GarethCooke/SiglentTower/ROADMAP.md

# Bench stack — build roadmap (v2.39, 2026-11-09)

Companion to `HANDOVER.md` (v19, the as-built record). Rule for the whole build: **nothing in HANDOVER §10 prints full-size until the coupon that gates it (§11, P1–P9) has passed.** Coupon numbers below are the handover's.

Stages run in order. Stage 2 (frame) overlaps Stage 1 (coupons) because the coupons only need rail offcuts.

v2: decisions D1–D6 answered (§0), cut plan redone for the 300 mm pack (§2), P7 redefined (§3), viewer v19 and `drawer-quarters-v1.pdf` issued. v2.1: D7 (mini slot 285 with vent channel), viewer v20. v2.2: Done columns and the progress checklist below; viewer versions collapsed into `bench-stack-3d.html`. v2.3: D5 confirmed, pack ordered, `fit.py` and the P7 coupon issued; sheet v1.1 (tabs start 25 from the wall, not 15 — 15 fouled the wall-crossing boss). v2.4: D4 confirmed — §0 closed. v2.5: AWG cradles printed, P1 ABS+ confirm coupon and the 210 foot exported. v2.6: P1 ☑ (ABS+), sled beams v1 modelled. v2.7: scope feet positioned by the P9 jigs, beams released. v2.8: sled slides proven in ABS+, tiles and hinge passed on the yellow run, strip bracket lower v2. v2.9: strip raised to z 75–425 round its mains cable; lower bracket v4 fits, upper stays v1. v2.10: P5 ☑, Stage 0 ☑, Stage 2 assembly viewer + connector plan, session handover. v2.11: bottom-drawer quarters production pass released (`parts/drawer/`), one quarter per plate; sled front bar + cross bars released after the scope leaned the bare beams inwards. v2.12: quarters Q1–Q4 printed; bottom-drawer runners v1 released (four M5, one part for both sides, one per plate). v2.13: sled front bar v2/v3 + beam front halves v2 (saddles, tongue), drawer facia v1 + pull insert. v2.14: P3 ☑ (drawer slides well), frame checks 2.1–2.6 ☑. v2.15: 2.7 ☑ → Stage 2 ☑; PSU/AWG seated — three cradle clashes confirmed, PSU right cradles v4 + AWG cradles v2 released; facia v1 printed (thin-part print rule). v2.16: the TPU plate (Stage 8 / P8) released — every TPU part on one plate with the two sweeps; sill panel printed. v2.17: top panel v1 released (D12) — four tiles standing on ONE plate with the four upright caps, glued half-laps, no spline; sill v3 printed. v2.18: the rails measured — side tiles v2 at the measured band heights with notches for the cradle saddle walls (ten tiles, five plates); top panel at the measured 362. v2.19: Progress block rewritten so every open stage lists what is outstanding (bench round-up 2026-10-16: Stage 3 ☑; P8 ☑ — the TPU plate printed, the 4.6 feet and 7.4 covers hold — so Stage 1 ☑; sled sag ☑; every drawer comes out cleanly ☑, so Stage 4's "lift-to-remove" is retired — it was HANDOVER's lift-off runners, and P3's rib-in-groove pair cannot lift). v2.20: D14 — the six drawer housing-top tiles are dropped from the build (Gareth, 2026-10-16: nearly every drawer in the world has no top; add later if use shows the need). v2.21: D15 — no drawer stops either; the bottom and column drawers pull clean off their ribs at full travel, which is also how they come out. v2.22: D10 rev 3 — the lighting wiring drawn (`parts/wiring/`), the controller is a Wemos D1 mini on a perfboard in a holder on the rear base rail's rear face, two WLED buses, cover run B moves to that rail's REAR slot. v2.23: print round-up 2026-10-18 — side tiles v2 (A2–E2), the top panel plate, box braces, mini-slot runner v3 + facia, pull-inserts plate v3 and sill blocks v4 all printed; the mini runner is v3 (countersink sunk 1.0 below the plate top), which the text called v2. v2.24: the door set released (`parts/door/`) — door, fixed rear tile with a bolted leg, two magnet holders; band 4 left gets the same leg. v2.25: band 4 left released (`tile-band4-LF/LR-v1`, legs on the uprights); the door set, holder and second hinge pair printed. v2.26: band 4 left printed; the sled cable channel released (`cable-channel-v1`) — every tile and every sled part now exists. v2.27: the door set's rear tile, front bracket and tab were exported from the mirrored check frame and printed as the wrong hand (Gareth, 2026-10-19) — v2 of the three re-issued from the real frame; door-v1 as printed is fine. v2.28: the door's edge comes down from 347 to 338 — door v3 + hinge leaves v2 (both), pins issued, the hinge explained on `hinge-how.png`. v2.29: sill left block v5 — the pixels push in from the REAR, pre-wired and removable; v6 the same day: bore 5.7, flange seat 4 deep (v5's 5.3 bore printed tight); v7: seat 6 deep, leg slots, and a dovetail wire groove along the block's bottom — wrong face (Gareth: the wires leave through the back, the top of the print); v8 put two clip rails on the back face instead; v9 misread that as the pixels; v10 (Gareth: it is the BUTTON's wires that will not go through the front hole) keeps v8 and adds a 3.2 wire slit from the button bore to the bottom face, front to back, with the same notch filed into the printed window (window-v4 STL kept for any reprint), so the pre-wired button goes in from the front with its wires hanging through the slit. v2.35 (2026-11-03): **construction complete** — Stage 8 ☑, the lighting wired and working; only Stage 9 (close-out) is left. v2.36 (2026-11-03): **HANDOVER v19 issued** — the as-built record (Stage 9 bullet 1 ☑); the 2026-10-23 ticks (Stages 4–7, D12, the D7 thermal check — commit a423915) that the 2026-10-27 sill edit overwrote are restored below. v2.37 (2026-11-05): **viewer and layout regenerated as built** (Stage 9 bullet 2 ☑) — `bench-stack-3d.html` to HANDOVER v19 §3 (sub-frame 253.7 flush, sill panel to 253.4, door v3 on the D11 axis, top panel D12 with the caps on it, lids and probe hanger gone, strip 75–425, board enclosure, splices, rests, travel 92; `viewer_boxes.json` was stale at v18 and is now the HTML's list), `bench-stack-layout-v16.pdf/.svg` the as-built sheet (v15 removed from the tree); **STL archive tidied** (Stage 9 bullet 3 ☑) — the 18 superseded STLs HANDOVER §10 marked † removed from `parts/` (git history keeps them), `rear-tile-v2.3mf` moved to `bambu/parts/door/`; **the complete .3mf generated** (Stage 9 bullet 4 ☑ pending a Bambu Studio check) — `src/publish_3mf.py` writes `publish/SiglentTower-complete.3mf` (36 plates in filament order, one material per plate, jigs last, each object named after its STL, per-object brims / ironing / supports, the `SiglentTower fit 0.20` profile lifted from a saved project), `publish/PLATES.md` and `publish/plates-sheet.png`; `sill-panel-window-v4.stl` restored to `parts/sill/` from git history (a complete build needs it). v2.38 (2026-11-08): **the build guide** and, later the same day, the MakerWorld listing published and the write-up drafted (`docs/WRITE-UP.md`). v2.39 (2026-11-09): **Stage 9 ☑ — the write-up is live at garethcooke.com/siglenttower/build; nothing is left open.** (Stage 9 bullet 6 ☑) — `docs/BUILD-GUIDE.md`, chapters 0–14 from HANDOVER v19, every build step a numbered action with its check, three new sheets under `docs/build-guide/` from `src/build_guide_sheets.py`; README map and MAKERWORLD.md links point at it. — tick ☐ → ☑ as things pass.

## Progress

Ticks follow the rule at the end of §2: a stage ticks only when its "Done when" line is met and every row in its table is ☑. Each open stage lists what is still outstanding, so this block is the to-do list, not just the record.

- [x] §0 decisions D1–D12 all ☑ (D12 top panel ☑ 2026-10-23: on the frame; D13 withdrawn; D14 ☑ 2026-10-16: no drawer lids; D15 ☑ 2026-10-16: no drawer stops)
- [x] Stage 0 — coupons modelled and sliced, spacer set printed (0.5 was already fixed in layout v15)
- [x] Stage 1 — extrusion cut ☑ (2026-09-19); P1–P9 all ☑ in §3, values in `fit.py`. **P8 ☑ 2026-10-16:** the TPU plate printed; the four feet (peg 4.6) push into the uprights' bores and hold — Gareth glued them in — and the 7.4 covers stay in the slots by thumb → `SPIGOT_D` 4.6, cover flare 7.4 stand; the sweeps were not needed.
- [x] Stage 2 — frame assembled, sled feet on the scope rails, instruments trial-fitted (2.1–2.6 ☑ 2026-10-01: diagonals, 321 front, 510, no wobble; 2.7 ☑ 2026-10-02: PSU and AWG seated with the jigs, no rock, fronts in line — the three cradle clashes are Stage 3's)
- [x] Stage 3 — cradles: PSU left v3 + right rear v4 + right front v5, AWG v2 fitted; **confirmed done 2026-10-16** (level, no rock, fronts in line; the slight PSU skew noted in `fit.py` accepted).
- [x] Stage 4 — drawers. **☑ 2026-10-23 (tower assembled):** runners, quarters, column drawer + strips, mini slot (runner v3 + facia), all three facias with the pull inserts v2 glued in, fronts flush with the uprights, logo reads; each drawer comes out cleanly (2026-10-16). **D7 thermal check ☑ 2026-10-23:** all three instruments on for over an hour in the assembled stack, slot in, tiles on — the AWG's fan no louder than usual, the mini slot's right-hand wall (in the fan's exhaust) slightly warm, not hot → the slot stays 285, the 85 fallback is not needed. Housing tops dropped — **D14 2026-10-16** (the constraints recorded for them stay in the status lines in case they are ever added: pull-insert ears frame x 120–240 and its pocket y ≤ 22 over x 130–230, z 63–86; mini insert notch x 242–268, y ≤ 22, z 313–336; the D7 vent-channel notch x 252–338 over y 81–171; the right sled rest's lip → top stops at x ≤ 337.5); stops dropped (D15).
- [x] Stage 5 — sled. **☑ 2026-10-23:** feet, beams, front bar v3, cross bars v2, front rests v2, splices v2, cable channel v1 on the left beam, TPU stop caps, bar pull liner; the scope pulls out to the stop caps and back, stays level, stops hold; sag ☑ 2026-10-16.
- [x] Stage 6 — box + channel. **☑ 2026-10-23:** box halves joined, corner braces in, cable channel on; the full access sequence works — sled out, door open, box lifted over the right splice, out to the right and back; the meters fit.
- [x] Stage 7 — skin. **☑ 2026-10-23:** side tiles v2 (band 2 right v1), band 4 left v1, the door set (door v3, hinge leaves v2, pins, rear tile / bracket / tab v2) — the door swings past 180 clear and catches; top panel on with the four caps → D12 ☑.
- [x] Stage 8 — trim. **☑ 2026-11-03 — the build is complete and the lighting works.** Done: the TPU session (feet glued in, AWG pads, stop caps, six 240 covers); strip brackets (upper v2 / lower v5 — every earlier export had no bolt hole; the printed pair drilled 5.5 + Ø10 × 2.5 counterbore) with the Addtam hung; sill panel v3 + window v4, left block v10, right block v4; upright caps on with the top panel; IEC leads routed, the scope loop takes the 100 travel; **lighting per D10 rev 5** — SiglentGlow firmware (`C:\Development\Projects\SiglentGlow`, built 2026-10-25) on a XIAO ESP32-S3 Plus, the 50 × 70 perfboard (74AHCT125, SR3200, 1000 µF, 2 × 330 Ω; plugs 5-pin sill, 3-pin L and R, 2-pin PWR, crimped 2.54 mm locking housings) in `board-enclosure-v1` + `board-lid-v1` on the rear base rail, two 15-LED strips on the rear uprights' inner faces, two WS2812D-F5 sill pixels + the button in the left block (the F5's legs run DOUT, VDD, GND, DIN — the reverse of the APA106), USB pigtail from the Addtam (red + braid). Sheets: `parts/wiring/wiring-4-connections.png`, `wiring-2-runs.png`, `perfboard-layout.png`, `board-enclosure-plan.png`. Not built, by choice: the probe hanger and the rear-right cable clips — add later only if use asks for them.
- [x] Stage 9 — close-out **☑ 2026-11-09 — the project is complete.** HANDOVER v19 ☑, viewer/layout regenerated ☑, STLs archived ☑, the complete .3mf ☑, the MakerWorld pack ☑ (published 2026-11-08), the build guide ☑ 2026-11-08, the write-up ☑ 2026-11-09 (garethcooke.com/siglenttower/build).

**Print job 2026-10-27 — sill left block v10: `parts/sill/sill-block-left-v10.stl`** (white or any PETG, front face down as exported, no brim, no support, 5.7 cm³, 47.7 × 12 × 22 on the bed; v4–v9 left blocks withdrawn). **The printed panel + v3 window are NOT reprinted** (Gareth, 17:13): the window gets its notch by hand — with the panel off the frame, file or cut a **3.2 wide × 1.8 tall notch** through the clear window from the bottom edge up into the Ø8.4 hole, centred under the hole (1.6 either side of its centre line), straight through the 3 mm; a flat needle file or a craft knife does it in clear PETG. `sill-panel-window-v4.stl` is that shape, kept only for the day the panel is ever reprinted. Right block v4 unchanged. **v10 (Gareth, 17:03: it is the BUTTON's wires — "I can't push them in from the front because they won't fit. There needs to be a small gap at the bottom as you look at it from the front when it is mounted"):** v9 was a misreading (it moved the pixels, which were never the problem) and is withdrawn; v10 is v8 — pixels pushed in from the rear, clip rails on the back face for their wires — plus a **wire slit 3.2 wide** (x 43.4–46.6) from the block's bottom face up to the button's axis, running from the front face right through to the back, and the **same 3.2 notch in the window's bottom edge** under its Ø8.4 hole (1.8 tall) — filed into the printed window, see above. Fitting the button: wires soldered to it first; offer it to the window from the front with the four wires hanging down through the notch; push it in — the wires trail rearward along the open-bottom slit — and when the thread meets the captive nut the tail is over the wire channel (y 13.5–19.5), where the wires drop out of the bottom; screw it home. Out is the reverse. The nut stays captive (the slit takes 3.2 of its pocket's 10.6 floor; a 10 AF nut pulled down 0.5 still collides). From the front the notch shows as a 3.2 × ~1 mm nick in the clear window below the bezel, 1 mm above the facia. **Proven:** a 2.4 × 2.4 bundle (four Ø1.2 wires) along the whole slit vs window, block and panel 0; where it passes the nut it dips under the nut's bottom flat (z 88) in the open below the block — vs nut, block and facia 0; v8's clip-rail proofs unchanged. Print: the slit is a channel along the print's z with vertical walls; the window's notch is a 3.2 mm bridge 1.8 above the bed — no support either way. **v9 (superseded the same day):** pixels fitted from underneath with a slide-forward seating — withdrawn, wrong problem. **v8 (superseded the same day):** two clip rails on the back face for rear-inserted pixels — right face for the wires as the block then was, wrong because the pixels could not be fitted from the back once wired. **v7 (superseded the same day; Gareth: push the LED further through, and clips on the left to tuck the wires under):** the flange seat goes to **6 deep** — the dome now stands 4.1 into the cavity, 1.9 short of the window; under each LED a **leg slot** (6.6 wide, y 14.5–19.5, open to the block's bottom up to z 93) opens the rear of its counterbore downward so the four legs bend straight down out of the flange; and a **wire groove along the block's bottom face**, x 27–61, 4.5 wide inside (y 14.5–19) × 3 deep with a 2.5 mm dovetail mouth between two 1 mm lips — the bundle (two pixels' legs, the button's wires out of its channel, which the groove crosses) pushes up through the mouth and the lips hold it; it leaves the groove at the left end and drops down the front-left upright's inner-face slot to the rail. That is the "clips" ask done as a groove, because a hook hanging off the bottom face is an overhang in the front-face-down print and a groove is a 2.2 mm bridge. Proven: a 3.9 × 1.8 bundle sits in the groove at 0 and collides with the lips when pulled 1 toward the mouth; the legs' path from the flange to the groove is clear; the groove clears the bolt pocket (y ≤ 13.6 at that height) and the key hole (y ≤ 11.8); the Ø5.3 body still passes the bore. **v6 (same day, bench): v5's LED would not push all the way in** — a Ø5.3 vertical bore prints ~0.3 under (`fit.HOLE_SHRINK`) against a Ø5.0 LED body, and its 2.5 flange seat left the dome only 0.6 into the cavity. v6: bore **Ø5.7**, flange seat **Ø6.6 × 4.0** → a Ø5.3 body passes even with the shrink, the dome stands 2.1 into the cavity. Stop-gap for the printed v5: a 5.5 mm drill through both bores from the back. **Status 2026-10-27 (Gareth): make the pixels insertable from the rear, otherwise they are soldered in place and can't come out.** Done: v5 replaces the bottom-opening slots with a **Ø5.3 bore along y from the light cavity (y 9) out of the block's back face (y 19.5)** at each pixel position (x 34.6 / 55.3, z 93), with a **Ø6.2 × 2.5 counterbore in the back face** for the LED's flange. The 5 mm WS2812, soldered to its wires first, pushes in from behind until the flange seats, its dome 0.6 into the cavity; the four legs bend down 90° right behind the block and the wires drop into the open space over the bottom drawer (z 63–87, no lid now) and across to the left PSU rail's inner slot. The 2026-10-12 note that forbade this ("the cradle arm sits at y 20, no room for legs") was a crude envelope: `psu_cradle.py`'s left front cradle is a 40 mm saddle at y 31–71 on the rail (x −3..23) with its 30-wide arm at y 36–66, and the PSU's front-left foot starts at y 40.5 — so there is **16.5 mm behind the block** at x 26–68, z 87–99. Proven against the real cradle model and the foot: the LED, its flange and a leg bend 3 behind the block, and the legs dropping down, all 0 cm³; a Ø5 body passes the bore from the back face into the cavity. Order of fitting: bolt the block (key in from its right end), panel on, THEN the pixels from behind (the key hole crosses the bores at y 10 — the key goes in first); to change a pixel, pull it out backwards. The bores are vertical in the front-face-down print, the counterbores open upward; nothing else in the block changes.

**Print job 2026-10-20 — door v3 + hinge leaves v2:** `parts/door/door-v3.stl` (black PETG, face down as exported, 230 × 161 × 6, 72 cm³, no brim, no support — its own plate), `parts/hinge-door-v2.stl` ×2 + `parts/hinge-frame-v2.stl` ×2 (black ABS, standing as exported, 6.3 / 3.8 cm³ each) and `parts/door/hinge-pins-v1.stl` (two Ø2.9 × 24 on snap-off discs, black PETG, standing). Withdrawn: door v1/v2, hinge-door-v1, hinge-frame-v1 (the yellow P5 pair and the black pair both superseded). **Status 2026-10-20 (Gareth: the 16 mm band under the door, between the hinges — does it have to be?): no — the door's edge comes down to z 338, 7 above the scope rail.** The handover's 347 was the box floor, kept so the door and hinge never stood in the box's path — but the box only moves with the door open, when the door and its leaves have swung clear, so the band was doing nothing. What sets the new minimum: the door leaf's 3 mm shelf under the edge must clear the frame leaf's plate top (333) AND the right sled front rest's plate on the rail top (z 331–334, x 341–359, y 21–61 — directly under the FRONT hinge); shelf at 335–338, edge at 338, 1 clear of both (Gareth's condition: the door must open without the bottom hitting the rail or the sled foot — the foot and its web run inside the rail / inboard of it, nothing of the door ever goes there). `door_hinge.py` v2: `TILE_Z0` 347 → 338 (door leaf: shelf 335–338, pad 338–371) and the frame leaf's riser moved out from x 363 to **364.3** — with the door 9 lower, its outer face (364) ran into the riser at z 338–341; at 364.3 it clears, and the door's swept bottom corner never passes x 364 below z 346 (r 5.8 from the axis: it moves inboard and up first). Proven (`door_set.py`): door, both leaf pairs, the rest and the foot envelope at zero against each other, the rails, the uprights, the band-3 tiles, the box home and in its exit lane; the swing 0–180° in 15° steps clears everything including the rest, the foot and the frame leaves; the door still hangs at x 365–384 at 180°; its edge 4 above the fixed tile's (334) and 3 above band 4 left's (335). **Pins (Gareth: what material?):** black PETG, standing on the disc, 0.4 chamfer on the tip; CA'd at both ends into the DOOR leaf's two segments only — the pin is 2.9 in a 3.2 bore by design (3.0 bound in P5) and v1's fitting line said "pins in" without the glue, which is why the printed pair fell apart in the hand. The ~3 mm V at each joint line is the 45° print cone on a segment end (2.4) + the 0.4 running clearance, not a gap in the bore. Sheet `parts/door/hinge-how.png` (`src/hinge_how.py`): one knuckle assembled at 0 / 90 / 180°, end-on and from outside.

**Print job 2026-10-19 — door set v2, three reprints in `parts/door/`:** `rear-tile-v2.stl` (black PETG, face down as exported, 169 × 80 × 22, 30 cm³), `magnet-bracket-front-v2.stl` (black ABS, plate face down, 6.5 cm³), `magnet-tab-rear-v2.stl` (black ABS, on its back, 3 cm³); the v1 files withdrawn (`door-v1` as printed stands; `door-v2.stl` is the same door the right way round for the record — only the hex grid's 4 / 10.5 end margins differ). **Correction 2026-10-19 (bench, Gareth): the printed rear tile's leg is at the wrong end.** Cause: `door_set.py` v1 modelled the set in `skin_check.py`'s right-side "rail frame", which is a MIRROR of the real frame (x = 361 − x), and exported straight from it; the side tiles are safe in that frame because they are placed by rotation, but a chiral part exported from a mirrored frame prints as the other hand. The rear tile (leg at the front end instead of the rear) and the front bracket (leg 10.5 from the door instead of 3.5) were wrong; the tab was 3 mm low; the door's bosses, pads and slot are symmetric end to end so its print works. Fix: every export now goes through `to_frame()` (the mirror back), the script prints the leg's and the bracket leg's real-frame positions as a hand check (leg x 342–361, y 327–330; bracket leg x 351.5–357.5 ✓). Rule added to PRINT-RULES (13).

**Print job 2026-10-19 — the scope's cable channel: `parts/cable-channel-v1.stl`** (black ABS, flat as exported — floor down — 133 × 26.5 × 20, 24 cm³, no brim, no support; no hardware: CA'd to the left beam's top with the beam's Ø4 peg at (33, 290) through the Ø4.3 hole in its floor, as the splice is held). **Status 2026-10-19: cable channel v1 released — the last sled part** (`src/parts/cable_channel.py`). A U-trough on the LEFT beam's top, x 20.5–47 (outer wall flush with the beam's outer face, inner wall 3 clear of the rear box's left end at x 50), y 201–334 (behind the splice, which ends at 188.5), floor 3 at z 346–349, walls 3 to z 366, inside 20.5 × 17 for the scope's mains, LAN and USB side by side; the front top corners of both walls chamfered 10 at 45° so the leads bend in over a slope; rear end open — the leads drop out behind the frame into the loop that takes the 100 travel. Two HANDOVER features dropped: the wedge tabs hooking down the beam's sides (drawn for an earlier beam; they would stand inside the scope rail) and the 45° ramp on the inner wall's rear end (nothing crosses that wall — the rear cross bar's lip is at x 60–301). Proven: 0 cm³ against both left beam halves, the splice, the front bar, both cross bars, the box at home, the scope body, the LED strip on the rear-left upright's inner face (1 mm behind the channel's rear end at home), the upright, the band-4 LR tile's leg and the scope rail; lowered 0.5 it is flat on the beam top, shifted 0.5 the peg locates it. Fit: lay the leads in from the scope's rear, then CA.

**Print jobs 2026-10-18 — band 4 LEFT: `parts/tiles/tile-band4-LF-v1.stl` and `tile-band4-LR-v1.stl`** (black PETG, face down as exported, 168 × 155 × 22 each — the leg stands 19 — 52 cm³, one per plate, no brim, no support, `SiglentTower fit 0.20`; hardware 2 × M5 × 10 + 2 drop-in T-nuts). **Status 2026-10-18: band 4 left v1 released — the last two side tiles** (`src/parts/band4_left.py`): y 20–175 and 175–330, z 335–500 (165 tall; 3 above the measured scope rail top of 331.7), three P4 fingers each up into the top rail's outer slot, the side-tile hex pattern, and the door set's leg at each tile's upright end — a 19 × 3 × 40 wall on the front-left upright's REAR face (y 20–23) and the rear-left upright's FRONT face (y 327–330), one M5 × 10 + T-nut into the face's slot at z 361, so the open sled band below needs no rail. The two meet at y 175 on a plain edge. Proven 0 cm³ against the scope and top rails as measured, both uprights, the band-3 tiles with their fingers, the left sled beam (x 20.5–46; the legs stop at 19), the planned cable channel, the cast brackets under the scope rail's ends, the LED strip on the rear-left upright's inner face and the box at home; fingers hold (lifted / pulled 0.5 collides), legs flat on their faces. **Door v2 note:** the door v1 (bottom edge at 347, the handover's) was printed before the gap question was settled; a v2 with the edge at 337 (6 above the rail, matching the 3–5 under the other band-4 tiles) needs a door-leaf v2 (shelf 334–337 clearing the frame plate's top at 333, a riser under the barrel) and a door reprint — issued only if asked.

**Print job 2026-10-18 — the door set, `parts/door/`:** `door-v1.stl` (black PETG, face down as exported, 230 × 152 × 6, 68 cm³) + `rear-tile-v1.stl` (black PETG, face down, 169 × 80 × 22 — the leg stands 19 — 30 cm³; turn it 90° on the bed, the two share one plate at 240 × 230), no brim, no support, `SiglentTower fit 0.20`; `magnet-bracket-front-v1.stl` (black ABS, plate face down as exported, 6.5 cm³) + `magnet-tab-rear-v1.stl` (black ABS, on its back as exported, 3 cm³) beside the second hinge pair. Hardware: 4 × Ø10 × 2 magnets, 2 × M5 × 10 + 2 drop-in T-nuts (bracket, leg), and for the hinges 2 × M5 × 12 + T-nuts and two 2.9 pins. **Status 2026-10-18: door set v1 released — Stage 7's band 4 right** (`src/parts/door_set.py`, sheet `parts/door/door-plan.png` via `src/door_plan.py`; `side_tile.tile()` gained a `keep=` list of solid windows). Band 4 right runs z 347–499 (door) / 334–500 (fixed tile), y 20–250 / 250–330, both tiles the side-tile hex pattern on the rails' outer face. **Door** 230 × 152 × 3, no clips: hung on the D11 hinge (frame leaves on the scope rail's outer face at y 23–47 / 223–247, door leaves CA'd to solid pads on the door's back, shelf under its bottom edge), held at the top by two Ø10 × 2 magnet pairs — the door's bosses are printed ON it (12 × 12 × 3, pockets Ø10.4 × 2.2) at (y 34, z 479) and (236, 479); a 45 × 12 finger slot at (135, 482) to hook it open (HANDOVER's notch in the top border would have opened onto the top rail's face). **Fixed rear tile** 80 × 166 × 3: two P4 fingers up into the top rail's outer slot, and — the answer to band 4's open bottom edge — a **leg**: a 19 × 3 × 40 wall rising from its back at the rear edge, flat on the rear-right upright's front face, one M5 × 10 + T-nut into that face's slot at z 361; adjustable in z, so the top rail's height reading (158 / 159) does not matter; a solid window where the tab glues. **Front magnet holder**: an L on the front-right upright's rear face (plate x 341–361, y 20–26, z 455–488, M5 × 10 counterbored at z 461, a 5.5 × 5 tongue up into the top rail's bottom slot against rotation) with a 6 mm leg reaching rearward behind the door's front boss, pocket facing it, faces 0.5 apart. **Rear magnet holder**: HANDOVER's tab grown from the fixed tile is a 22 mm floating plate in a face-down print, so it is a separate block (x 354.5–361, y 250–262, z 467–488) CA'd to the fixed tile's back with a 3 mm plate reaching forward behind the door's rear boss. Proven (`door_set.py` main, rail frame as `skin_check.py`): every part 0 cm³ against the scope and top rails (outer and bottom slots), the uprights, the band-3 tiles with their hinge windows, the box at home and in its exit lane (the open door and its leaves clear the lane at 180°); door vs its leaves 0 (0.15 glue gap) and lowered 0.5 sits on the shelves; 0.5 of air in front of each boss, 0.6 touches the holders; fixed tile's fingers hold (lifted / pulled 0.5 collides), its leg flat on the upright; the bracket flat on its upright, tongue located in the slot; the door swung 0–180° in 15° steps clears everything, hangs at frame x 365–384 at 180° (10 proud of the band-3 tile below, as D11 said), down to z 183. Fitting order and the magnet polarity trick are on the sheet. **Band 4 left** follows the same recipe when wanted: two 155 tiles z 334–500, top fingers, a leg each onto the front-left upright's rear face and the rear-left upright's front face.

**Print job 2026-10-16 — the lighting board holder: `parts/wiring/board-holder-v1.stl`** (any PETG, plate face down as exported, no brim, no support, 60 × 44 × 15, 19.7 cm³; hardware **1 × M5 × 10 + 1 drop-in T-nut**, into the rear base rail's REAR slot at x 120). **Status 2026-10-16: lighting wiring v1 — D10 rev 3** (`src/wiring_sheet.py` → `parts/wiring/wiring-1-schematic.png` what connects to what + the WLED settings, `wiring-2-runs.png` where every wire goes, `wiring-3-board.png` the perfboard and the holder section; `src/parts/board_holder.py`). Decisions, all Gareth's on the night: **the controller is a Wemos D1 mini** (ESP8266, WLED's usual board — the XIAO is not needed; the S3 only bought sound-reactive and BLE, unused); **it lives on the rear face of the rear base cross rail** (x 90–150, z 0–44), not beside the Addtam — the rear-left upright has no free face (strip inside, Addtam behind, tiles outside) and every run in the build already ends at that corner; the rail's rear slot is empty (its connectors are on the front face), so the wires run in it under TPU covers and come through two Ø6.5 holes in the holder's plate either side of the T-nut. **Two WLED buses:** bus 1 on RX (GPIO3, DMA) = the sill's two 5 mm pixels (LEDs 0–1, one in each slot of the block, chained) then the LEFT strip (2–29) — the second pixel's data OUT comes back down the left PSU rail's slot and becomes the strip's data IN; bus 2 on D4 (GPIO2) = the RIGHT strip (30–57). Both strips are fed at their BOTTOM ends (z 20) so both run upward — no top-rail run, no reverse. Button on D3 (GPIO0); **the button is an 8 mm momentary with a 3–6 V blue LED (4 pins, fits the v4 block as printed)** — LED straight across 5 V / GND inside the block as a locator glow; the pixels stay the WLED indicator (two, so both halves of the window light evenly past the button's nut). **Five 28 AWG wires in the PSU rail's slot** (5 V, GND, data to the pixel, data back, switch; the LED's − and the switch's other side go to GND in the block), 24 AWG for the strips' 5 V / GND, 330 Ω in each data line and ONE 1000 µF across 5 V / GND at the board's USB input (both feeds leave the same bus; 220–470 would do, Gareth is using a 1000), WLED current limit 1500 mA. The USB lead (Addtam's ports are at its TOP end) runs down the strip's right-hand edge to the holder — the only wire in the open, behind the frame. Under-rail passes at the two rear corners (6 mm on the TPU feet, beside the pads). Lengths: sill bundle ≈ 510 → cut 650; left strip feed → 200; right strip feed → 320; USB → 550. **Cover run B moves to the rear base rail's REAR slot** as B1 (x 25–90, 65) and B2 (x 150–336, 186); `tpu-where-3` re-issued; A stays 240 + 20. Covers used 511 of 1440. Holder proven: 0 cm³ against the rail, the Addtam, its bracket and shelf, its cable drop and the feet; the board (0.7 float a side) is held by the slot roofs when pulled off the plate, sits on the 3 mm ledge, slides out the top; the M5 head has 3.5 under the board. JST: the two 3-pin pairs are the only parts not in hand (ordered 2026-10-16); the sill uses an existing 4-pin + 2-pin.

**Print job 2026-10-15 — sled splice bars: `parts/sled-splice-v2.stl` ×2** (black ABS or PETG, flat as exported, **100** × 25.5 × 7.5, 19 cm³ each, no brim, no support — **v2 2026-10-16: 100 long, y 88.5–188.5. v1's 111.5 ran to y 200, under the rear box's floor (the box starts at y 195), and stopped the box sliding home — Gareth cut the printed pair to 100; v1 STL withdrawn** — beside any plate). **Status 2026-10-15 (bench, Gareth): the front rests v2 are fitted and the scope's front still sags, mainly with the sled pulled out — the give is at the P7 joint when it reaches the rest.** With the sled out 100 the rest's lip sits under beam y 121–161 and the joint (165) is right behind it: a tab joint is a hinge in bending, so the whole front half droops from there. **Splice (`src/parts/sled_splice.py`):** a 111.5 × 25.5 × 7.5 bar CA'd along the beam's OUTER strip (x 20.5–46, mirror on the right) from 0.5 behind the front-bar saddle (y 88.5) to y 188.5 (6.5 ahead of the box), over the joint and the bare span to the foot's front end; 7.5 tall because the scope body (x 27.7+) is at 355, the beam top 346. The left channel peg at (33, 150) passes through a Ø4.3 hole and locates it; one part serves both beams. Composite section ~5× the bare beam's stiffness over its length. Proven: 0 cm³ against both beam halves, the front bar + saddle, the front cross bar and the scope body; lowered 0.5 collides (flat on the beam); 0.6 forward butts the saddle. **Two costs, accepted:** (1) the right splice stands in the rear box's exit lane (sled out, box at y 95–230, floor 346) — **lift the box 7.5 mm as it crosses the right beam** (top to 464, door to 490); (2) the planned cable channel (x 20–46) **starts at y 201**, not 140 — unmodelled, nothing printed changes. **D13 (scope-back tray) withdrawn 2026-10-15:** the AWG's side vents sit under that gap; a tray there plus the scope would choke them. The corner braces stand.

**Print job 2026-10-14 — rear-box corner braces: `parts/box-brace-v1.stl` ×2** (grey PETG, as exported — lying on one leg, no brim, no support, 10 cm³ each; fits beside any plate). **Status 2026-10-14 (bench, Gareth): the printed rear box's right side wall cracked** — a horizontal crack (a layer line) starting where the side wall meets the 20 mm front lip. The box prints floor down, so its walls are layer stacks; the wall's front edge is free above the lip and the lip's top corner is a stress riser on a layer line. **Brace (`src/parts/box_brace.py`):** an equal-leg L-angle 15 × 15 × 4, 100 tall, CA'd INTO each front corner on the floor — one leg on the side wall's inner face, one on the lip's rear face and, above the lip, standing free as a flange along the wall's front edge, so the edge becomes a corner post and 100 mm of glued angle bridges the crack. One part for both corners. Printed lying on the wall leg so its layer lines run UP the wall in use (the direction the crack opens). Proven: in the corner 0 cm³ against the box half, 0.5 into the wall / lip / floor collides (flat on all three). **Fit:** CA into the crack and hold it closed, then CA the brace's two legs and bottom edge and press it into the corner; both corners. **Proposal D13 (sheet `parts/scope-tray-plan.png`, `src/tray_plan.py`) — a second, enclosed box behind the scope:** Gareth measured 62.5 between the cup bosses' rear faces (y 126) and the cross bar's lip (y 189), 230 clear from the right beam to where the scope's leads need to drop (x 111–341), 140 under the top rail. Proposed: **tray 230 × 56 × 130 + 3 lid** (x 111–341, y 129.5–185.5, z 349–482, one piece on the diagonal, ~215 cm³ — an overnight plate), riding on two glued rails: **A, tray bar** — a 321 × 12 × 3 shelf on both beams' tops at y 126–138 with a 7 mm upstand along its front edge against the cup bosses' rear faces (the roadmap's 'third bar' tying the beams behind the scope); **B, ledge** — a 321 × 6 × 3 shelf on the beams at y 183–189 with a 7 mm leg CA'd to the front face of the cross bar's lip. The tray slides out to the RIGHT over the beam through the door (y 20–250) with the sled HOME — no need to pull the scope. Checks before modelling: the scope's rear vents / rear connectors over x 111–341 (the tray's front wall is 18 behind the scope body); the cable channel (planned x 20–46 from y 140) stays left of bar A's left lap. Not modelled yet — Gareth to confirm.

**Print job 2026-10-16 — sill right block v4: `parts/sill/sill-block-right-v4.stl`** (white or any PETG, front face down as exported, no brim, 3 cm³; v3 right block withdrawn). **Status 2026-10-16 (bench, Gareth, v3 right block):** no way to get a key to the bolt, and the 7.7 right wall left an M5 × 10 only 2.3 mm into its T-nut. v4: **wall 2.5** (7.5 mm of thread in the nut), head pocket x 236.9–250.9 × y 3–17.5 × z 88–98 open to the front (clears a Ø7.5 head at either slot position, y 10 or 13), a **Ø3.8 key slot along the bolt axis from the block's LEFT end into the pocket** (same y 8.5–14.5 range as the bolt slot; it crosses the peg hole, which is fine — the key goes in before the panel), and the **peg hole 3.4** (was 3.3 — tight). Proven: head seated 0 at y 10 and 13, key through to the head 0, head + key clear of the frame. Fitting: key in from the left end of the block, under the PSU, before the panel goes on. **Print job 2026-10-14 — sill left block v4: `parts/sill/sill-block-left-v4.stl`** (white or any PETG, front face down as exported, no brim, 5 cm³; v3 left block withdrawn, panel / window / right block stay v3). **Status 2026-10-14 (bench, Gareth, v3 left block):** (1) the head pocket was a 9.5 × 10 box with the bolt line at y 10 in a y 3–13 pocket, so the head could not sit flat on the wall and the bolt went in at an angle — v4 seats the head in a **Ø10 round counterbore on the bolt axis** (ISO 7380 M5 head 9.5), x 22.5–31, open to the front so the bolt drops in; the head bears square on the 2.2 wall. (2) No room for a key in front of the head — v4 runs a **Ø3.6 key hole along the bolt axis out of the block's right end** (x 31–68), so a 3 mm key goes in from the right, under the PSU, before the button and panel go on (a 2.5 key passes too). Both are teardrops, apex up in the print. Proven: an M5 button head seated 0 mm³, shifted 0.5 in y or z collides (located), a 3.46 key from x 78 to the head 0 mm³, head + key clear of the frame. If the screw is not an M5 (a Ø5.5 head is an M3 cap head), say so and the wall hole drops to Ø3.4.

**Print jobs from 2026-10-14 — side tiles v2, black PETG, five plates in `parts/tiles/`, one a night, face down as exported, no brim, no support, `SiglentTower fit 0.20`:** `tiles-plate-A2.stl` (band2-LF + band1-LF, 246 × 155, 68 cm³), **B2** (band2-LR + band1-LR, 68), **C2** (band3-LF + band3-LR, 51), **D2** (band3-RF + band1-R, 49), **E2** (band3-RR + band1-R, 49). Band 2 RIGHT keeps its printed v1 tiles (gap unchanged at 139.5); every other printed tile is withdrawn (v1 STLs and plates A/B/C/F removed; D/E stay for their band-2 tiles). **Status 2026-10-14 (bench, Gareth): the rails are not at the spacer heights.** Calipers, rail face to rail face — right: base→PSU 45.4, PSU→AWG 139.5, AWG→scope 65.8, scope→top 158; left: 51.2, 135, 65.5, 157 (model 48 / 139.5 / 63.5 / 159). A band is gap + 20 and a tile must match it to ~0.2 (the finger's root stub fills the slot mouth), so bands now have a height per side: left 71.2 / 155 / 85.5, right 65.4 / 159.5 / 85.8 (`side_tile.GAPS`); the left tiles are front/rear parts. **And the cradle saddles stand 10 above the rail top:** they are U-channels round the rail — 3 mm walls 6 below the rail top and 8 above it — and v1's windows were cut for the 6 mm lips only, so the printed band-2 and band-3 left tiles hit the walls. v2 cuts **notches open to the tile's bottom edge up to 11 above the rail top** (PSU saddles frame y 31–71 / 233.5–273.5, AWG left 20–60 / 223–263, 4 mm of air each end — the positions the seating jigs set), the hex grid keeps a 1.5 web round each notch, and the left fingers are re-scheduled so none is rooted inside a notch (`side_tile.L_PSU`, `L_AWG`): front PSU slot band-2 56 / 121 under band-1 6 / 88, rear 6 / 104 under 38 / 70; front AWG slot band-3 46 / 121 under band-2 6 / 78, rear 6 / 121 under 38 / 70. Right tiles have no windows (the right cradles are on the inner rail) and keep v1's schedule; the hinge windows stay. Proven in **`src/skin_check.py`** against the frame at the measured heights with the saddle walls in: every tile 0 cm³ against its rails and the saddles, no two tiles touch, every tile pulled 0.5 off the rail face is held by its barbs; sheet `parts/tiles/skin-sheet.png`. **Before slicing A2/B2:** the left PSU→AWG reading was given as 135 — if that was rounded, re-read it to 0.1 (155.0 vs 155.3 is the difference between snapping in and not); 139.5 / 157 / 158 likewise. Band 4 (scope→top 157 / 158) is still unmodelled and will take these readings. **Top panel: the frame is 362 × 350 by tape (model 361)** — the panel is now 362 wide, seam at x 181, and its corner holes are 1.5 mm slots along x so 361–363 all fit; re-exported, proofs unchanged.

**Print job 2026-10-14 (night) — the top panel, ONE plate: `parts/top/top-plate-v1.stl`** — 246 × 123 × 180, 386 cm³, eight parts as exported: the four top tiles `top-tile-{FL,FR,RL,RR}-v1.stl` STANDING on their front / rear edges (black PETG, 94 cm³ each, 185.5 × 3 × 180) and `upright-cap-v1.stl` ×4 (dark blue PETG, closed face down, counterbore up, 2 cm³ each). Thin-part settings as the column facia (brim outer 15 gap 0, skirt off, door closed, bed 80, fan 30 % max, outer wall 60), `SiglentTower fit 0.20`, no support. Hardware: **4 × M5 × 10 button head** into the uprights' top centre bores — an M5 self-taps a 2020 bore (check stock). Trim the brim off the tiles' bed edges (the front tiles stand on the panel's visible front edge). The plate works with any subset: if four 180-tall sheets look wrong in the preview, FL + FR tonight, RL + RR tomorrow. **Status 2026-10-14: top panel v1 released — D12** (`src/parts/top_panel.py`, sheet `parts/top/top-panel-plan.png`, `src/top_plan.py`): the panel is **362 × 350 × 3 at z 510–513 covering the whole frame top** (362 by tape, 2026-10-14) — it lies on the four uprights' tops and the three top rails (HANDOVER §5's 321 × 310 "between the caps" rested on nothing: the rails are at x 0–20 / 341–361). Split at x 180.5 and y 175 into four 185.5 × 180 tiles that meet on **10 mm half-laps** — left / front tongue 1.5 UNDER, right / rear tongue over it with a 0.1 glue line, 0.1 at the tongue ends so the top-face seam is a hairline at x 175.5 and y 170 — and are **CA'd on the frame into one sheet** (a one-sided lap only stops one tile dropping below the other; glued, the seam is as stiff as the sheet). **D4's H-spline under the seams is dropped:** the scope top is at 507, 3 mm under the panel, nothing can go under it. **The caps sit ON the panel's corners:** 20 × 20 × 6, Ø9.5 × 4 counterbore, M5 × 10 through a Ø5.5 hole (a teardrop in the standing print) into the upright's centre bore, 5 mm of thread — four screws hold the panel down, the laps hold it flat; the caps stand 6 proud as HANDOVER had them. Standing print (D3, as the facias): both faces are wall finish, the laps are 1.5 / 1.4 fins at the top of the print or at a vertical end, nothing hangs below the bed face, and all four tiles stand side by side flat on the bed — hence one plate, the biggest in the build. Proven: four tiles assembled 0 cm³ with every lap engaged (any tile lifted or lowered 0.5 hits a neighbour, 0.3 along either seam hits); panel on the frame 0 cm³, lowered 0.5 collides (sits on the uprights and rails); 3.0 to the scope at home and pulled out 100; corner holes on the bores; caps 0 against the frame and the side tiles. Front-edge sag under self-weight (321 free between the front uprights, no top rail there): 0.2 mm with the corners screwed, 1.2 worst case — inside the 3 mm reveal. **Fitting:** FL on, cap screwed; CA on FL's two lower tongues; FR on (its tongue over FL's), cap screwed; CA on FR's rear tongue; RL on, screwed; CA on RL's right tongue; RR on, screwed. Lifts off as one panel with the four screws out.

**Print jobs from 2026-09-26 — the side skin, black PETG, one plate a night (all six printed by 2026-09-28):** `parts/tiles/tiles-plate-A.stl` (band 2 left-front + a band-1 tile, 247 × 155, 69 cm³), then **B** (band 2 left-rear + band 1), **C** (band 3 left front + rear), **D**, **E**, **F** (the right side, same pattern). Face down as exported, no brim, no support, `SiglentTower fit 0.20`. Twelve tiles in all (`src/parts/side_tile.py production()`, `src/tiles_plates.py`). **Finding while assembling the skin in CadQuery:** the PSU and left-AWG cradle saddles' outer lips hang 6 mm down the rails' outer faces, and the door hinge's frame plates sit on the right scope rail's outer face — all inside the tile plane. Bands 2 and 3 therefore carry through-windows for them and are now four/two distinct left/right tiles; the whole skin (12 tiles, 8 rails, 6 lips, 2 hinge plates) checks at zero intersection. Right-side tiles are the left ones turned 180° about z — mount them with their local y running rearward; band 1 is the same tile everywhere. Band 4 left is still open (no rail under it).

**Status 2026-10-01 (midday): front bar v3 + beam front halves v2 — the stand pad is held by the bar.** Gareth's point, accepted: the pad should insert into the bar, not be glued to it — and the hold-down belongs right at the pad's inboard edge. Each front half's front edge now carries **one plain tongue, x 28–96** (beam body through to the pad's inboard edge, 68 × 8 × 4, z 341.5–345.5, a 45° wedge under its root); the bar has one **closed pocket** per beam (0.15 clearance, 4.35 of floor under it, 9.35 above, 4.85 of wall outside it) and **slides on from the front** — so the tongue is captured above and below along its whole 68 mm and the pad's edge cannot drop. The v1 dovetail tab is gone (an open-bottom socket is a hinge in roll). Saddles stay but are **glued only** (2026-10-02: the tongue in its closed pocket is the hold-down; the screws only stopped the bar sliding forward, and a 25 × 76 CA lap per side plus the beam front faces does that — no self-tappers to buy; the saddle holes are unused). M3 to buy: **4 × M3 × 10** (drawer facia only — see status 2026-10-02). **Reprint: `parts/sled-beam-left-front-v2.stl` + `parts/sled-beam-right-front-v2.stl`** (black ABS+, dried, flat as exported, both on one plate, 5 mm outer brim — trim it off the tongue and tabs — supports on build plate only: the tongue's last 3.5 mm is a short cantilever, 70 cm³ each) **and `parts/sled-front-bar-v3.stl`** (grey PETG, front face down on the diagonal, brim on, 80 cm³). v2 bar and v1 front halves withdrawn (rear halves, feet, cross bars unchanged). `src/sled_check.py`: assembled 0 cm³, tongue engaged at 0.5 in x and rearward, bar lifted 1 / lowered 1 collides (pocket closed both ways), slid 10 forward clear (its assembly path), scope / box / stand-leg / channel envelopes clear. Assembly: the beams' halves CA'd at the P7 tab, rib threaded onto the feet, then the bar pushed on from the front over both tongues, saddles screwed and glued, then the cross bars dropped in and glued.

**Status 2026-10-01 (morning): sled front bar v2 — saddles** *(superseded by v3 the same day)*. Gareth's second look (photo, 2026-09-28 16:00): what drops is the stand arm's inboard edge, and he wants it supported by design, not glued better. There is nothing to put under the arm (AWG 1 mm below), so the support has to stop the beam ROLLING about its foot, and a 9 mm tab in a socket is a hinge in roll however well it is glued. **v2 `parts/sled-front-bar-v2.stl`** (replaces v1, which is withdrawn — `bambu/parts/sled-front-bar-v1.3mf` is stale) adds a **saddle** on each end of the bar's rear face, x 20.5–46 / 315–340.5, y 12–88, z 346–353, lying on the beam body behind the bar: a 25.5 × 76 lap, CA'd and **screwed with two M3 × 14 self-tappers per side** (Ø3.4 teardrop holes at x 33 / 328, y 30 / 70; drill Ø2.5 pilots into the beam through them; 7 mm into the 9 mm beam, 2 short of its underside). The beam can no longer roll without shearing the lap, which is what holds the arm's edge up — the arm itself bends 0.01 mm. Clearances: 1.1 to the stand leg at its loosest (x 47.1), 2 under the chassis (355), 0.5 / 3 to the cup boss, clear of the cable channel; `src/sled_check.py` extended with the stand-leg and channel envelopes, all 0.000 cm³. Prints **front face down** as exported (315 × 18 footprint, saddles rising 76; every socket flank still a vertical wall; 86 % resting face, nothing to support), dark grey PETG, 84 cm³, on the diagonal. **Buy: M3 × 14 self-tapping / button-head ×4 more** (8 in all with the facia's).

**Status 2026-09-28 (bench, midday): the scope on the bare beams leans them inwards** — photo: the stands would not seat in the pockets. Cause, not a beam fault: the scope's weight sits 45 mm inboard of each foot, and with nothing tying the beams each one rolls on the foot's slot play (0.3), the unglued rib (0.2) and the 2.5 web — 3–4 mm at the stands. The fix is the designed ladder, now released: **`parts/sled-front-bar-v1.stl`** (dark grey PETG, 315 × 12 × 18, standing on its bottom edge on the diagonal as exported, sockets open to the bed; 120 × 6 pull notch in the top edge, insert decided later) and **`parts/sled-cross-bar-{front,rear}-v1.stl`** (black ABS, flat as exported, 257 × 20/27 × 19 with the guide lips; front lip chamfered at the exit end, rear bar runs to y 335 to carry its lip) — *v2 2026-10-04: lips 1 mm further apart each, see the correction*. `src/parts/sled_bars.py`; proven in `src/sled_check.py` against the printed beams (0 cm³ assembled, every tab engaged at 0.5, all three lift clear, scope and box envelopes clear); sheet `parts/sled-ladder-plan.png`. **Every tab CA'd** — a dry tab's 0.15 play is 0.8 mm at the stands. Assembly order: bars onto the beams (sets the 241), then the beams bonded to the feet. Modelling queue items (1) and (2) done; fallback if lean remains after glue-up: a third bar lap-glued on top of the beams behind the stand arms, no beam reprint.

**Print jobs 2026-09-30 and 2026-10-01 (nights) — the bottom-drawer runners, black ABS+ (dried):** `parts/drawer/drawer-runner-300-v1.stl`, one a night, the same file both nights (left and right are one part: the right is this one turned end for end). 300 × 27 × 24, 91 cm³, leg-top down on the diagonal as exported (230.5 square, ~245 with the brim — two with brims don't fit one plate). `SiglentTower fit 0.20`, brim outer only 5 mm, Bridge counterbore holes → Sacrificial layer, **ironing ON, top surfaces** (the rib's bearing face is the part's top surface in the print), supports on build plate only, door closed. **Drawer quarters Q1–Q4 all printed by 2026-09-30.** **Status 2026-09-30: runners v1 released** (`src/parts/drawer_runner.py production()`; export with `python src/parts/drawer_runner.py --export`): the P3 section, 300 long, **four** M5 × 10 counterbored at y 20 / 107 / 193 / 280 (frame y 43 / 130 / 216 / 303 with the runner at y 23–323 on the base side rail), symmetric so one STL serves both sides. `src/drawer_check.py` now uses them: 0.000 cm³ in place, drawer up 0.2 / sideways 0.5 collides, sideways 0.2 / down 0.5 free; quarters still 0.000 and every joint engaged. `printcheck`: resting face 66 %, the only down-facing area is the four counterbore ceilings (sacrificial layer). Next on the bench (Stage 4): both runners bolted into the base rails' top slots (four drop-in T-nuts each), the P3 stub run along them, then the assembled drawer — **this is P3's friction verdict**. Still to model after it: the home stop behind the drawer (small separate part), then the column guide strips ×4 and the mini-slot runner (ABS+), which wait for the verdict.

**Status 2026-10-12 (evening) — the real cause of the right-side tile mismatch is the sled front bending: sled front rests v2.** Gareth: the beam bends from the point it leaves the foot (y 119.5) forward, and he has had to lower rails to live with it — that is why band 3 right no longer reaches the scope rail's slot. The rear never bends because it lies on the 210 foot; the front 108 mm hangs past the foot and the foot cannot be longer without losing the 100 travel (a longer foot could not pass the front upright). **Withdrawn the same evening: `sled-skid-v1`** (a block outboard of the beam riding the rail top — it would hit the front upright after 2 mm of travel; checked at home only, not along the travel) **and rest v1** (a fin CA'd to the upright's inner face — Gareth: bolt it, don't glue it). Diagonal braces in the plan (Gareth's suggestion: FL↔RR, BL↔FR) resist racking, not a vertical droop: a 400 mm plastic bar bending edge-on adds ~1 % to the beam's stiffness; what resists a droop is depth or a support, and there is no depth to add (1 mm to the AWG below, the stands and the cup boss above). What IS free is the scope rail's own top face, 6.0 under the beam, and the 2.2 mm between the rail's inner edge and the foot's web, which the beam's solid outer wall passes straight over: **`parts/sled-front-rest-v2-gap<g>.stl` ×2** (`src/parts/sled_front_rest.py`, sheet `parts/sled-front-rest-plan.png`; black PETG, ~22 × 40 × 6, 3 cm³, bottom face down as exported, no brim) — a 3 mm plate on the rail top at x 2–20, y 21–61, **one M5 × 10 countersunk into a drop-in T-nut in the rail's TOP slot**, with a lip standing up beside the rail's inner edge to z 337, the beam's underside. **2026-10-13, Gareth: the rail-to-beam gap on the frame is larger than the designed 0.5, so the lip is sized to the measured gap** — six STLs, gap 0.5 / 1.0 / 1.5 / 2.0 / 2.5 / 3.0 stamped on the plate, lip outer edge = 20 + gap + 1.3 (bears on 1.3 of the beam's 1.5 outer wall, 0.4 short of the foot's web, which moves with the beam); measure the gap at the front, print that one. Constraint recorded for the column housing top (unmodelled): on the right the lip reaches x 341 − gap − 1.3, so the housing top stops 0.5 short of that (x ≤ 337.5 at gap 2.0). The beam's outer wall (x 20.5–22, solid along the whole beam) rides on the lip through the entire travel, so the front is carried at y 21–61 — under the front stand — exactly as the rear is carried on the foot; the foot's web (x 22.2+) passes 0.4 beside it, the beam's groove (x 22.0+) 0.2 above it. Lip height 6.0 = the P1 beam line; tape under the plate raises it if the beam sits proud. Symmetric: the same part turned 180° goes on the right rail. **Hardware: 2 × M5 × 10 countersunk + 2 drop-in T-nuts.** Proven with the real beam (both halves) and foot slid 0–100 in 10 mm steps: 0 mm³; beam lowered 0.5 bears on it; 0 against the rail (sits on it), the front upright, front bar, AWG frame and body, left AWG cradle, band-3 fingers; mirrored right, 0 against the column facia, drawer, housing-top envelope, the hinge frame leaf and the right rail. **Fitting:** drop a T-nut into each scope rail's top slot near the front, plate on, lip against the beam's outer wall, M5 just nipped; push the sled home, pull it out, home again; tighten. **Then the rails go back to the spacer heights (48 / 139.5 / 63.5) and the printed band-3 tiles should fit without the strip sweep;** the sweep stays as the fallback. If the front still needs more, the next step is a glue-on rib on the beam front halves (depth above the beam body behind the saddle, y 88–135, 8 tall) — not modelled. **Sled stops (modelling queue) are closed by the TPU stop caps. TPU placement sheet: `parts/tpu/tpu-where.png`.**

**Finding 2026-10-12 (bench, right side): band-3 right tiles are short at the top.** Photo: the band-3 right-front tile's top tabs sit with their tops level with the BOTTOM of the scope rail's outer slot, not inside it (the left side fits) — the right scope rail sits several mm higher above the right AWG rail than the 83.5 the tiles were built to. Before any tile reprints, **`coupons/p4/band3-right-sweep.stl`** (black PETG, 95 × 142, 36 cm³, face down as exported, no brim, no support): three 42-wide test strips at band 3 **+4 / +5 / +6**, stamped on the back, one clip finger on each edge, no hexes (`side_tile.py --band3-sweep`). Clip the bottom finger into the AWG rail's slot between the band-2 tile's top tabs, push the top finger into the scope rail's slot; the one that snaps in at both edges and lies flat sets the right side's band-3 height; try it at the front and the rear of the band (different winners = the rail is tilted). A caliper reading replaces the sweep: right side, AWG rail top face to scope rail underside, front and rear (left reads 63.5). Then `tile-band3-RF/RR` reprint at the new height; band 4 right (door + fixed rear tile) is not modelled yet and takes the new height when it is.

**Print job 2026-10-12 → — the TPU plate (Stage 8, P8), blue TPU 95A, ONE plate:** `parts/tpu/tpu-plate-v1.stl` — 240 × 136, 55 cm³, 20 parts, everything flat as exported, **no brim, no support**, Generic TPU filament preset, spool dried and fed from the external spool holder (not the AMS), `SiglentTower fit 0.20` otherwise. On it: **frame feet ×4** (24 × 24 × 6, spigot Ø4.6 × 8, pad down), **AWG pads left ×2** (plain 20 × 20 × 5.5, pad down) and **right ×2** (with a tail and lip, standing on their front face), **slot covers ×6** (240 long, flare 7.4 — 1.44 m, cut to length with scissors), **sled stop caps ×2** (8 mm of cover profile), the **spigot sweep** (4.2 / 4.6 / 5.0 / 5.4 stamped) and a **cover-flare sweep** (7.0 / 7.4 / 8.0 stamped, 40 mm each). **After the print:** push the spigot sweep into an upright's bottom bore (winner: in by thumb, holds the frame's weight, out with a twist) and the three cover pieces into an offcut's slot (winner: goes in along its length by thumb, a fingernail will not lift it) — if 4.6 / 7.4 are not the winners, the four feet (14 cm³) or the six strips (22 cm³) reprint alone **before the TPU is unloaded**; `SPIGOT_D` in `fit.py` is set then (P8 ☑). **Status 2026-10-12: TPU parts v1 released** (`src/parts/tpu_parts.py`, sheet `parts/tpu/tpu-plate-plan.png`). Three things changed from the P8 coupon while modelling against the printed cradles: (1) **the lipped AWG pad was wrong** — the cradle pockets put the whole pad UNDER the body (left pad x 27.2–47.2, body edge 26.5; right pad 213.3–233.3, body edge 233.5), so a lip on the pad's edge would sit under the body and lift it 2 mm. Left pads are plain: the left cradle's own saddle lip at x 26 (0.5 off the body) is the left lateral stop. Right pads carry a tail (0.3 above the arm top, so it never bottoms before the pad does) with a 4 × 2 lip beside the body's right edge, 0.5 off it — the right side had no lateral stop at all (bracket plate 13.5 away). The rear "rear lip" is dropped: the body overhangs the rear pads by 10 mm, and the bezel against the front arms already stops rearward motion; nothing pulls the AWG forward. (2) **Cover flare 8.4 → 7.4** (0.75 step under each lip): a solid 1.25 wedge will not squash through a 5.9 mouth in 95A, 0.75 of 45° ridge folds under a thumb and 240 mm of it holds; head 6.0 × 1.75 flush; 3.65 under the cover for cable (the USB pigtail must be ≤ 3.5 OD). (3) **Stop cap = 8 mm of the cover profile** pressed into the FRONT end of each scope rail's inner slot against the front upright — self-retaining under the lips, trapped between upright and foot, no T-nut, no glue; the T-foot's front end lands on it at full pull (travel 100 → 92). No cap at the rear: home is the foot against the rear upright and a cap there would stand the scope 8 mm proud. Proven (`tpu_parts.py` main): each pad in its pocket 0 mm³ and against the AWG body 0; pad shifted 0.5 collides (located); body shifted 1.0 right hits the right lips, 0.3 clear; right pad vs the mini-slot envelope 0; cover in the slot = the head's 0.05-per-side interference only, lifted 0.5 the step hits the lips (held); every part passes `printcheck` with no down-facing area. Covers: stop short of the hidden L-connectors at the rail ends (the lead hops them on the face); the left PSU rail's inner slot and the rear base rail's slot are the planned runs (~600 mm), the rest is spare. **Sill panel, window and both blocks printed 2026-10-12.**

**Print job 2026-10-12 — mini-slot runner v2 → v3:** `parts/mini/mini-slot-runner-v3.stl` (v3: the countersink's rim sits 1.0 BELOW the plate top with a Ø10.8 relief above it, so the head is under the drawer's path — `CSK_SINK` in `mini_slot.py`; v2's file is withdrawn; **printed 2026-10-18**), black ABS+ (dried), 28 cm³, rotate 45°, plate down as exported, 5 mm outer brim, ironing on top surfaces — **replaces v1 (withdrawn).** Hardware: **3 × M5 × 10 COUNTERSUNK** (the AWG right brackets' kind) + 3 drop-in T-nuts. **Correction 2026-10-12 (bench, Gareth): v1's bolt heads fouled the drawer.** v1's Ø9 × 3 counterbores only suited a button head; an M5 cap head (Ø8.5, 5 tall) stood 2 proud of the 5 mm plate and the drawer's bottom hit it. v2 has a 90° countersink (Ø10.6, 2.55 deep) at each hole so a countersunk head sits flush with the plate top, and the rib is cut away Ø10.6 over each head for the driver. Proven: a countersunk head seated in v2 is 0 mm³ into the runner, its top at the plate top, 0 mm³ into the body; all the v1 proofs still hold (body held on 0.5 shifts, 249.5 free / 250.5 stopped). The drawer body and facia are unchanged.

**Print job 2026-10-13 — sill panel v3, four parts in `parts/sill/` (v2 withdrawn):** `sill-panel-v3.stl` + `sill-panel-window-v3.stl` as ONE multi-part object (grey + clear/natural PETG, standing as exported, 5 mm brim, skirt off, 8 cm³); `sill-block-left-v3.stl` (5 cm³) and `sill-block-right-v3.stl` (3 cm³) front face down, white if possible. Hardware: **2 × M5 × 10 + 2 drop-in T-nuts** (one per block), the 8 mm button + its 10 AF nut, one or two 5 mm WS2812. **Status 2026-10-13 (bench, Gareth):** (1) **the sub-frame sits 2.7 mm right of the model** — measured 233.7 from the left upright's inner face to the sub-frame upright's left face, so that face is at x 253.7, not 251. The panel is 233.4 (x 20–253.4). The mini slot and column are modelled relative to the sub-frame's own rails, so nothing there changes; only this panel bridges from the main frame. `viewer_boxes.json` still shows the sub-frame at x 251 and y 3–23 (it is flush) — correct both when the viewer is next touched. (2) v2's left block had nothing stopping it sliding up and down in the upright's slot; v3 bolts it: **M5 along x at (y 10, z 93) through a 2.2 wall into the left upright's inner-face slot, head in a pocket x 22.5–32 open to the front** — drive it with a ball-end 4 mm key from the front, then press the panel on. Button at x 45 (bezel 20 from the upright). (3) v2's pixel bores exited the block's back face, 0.5 in front of the PSU cradle — no room for legs; v3's pixels sit in 5.3-wide slots open to the block's bottom (x 34.6 / 55.3, y 9–19.5), pointing forward into the cavity, legs hanging down, and the button's wires leave through a 6 × 5 channel under its bore, also open to the bottom. The space under the block (z 67–87 at y 3–20) is free — the housing top is at z 64–67 — so the wires drop straight to the left PSU rail's inner-face slot (z 78), under the cradle's lip. Pegs at x 64 and 227.5 (press fit); right block x 223.4–253.4 with its pocket x 231.7–245.7. Condition unchanged: everything behind the button's bezel must fit in 16.5 mm. Proven: all four parts 0 mm³ against the frame as measured, cradles, PSU, facias; pegs locate; window seated.

**Print job 2026-10-12 — sill panel v2, four parts in `parts/sill/` (v1 STLs withdrawn):** `sill-panel-v2.stl` + `sill-panel-window-v2.stl` loaded as ONE multi-part object (they now share an origin — the window drops into its cut-out), panel dark grey, window clear/natural PETG, standing as exported, 5 mm outer brim, skirt off, 8 cm³; `sill-block-left-v2.stl` (6 cm³) and `sill-block-right-v2.stl` (2 cm³) front face down as exported, **white** if you have it (they bounce the pixel's light). Hardware: 1 × M5 × 10 + T-nut (right block only), the 8 mm button with its 10 AF nut, one or two 5 mm WS2812. **Status 2026-10-12: v2 from the v1 print on the bench (Gareth):** (1) v1 was ~16–20 too long — the sub-frame's front upright (x 251–271) is flush with the front plane, not 3 back as the viewer had it; the panel now ends at x 250.7 and that upright's face shows for 20 mm (`viewer_boxes.json` still shows it at y 3–23 — correct it when the viewer is next touched). The right block's M5 hole is slotted y 8.5–14.5 so it reaches the upright's left-face slot at y 10 or 13. (2) Pegs are now a press fit (Ø3.2 in Ø3.3): no glue, the panel pulls off for rewiring; the button clamps panel to left block as well. (3) The button's thread is only 6 behind the window, so its **10 AF nut sits directly on the window's back in a captive hex pocket** (10.6 AF, 3 deep, flats top and bottom) in the block — screw the button in from the front, the nut cannot turn; behind it a Ø9 body bore to the block's back face. (4) Button moved to x 43 (bezel 18 from the upright) as asked; window widened to 26 × 12 (x 30–56) so light gets past the nut either side of it, with a Ø5.3 pixel bore from the rear on each side. **The catch: the left PSU cradle's arm sits at y 20, z 88–96, so the block's back face is at y 19.5 and everything behind the button's bezel — thread, nut, body, solder tags — must fit in 16.5 mm.** If the button is longer, it goes back to x ≥ 70 where 25 mm is available (one constant, `BTN_X`). With the button at the left end no M5 line into the upright's slot misses it, so the left block has a 5.3-wide tongue in the slot mouth instead (locates it; the pegs hold it; CA the tongue if it walks). Proven: all four parts 0 mm³ against the frame (upright with its slot mouth, rails, cradle reaches, PSU, facias, sub-frame flush or set back), pegs locate, window seated in the panel, blocks clear of each other.

**Print job 2026-10-11 — the sill panel (D10's button strip), four parts in `parts/sill/`:** (1) `sill-panel-v1.stl` **with** `sill-panel-window-v1.stl` loaded as ONE multi-part object (as the facia + logo): panel dark grey PETG, window **natural PETG** (the halo), 9 cm³, 251 × 3 × 12 standing on its bottom edge as exported, 5 mm outer brim, skirt off; set the window part to grey if there is no natural filament — it then has no halo. (2) `sill-block-left-v1.stl` (12 cm³) and (3) `sill-block-right-v1.stl` (3 cm³), any colour (hidden), front face down as exported, no brim; the bolt-head pockets and the light cavity are open at the bed, the pocket roofs are 14 mm bridges. Hardware: **2 × M5 × 10 + 2 drop-in T-nuts**; the 8 mm momentary button (Ø8, ~Ø10 bezel), one 5 mm WS2812 (D10). **Status 2026-10-11: sill panel v1 released** (`src/parts/sill_panel.py`, sheet `parts/sill/sill-panel-plan.png`). The panel fills the reveal x 20–271, z 87–99 (1 mm to the facia below and the PSU above, 2 to the column facia). **Departures from D10 as decided on 2026-09-20, all forced by parts modelled since:** the panel stops at x 271 because the column facia (x 273–338, z 91–336) owns the rest of the band; the halo is a **14 × 12 translucent window** round the button (a Ø10–14 ring cannot live in a 12 mm strip — it would show 0.8 mm outside a Ø10 bezel); the **button is at x 78**, not the left end, because the left PSU cradle's arm reaches x ~65 at y 20–60, z 88–96 and an 8 mm button's ~20 mm body only fits behind the panel to the right of it; the **XIAO is not in the end block** (a 12-tall block cannot hold it) — the block holds the button (glued into a Ø8.4 bore; no nut, 13 AF does not fit in 12) and the 5 mm pixel (Ø5.3 bore from the rear into a 20 × 8 × 3 light cavity behind the window), with a wire notch at its bottom-rear corner for the five wires dropping into the left PSU rail's inner slot; there is **no groove behind the panel** (3 mm cannot take 4 × 4) and the right strip's data run does not go that way. **Stage 8 decisions now open:** where the XIAO lives (suggest: on the rear-left upright next to the Addtam, where the USB lead, both data runs and the button/pixel wires all arrive via the left PSU rail's and rear-left upright's inner slots; the right strip's data then runs along the rear BASE rail's slot, hidden). Blocks: left x 20.3–90 (y 3–19.5, and 3–28 under the button and pixel), right x 226–251 (y 3–19) against the sub-frame upright's left face; each takes one **M5 × 10 along x** through its 7.7 outer wall into the adjacent upright's slot (left upright inner face, y 10; sub-frame upright left face, y 13; both z 93) — the head sits in a **pocket open to the front**, driven with a ball-end key before the panel goes on. Panel to blocks: four Ø3.2 × 7 pegs on its back (x 24, 66, 229, 248; z 93) into Ø3.4 holes, CA; no holes through the front. Proven: panel, window and both blocks 0 mm³ against the uprights, rails, cradle reaches, PSU feet and body, both facias and the sub-frame; pegs in holes 0, 0.5 shifts collide (located); blocks clear of each other.

**Print jobs 2026-10-11 → — the mini-slot drawer (D7), three parts:** (1) `parts/mini/mini-slot-body-v1.stl` — black PETG, 145 cm³, 26 × 285 × 78.5, **rotate 45° on the plate** (220 on the diagonal), floor down as exported, 5 mm outer brim; the groove and stop channel in its bottom are 8.6 and 2.6 mm bridges, no support. (2) `parts/mini/mini-slot-runner-v1.stl` — **black ABS+ (dried)**, 28 cm³, 12 × 307 × 11, rotate 45° (226 diag), plate down as exported, 5 mm outer brim, **ironing ON top surfaces** (the plate top is the bearing); counterbores open upward, no sacrificial layer needed. (3) `parts/mini/mini-slot-facia-v1.stl` — dark grey PETG, 5 cm³, 88 × 3 × 26 standing on its long edge as exported, 5 mm outer brim. Plus the mini pull insert from the v3 inserts plate. Hardware: **3 × M5 × 10 button head + 3 drop-in T-nuts** (the inner AWG-level rail's top slot). **Status 2026-10-11: mini slot v1 released** (`src/parts/mini_slot.py`, sheet `parts/mini/mini-slot-plan.png`). The slot rides ON the inner rail (x 251–271) — 26 mm of drawer cannot hold the P3 side-boss pair, so the runner is one 12-wide bar (x 255–267, y 23–330) with a **dovetail rib** (neck 5 × 3, 45° flares to an 8 head, 6 tall) and the body's 8.5 bottom block carries the matching groove (rib + `RUNNER_CLR` 0.3 on every face), open at both ends; the body's flat bottom rides on the runner's plate top and the flares hold it down when it is out 250 and cantilevered. Travel stop: a 2 × 10 × 2.5 bump on the plate at y 27–37 rides in a 2.6 × 2.8 channel in the body's bottom (open at the front, ends 8 from the rear) — the drawer threads on from the front and stops at 250 out; **removal = drawer fully out, undo the three M5 (all exposed), slide drawer + runner forward together** (no lift-to-remove on this one). Home = facia back against the sub-frame's front upright. D7 neck: left wall steps to x 252 over y 81–171. Front wall top at z 302 and the side walls' front 5 mm rebated above z 282 for the mini insert v2's flange and leg (the insert's 25-wide flange is wider than the 21.2 inside); two Ø3.2 × 7 pegs on the facia's back into pads at x 249 / 261, z 275. Facia 26 × 88 × 3 (z 248–336), notch 22.3 × 23.15 — the facia's top corners beside the notch are only 1.85 wide (the insert's ears sit behind them). Proven: body vs runner / frame 0, runner vs frame 0, facia vs frame / body 0, insert vs facia / body 0; body held (0.5 up / down / sideways all collide, 0.2 free); out 100 and 249.5 free, 250.5 hits the bump; facia pegs locate (0.5 shift collides). **Housing-top constraints added:** notch x 242–268, y ≤ 22, z 313–336 for the mini insert's pocket; the vent-channel notch x 252–338 over y 81–171 (D7). Thermal check per D7 after it is in.

**Print job 2026-10-09/10 — the pull-insert plate v3:** `parts/inserts/pull-inserts-plate-v3.stl` (dark blue PETG, 39 cm³, everything as exported; **supports ON, on build plate only** — the inserts' flanges and legs are 3 and 5.7 mm above the bed) — **pull inserts v2 for all three drawers plus the sled-bar liner**. v1 inserts (bottom, printed; column, released 2026-10-09) held in the notch sideways and downward only and took a forward pull through glue in shear on three 3 mm edges — Gareth: "it'll last less than 10 secs"; **both are superseded, do not use.** v2 (`src/parts/pull_inserts.py`, one function for all): behind the 3 mm face a 2 mm **flange** steps out past the notch (ears: bottom 10, column 2.5, mini 1.5 each side; column/mini also an 8 mm lip below) and sits flat on the facia's back — a forward pull bears on the facia, glue face to face; the flange then **hooks over the drawer body's front wall** (2 mm bridge over the wall top, 2 mm **leg** 20 mm down the wall's inside, 0.3 clear, glued to the body too). Bottom: the 60-tall body's wall top is level with the notch floor, the bridge sits on it, the leg runs drawer z 40–60 in two halves clearing the Q1/Q2 seam boss (x 145.5–169.5, 8 deep inside the wall); nothing printed changes except the insert. Column: the body's front wall loses its **top 29 mm between the side walls** (`column-drawer-v3.stl` has it; the printed v1 body is cut by hand — the earlier 46 × 19 window is withdrawn, cut the full width instead; the flange is 55 wide, 1.5 clear of each side wall, so the cut may leave up to 1.5 of front wall standing or run into the side walls, which carry nothing in their top 29), the bridge sits 1 mm above the cut edge, the leg runs z 191–211 inside what is left. Mini: `mini_slot.py`, when modelled, gets the notch 22.3 × 23.15, a 2.4 front wall whose top is 29 below the facia top and a full-width window. Sled bar: the 120 × 6 notch cannot hold the 17-deep pocket, so a 1.5 mm L-shaped liner (floor + front wall, 119.7 wide) glues in — trial. Proven (`pull_inserts.py` main): each insert in its facia 0 mm³ and in its body 0 mm³; 0.5 forward collides with the facia (bearing), 0.5 sideways with the notch, 0.5 down with the notch floor and (bottom) the wall top; liner in the bar 0 mm³, 0.5 sideways/down collides. **Housing-top tile notch for the bottom pull widens to frame x 120–240** (ears), y ≤ 22 over x 130–230 stays for the pocket, z 63–86. `parts/drawer/drawer-pull-insert-v1.stl` and `parts/column/column-pull-insert-v1.stl` stay in the repo as superseded.

**Print job 2026-10-09/10 — the column facia and its pull insert:** `parts/column/column-facia-v1.stl` (dark grey PETG, 245 × 3 × 65 standing on its long edge as exported, 44 cm³ — **thin-part settings**: brim outer 15 gap 0, skirt off, door closed, bed 80, fan 30 % max, outer wall 60) and `parts/column/column-pull-insert-v1.stl` (dark blue PETG, face down as exported, 7 cm³, no brim) — one plate. **Status 2026-10-09: column facia v1 + insert v1 released** (`src/parts/column_facia.py`): 65 × 245 × 3 at frame x 273–338, z 91–336; notch 50.3 × 23.15 in the top edge for the 50-wide P6 insert (slot 40 × 12); **two Ø3.2 × 7 pegs on the back** at the body's front-wall holes (x 16 / 48, z 20) locate it — press on, CA, no screws (Gareth: no holes through any facia front). Proven: insert in the notch 0 cm³, held, flush; facia on the body 0 cm³ with the pegs in the holes, 0.5 shift in x or z collides (located), clear of the uprights and inner rails. **Printed by 2026-10-09:** column drawer, all four column strips (short left lower), cross bars v2, rear box. Next to model: ~~mini-slot drawer + runner~~ (2026-10-11), housing-top tiles.

**Correction 2026-10-08: left lower column strip is a SHORT one.** The right PSU cradles sit on the PSU-level inner rail and their saddle lips hang 6 mm down its right face (y 23–63 and 223–263, z 82–88) — exactly where the 260 strip's bolt bar goes; my frame check had no cradles in it. Gareth measured 144 clear between them. **`parts/column/column-strip-lower-short-v1.stl`** (140 long, two M5, 36 cm³, same section) goes on the left, centred in that gap; the 260 `column-strip-lower-v1` is now the RIGHT side only (print one, not two). `src/column_check.py` now includes the cradle lips (0 cm³) and the travel: the drawer can come out 215 before its groove leaves the short rib, 243 for the right one. **M5 × 10 / T-nuts: 14, not 16.**

**Correction 2026-10-04 (afternoon): cross bars v2 — guide lips 1 mm further apart each.** The printed v1 lips sat exactly 135 apart, the box's length, so the box would not drop between them (my zero-clearance design, not a print fault). v2: front lip y 189–194, rear lip y 331–336 — 2 mm of play, the box still held fore-aft (`src/box_check.py`: 0.5 free, 1.5 collides). **Reprint both: `parts/sled-cross-bar-front-v2.stl` + `parts/sled-cross-bar-rear-v2.stl`**, black ABS, flat as exported on one plate, 5 mm outer brim (60 + 75 cm³); v1 STLs removed, the v1 .3mf is stale. Tabs and sockets unchanged, so they drop into the same beam sockets.

**Print jobs from 2026-10-04 — the column drawer and its guide strips:** (1) `parts/column/column-drawer-v1.stl` — 64 × 285 × 240, **544 cm³** (a full night and a morning, ~24 h), black PETG or PLA (Gareth's call — it is hidden inside the column), floor down as exported on the diagonal (247), 5 mm brim, no support, door closed; (2) `parts/column/column-strip-lower-v1.stl` ×1 (right), `column-strip-lower-short-v1.stl` ×1 (left — see the 10-08 correction) and `parts/column/column-strip-upper-v1.stl` ×2 — black ABS+ dried, rail face down as exported, two to a plate on the diagonal, 5 mm outer brim, Bridge counterbore holes → Sacrificial layer, 67 / 41 cm³ each; **16 × M5 × 10 + 16 drop-in T-nuts** (4 per strip) — check stock. **Status 2026-10-04: column drawer v1 + four guide strips released** (`src/parts/column_drawer.py`, D5, P3 ☑). Body x 274–338 (64 wide: the HANDOVER's 2/3 split became 3/3 so one strip STL serves both sides, turned end for end), y 3–288, z 91–331, walls 2.4, floor 3, two M3 facia pads. **Lower strips** (PSU-level side slots at z 78, inner rail's right face x 271 / right PSU rail's inner face x 341): the P3 rib with its bottom at z 94 = the drawer's floor top, so the drawer hangs on the two 45° slopes exactly as the bottom drawer does; an 8 mm bolt bar at z 70–86 under the drawer floor carries the four counterbored M5 (nothing else lives in front of those rail faces there), a 2.7 plate rises from it with the rib. **Upper strips** (AWG-level side slots at z 237.5): a plain 14 × 7 guide rib with the four M5 counterbored through its tip, 0.5 slack in the drawer's upper grooves — they only catch the roof if the drawer tips when pulled out. All four 260 long at y 45–305, clear of the ties and the front-tie bracket. Proven in `src/column_check.py`: drawer + strips 0 cm³ in place, up 0.2 / sideways 0.5 collide, down 0.5 free, down 0.8 lands on the slopes; tipped 1° nose-down the upper ribs catch it; strips 0 cm³ against every rail, upright, tie and the cast bracket; bolt bars clear of the drawer, the housing top and the facia. Sheet `parts/column/column-plan.png`. Still to come for the column: facia (245 × 65 on edge + 40 insert), home stop. **Rear box printed 2026-10-04.**

**Print jobs 2026-10-03 and 10-04 (nights) — the rear box, dark grey PETG, one half a night:** `parts/rear-box-left-v1.stl` then `parts/rear-box-right-v1.stl`, 153.5 × 135 × 110, 150 / 145 cm³, floor down as exported, 5 mm outer brim, no support, door closed, bed 80 (tall 2.4 walls — the thin-part settings), `SiglentTower fit 0.20`. **Status 2026-10-03: rear box v1 released** (`src/parts/rear_box.py`; Stage 6; P7 ☑ joint, cross bars v1): 291 × 135 × 110 outside (x 50–341, y 195–330, z 346–456), floor 3, walls 2.4, full rear and side walls, 20 mm front lip; split at x 195.5 into two halves joined like the drawer quarters — three floor puzzle tabs on the seam (y 220 / 250 / 280, alternating) and vertical sliding dovetails at the rear-wall and front-lip crossings (left half male), the right half drops onto the left, CA the seam. Sits on the cross bars' tops between their guide lips. Proven in `src/box_check.py`: halves assembled 0 cm³, every joint engaged (pull-apart held by the tab flanks), right half lifts clear; box on the sled ladder 0 cm³, 0.5 fore/aft collides with the lips, 10 and 60 to the right slides free, clear of the scope envelope. Sheet `parts/rear-box-plan.png`. Cradle plate printed 2026-10-03 morning, refit pending. Facia, pull insert and logo printed 2026-10-02.

**Correction 2026-10-03 (midday): right FRONT PSU cradle v5.** With the v4 pair fitted: the right REAR foot sits in its v4 cup, the right FRONT wants its cup "a few mm" further from the inner rail than v4 — the PSU sits very slightly skewed. One part: **`parts/psu-cradle-right-front-v5.stl`** (`REACH_V5RF` 34.75 → cup 37.75 from the inner rail's face, midway between v4's 33.75 and v3's 41.75; print once, black ABS, cup face down with the sacrificial layer, 26 cm³). Left cups v3 and right rear v4 stay. (An intermediate "v5 at 46.75" issued the same hour was withdrawn before printing — it was built on a misreading.) **Print job 2026-10-02/03 (night) — the cradle reprint, black ABS, one plate:** `parts/cradles-v2-plate.stl` (205 × 118, 95 cm³; six parts laid out as exported: 2 × `psu-cradle-right-v4` cup face down, 2 × `awg-cradle-left-v2` standing on end, 2 × `awg-cradle-right-v2` arm-top down), `SiglentTower fit 0.20`, Bridge counterbore holes → Sacrificial layer, supports on build plate only (they fill the cups and pad pockets — snap out), 5 mm outer brim, door closed. **Status 2026-10-02 (evening): Stage 2 ☑ (2.7 done: PSU and AWG seated with the jigs, no rock, fronts in line) — and all three predicted cradle clashes are real.** Measured: PSU feet 155.5 apart (174.5 outer-to-outer, Ø19), PSU 150 tall on its feet, PSU face hard against the left rail (0) and 6.5 off the inner rail; the LEFT feet sit in their cups, the RIGHT pair land on the rims; PSU top touching the AWG arms; right AWG plate touching the PSU side. Fix, agreed with Gareth (minimal — six parts, PSU left pair and position unchanged): **PSU right cradles v4** (`src/parts/psu_cradle.py cradle(REACH_V4R)`: cup 8 nearer the inner rail — 33.75 from its left face — depth unchanged; on the bench the rear one fits and the front one is replaced by v5 at 37.75, see the correction; the v3 bug of adding the reach after the 3 mm lip is now documented, not changed, because the left pair is right where it is), **AWG cradles v2** (`src/parts/awg_cradle.py`: arms 8 → 5, underside 242.5 = 3 mm over the PSU top; right plate 10 → 4 with the two M5 **countersunk** — buy **4 × M5 × 10 countersunk** — at x 247–251, 2.5 off the PSU face). Sag of a 5 mm arm under the AWG's ~10 N per pad: 0.08 / 0.15 mm; stress ~5 MPa. Proven in `src/cradle_check.py` (cup on the foot ±0; arm, plate and both right brackets 0 cm³ against the PSU envelope); PSU position recorded in `fit.py` (`PSU_FACE_X`, `PSU_FEET_CC`, `PSU_H_FEET`). The seating jigs still fit (the right PSU jig's feet are on the PSU, not the cups). Then the rear box.

**Print job 2026-10-02 (night) — the bottom-drawer facia, dark grey + dark blue PETG, one plate:** `parts/drawer/drawer-facia-v1.stl` **with** `parts/drawer/drawer-facia-logo-v1.stl` loaded as ONE object (Bambu Studio asks "load as a single object with multiple parts?" → Yes; set the logo part to the blue filament), 315 × 3 × 83 standing on its bottom edge as exported (D3), on the diagonal, 5 mm outer brim, skirt off, `SiglentTower fit 0.20`, 71 cm³ grey + 0.3 blue; plus `parts/drawer/drawer-pull-insert-v1.stl` (blue PETG, face down as exported, 100 × 23 × 22, 12.8 cm³, no brim) beside it. **Status 2026-10-02: facia v1 + pull insert v1 released** (`src/parts/drawer_facia.py`, `src/logo.py` turns `Iguana.svg` into the inlay; sheet `parts/drawer/drawer-facia-plan.png`). Facia 315 × 83 × 3 (frame z 3–86, y 0–3): top-edge notch 100.3 × 23.15 for the P6 insert at 100 wide (slot 80 × 12, hook 5, pocket 17 deep, floor 30°, glued in flush); four **Ø2.5 × 2.3 blind holes** in the back face at the body's screw pads (x 40 / 117.5 / 197.5 / 275, z 20) — **M3 × 10, not 14** (wall 2.4 + pad 5.6 = 8 under the head, 2 into the facia, 0.7 of front skin left) and CA the facia to the wall and pads as well; the iguana inlaid 0.8 deep top-right (58.7 × 21.1, head right, x 240–299, z 48–69), features under 0.9 mm dropped so every toe prints. Proven: insert in the notch 0 cm³ and held (0.5 down / sideways collides), flush front and top; logo in its recess 0, clear of the notch and holes; the holes stop 0.7 short of the front face. **Constraint recorded for the housing-top tiles (not yet modelled):** the insert's pocket reaches back to frame y 22 over x 130–230 at z 63–86, so the housing top's front edge is notched (or starts) behind y 22 there.

**Print job for 2026-09-28 (night) — the first drawer quarter, black PETG:** `parts/drawer/drawer-Q1-v1.stl`, 165.5 × 158 × 60, 135 cm³ (twice a tile plate), floor down as exported, no brim, no support, `SiglentTower fit 0.20`. Then Q2, Q3, Q4 on the following nights (one quarter is a plate: 165.5 × 158 with its tabs, so two never fit the 256 bed — the handover's "two quarters per plate" was wrong). **Tile plates A–F all printed by 2026-09-28** — the side skin's twelve band 1–3 tiles exist; band 4 left is the only side tile still unmodelled. **Status 2026-09-28: bottom-drawer quarters v1 released** (`src/parts/drawer_quarters.py production()`; D2 + P7 ☑ + P3 geometry) — the coupon geometry plus the runner groove (P3, `drawer_runner.groove_cut`, `RUNNER_CLR` 0.3) in a 10 × 20 boss along each outer side wall, closed at the front wall and open at the rear; the left/right wall dovetails raised to z 20–60 (PRINT-RULES §2) with a 45° underside; four facia screw pads inside the front wall (Q1/Q2, x 40 / 117.5 / 197.5 / 275, screw centre z 20, M3 clearance teardrops through wall + pad = 8 mm → **M3 × 10 button-heads ×4, to buy** (14 was wrong); the facia's Ø2.5 × 2.3 blind holes are in facia v1, 2026-10-02). Proven in `src/drawer_check.py`: four quarters assembled 0.000 cm³ intersection, every joint engaged (0.5 shift in x or y collides), Q2/Q3/Q4 lifted 10 clear (vertical assembly), the 300 runners in place 0.000 cm³, drawer up 0.2 / sideways 0.5 collides, sideways 0.2 / down 0.5 free. Check sheet `parts/drawer/drawer-quarters-plan.png`. Risk accepted: P3's friction verdict is still open — if it moves `RUNNER_CLR`, the grooves change; the fix planned for stick-slip is runner-side (ironing, PTFE, four bolts), so the quarters print now.

**Status 2026-09-28 (evening) — seating the PSU and AWG.** **Seating jigs issued** (`src/jigs/seating_jigs.py` → `jigs/seating-jigs-plate.stl`, yellow PETG, 213 × 246, 52 cm³ solid, as exported, no brim, no support, 2 walls, 15 % infill): **PSU L / PSU R** — a bar with two replica PSU feet at y 51 / 253.5 and a nose arm whose front face stops on the front-left upright (y 20) / front inner upright (y 23); **AWG L / AWG R** — a bar with two 20 × 20 bosses into the pad pockets, 203 / 200 apart, setting the rear cradle from the front one; **four PETG stand-in AWG pads** (20 × 20 × 5.5) so the AWG can sit before the Stage 8 TPU session. Proven against the cradle models: 0 intersection in place, 0.5 forward collides, nose faces on y 20.00 / 23.00. The PSU arms reach 52, so the jigs still work if the cups move 3 mm (v4). **Three clashes found in the model, awaiting Gareth's measurements (PSU foot c-c across, cup c-c across on the frame, PSU bench-to-case-top) before any reprint:** (1) `psu_cradle.py` puts the cup REACH from the lip's outer face, not the rail face → cups 41.75 in, 147.5 c-c across vs ~154 feet; (2) PSU top 92 + 149 = 241 vs the AWG cradle arms' underside 239.5 (the viewer draws the PSU 137 tall); (3) the right AWG brackets' plate (x 241–251, z 227.5–247.5) overlaps the PSU body (to x 245.75, z 241) by 4.75. Proposed: PSU cradles v4 (cup 3 nearer the rail, 2 deeper) and AWG cradles v2 (arms 6, right plate 4 with countersunk M5).

**HANDOVER 2026-10-01 (morning) — read this first; the 2026-09-27 handover below it is history.** Frame: Stage 2 built (sides flat-built with all five rails and the feet, joined, sub-frame in); **Stage 2 ☑ (2.1–2.6 on 2026-10-01, 2.7 on 2026-10-02).** The scope has been trial-sat on the bare beams and leaned them inwards → sled front bar v2 with saddles (status 2026-10-01); cross bars v1 sliced. **Printed:** tiles A–F (12 side tiles), drawer quarters Q1–Q4, PSU + AWG cradles, sled feet + beams, strip brackets, hinge pair; the drawer runners are the 09-30 / 10-01 night jobs. **Next on the bench, in order:** (1) reprint the beam front halves v2 and the front bar v3 (status 2026-10-01 midday), fit with the cross bars, glue and screw every joint, scope on, check the stand pads stay level; (2) ~~runners / P3 verdict~~ — **P3 ☑ 2026-10-01, the drawer slides well**; (3) PSU / AWG seated 2026-10-02 — all three predicted clashes real; measured and fixed by the PSU right cradles v4 + AWG cradles v2 (status 2026-10-02 evening), the next print. **Modelling queue:** drawer home stop; ~~column guide strips ×4~~ (done 2026-10-04) + mini-slot runner (ABS+); cable channel (Ø4.3 holes on the pegs at x 33, y 150 / 290); sled stops; band-4 left tile (fits round band 3, already printed); ~~drawer facia + pull insert~~ (done 2026-10-02); column + mini-slot drawers; housing tops; box halves. **Hardware to buy:** M3 × 10 ×4 (drawer facia; the 14 was wrong — a 3 mm facia); M5 × 10 countersunk ×4 (AWG right brackets v2). **Rules that bit this week:** nothing can go under the sled beams (AWG 1 mm below) — roll stiffness comes from the ladder's lap joints, not from supports; a tab joint is a hinge in roll; one drawer quarter per plate; every export through `printcheck.py`, every fit proven by boolean + shift test before it goes to him; he does not read code — files straight into the repo with a `.git/<name>-commit-msg.txt` and the `git commit -F` line, numbered one-action steps, plain words.

**HANDOVER 2026-09-27 (evening).** Where things stand: Stage 0 ☑; gates P1 P2 P4 P5 P6 P7 P9 ☑ (P3 = friction verdict at 4.1, P8 = the Stage 8 TPU session). Strip brackets done and mounted (upper v1, lower v4). **Gareth is assembling the frame now — Stage 2, 2.1–2.5 — from `frame-assembly-3d.html`** (`src/frame_assembly_viewer.py`; regenerate with `python src/frame_assembly_viewer.py`, it lifts three.js from `bench-stack-3d.html`). His T-nuts are drop-in; connectors per the §Stage 2 note (hidden L on the inward faces, one flat cast bracket on the front tie, scope rails on cast brackets — fitted in the same flat build with their feet already in, revised 2026-09-28). Ask him for: the diagonal / 321 / 510 checks, whether anything wobbles (3 spare cast brackets go under the PSU rails' rear ends first), then tick 2.1–2.6 and do 2.7 (PSU and AWG on blocks at 91 and 251.5, check the 3 mm reveals). **Printer:** tiles plate A printed, B and C sliced (`bambu/parts/`), B is tonight; then D, E, F; each night one plate *(all six printed by 2026-09-28)*. **Nothing else is waiting on the bench. He wants a BIG overnight run next** — the tile plates are bed-limited to two tiles a night (band 2 + band 3 nested would be 250.2 wide; band 1 + band 1 + band 3 is 252.6 — both over the 250 plate rule, so no repack), and nothing bigger is exported yet. So the first job of the next session is to make one *(done 2026-09-28: drawer quarters Q1–Q4 released, one per plate)*: best candidates are the bottom-drawer quarters (D2, P7 ☑, `src/parts/drawer_quarters.py` production pass — runner grooves, facia bosses — one quarter per plate, the biggest print in the build) or the ABS+ bar plate (bottom-drawer runners ×2 with four M5 each, column guide strips ×4, mini-slot runner ×1, all on the diagonal), whichever is ready first; tile plate C runs tonight regardless, D–F on the nights after. Then the modelling queue, in order: (1) ~~sled front bar~~ and (2) ~~two cross bars~~ (both done 2026-09-28, `src/parts/sled_bars.py`); (3) cable channel (Ø4.3 holes on the pegs at x 33, y 150 / 290); (4) sled stops; (5) band-4 left tile (its bottom fingers interleave with band 3's top ones — band 3 is plate C, already sliced, so band 4 must fit round band 3, not the reverse); (6) ~~drawer quarters production pass~~ (done 2026-09-28) and the bottom-drawer runners (four M5 each); (7) column guide strips — the one on the right PSU rail's inner face starts at y ≥ 45 (front-tie bracket at y 23–43). Every export through `printcheck.py`, every clearance from `fit.py`, every fit proven by boolean intersection + shift test before it goes to him (he will not read code). **How he works:** files go straight into the repo folder (never zips), always with a commit message he can paste — long ones in `.git/<name>-commit-msg.txt` + `git commit -F`; numbered one-action steps, plain words (no invented terms — he asked what 'bezel' and 'CA' meant), diagrams when asked; ABS+ profile has a 5 mm outer brim on everything; TPU prints once, last. Keep `claude/ROADMAP.md` in the project in step with this file.

**Status 2026-09-27 (bench):** **Strip brackets done** — lower v4 seats on the Addtam with the cable in place ("fits perfectly"); **both brackets bolted to the rear-left upright (z 344.5 / 95) and the strip hangs solidly on them;** upper is the v1 already printed (v2/v3 withdrawn: the part is built around its peg, so raising the strip changed only its bolt height). Two wrong turns on the way: v3 moved the peg line +8 (not the problem — reverted, `STRIP_KEYHOLE_OFF` 29.2); the real fault was the shelf sitting under the strip's mains cable, which exits the bottom end on the keyhole line, Ø15, rigid 25 → v4 U-shelf and strip at z 75–425 (D8 updated). Rule reinforced: check every feature against the working envelope *including the cables*. Tiles plate A printed; B–F queued as the overnight jobs. Hinge swing checked later the same day: no bind, folds just past 180 → **P5 ☑**. Next: frame build Stage 2 (2.1–2.5; hold 2.6 until the feet are bonded into the beams); Claude models the sled front bar, cross bars, cable channel and stops.

**Status 2026-09-26 (bench):** **Sled plate printed and proven** — both 210 feet slide the length of bar Z's inner slot and can't lift out; both beam pairs CA'd at the P7 tab and each foot's rib threads its beam's groove by hand from the rear (P1 + P7 + the rib pair, all in ABS+). Feet NOT yet bonded into the beams: that happens when the scope rails go in (2.6). **Yellow run printed:** band-1 tile + band-2 crop both snap into one slot of bar Z, no rock beyond pivoting on the single clipped edge, come off only by angling — **P4 holds for real tiles**. Hinge: the 2.9 pin passes both leaves (3.0 binds in the printed 3.2 bore) → `PIN_D` 2.9; 180° swing to confirm → P5. Strip brackets: upper fits the Addtam keyhole; **lower v1 could not seat — its print gusset stood inside the strip's footprint; v2 (brace under the shelf) issued 2026-09-26, `parts/strip-bracket-lower-v2.stl`, reprint yellow.** Next: frame build (Stage 2, 2.1–2.7 — everything it needs exists: cut extrusion, spacers, cradles, feet + beams); Claude models the sled's front bar, cross bars, channel and stops against the beam sockets, then the side-tile production pass (bands 2–3 full height, finger schedules per rail, the frame-leaf M5 keep-outs on the right scope rail) so black PETG tiles become the overnight jobs.

**Status 2026-09-24:** all extrusion cut. P1 P2 P4 P6 P7 P9 ☑ (values in `fit.py`). PSU cradles ×4 and AWG cradles ×4 printed (black ABS) — Stage 3 fits on the frame. **Print, black ABS+: 2 × `parts/sled-foot-210.stl` (standing, no brim) and the four beam halves `parts/sled-beam-{left,right}-{front,rear}-v1.stl` (flat as exported, `SiglentTower fit 0.20`).** Scope feet positioned 2026-09-24 with the P9 jigs (`coupons/p9/p9-jigs-plate.stl`, `src/coupons/p9_position_jig.py`): rear bumper centre 44.15 from the bezel side and flat 116 from the front face (HANDOVER had 39 and 135); stand outer edge 24.7 from the bezel side, leg front 10 from the face; the blue body is inset 4.7 per side behind the bezel. Beams re-exported on those (check sheet `parts/sled-beam-plan.png`). Beam assembly: CA the halves at the P7 tab, thread the foot's rib into the groove from the rear until it stops (y 119.5), bond, foot into the loose scope rail from its end (2.6). P3 geometry passed; friction verdict on the frame at 4.1. Frame 2.1–2.5 may proceed (runner and cradle T-nuts in first — 2.1). Next models from Claude: front bar (sockets for the beam tabs in its rear-bottom edge), cross bars ×2 (241 between the beams, P7 tabs, guide lips), cable channel (Ø4.3 holes on the pegs), stops; then P8 (incl. slot cover + AWG pads), P5, sill panel + end blocks (D10), strip brackets.

**Print jobs 2026-09-24.** (1) **Overnight — `parts/sled-absplus-plate.stl`, black ABS+** (dried), 245 × 206, four beam halves flat + both 210 feet standing, ~294 cm³ solid, `SiglentTower fit 0.20`, brim **outer only** 5 mm (the feet need it; trim it off the beam tabs' flanks before assembly), supports on build plate only, door closed. Layout `parts/sled-absplus-plate.png` (`src/sled_plate.py`). (2) **Morning — `coupons/yellow-run/yellow-run-2026-09-22.stl`, yellow PETG**, 197 × 164, as exported, no brim, no support: P5 v2 hinge pair, band-1 tile pair, strip brackets — test-fit only, nothing to measure.

**Status 2026-09-22:** **P5 and P8 coupons modelled and exported** (`src/coupons/p5_hinge_magnet.py`, `src/coupons/p8_tpu.py`; check sheets `coupons/p5/p5-plan.png`, `coupons/p8/p8-plan.png`). Both are clear of the sled, so they print while the bumper measurements are outstanding. **P8 `coupons/p8/p8-plate.stl`** — blue TPU, 201 × 60 × 14, 14.8 cm³, flat as exported, no brim: spigot sweep 4.2 / 4.6 / 5.0 / 5.4 (`SPIGOT_D` has never been measured), one 24 × 24 × 6 foot at 4.6, one AWG pad (rear pattern), two 60 mm slot covers at head 6.0 / 6.3, two sled-stop caps. **P5 `coupons/p5/p5-plate.stl`** — yellow PETG, 104 × 25 × 35, 7.5 cm³, standing as exported: three-segment butt hinge (barrel Ø8, bore 3.2, axial clearance 0.4, floating segment ends coned 45° to the bore so nothing needs support), two printed pins Ø3.0 / 2.9 on snap-off disc feet, two 12 × 12 × 3 magnet bosses. Every part on both plates passes `printcheck.py` with no down-facing area above the bed. **Finding (slot covers):** a cover that finishes flush in the 5.9 mouth occupies 2.95 of the 6.15 slot depth, leaving **3.2 mm** for cable — the D10 USB pigtail must be ≤ 3 mm OD or its cover stands proud. **P8 is no longer a separate print** — TPU moved to one session at Stage 8 (rule in §2); P5 prints now.

Tick a stage here only when its "Done when" line in the section below is met and every row in its table is ☑.

---

## 0. Decisions D1–D11 — status

Found by checking the handover against the 1 m bars and the 256 × 256 bed.

| Done | # | Finding | Decision | Status |
|---|---|---|---|---|
| ☑ | D1 | Cut list (7,579 mm) does not pack into 8 × 1 m at a 2 mm kerf — the two 179.5 inner uprights are what don't fit. | **Buy the CNCMANS 300 mm 4-pack (£13.99).** The 179.5s and 70s move to the 300s; the 8 × 1 m then take every 3xx and 510 piece with room. Two of the 300s are left whole as coupon rail. The pack's extra 4 brackets + 50 T-nuts also cover the 42-joint count. | **Decided.** Order it. |
| ☑ | D2 | Bottom drawer 315 × 300 cannot split into two bed-size pieces. | **Four quarters 157.5 × 150, full size kept.** Joint design in `drawer-quarters-v1.pdf`: floor puzzle-dovetail tabs (12 neck / 18 head / 8 long, pitch 30) alternating along both seams, none within 15 of the cross; vertical sliding dovetail (4/6 × 3) at the four wall crossings in a 12 × 8 boss; facia screwed across Q1–Q2; every joint assembles vertically (Q2 → Q1, Q3 → Q1, Q4 last). Housing top above = four loose clipped tiles. P7 is now this joint (§3). | **Decided.** Coupon P7 verifies before any quarter prints. |
| ☑ | D3 | Drawer fronts can't print face-down (315 × 86 fails flat and diagonal). | **All three fronts + sled bar standing on the long edge on the diagonal** (315 × ~15 → 233). No seam. P6 prints in that orientation. | **Decided.** |
| ☑ | D4 | Side tiles 310 long and top tiles 160.5 × 310 don't fit in one piece. | **Two 155 tiles per band, each clipped; top panel four tiles 160.5 × 155 on a printed H-spline** (two 10 × 3 strips under the seams at x 180.5 and y 175). Shown in `bench-stack-3d.html`. | **Decided** — confirmed from the viewer, pending the P4 clip-tile coupon before any tile prints. |
| ☑ | D5 | Column drawer 65 × 240 × 300 fails the diagonal by 2 mm. | **Shorten to 285** (diag 247.5). Body y 3–288 in `bench-stack-3d.html`; housing top over column + slot stays 300 deep as two loose tiles. | **Decided** (confirmed from the viewer). |
| ☑ | D6 | Sled beams 327 × 40 with arms fail the diagonal. | **Split each beam at y 165** (between the rear-bumper cup arms at 106–138 and the front cross bar at 190); the 210 T-foot bridges the seam. Cable channel is a separate 194 part keyed to the left beam. Shown in `bench-stack-3d.html`. | **Decided.** Joint coupon is part of P7. |
| ☑ | D7 | Mini slot was 180 deep only because it sits 5 mm off the AWG's right side, and the AWG's fan vent is on that side (measured: Ø80 centred 123 from the AWG front → frame y 126, vent y 86–166). | **Slot 285 deep (y 3–288), same as the column, with a 15 mm air channel beside the vent:** the slot's inner wall steps from x 242 to x 252 over y 81–171, so the body is a 26-wide front pocket (78 deep), a 16-wide neck (90) and a 26-wide rear pocket (117). The housing top over column + slot is notched the same (x 252–338 over y 81–171) so the channel is open upward into the 19 mm layer under the scope and downward past the inner rail. Shown in `bench-stack-3d.html`; slot travel now 250. | **Decided.** Gates: P3 (rides the inner AWG rail). Prints flat on the diagonal (285 + 26 → 220). |
| ☑ | D8 | The strip's keyholes run **horizontally** (slots across the body), so its keyholes alone cannot hold it vertical; and a horizontal mount needs ~380 (350 body + cable exit) against a 361 frame with nothing free either side at the rear. | **Vertical on the rear face of the rear-left upright, cable end down, on two printed L-brackets in that upright's rear slot** (back to HANDOVER §7's position): peg line x 30.2 → body x 1–79 (78.1 wide, 29.2 edge outboard, inside the frame), **z 75–425** (was 25–375; raised 2026-09-27), y 350–380 (30 thick inside the 60 behind), sockets facing the wall. Pegs at **z 95 and 344.5** (keyholes 20 and 269.5 from the cable end, 249.5 c-c). The lower bracket carries a U-shaped shelf under the strip's end (z 71–75) that takes the weight; the pegs only hold it against the frame. **The mains cable leaves the strip's bottom end ON the keyhole line, Ø15 and rigid for 25 mm** (measured 2026-09-27) — so the shelf is open round it (gap x 14.2–46.2, 8 mm bridge against the plate) and the strip sits 50 higher than first planned so the cable can bend before the bench. Cable drops to the bench at the rear-left post. Body edge 56 from the PSU fan centre (x ≈135.5), beside it not behind it. Diagonal rejected: at 45° the body crosses the PSU fan zone, neither keyhole lands on a rail or upright (the rear face has only the base and top cross rails), and it still needs the shelf. | **Decided 2026-09-17** (replaces the horizontal base-rail mount decided earlier the same day). |
| ☑ | D9 | A pull slot cut into a standing front (D3) leaves the slot's top edge as a bridge the width of the opening — 100 on the bottom drawer, 120 on the sled bar — with no way to support it. | **Pulls are separate inserts**: a notch in the front's top edge (no bridge) takes a face-down-printed insert in the accent colour (dark blue, per the HANDOVER colour scheme) carrying the slot, the 5 mm hook strip and the pocket (17 deep, floor 30°, walls 2); glued in, flush front and top. Same on the column front and the mini-slot front; the sled bar's 120 × 6 notch is too shallow for the pocket, so it gets a 1.5 mm blue **liner** (floor + front wall) instead — trial 2026-10-09. **v2 2026-10-09:** the insert carries a 2 mm flange behind the face (wider than the notch, flat on the facia's back) that hooks over the drawer body's front wall and runs 20 mm down its inside — a forward pull bears on the facia, and the glue is face to face on the facia and the body, not edge to edge. | **Decided 2026-09-19** from modelling P6; the coupon prints the insert and a notched facia stub. |
| ☑ | D10 | Lighting wanted; the Addtam has four USB ports (5 V, 4.5 A shared), no 12 V. The 12 V pelmet under the top edge (rev 1, 2026-09-19) needed an adaptor and stuck out 12 mm; a front-mounted button had nowhere to put its body. | **Rev 2 (2026-09-20): light INSIDE the frame, switch in a sill panel.** (a) Two 5 V WS2812B strips (10 mm, 60/m, IP20, 470 mm / 28 LEDs each) stuck to the **rear uprights' inner faces**, z 20–490, facing across the frame: the light fills the cavity behind the instruments and comes out through every hex tile, and no strip is in view from anywhere. (Loop with runs along the rear rails rejected: the top run would show through a perforated top.) (b) **Sill panel** 321 × 12 × 3 (x 20–341, z 87–99, grey PETG like the fronts) fills the reveal between the drawer facia (86) and the PSU frame (100); end blocks 25 × 25 × 12 behind it, one M5 each into the front uprights' inner slots. (c) **Switch** at the panel's left end: 8 mm 2-pin momentary metal push button (Ø8 hole, ~10 bezel) through the panel, with a translucent halo ring Ø10–14 printed into the panel as a second colour (natural PETG, AMS) and one 5 mm WS2812 behind it in the end block — the halo is the indicator, colour and breathing under WLED. (Illuminated 8 mm buttons only come 2-pin unlit; 10 mm 4-pin needs a 13 mm panel and leaves 0.5 to the drawer facia.) (d) **XIAO ESP32-S3 running WLED** in the left end block: button GPIO, two data outputs — left strip fed by 3 wires along the left PSU rail's inner slot, right strip by 3 wires behind the sill panel then along the right PSU rail's inner slot — USB-C lead back over the drawer housing top to the Addtam. WLED current limit 1.5 A (56 LEDs at full white would be 3.4 A). Pelmet, 12 V adaptor and inline controller are gone; top panel unchanged. Shown in `bench-stack-3d.html`. | **Decided 2026-09-20; rev 3 2026-10-16** — D1 mini instead of the XIAO, board in a holder on the rear base rail's rear face, two buses, the pixel on bus 1 ahead of the left strip, cover run B in the rear slot; see the status line and `parts/wiring/`. **Rev 5 2026-10-25 (built, working 2026-11-03):** XIAO ESP32-S3 Plus running **SiglentGlow** (Gareth's own firmware on IguanaPlatform, the MorayGlow architecture) instead of the D1 mini + WLED; SN74AHCT125N level shifter on both data lines, 5 V into the XIAO through an SR3200 Schottky; pins D0 bus 1 (2 sill + left), D1 bus 2 (right), D4 button; strips 15 LEDs each (30/m); every cable on a crimped 2.54 mm locking plug; the sill pixels are WS2812D-F5 (legs DOUT, VDD, GND, DIN). Stage 8 trim; nothing in the frame or cut sheet changes. Buy: 1 m WS2812B 10 mm 60/m IP20 with JST-SM ends (cut in two), 8 mm 2-pin momentary metal button, 5 mm WS2812 through-hole, USB-A-to-bare-wire pigtail (one Addtam port feeds strips + XIAO 5V pad), 2 × 330 Ω, 2 × 1000 µF, 2 × JST-SM pigtails, ~1.5 m 3-core, perfboard scrap. XIAO ESP32-S3 in hand. No MOSFETs/buck/level shifter: WS2812B has its own driver per LED; 3.3 V data is fine over these runs (74AHCT125 only if a strip ever flickers). |
| ☑ | D11 | HANDOVER §5 and the viewer put the door's hinge axis at x 362, z 341 — but the viewer draws the side tiles on the rail centreline (x 351), while `slot_clip.py` puts them ON the rails' outer faces (right side x 361–364). A Ø8 barrel at 362 runs x 358–366: 3 mm inside the frame face and straight through the door panel. The P5 v1 coupon never caught it because it was a generic block, not a section of a production part (§0.3). | **Axis to x 369, z 341.** Barrel x 365–373, clear of the panel's outer face at 364; still z 337–345, topping out under the box floor at 347. Both knuckles become brackets rather than flat pads: the frame leaf is a 6 mm plate on the right scope rail's outer face (z 311–333, one M5×12 into the outer slot at z 321) with a riser climbing 45° to the barrel; the door leaf is a 24 × 24 glue pad on the panel's inner face with a shelf that catches the panel's bottom edge and carries on to the barrel. **Reach rule:** neither leaf extends further from the axis than the other — 30 each way. Nothing of the frame leaf may sit above z 333 outside its own y-third: that is inside the door's swept band and stops it short of 180. Verified in CadQuery: pin passes, leaves clear closed, swing 0–180 clear of the leaf, the rail and the tile below; at 180 the door hangs x 374–377, 10 proud of the tile face. | **Decided 2026-09-22.** `src/parts/door_hinge.py`; P5 v2 coupon cut from it. |
| ☑ | D12 | HANDOVER §5's top panel "321 × 310 lying on the top rails, caps at the corners" lies on nothing (the rails and uprights are at x 0–20 / 341–361); D4's four 160.5 × 155 tiles on an H-spline have no room for the spline (scope top 507, panel 510); and lapped tiles printed flat face-down would have 8 mm ceilings. | **Panel 361 × 350 × 3 over the whole frame top (z 510–513), four 185.5 × 180 tiles printed STANDING on one plate, 10 mm glued half-laps (left/front under, right/rear over), the four caps screwed through the panel's corners into the uprights' bores (M5 × 10).** `src/parts/top_panel.py`. | **Proposed 2026-10-14; on the frame 2026-10-23.** |
| ☑ | D14 | The two drawer housing tops (HANDOVER: fixed lids at z 64–67 over the bottom drawer, four 157.5 × 150 clipped tiles, and at z 333–336 over the column + mini slot, two 96 × 150) were never structural and nothing rests on them any more — the USB lead moved into the rail slot (D10 cable plan), the vent channel (D7) is open upward without them, and the column's travel is set by the guide strips, not a top. | **No drawer lids.** The six tiles are dropped from the build; add them later only if use shows the need. In their place a rule of use: drawer contents stay below the wall tops — the bottom drawer's walls end at z 63 with the PSU cradle arms at 68 (5 mm), the column's at 331 with the right sled beam at 337 (6 mm) — anything proud of that catches on the way in. The housing-top constraints recorded in the status lines stay as the spec if they are ever modelled. | **Decided 2026-10-16** (Gareth: nearly every drawer in the world has no top). |
| ☑ | D15 | The bottom and column drawers have no pull stop: at full travel the groove leaves the rib (bottom at ~300, column at 215 left / 243 right) and the drawer comes off in the hand. A stop block in the base rail's top slot behind the drawer was in the queue (two spare T-nut positions counted for it), but with the P3 ribs lift-to-clear is impossible, so a stop would make removal "undo its M5, then pull". | **No drawer stops.** Pulling clean off is the removal path; a hard pull puts the drawer in the hand, not on the floor, if the user expects it. Add a stop later only if use asks for it. The mini slot keeps its 250 bump (removal there is unbolt the runner). | **Decided 2026-10-16.** |

**Cable plan (rule from 2026-09-20): every wire lives in an extrusion slot or a printed channel, none crosses a path that an instrument, drawer, sled or box moves through, and the channels are part of the prints even though the lighting is built last.**

| Run | Route | Printed provision |
|---|---|---|
| USB 5 V lead, Addtam → board *(rev 3)* | the Addtam's top-end port → down the strip's right-hand edge (behind the frame, in the open) → the board holder on the rear base rail's rear face | none — the one exposed wire; ~550 |
| Sill bundle, board → sill block *(rev 3: 5 wires — 5 V, GND, data to the pixel, data back, switch)* | holder's left hole → rear base rail's **REAR slot** (cover B1) → under the rail at x 23–28 → **rear-left upright's inner slot** up to z 78 (under the strip) → **left PSU rail's inner slot** (cover A, y 45–305, hopping the connectors at the ends) → up 10 into the block's bottom | the block's pixel slots and wire channel are open to its bottom; covers A and B1 |
| Left strip feed *(rev 3: bus 1 — 5 V, GND from the board; data = the pixel's data OUT coming back down the sill bundle's route)* | holder's left hole → rear slot (B1) → under the rail → up the rear-left upright's inner slot to the strip's input at its BOTTOM (z 20); the strip is stuck over that slot, so the sill bundle above z 20 runs under it | none beyond the covers |
| Right strip feed *(rev 3: bus 2 — 5 V, GND, data from the board)* | holder's right hole → rear base rail's **REAR slot** (cover B2, x 150–336) → under the rail at x 333–338 → **rear-right upright's inner slot** up to the strip's input at its BOTTOM (z 20) | cover B2 (the 2026-10-11 finding stands: nothing runs behind the sill panel) |
| Halo pixel + button | inside the left end block | block has the pixel pocket behind the halo |
| IEC leads ×3 | Addtam (rear-left, sockets to the wall) up the rear-left corner behind the instruments to each IEC (bottom-left of every instrument, i.e. rear-left in the frame) | rear-left corner is dead space; no channel, no crossings |
| Scope mains + LAN/USB | sled cable channel (D6), loop behind the frame | exists |
| AWG/PSU LAN/USB | down the rear-right upright (open item 4) | rear-right cable clips (Stage 8), kept within y 330–350 so the box exit path (y 195–330) stays clear |

Kept clear by rule: the bottom-drawer housing top (the USB lead was going to lie on it — moved to the slot), the AWG rails' inner slots, the sled band 331–346, the box exit lane to the right. Slot cables lay in from the side, so they don't constrain the frame assembly order; only the runner and cradle T-nuts do (2.1). **Depth check (2026-09-22, from the P8 cover profile):** a cover that finishes flush in the 5.9 mouth takes 2.95 of the slot's 6.15 depth (1.75 of lip + a 1.2 flare behind it), leaving **3.2 mm** under it. The 3-core data runs fit easily; the USB-A pigtail must be ≤ 3 mm OD or that cover stands proud — check the lead before buying. P8's TPU plate gains a 60 mm slot-cover coupon.

**Sled-foot assembly constraint (terse):** the T-feet enter the scope rails' side slots from the rail end. Once a rail is bolted between the uprights, both ends are blocked. So: feet onto the rails first, then bolt those two rails in. Beam bottom 337 vs AWG top 336 is 1 mm — set the scope-rail height with the 63.5 spacer, not a tape.

Bed-fit audit for every printed part is in §8. **Print-orientation rules and the design-for-print review of every production part are in `PRINT-RULES.md`** — read it before modelling any part; every export runs `src/printcheck.py`.

---

## 1. Stage 0 — before the hardware arrives

Done when: D1–D7 ticked, coupon STLs sliced, spacer set printed.

| Done | Step | Output |
|---|---|---|
| ☑ | 0.1a Order the 300 mm 4-pack (D1). | ordered 2026-09-15 |
| ☑ | 0.1b D4, D5, D7 confirmed from `bench-stack-3d.html`; `drawer-quarters-v1.pdf` approved pending P7. | §0 all ☑ |
| ☑ | 0.2 Create `src/fit.py` — one module holding every tuned clearance (table in §3), imported by every part script. Coupons exist to set these numbers; production parts read them. | `src/fit.py` |
| ☑ | 0.3 Model the coupons in CadQuery (all eight scripts ☑ — ticked 2026-09-27), one script each under `src/coupons/`: **`p1_sled_foot.py` ☑** (v3 2026-09-19: T-nut flange from the measured slot; v2: web at x 22.2, closed beam groove; from `src/parts/sled_foot.py`, STLs in `coupons/p1/`), **`p3_runner.py` ☑** (2026-09-19: L-runner into the base rail's top slot + drawer-wall groove stub, from `src/parts/drawer_runner.py`, STLs in `coupons/p3/`), **`p4_clip_tile.py` ☑** (2026-09-20: spring-finger clip from `src/parts/slot_clip.py`, STLs in `coupons/p4/`), **`p5_hinge_magnet.py` ☑** (2026-09-22: three-segment butt hinge, printed pins and magnet bosses, STLs in `coupons/p5/`), **`p6_pull.py` ☑** (`coupons/p6/`), **`p7_quarter_joint.py` ☑** (cropped from `src/parts/drawer_quarters.py`, STLs in `coupons/p7/`), **`p8_tpu.py` ☑** (2026-09-22: spigot sweep, foot, AWG pad, slot covers, stop caps, STLs in `coupons/p8/`), **`p9_bumper_cup.py` ☑** (`coupons/p9/`). P2 is `psu_cradle.py` already. Each coupon is a literal section of the production part, in the production orientation, not a generic block. | STLs in `coupons/pN/` |
| ☑ | 0.4 Print the rail-height spacer set, any PETG: **48** (base top 20 → PSU rail 68), **139.5** (88 → 227.5), **63.5** (247.5 → 311), **159** (331 → 490), two of each, plus the 3.0 mm web gauge — `coupons/spacers/spacers-plate.stl`, flat as laid out, 2 walls, 10 % infill (`src/coupons/spacers.py`). | 9 small prints |
| ☑ | 0.5 Fix HANDOVER open item 3: `layout_gen.py` scope rails 318–338 → 311–331, regenerate page 1. **Already done in v15** (checked 2026-09-27: `layout_gen.py` has `SCOPE_RAIL = (311, 331)` and page 1 of `bench-stack-layout-v15.pdf` prints 311–331) — HANDOVER's open item 3 was stale. The sheet's side-panel notes (3 ASA tiles per side) predate D4 and P4 and are superseded by `bench-stack-3d.html`; regenerate only at Stage 9 close-out. | `bench-stack-layout-v15.pdf` stands |
| ☑ | 0.6 Slice coupon plates (§3): A = black ASA, B/C = yellow PETG, D = blue TPU. All sliced and printed as they were needed (`bambu/`); D (TPU) rides in the single Stage 8 TPU session by rule, so nothing is left to slice here. | `.3mf` in `bambu/` |

---

## 2. Stage 1 — cut and coupon

Done when: every row in §3 is PASS and its number is in `fit.py`.

**Cut sheet — by jig setting** (`CUT-TABLE.md` is the same sheet for the workshop). Tape-label the 1000s A–H and the 300s W–Z, the labelled end never goes to the stop (feed the fresh end against it, so the label stays on the remainder), set the jig once per step and cut every bar listed before moving on. Every finished piece is the one between the stop and the blade; the remainder is stock for the next step, never a finished piece (it is short by the kerf). Kerf is allowed for.

**Accuracy:** ±0.5 mm on every length is fine and ±1 mm is survivable — the frame's critical dimensions are the rail heights, and those come from the printed spacers at assembly, not from the cuts. What does matter: (1) pieces of one length must match each other (within ~0.3) — cutting a whole set on one jig setting gives you that for free; (2) ends square to the bar, because a crooked end seats the hidden connector crooked and racks the frame; (3) err short, never long — a 510 at 509 costs 1 mm of reveal over the scope, at 511 it fouls the shelf plan; 179.5 can be 179. Nothing here needs 0.5 mm measured.

| Done | Step | Jig | Cut from | Cuts | Pieces made | Bar left after |
|---|---|---|---|---|---|---|
| ☑ | 1 | 200 | W | 1 | 1 × 200 — coupon rail (P2, P3, P8) | W ≈ 98 |
| ☑ | 2 | 179.5 | X, Y | 1 each | 2 × 179.5 — inner uprights | X, Y ≈ 118 |
| ☑ | 3 | 70 | W, X, Y | 1 each | 3 × 70 — ties | scrap |
| ☑ | — | — | Z | none | 1 × 300 whole — coupon rail (P1, P4) | — |
| ☑ | 4 | 510 | A, B, C, D | 1 each | 4 × 510 — uprights | A–D ≈ 488 |
| ☑ | 5 | 321 | A, B | 1 each | 2 × 321 — rear cross rails | scrap |
| ☑ | 6 | 310 | C, D (1 each), E, F (3 each), G (2) | 10 | 10 × 310 — side rails | G ≈ 376, rest scrap |
| ☑ | 7 | 307 | G (1), H (3) | 4 | 4 × 307 — inner sub-frame rails (**the design uses two** — PSU-level and AWG-level inner rails; the other two are spare, noted 2026-09-27) | scrap |

Check: 510 × 4, 321 × 2, 310 × 10, 307 × 4, 179.5 × 2, 70 × 3. Deburr every end as you go; the T-foot and clips will find any burr. Bundle each length with tape, length written on it.

**Coupon plates.**

| Done | Plate | Material | Parts |
|---|---|---|---|
| ☑ | A | black ASA (production material — these are sliding pairs, friction and shrink matter) | P1 `coupons/p1/foot-40.stl` (T-foot + web + rib, prints standing; v3 T-nut flange) + `beam-40.stl` (grooved stub, prints flat) — `p1-plate.stl` has both; yellow PETG is fine for the fit test, confirm in ASA before the 210 feet · **P3 `coupons/p3/runner-80.stl`** leg-top down, counterbore opens onto the bed (Bridge counterbore holes → Sacrificial layer, as the cradles) |
| ☑ | B | **yellow PETG** (house rule from 2026-09-17: every test and prototype part is yellow PETG unless the test depends on the production material) | **P3 `coupons/p3/stub-100.stl`** (outer wall + 10 × 20 boss + groove, floor down) · **P4 `coupons/p4/p4-plate.stl`** (two 60 × 60 solid tiles, b06 / b09, face down) · **P5 `coupons/p5/p5-plate.stl`** (2026-09-22, `src/coupons/p5_hinge_magnet.py`), 104 × 25 × 35, 7.5 cm³, standing as exported: knuckle-door + knuckle-frame (barrel Ø8 on a 5 × 18 pad, bore 3.2, three 10 mm segments, 0.4 axial; a floating segment end is coned 45° right in to the bore, so there is no annulus to support), pins Ø3.0 / 2.9 on snap-off discs, magnet-boss ×2 · **P9 `coupons/p9/p9-plate.stl`** (cup pad + stand-pocket pad, flat) · P7 (done — printed in black PETG before the rule) |
| ☑ | C | yellow PETG | **P6 `coupons/p6/pull-60.stl` face down + `facia-80.stl` standing** (D9) — geometry test, colour irrelevant. **Printed and PASSED 2026-09-20** (slot 12); box closed 2026-09-22. |
| ☑ | D | blue TPU | **Printed in the Stage 8 session 2026-10-16 — P8 ☑ (feet hold at 4.6, covers at 7.4). Not a standalone coupon print any more** — TPU is one session at Stage 8 (rule below); this plate's parts ride in it. **`coupons/p8/p8-plate.stl`** (2026-09-22, `src/coupons/p8_tpu.py`), 201 × 60 × 14, 14.8 cm³, flat as exported, no brim: **spigots-sweep** (prints FIRST, on its own) 4.2 / 4.6 / 5.0 / 5.4 stamped (the only value P8 owns; the 2020 centre bore has never been on calipers) · **foot-24** 24 × 24 × 6 with an 8 mm spigot at 4.6, pad-down as it sits on the bench · **awg-pad** 20 × 20 × 5.5 for the 20.4 × 1.5 cradle pocket, rear pattern (outer + rear lips, 2 wide × 2 proud) · **slot-cover-60** ×2 at head 6.0 / 6.3 in the 5.9 mouth, printed head-up so the retaining step faces the lip · **stop-cap** ×2 (10 × 5 × 4 cavity pad, CA to the T-nut's face before it enters the rail) — proves all the TPU parts in one go |

Iterate width/clearance in 0.1 mm steps; re-print only the failing coupon. Budget three rounds for P1 and P4, one for the rest. **Plate A closed 2026-09-22:** P1 passed in black ABS+ (the spool actually reserved for the sliding pairs, not ASA) and P3's ASA `runner-80` is superseded — its friction verdict moved to the 300 mm ABS+ runners on the frame at Stage 4.1, which is a production print, not a coupon. **Plate C closed 2026-09-22:** P6 passed. **No duplicate test pieces (rule from 2026-09-22, PRINT-RULES 10–11):** a coupon plate carries one of each variant and never two of the same, and every variant is stamped with its value.

**Print settings — X1C, coupons and every fit-critical part (PETG; ASA the same except temperatures).**

| Setting | PETG | Why it matters here |
|---|---|---|
| Filament | dried first: 65 °C, 6–8 h (dryer or AMS with fresh desiccant) | wet PETG strings and blobs on the tab flanks — reads as "binds" |
| Calibration | Bambu Studio → Calibration → Flow Dynamics, then Flow Rate, for the exact spool; Bambu-branded spools: Lidar auto is enough | over-extrusion closes every 0.15 clearance |
| Process profile | 0.20 mm Standard @BBL X1C, first layer 0.20 | 3 mm floor = 15 layers exactly |
| Precise Z height | ON (Precise wall is built in on current Bambu Studio — no toggle) | dimensional accuracy of walls and tab widths |
| X-Y contour / hole compensation | 0 / 0 | clearance is tuned in `fit.py`, not in the slicer |
| Walls / top / bottom | 4 / 5 / 4 | HANDOVER spec; coupons the same as production |
| Infill | 40 % gyroid (spacers: 10 %, 2 walls) | |
| Nozzle / bed / fans | from the filament preset (Bambu PETG Basic or Generic PETG; Generic ASA/ABS), textured PEI, no glue | |
| Fans (check in the filament preset) | PETG: aux 0 %, part ≤ 50 % | aux fan on PETG chills the wall and hurts layer bond |
| Outer wall speed | 80 mm/s max (inner 150) | accuracy on the tab flanks |
| Brim / skirt | PETG: No-brim, skirt loops 1. **ABS+ profile: outer brim only, 5 mm, gap 0.1 (set 2026-09-24 — stays on for every ABS+ part: the feet, runners and guide strips are long thin bars that lift without it)** | brim on a tab flank fakes the fit — trim it off any tab or dovetail flank before assembly; outer-only keeps it out of grooves and pockets |
| Seam | Back / Aligned, scarf ON | keeps the seam blob off the joints |
| Supports | enabled (house rule), tree(auto), threshold 30°, **On build plate only** ticked | fit surfaces never get support residue; a part that shows internal support in the preview is a design fault, not a slicer setting |
| Ironing | off | |
| Elephant-foot compensation | 0.15 (default) | first layer of every tab is a fit surface |

ASA/ABS: filament preset, door closed, everything else as above. Saved in Bambu Studio as process profile `SiglentTower fit 0.20`.

**TPU prints once, last (rule from 2026-09-22, restated 2026-09-24; PRINT-RULES rule 12):** every TPU part in the build on one session at Stage 8, as few plates as possible, nothing TPU before that — the changeover and drying cost more than the parts.

**Black spools — two, not one (rule from 2026-09-20).** One black **ABS+** spool is reserved for the sliding pairs and the long thin parts that must stay straight; everything else black prints in plain **ABS**. Every production plate in §5 says which; if a plate note doesn't say, ask before slicing. Dry either spool before a sliding-pair print.

| Spool | Parts | Why |
|---|---|---|
| **ABS+ (sliding / straight)** | sled T-feet ×2 (slide in the scope rails' slots), sled beams ×2 split (thread onto the feet's ribs; 327 long), bottom-drawer runners ×2 (300, the drawer slides on them), column guide strips ×4, mini-slot runner ×1 | moving pair or a long thin bar — lowest warp, one spool so every pair shrinks alike; confirm each `fit.py` value with a short ABS+ coupon before the full-length part (the coupons so far are yellow PETG) |
| **ABS (everything else black)** | cradles (PSU ×4 done, AWG ×4), rear cross bars ×2, cable channel, sled stops, strip brackets ×2, probe hanger, hinge knuckles ×2, magnet bosses ×2, L-bracket, light-bar end clips, rear-right cable clips | fixed parts; warp and friction don't matter |
| not black | fronts, sled front bar, rear box → dark grey PETG; pull inserts, logo inlay → blue PETG; caps → blue; feet, AWG pads, stop caps → blue TPU; tiles, drawer bodies, housing tops → black PETG | HANDOVER §8 |

**TPU is one session, at the end (rule from 2026-09-22).** TPU has to be dried and hand-fed past the AMS, so every blue TPU part in the project prints in a single run at Stage 8: feet ×4, AWG pads ×4, sled-stop caps ×2 and the slot covers (~1.3 m). Nothing upstream is gated by that: P8's only downstream parts are TPU themselves, the AWG sits on temporary blocks until its pads exist (2.7), and the covers and feet are Stage 8 trim anyway. The one thing that must not be guessed is `SPIGOT_D`, so the run is **two plates inside one session** — `coupons/p8/spigots-sweep.stl` alone first (6 cm³, ~20 min), tested against an offcut's bore while the bed is still hot, then `SPIGOT_D` set, the feet re-exported, and the production plate printed on the same spool without unloading. Slot covers print then as ~220 mm strips on the diagonal, not the 60 mm coupon length.

**Status 2026-09-22 (later):** **P5 v1 FAILED and the door hinge is re-designed — see D11.** The v1 knuckles' bore sat on the pads' mid-thickness, so the leaves could not fold and the two bores ended up one pad-thickness apart; the pin would not pass. Root cause: the coupon was a generic block, against §0.3. v2 is cut straight from the production parts — `src/parts/door_hinge.py` → `parts/hinge-door-v1.stl` and `parts/hinge-frame-v1.stl` (two of each, both symmetric about their mid-length), coupon plate `coupons/p5/p5-v2-plate.stl` (one of each, 39 × 34 × 24, 8.7 cm³, yellow PETG, standing as exported), check sheet `coupons/p5/p5-v2-plan.png`. Segments are 6 / 12 / 6 along the 24 (door outer, frame middle, 0.4 apart) because the frame leaf's riser needs a long enough middle third to climb 8 mm at 45°. Both parts pass `printcheck.py` with no flat down-facing area. The v1 pins and magnet bosses are unaffected and still stand.

**Status 2026-09-22 (yellow run):** one plate, **`coupons/yellow-run/yellow-run-2026-09-22.stl`** — 197 × 164 × 30, 73 cm³, yellow PETG, everything as exported, no support. It carries the P5 v2 hinge pair, the **first real side tiles** (`src/parts/side_tile.py` → `coupons/p4/tile-band1-155.stl` full band-1 tile + `tile-band2-crop.stl`, 60 of band 2, so the pair shares the PSU rail's slot) and the **strip brackets** (`src/parts/strip_bracket.py` → `parts/strip-bracket-{upper,lower}-v1.stl`, D8). Check sheet `coupons/yellow-run/yellow-run-plan.png`. Two findings came out of modelling the tiles:

1. **Band heights are not the viewer's, and §8's audit is wrong.** The viewer draws tiles between the rails (20–68, 88–227.5, 247.5–311, 347–490) and the bed-fit audit copied those. But `slot_clip.py` — the geometry P4 passed — puts each tile's edge ON the rail's slot centreline, with the two tiles that meet there sharing the slot. A tile stopping at the rail's inner face would need 10 mm of reach to get a barb in; the finger straddles its edge by 2.25. So tiles run **centreline to centreline and cover the rails**: band 1 = 68, band 2 = 159.5, band 3 = 83.5, band 4 = 153. D4's 155-long split is unaffected; §8 is corrected below.
2. **`slot_clip.py`'s own assertion contradicts the value P4 passed.** It asserted `PEG_CLR > CLIP_BARB`, which is a rigid-peg model; P4 v2 variant C passed on the bench at barb 1.2 with PEG_CLR 0.7 because the finger springs and the 45° hook walks in. Nobody re-ran the module after `CLIP_BARB` went to 1.2, so it has been failing on import. Relaxed to a warning — but it is the honest reason a 155 mm tile with five fingers takes real force to push on, and that force is what the tile coupon is really testing.

**Tile clip layout — corrected 2026-09-22 (Gareth spotted it on the plate).** v1 put three fingers on band 1's shared edge and two on band 2's, staggering only the pegs. That is not enough: `slot_clip.py`'s finger strip runs the finger's whole 30 mm and dips 2.25 past the centreline into the neighbour, so two tiles sharing a slot must not have their fingers overlap in **y at all**. v1's did, and its neighbour notches were cut before its own fingers and then re-filled by them, so the relief was not there either. v2: **two fingers per tile per shared edge**, interleaved — band 1 at y 6 and 84, band 2 at 43 and 121, giving a minimum 7 mm of clear slot between anything the two tiles put in it. Band 1's lower edge sits on the base rail with no partner, so it keeps three. `side_tile.tile()` now adds an edge's fingers first and cuts its notches last, and asserts the two never overlap. Verified by solid intersection: the assembled pair clashes by 0.0000 cm³. The coupon plate puts the two SHARED edges facing each other so the interleave reads at a glance.

**Open (band 4):** the sled band 331–346 is left open, so a band-4 tile's BOTTOM edge has no rail to clip to — it can only hang from the top rail at 500. On the right side that band is the door and the fixed rear tile, held by the hinge and the magnets, so this only bites on the LEFT side. Not solved; band 4 is not modelled.

---

## 3. Gates

| Done | Coupon | Pass when | Sets in `fit.py` | Gates (nothing here prints until PASS) | Start value |
|---|---|---|---|---|---|
| ☑ | **P1** sled foot + web | Foot slides in the inner side slot of a 2020 offcut by hand, no rock, can't lift out; web passes the 3.0 gauge; beam stub threads onto the rib from the end, no lift, side play < 0.3; beam underside 6.0 ± 0.3 above the rail's top face. | `SLOT_CLR` (neck and flange), `WEB_T`, `WEB_RIB_CLR` | Sled feet ×2, beams ×2, front bar, cross bars ×2, cable channel — the whole of §10.1 | slot measured 2026-09-19: mouth 5.9, lip 1.75, cavity 10.6, throat at 4.45, bottom 6.5 at 6.15 → neck 5.5, T-nut flange 10.2 (v3). **v3 result: enters from the end, no rock, but a little tight — and it is the sled's moving part, so it must slide freely; rib/beam pair PASS** (slides, rotational play unloaded is the 0.2 rib clearance and vanishes once the two beams are tied by the bars and the scope loads the 45° flank). v4 `coupons/p1/p1-feet-v4.stl`: three feet, length = clearance — 40 mm 0.3, 45 mm 0.4, 50 mm 0.5 (SLOT_CLR = FLANGE_GAP). **v4 result 2026-09-20: the 40 mm foot (0.3) slides best** → `SLOT_CLR` = `FLANGE_GAP` 0.3. Slot fit and rib/beam both done in PETG; P1 ticks after a 40 mm foot in the ABS+ spool confirms 0.5 in the production material (rule 6), then the 210 pair. **PASSED 2026-09-21: 40 mm foot in black ABS+ at 0.3 slides the length of bar Z's inner slot, can't lift out, minor rock (accepted — the pair is tied by the bars and loaded).** Releases the 210 feet. |
| ☑ | **P2** PSU cradle | Saddle flat on the rail, foot seats in cup, M5×10 into T-nut pulls down, counterbore intact. **v2 (2026-09-17): saddle, bolts, counterbore PASS; cup FAIL** — printed Ø21.6 against a foot that is Ø16.8 at the pad, 19.5 at 4 mm up, 21.5 at the flange — 2 mm of slop. v3: conical cup matching the foot taper; coupon rounds A (0.5/0.6/0.7 net: all loose) and B (0.1/−0.1/−0.3 net: 0.1 best) set the cup at floor Ø17.0 / rim Ø19.7 with no shrink allowance, 1 mm 45° lead-in; self-centres. | `RAIL_CLR` ☑ 0.4, `CUP_CLR` ☑ 0.1 (cone, no shrink), `PSU_FOOT_PAD_D` 16.8, `PSU_FOOT_D4` 19.5 | PSU cradles ×3 more, AWG cradles ×4 (same saddle/clamp) | **PASSED 2026-09-17** — v3 perfect fit, sits on the rail perfectly. Releases PSU cradles ×3 and the AWG cradles. |
| ☑ | **P3** drawer runner | Runner bolted to the 200 coupon rail through the **top** slot (M5×10 + T-nut), rib over the side face; stub slides the runner's full length by hand, side play < 0.5, no stick-slip dry or with PTFE, no support in the preview. | `RUNNER_CLR` | Bottom-drawer runners, column guide strips ×4, mini-slot runner, all three drawer bodies | 0.3 — runner: L on the rail top (leg x 3–22.7, z 20–30, three M5 counterbores), 2.7 plate down the inner face, 7 mm rib z 6–20 with a 45° top; drawer: 10 × 20 boss on each outer wall, groove flank at the floor top (rests on the rib), back 7.3, 45° roof to 17.3. Modelled 2026-09-19 (`coupons/p3/p3-section.png`). **Coupon result 2026-09-20 (yellow on yellow): geometry PASS** — little rock, slides full length; sticks in places, attributed to a warped runner that one bolt can't straighten. One-sided stub lifts off the rib by design: capture comes from the pair (the two 45° roofs bear on the two rib slopes like a dovetail, lift stops at 0.3). **Friction verdict deferred to Stage 4.1**: 300 ABS runners on four bolts pulled flat to the base rails, ironing on the rib's top surface, PTFE. `RUNNER_CLR` stays 0.3. **PASSED 2026-10-01: both 300 ABS+ runners on four M5 each in the base rails, the dry-fitted drawer fits and slides well → `RUNNER_CLR` 0.3 final.** Releases the column guide strips ×4, the mini-slot runner and the column + mini-slot drawers. |
| ☑ | **P4** slot-clip tile | Tile's finger edge on the slot centreline, flat on the rail face, body extending away from the barb side; snaps in by thumb, no rock, comes off only with a blade against a finger's free end, 10 cycles no cracks. | `CLIP_T`, `CLIP_BARB` | All 16 side pieces, door tile, 4 top tiles, ~~6 housing-top tiles~~ (dropped, D14) | 3 mm PETG, barb 0.6 — **v1 modelled 2026-09-20** (`coupons/p4/p4-plate.stl`, yellow PETG face down): the spring is a 25 × 5.5 finger cut free from the tile by a 1 mm U-slit, bending in the tile plane (~10 N, 0.8 % strain); a 5.1 × 6 peg on its free end with a 60° barb hooks the lip. **v1 (60 × 60, b06 / b09) FAIL 2026-09-20: both very loose** — nothing located the tile along the slot width, and the hook sat 0.2 off the lip. **v2 `coupons/p4/p4-v2-plate.stl`**: four 66 × 14 strips (3.5 cm³ each — coupons test the joint, nothing else), each finger now has a rigid 6 mm root stub filling the mouth for lateral location, hook on the lip, barb 0.9: **A** stub 5.7 · **B** stub 5.5 · **C** barb 1.2 with a 45° hook (the '+2 mm' reach, the most that fits under the throat) · **D** 7 mm finger (2× snap force). **PASSED 2026-09-20: C** — barb 1.2, 45° hook, root stub 5.7 → `CLIP_BARB` 1.2, `CLIP_HOOK_DEG` 45, `CLIP_STUB_CLR` 0.1. Tiles share each rail's slot, edges on the centreline, upper tile hooks the upper lip, fingers staggered, neighbour notched. Releases all 16 side tiles, the door, the housing-top tiles; top tiles with P5. |
| ☑ | **P5** hinge + magnet | Pin pushes in, knuckle swings free through 180, magnet CA-glues flush in 10.4 × 2.2, pair pulls apart cleanly at 0.5 gap. | `PIN_HOLE_D`, `MAG_POCKET` | Door knuckles ×2 + frame knuckles ×2 (`parts/hinge-{door,frame}-v1.stl`), magnet bosses ×2, L-bracket, rear-tile tab | 3.2, 10.4 × 2.2. **v1 FAILED 2026-09-22** — bore on the pads' mid-thickness, so the leaves could not fold and the bores sat a pad-thickness apart; a generic block, against §0.3. **v2 2026-09-22 is the production pair** (`src/parts/door_hinge.py`, D11): axis x 369 / z 341, barrel Ø8, bore 3.2, segments 6 / 12 / 6 at 0.4, floating segment ends coned 45° to the bore, frame riser and door shelf ramped 45°, M5 hole a teardrop. Plate `coupons/p5/p5-v2-plate.stl` — one of each, test with a v1 pin. **PASSED 2026-09-27: the 2.9 pin passes both leaves (3.0 binds), no bind through the swing, folds a little past 180 as designed → `PIN_D` 2.9.** The tested pair is a build; print the second pair (`parts/hinge-{door,frame}-v1.stl`) with the door tile. Magnet bosses still to be tried when the magnets are in hand. |
| ☑ | **P6** pull insert | **PASSED 2026-09-20: slot 12** (v1 fit passed at 10, too small for a thick finger; v2 tried 12 and 14 — 12 best). `JPULL_OPEN_H` 12. 14 is the ceiling — the pocket's back wall is a bridge in the face-down print (11.2 at 14, 13.2 at 16; rule 4 caps bridges at 12). Production inserts in the blue PETG of the logo inlay (HANDOVER §8), so the face-down texture reads as intended. | `JPULL_OPEN_H` (v2 winner); `JPULL_INSERT_CLR` ☑ 0.15 | Three drawer fronts + inserts, sled front bar + insert | slot 10 → 12/14, hook 5, pocket 17, floor 30°, insert clr 0.15 |
| ☑ | **P7** quarter joint | Centre cross, wall crossing and beam pair all assemble by hand, hold without glue, faces flush within 0.2. | `DOVETAIL_CLR` ☑ 0.15 | Bottom drawer quarters ×4 (D2), split beams (D6), rear box halves | **PASSED 2026-09-17** at 0.15 — cross, wall crossing and beam pair all good |
| ☑ | **P8** TPU foot | Spigot holds in the 2020 centre bore (nominal ~4.2, spec says 5 — expect to trim to ~4.6), foot sits flat, no wobble. **PASSED 2026-10-16: the TPU plate's four feet at 4.6 push into the uprights and hold (glued in); the 7.4 covers stay in the slots → `SPIGOT_D` 4.6.** | `SPIGOT_D` ☑ 4.6 | Feet ×4, AWG pads ×4, sled-stop caps ×2, slot covers (~1.3 m) | 5.0 — **v1 modelled 2026-09-22** (`coupons/p8/p8-plate.stl`, blue TPU, flat): spigots at 4.2 / 4.6 / 5.0 / 5.4 stamped on one strip. Push each into a 2020 offcut's bore — winner goes in by thumb, holds the frame's weight, comes out with a twist → `SPIGOT_D`. **Sequencing (2026-09-22):** the sweep strip prints on its own at the head of the single TPU session and is tested there; the rest of the TPU follows on one plate once `SPIGOT_D` is set. |
| ☑ | **P9** bumper cup + stand pocket | **v1 cup FAIL (2026-09-19): Ø32.6 sized on the handover's Ø32, which the bumper never is.** Calipers (width = scope width): pad patch 20 × 9.5, at 5 mm up 25.9 × 24.0, at the chassis 25.9 × 26.4, ~14 tall — a D (flat one side, half-round the other, along the depth) with a bullnosed bottom 5 mm. v2 `coupons/p9/p9-cups-v2.stl`: six **straight-walled** D cups 25.9 × 24 + net −0.1 / +0.1 / +0.3 / +0.5 / +0.7 / +1.0, 5 straight + 1 mm 45° lead-in (6 deep, 3 mm floor), value stamped by each — the cup can only locate the bumper at its 5 mm section, so no lead-in inside that height. **v2 result: only +1.0 fitted; flat faces the REAR.** The foot's shoulders are fuller than a semicircle. v3 `coupons/p9/p9-cups-v3.stl`: straight sides 13 from the flat (was 11.05) and a flatter three-point arc to the same 24 depth, one row of six at +0.1 / +0.3 / +0.5 / +0.7 / +1.0 / +1.3. **PASSED 2026-09-19 at +0.3** (perfect fit) → `BUMPER_CUP_CLR` 0.3 with `BUMPER_SIDE_L` 13. **Stand pad v2 PASSED 2026-09-20** — main leg sits perfectly in the 44.6 × 23.7 × 2.5 pocket. P9 complete: releases the sled beams' cups and pockets. **Stand pocket v1: width 44.6 PASS, length FAIL** — 43.6 was the stand's overall, but the folded flap tucks under the main leg and never reaches a 2.5 pocket; the main leg is 23.1 front-to-back. v2 `coupons/p9/stand-pad-v2.stl`: 44.6 × 23.7 × 2.5 (on `p9-v2-plate.stl` with the cups). Pass: main leg sits flat in it, no rock. For the beam: still need where the 23.1 sits within the stand's 43 (front or rear end) relative to the scope's front face. | `BUMPER_CUP_CLR` ☑ 0.3, `BUMPER_W/D5/SIDE_L/FLAT` measured, `STAND_W` ☑ 44, `STAND_L` 23.1, `STAND_CLR`, `STAND_POCKET_D` | Sled beams (cups ×2, stand pockets ×2) | 0.3 / 0.3 / 2.5 |

Dependency chains: P1 + P7 + P9 + P6 → sled complete. P2 → all 12 cradles. P3 + P6 + P7 + P4 → drawers. P4 + P5 → skin. P8 → trim.

---

## 4. Stage 2 — frame (parallel with Stage 1)

Done when: PSU and AWG sit in the frame on temporary blocks at the right heights and the sled feet are on the scope rails.

**Assembly viewer: `frame-assembly-3d.html`** (`src/frame_assembly_viewer.py`, 2026-09-27/28) — step slider, layout-sheet names, spacers and feet shown where they are used. Sequence used there (revised the same evening — the connectors only enter a slot from an end, so a rail cannot be added between two fixed uprights): **each side is built flat on the bench with all FIVE of its rails at once — scope rail included, its 210 foot already in the inner slot** (uprights 321 apart, 4 connectors per upright pushed down the inner-face slot to z ≈ 20 / 88 / 247 / 490, the base, PSU, AWG, scope and top rails laid between and the uprights closed onto them; base and top flush with the upright ends, PSU on the 48 spacers, AWG on the 139.5, scope on the 63.5 with a cast bracket under each end, diagonals). 2.6's 'scope rails last' rule existed only so the feet could go in before the ends closed; the flat build does that anyway, and a rail cannot be added between fixed uprights later. Feet stay loose in the rails; the beams thread onto them from the rear (they pass inboard of the rear uprights) and are glued in place. → right side the same → stand both and join with the two rear cross rails (2 connectors for the rear ties pre-loaded in the rear-right upright's front-face slot first) → inner sub-frame built the same way as a ladder, ties on, slid in from the front, cast bracket on the front tie → rack test → stop. 2.1–2.6 below are therefore done per side, not per level.

**T-nuts first if they are the slide-in type** (every rail's four slots are closed at both ends once it sits between the uprights; the uprights' own slots stay open at the top until the caps go on at Stage 8): each base rail TOP slot 6 (four for its runner, two spare for the drawer stop); each PSU rail TOP slot 4 (two cradles × two) and BOTTOM slot 2 (cast brackets at the ends); left AWG rail TOP slot 4 (two cradles × two); right AWG rail TOP slot 2 spare; inner AWG-level rail LEFT-face slot 4 (right AWG cradle brackets) and TOP slot 3 (mini-slot runner); right PSU rail, right AWG rail INNER-face slots and both inner rails' RIGHT-face slots 3 each (column guide strips, not yet modelled); each scope rail: BOTTOM slot 2 (cast brackets) and, right rail only, OUTER slot 2 later (hinge frame leaves). Drop-in (spring / twist) nuts need none of this — **Gareth's are drop-in (confirmed 2026-09-27), so the counts above are only a shopping tally; nuts go in as each part is fitted.**

**Hidden L-connectors** (one per joint, their own grub screws) go on the faces that look INTO the frame, where the two members' slots are coplanar and open the same way: side rails ↔ uprights on the inner faces (x 20 / x 341); rear cross rails ↔ rear uprights on the front faces (y 330); inner rails ↔ inner uprights on the RIGHT faces (x 271 — the left face carries the right AWG cradle brackets at y 20–60, so their guide strips run y 45–305); the front tie ↔ its inner upright on the rear faces (y 23); rear ties on their front faces into the rear-right upright's front face. Never the outer faces (tile fingers live in the rails' outer slots). **Gareth's hidden L-connectors enter a slot only from its end (confirmed 2026-09-27)**, so an upright's slot is closed once rails sit at both its ends, so pre-load: 2 per outer upright in the inner-face slot (PSU, AWG) from the top before the top rail goes on; 2 in the rear-right upright's front-face slot (the rear ties) before the top cross rail's connector. Scope rails take no hidden connectors (cast brackets). **Two joints cannot take one:** the scope rails (sled feet run the inner slot end to end, fingers the outer) and the front tie's outer end (the tie sits 3 mm behind the front upright, so no faces line up). **Cast brackets (8 in hand):** 4 UNDER the scope rails (rail bottom slot ↔ upright face, x 3–17 so the drawer and tiles stay clear); 1 lying flat between the front tie's rear face and the right PSU rail's inner face at y 23–43, z 68–88 (so the column guide strip on that face starts at y ≥ 45); 3 spare — add under the PSU rails if a wobble test asks for it (rear ends first: the front ends' top faces are under the cradle saddles, and a bracket under the rail must stay at x 0–20 to clear the drawer). **Bolts:** M5×8 for every cast bracket (bracket ~4 thick → 4 into the T-nut, the HANDOVER's spec); M5×10 for every printed part on a T-nut (cradles, runners, strip brackets — counterbored, proven at P2). Stage 8 note: the USB lead's slot route (left PSU rail inner slot → rear-left upright inner slot) crosses hidden L-connectors at the rail end and at z 68–86 / 227–245 on the upright — it hops over them on the face; allow for that when the covers are cut.

- [x] 2.1 Base: two base side rails + rear cross rail + four uprights, hidden L-connectors, square on the bench (diagonals equal within 1 mm), 321 clear width — front as well as rear, since the front has no cross rail.
- [x] 2.2 Top: top side rails + rear cross rail. Check 510 overall.
- [x] 2.3 PSU rails at 68 using the 48 spacers (stood on the base rail, rail sat on them, connectors tightened, spacers out) — done within each side's flat build; hidden L-connectors on the inner faces, no cast brackets unless the rack test asks.
- [x] 2.4 Inner sub-frame: PSU-level inner rail and AWG-level inner rail between the two inner uprights (rails at the uprights' ends → a 347 × 247.5 ladder), the three 70 ties bolted on (PSU-level front, PSU-level rear, AWG-level rear), slid in from the front; a 48 spacer under the rear inner upright on the base rear cross rail sets z 68, the ties' tops flush with the right PSU rail's top (z 88) set the rest; rear ties on hidden L-connectors, the front tie on a flat cast bracket to the right PSU rail's inner face.
- [x] 2.5 AWG rails at 227.5 using the 139.5 spacers — done within each side's flat build.
- [x] 2.6 Scope rails **in the flat side build with the others** (revised 2026-09-28), a sled T-foot already in each inner side slot; set at 311 using the 63.5 spacers; **cast brackets only, under both ends** (no hidden L: the feet own the inner slot). The beam clearance check (3.0 gauge against a 336 reference) moves to when the beams are threaded on from the rear. Check the beam clearance with the 3.0 gauge against a 336 reference before tightening.
- [x] 2.7 Place PSU and AWG on blocks at 91 and 251.5; check 3 mm reveals, screen-edge alignment, PSU fan clear, AWG side vents uncovered.

Joint count is 42; 40 hidden connectors + 8 cast brackets is enough only if two of the doubled joints are cast-only. Check on the bench.

---

## 5. Stages 3–7 — production printing

Order follows the handover: cradles → drawers → sled → box and channel → skin → trim. Each stage lists its gates; a stage may start modelling before its gates pass but not printing.

| Done | Stage | Gates | Parts | Done when |
|---|---|---|---|---|
| ☑ | **3 Cradles** | P2 ☑ | PSU cradle ×4 **☑ printed 2026-09-19** (`parts/psu-cradle-v3.stl`, black ABS). **AWG cradles modelled 2026-09-20** (`src/parts/awg_cradle.py`): **left ×2** `parts/awg-cradle-left-v1.stl` — PSU-style saddle on the left AWG rail, inboard lip widened to 0.5 off the body (lateral stop), 8 mm arm flush with the rail top, 20.4 × 20.4 × 1.5 pad pocket; prints **standing on its end** as exported. **Right ×2** `parts/awg-cradle-right-v1.stl` — the inner AWG rail's top is the mini slot's, so this is a 10 mm plate on that rail's left face with two horizontal counterbored M5 into the side slot and the same arm reaching 37.5 left; prints arm-top down as exported, tree support on build plate only fills the pocket (as the PSU cups). **Black ABS, brim.** **All four printed 2026-09-21 (v1, black ABS).** Corner lips moved to the TPU pads (P8): 20 × 20 × 5.5, outer lip on all four, rear lip on the rear pair; front stop is the bezel against the front arms. **2026-10-02: seated — PSU right cradles v4 and AWG cradles v2 released (arms 5, right plate 4 countersunk) after the three clashes proved real; see the status line.** Check the bezel is < 17 deep before fitting (front cradles start at y 20/23). **Confirmed done 2026-10-16.** | PSU and AWG sit level, 3 mm behind the front plane, screens' left edges aligned, no rock. |
| ☑ | **4 Drawers** | P3, P6, P7, P4 | Bottom runners ×2 (300, **black ABS+**, **four** M5 into the base rails' top slots — the bolts straighten the print — ironing on, ~~stop block behind the drawer~~ (D15); **v1 released 2026-09-30** `parts/drawer/drawer-runner-300-v1.stl`, print it twice) → **test on the frame with the P3 stub, then the drawer: this is where P3's stick-slip verdict is taken — PASSED 2026-10-01, fits and slides well** → bottom drawer quarters ×4 (D2, **v1 released 2026-09-28, all four printed by 2026-09-30** `parts/drawer/drawer-Q1..Q4-v1.stl`, black PETG, one per plate; assemble per the sheet, no glue) → runner test → CA the wall dovetails → column drawer (285, D5; **v1 + four guide strips released 2026-10-04**, `parts/column/`) → mini slot (285 with the vent neck, D7) → three fronts (on edge, D3; **bottom facia + insert v1 released 2026-10-02, column facia + insert v1 2026-10-09**) → ~~housing-top tiles ×6~~ (dropped, D14) → column guide strips ×4 and mini-slot runner **(ABS+)**, ~~rear stops~~ (dropped, D15) | All three run full travel, each drawer comes out cleanly (☑ 2026-10-16 — bottom and column pull clear off the ribs, the mini unbolts with its runner; HANDOVER's "lift-to-remove" is retired, P3's groove cannot lift), fronts flush with the uprights, logo inlay reads. **Thermal check (D7):** AWG on for 1 h in the assembled stack, slot in, side tiles on; exhaust temperature and fan note compared with the AWG alone on the open bench. Fallback if it runs noticeably hotter: reprint the slot at 85 deep (ends 5 mm before the vent); nothing else changes. |
| ☑ | **5 Sled** | P1, P7, P9, P6 | **ABS+:** feet ×2 (layers along the slide; `parts/sled-foot-210.stl`, **released 2026-09-21**) → beams (split, D6) with arms, cups, pads **(ABS+)** — **v1 modelled 2026-09-21, released 2026-09-24** (feet positioned by the P9 jigs), four halves flat as exported; assembly: CA the halves at the P7 tab, thread the foot's rib in from the rear until it stops, bond, then foot into the loose scope rail from its end (2.6) → front bar (grey PETG, **v1 released 2026-09-28**) → cross bars with guide lips (**v1 released 2026-09-28**), cable channel, stops **(ABS)** (T-nut behind foot; T-nut + TPU cap at front) | Scope rides level, 100 travel, sag ≤ 1 mm out, stops hold, beam clears the AWG frame along the whole travel. |
| ☑ | **6 Box + channel** | P7 | Box halves (dovetailed), 20 lip, guide-lip engagement on the cross bars — **v1 released 2026-10-03** (`parts/rear-box-{left,right}-v1.stl`, grey PETG, one per plate); cable channel wedge tabs | Full access sequence works: pull sled 100 → fold door (skin not yet on: check the box exits right into the clear zone) → slide box out → reverse. Meters fit. |
| ☑ | **7 Skin** | P4, P5 | 14 side tiles (155 long, heights 68 / 159.5 / 83.5 / 153 — `src/parts/side_tile.py` v1 2026-09-22; **v2 2026-10-14 at the measured heights (left 71.2 / 155 / 85.5, right 65.4 / 159.5 / 85.8) with saddle notches — plates A2–E2;** band 1's pair on the yellow run proves the hex pattern, the finger stagger and the neighbour notch before any black tile prints; **all 12 band 1–3 tiles printed, plates A–F, by 2026-09-28**) → door + knuckles (door ×2 + frame ×2, D11; the frame leaf's M5 shares the right scope rail's outer slot with the tile clips — check the clip positions against y 23–47 and y 223–247 when the tiles are modelled) + magnet bosses + L-bracket → fixed rear tile with tab → ~~top tiles ×4 + H-spline~~ **top panel: four standing tiles + caps, v1 released 2026-10-14 (D12)** | Door swings 180 and catches; every tile snaps in; sled band 331–346 open; nothing fouls the sled or the box exit. |
| ☑ | **8 Trim** | P8 | **One TPU session covers every blue TPU part in the build**: `spigots-sweep` first, then feet ×4, AWG pads ×4, stop caps ×2 and ~1.3 m of slot cover (as ~220 mm strips) on one plate. Then blue caps ×4, probe hanger, strip brackets ×2 in the rear-left upright's rear slot per D8 (**modelled 2026-09-22, both proven on the strip 2026-09-27**: `src/parts/strip_bracket.py` → `parts/strip-bracket-upper-v1.stl` + `parts/strip-bracket-lower-v4.stl`, yellow PETG, both printed — mount upper bolt at z 344.5, lower at z 95; plate 4 → 5 mm so the M5's Ø10 counterbore leaves 2.5 under the head, which puts the strip at frame y 355–385, and the lower bracket's shelf gets a 45° gusset — it is a cantilever in use and an 80 × 4 wall standing 30 in the print wants bracing) (open item 1 closed 2026-09-17 — Addtam strip measured: keyholes 249.5 c-c, large hole Ø6.5, slot 3.5, nearest keyhole centre 20 from the cable end, keyhole pocket 6.5 deep, keyhole line 29.2 from one edge of the 78.1 body; bracket = 20 × 40 × 4 plate on the upright's rear face (one M5 into the rear slot) with a 4 mm arm inboard to the peg at x 30.2, peg shaft Ø3.2 × 3, head Ø6.0 × 2.5 with a 45° cone under it; the lower bracket adds a 79 × 30 × 4 shelf at z 21–25 with a 10 mm cable notch; both print plate-face down with peg and shelf rising), stop caps, rear-right cable clips (**confirm AWG/PSU LAN/USB positions first — open item 4**), sill panel + two end blocks + translucent button cap per D10 rev 2 (WS2812B strips on the rear uprights, XIAO + WLED in the left block, USB from the Addtam) | Strip mounted, three IEC leads routed, LAN/USB down the rear-right, scope loop absorbs 100 travel, probes hang clear of the door. |

---

## 6. Files issued with this roadmap

`bench-stack-3d.html` — the one viewer, edited in place; history is in git (the v18 → v19 → v20 patch scripts that applied D2–D7 live in the git history, not the tree). **As built since 2026-11-05** (HANDOVER v19 §3). `bench-stack-layout-v16.pdf/.svg` — the as-built layout sheet (`src/layout_gen.py`; v15 was the design sheet). `drawer-quarters-v1.pdf/.svg` — D2 joint sheet (`src/drawer_quarters_gen.py`).

## 7. Stage 9 — close-out

- [x] HANDOVER → v19 ☑ 2026-11-03: the as-built record — every value from ROADMAP v2.35 / `fit.py`, the parts index with the withdrawn files, coupon results P1–P9, decisions D1–D15, the sheet index.
- [x] Regenerate the viewer and layout from the final dimensions (`layout_gen.py`, `viewer_boxes.json`) — ☑ 2026-11-05: `bench-stack-3d.html` as built, `bench-stack-layout-v16.pdf`.
- [x] Every final STL lives in `parts/` with its script in `src/parts/`, named `<part>-v<N>.stl` matching the script version (coupons stay in `coupons/`) — ☑ 2026-11-05: `parts/` holds the fitted set per HANDOVER §10 (the superseded files are in git history; the print plates stay as printed).
- [x] **One Bambu Studio project for the whole build** (Gareth, 2026-09-28) — **☑ 2026-11-05: `publish/SiglentTower-complete.3mf`, 36 plates, 117 objects, generated by `src/publish_3mf.py` from the fitted STLs (plate list and the settings that are not in the file in `publish/PLATES.md`, the layouts in `publish/plates-sheet.png`); opened in Bambu Studio 2026-11-06 — the plates read correctly; two fixes from that first open (plate names without `/` or `:`, parts kept out of the X1C's 18 × 28 exclusion corner) and Gareth's rule: **one material per plate, no purge tower** — only the two objects that are two-colour by design share a plate between filaments (the facia with its logo inlay, the sill panel with its clear window). **Bambu Studio 2.9.1 allows 36 plates at most — a 37th crashes it on load (found 2026-11-07, bisected with a one-plate file); the mini-slot runner shares the lower-strips plate so the count stays at 36, and the script refuses more. Opened, arranged and saved in Studio 2026-11-07 — "bingo, it works"; skirt loops 0 globally (no per-object option; plate 13 needs it); the saved file is the artefact and the script reproduces its positions.** Original brief: `publish/SiglentTower-complete.3mf` — every part the build needs as one multi-plate project, each plate named `NN <material> <colour> — <parts>` and grouped by filament (black ABS+ sliding parts, black ABS, black PETG, dark grey PETG, blue PETG, blue TPU last), each object named after its STL, `SiglentTower fit 0.20` (ABS+ with the 5 mm outer brim) set on every plate. **The jigs go in it too** (spacer set + 3.0 gauge, P9 position jigs, seating jigs + stand-in AWG pads) on their own plates named `JIG — any colour, any PETG/PLA` — tooling, colour and material don't matter. Coupons stay out (they tuned `fit.py`; a builder doesn't need them). Built from the final STLs in `parts/` and `jigs/`, not from the per-night `bambu/` plates.
- [x] **Full build guide** (Gareth, 2026-09-28) — **☑ 2026-11-08: `docs/BUILD-GUIDE.md`** (chapters 0–14: before you start, shopping list, tools, cutting, printing, the frame, measuring your frame, cradles, drawers, sled and box, skin, trim, lighting, the done-when checklist, symptom → fix; the new sheets `docs/build-guide/frame-flat-side.svg`, `drawer-quarters-order.svg`, `sled-order.svg` from `src/build_guide_sheets.py`). Original brief: one document that takes someone from nothing to the finished stack — shopping list (extrusion, connectors, cast brackets, T-nuts, M5/M3 screws, magnets, pins, power strip, lighting parts) with quantities; tools; the cut sheet; what to print (pointing at the plates in the complete .3mf) and the print settings; then the build in order — frame (Stage 2 flat-side method, spacers), cradles (seating jigs), drawers, sled and box, skin, trim, lighting — each step with a diagram, the jig it uses, the check that says it's right, and the torque/glue notes (CA on every sled tab). Written in plain words, no invented terms. Separate from the write-up below: the guide is how to build it, the write-up is the story of designing it.
- [x] MakerWorld pack — **☑ 2026-11-07: `publish/makerworld/`; published 2026-11-08: https://makerworld.com/en/models/3573243-siglenttower** — `MAKERWORLD.md` (the listing: title, summary, description — leads with "ideas, not a kit": the parts fit the frame as it was cut and assembled, so expect to re-measure and re-export; the print notes with the thin-part warping fix, materials, hardware, cut list, build order, how it was designed and Claude's part in it, links), `UPLOAD.md` (which file goes in which box, gallery order, captions; slice all plates in Studio first), six photos as JPG, six diagrams, `make-stl-zip.cmd` for the optional STL zip; **the access-sequence clip** (2026-11-08: `video/access-sequence.mp4`, silent, 16 s, with a poster frame; `docs/photos/access-sequence.gif` on the README). The final STLs are `parts/`; the complete .3mf is the one above, saved from Bambu Studio 2.9.1 with Gareth's plate arrangement (skirt loops 0 — plate 13's column drawer has no room for one); `publish_3mf.py` reproduces that arrangement.
- [x] **Write-up** (after everything above) — **☑ 2026-11-09: live at https://garethcooke.com/siglenttower/build** (the portfolio's sixth write-up page, rendering `docs/WRITE-UP.md`, tracked by its manifest at commit 449b0b6; Gareth's edit folded in). Draft 2026-11-08: `docs/WRITE-UP.md` (3,700 words, first person, with `docs/access-sequence.svg` — the three-frame access strip from `src/access_strip.py` — plus the as-built layout, the quarter-joint sheet and the photos; awaiting Gareth's edit, then the garethcooke.com page per the portfolio's write-up conventions). Original brief: a finished build story, not a spec — the bench constraints and why an extrusion frame, the level stack, the three focal points (the scope sled and rear box access sequence; the four-quarter drawer joint; the vent-channel slot), the coupon-first method and what each coupon changed, the print rules that came out of it, and the finished result with photos. Diagrams drawn to the point (front and side elevations with the levels, the sled/box access sequence as a three-frame strip, the quarter-drawer joint exploded), the interactive `bench-stack-3d.html` embedded or linked, and the MakerWorld and repo links. Long-form, one page for garethcooke.com; the MakerWorld description is a cut-down of it. Owner: Claude, draft for Gareth's edit.

**Bambu project files.** Save Bambu Studio projects (File → Save project, `.3mf`) under `bambu/<stage>/<plate>.3mf` — e.g. `bambu/coupons/p7-plate.3mf`, later `bambu/03-cradles/psu-cradles.3mf`. Commit the project file, not the sliced `.gcode.3mf`. The STL + CadQuery script stay the source of truth; the .3mf is the build artefact that carries plate layout and the `SiglentTower fit 0.20` profile, and it is what MakerWorld takes as a print profile.

---

## 8. Bed-fit audit (256 × 256; diagonal fits if (L + W)/√2 ≤ 250)

| Part | Footprint | Fits | Route |
|---|---|---|---|
| Bottom drawer body | 315 × 300 | no | D2: four quarters 157.5 × 150 |
| Bottom facia | 315 × 86 | no flat / 284 diag | D3: on edge, diag 233 |
| Bottom housing top | 315 × 300 | no | ~~four loose tiles 157.5 × 150~~ dropped (D14) |
| Bottom runners | 300 × 10 | diag 219 | diagonal |
| PSU / AWG cradles | < 100 | flat | — |
| Column drawer | 64 × 285 | 247 diag | D5: 285 → 247 diag, 240 tall |
| Column facia | 245 × 65 | flat | on edge to match D3 |
| Column guide strips | 260 × 40 (lower) / 26 (upper) | diag 212 / 202 | diagonal, rail face down |
| Mini slot | 285 × 26 (83 tall) | diag 220 | D7: diagonal, flat |
| Housing top, column + slot | 96 × 300 | 280 diag | ~~two tiles 96 × 150~~ dropped (D14) |
| Sled T-feet | 210 × 10.6 | flat | — |
| Sled beams + arms | 327 × 42 | 261 diag | D6: split (P7) |
| Cable channel (separate) | 194 × 26 | flat | — |
| Front bar | 315 × 18 | diag 235 | diagonal, on edge (D3) |
| Rear cross bars | 321 × 23 | diag 243 | diagonal |
| Rear box halves | 145.5 × 135 | flat | as designed |
| Side tiles, all bands | 310 × 68 / 159.5 / 83.5 / 153 | all > 250 diag | D4: 155 long. **Heights corrected 2026-09-22** — the old 48…143 were the gaps between rails; tiles run centreline to centreline and cover the rails (`src/parts/side_tile.py`). Band 1 tile 155 × 68 is 22 cm³. |
| Door | 230 × 143 | flat | face-down |
| Fixed rear tile | 80 × 143 | flat | — |
| Top panel | 362 × 350 | no | D12: four 185.5 × 180 tiles STANDING (3 × 185.5 footprint each), all four on one plate |
| Feet, caps, hanger, brackets, knuckles, bosses | small | flat | — |

Rough filament, ±30 %: black PETG ~1.2 kg (tiles, top, drawer bodies, housing tiles), dark grey PETG ~0.4 kg (fronts, box, bar), black ASA ~0.6 kg (cradles, sled, feet, brackets), TPU and blue PETG < 150 g between them.
