GarethCooke/SiglentTower/CUT-TABLE.md

# Cut sheet — 2020 extrusion, ordered by jig setting

Before cutting: tape-label the eight 1000s **A–H** and the four 300s **W, X, Y, Z**. The label goes at one end and that end never goes to the stop: always feed the unlabelled (freshly sawn) end against the stop, so the label stays on the remainder. Set the jig once per row, cut every bar listed, then move on. Every finished piece is the one between the stop and the blade; the remainder is stock for the next step, never a finished piece (it is short by the kerf). Kerf is allowed for: every remainder has slack.

**Accuracy:** ±0.5 mm on every length is fine and ±1 mm is survivable — the frame's critical dimensions are the rail heights, and those come from the printed spacers at assembly, not from the cuts. What does matter: (1) pieces of one length must match each other (within ~0.3) — cutting a whole set on one jig setting gives you that for free; (2) ends square to the bar, because a crooked end seats the hidden connector crooked and racks the frame; (3) err short, never long — a 510 at 509 costs 1 mm of reveal over the scope, at 511 it fouls the shelf plan; 179.5 can be 179. Nothing here needs 0.5 mm measured.

| Step | Jig | Cut from | Cuts | Pieces made | Bar left after |
|---|---|---|---|---|---|
| 1 | 200 | W | 1 | 1 × 200 — coupon rail | W ≈ 98 |
| 2 | 179.5 | X, Y | 1 each | 2 × 179.5 — inner uprights | X, Y ≈ 118 |
| 3 | 70 | W, X, Y | 1 each | 3 × 70 — ties | scrap |
| 4 | 510 | A, B, C, D | 1 each | 4 × 510 — uprights | A–D ≈ 488 |
| 5 | 321 | A, B | 1 each | 2 × 321 — rear cross rails | A, B ≈ 165 (scrap) |
| 6 | 310 | C, D | 1 each | 2 × 310 | C, D ≈ 176 (scrap) |
| 6 | 310 | E, F | 3 each | 6 × 310 | E, F ≈ 64 (scrap) |
| 6 | 310 | G | 2 | 2 × 310 | G ≈ 376 |
| 7 | 307 | G | 1 | 1 × 307 | G ≈ 67 (scrap) |
| 7 | 307 | H | 3 | 3 × 307 | H ≈ 73 (scrap) |

Step 6 is one jig setting: 10 cuts across C, D, E, F, G. Step 7 is one setting: 4 cuts across G, H.

## Totals to end with

| Length | No. | For |
|---|---|---|
| 510 | 4 | uprights |
| 321 | 2 | rear cross rails (base, top) |
| 310 | 10 | side rails |
| 307 | 4 | inner sub-frame rails |
| 179.5 | 2 | inner uprights |
| 70 | 3 | ties to the right rails |
| 200 | 1 | coupon rail (P2, P3, P8) |
| 300 whole | 1 | coupon rail (P1, P4) |

Deburr every end as you go; the T-foot and the tile clips will find any burr. Bundle each length with tape and write the length on it.
