GarethCooke/SiglentTower/bench-stack-layout-v16.pdf

# FRONT ELEVATION — as built

1 unit = 1 mm. Frame 361 in the model, 362 by tape. Instruments as measured on the bench; printed parts in orange.

BOTTOM DRAWER 315 × 60 × 300 — four quarters; facia 3–86; no lid (D14), no stop (D15) sill panel 20–253.4, z 87–99 — button at x 45, two pixels behind the window

## SPD3303X-E

face 225 × 143 at x 20–244.5, hard against the left rail body 220 × 140 × 284.5; feet in the cups at z 92, 150 tall on them

## SDG2082X (bumpers and handle off)

face 214 × 88; body 207 × 82 × 260 on TPU pads at 251.5; 3 mm over the PSU

## SDS1104X-E

315 × 166 (152 body + 14 feet) × 135 — on the sled: cups 341, chassis 355, top 507, pulls out 92

sled front bar 337–355 (pull liner)

tie 70 (front, PSU level)

inner upright 179.5 — at x 253.7, flush (measured)

### COLUMN DRAWER

64 × 240 × 285 on four guide strips (facia 65 × 245)

MINI SLOT 26 × 83 × 285, vent neck (D7)

top panel 362 × 350 × 3 over the whole frame top, z 510–513 — four standing tiles on glued half-laps (D12); caps 513–519, M5 into the uprights' bores hex side tiles ON the rails' outer faces, 3 mm PETG, clipped into the slots ⁽P⁴⁾ | air 9.2
bench | TPU feet 24 × 24 × 6, Ø4.6 spigot glued into the uprights' bores (P8) ×4
361 overall (362 by tape)
321 clear between uprights / rails

315 scope (3 mm each side)

214 AWG face | 5 26 6 | 64 column

225 PSU face, x 20–244.5 (9.2 of air to the sub-frame)

525 overall

60 drawer body

150 PSU on its feet

88 AWG

166 scope

6

5

base rail 0–20

PSU rail 68–88

AWG rail 227.5–247.5

scope rail 311–331

top rail 490–510

z=92 (cup floor)

z=251.5 (pads)

z=341 (cups)

Rail gaps as built, face to face — right 45.4 / 139.5 / 65.8 / 158, left 51.2 / 135 / 65.5 / 157
(spacers 48 / 139.5 / 63.5 / 159). The model keeps the spacer heights; the side tiles were cut to the measured bands, per side.

# SIDE ELEVATION — right side, front at left

Everything inside the frame sits 3 mm behind the front plane; the facias fill the 3 mm, flush with the uprights.

bottom drawer 300 deep on two printed runners; facia 0–3 flush

### PSU 284.5 body, knobs +17; fan exhaust rear

### AWG body 260; face at 3; side vent Ø80 at y 86–166

sled beams 337–346 on T-feet in the rails' inner slots; travel 92

### scope

135 deep | REAR BOX
| 291 × 135 × 110, two halves rides the sled; out to the right through the door

57 vent / plug / cable loop

BM867s on edge + BM22s + leads

plugs ≥50 fan exhaust ≥50 — kept open

HEX SIDE TILES on the rails' outer faces — 14 tiles, 155 long, 3 mm PETG, P4 clips DOOR 230 × 161, z 338–499 — hinge axis x 369 / z 341 (D11), magnets at the top; fixed tile 80 behind it

350 overall depth
310 side rails
3 | 135 | 57 | 135 box
260 | 87

110

# PLAN — front at top

Scope centred; AWG and PSU hard left; column right; interior recessed 3 mm, facias flush. Power strip and lighting board behind the frame.

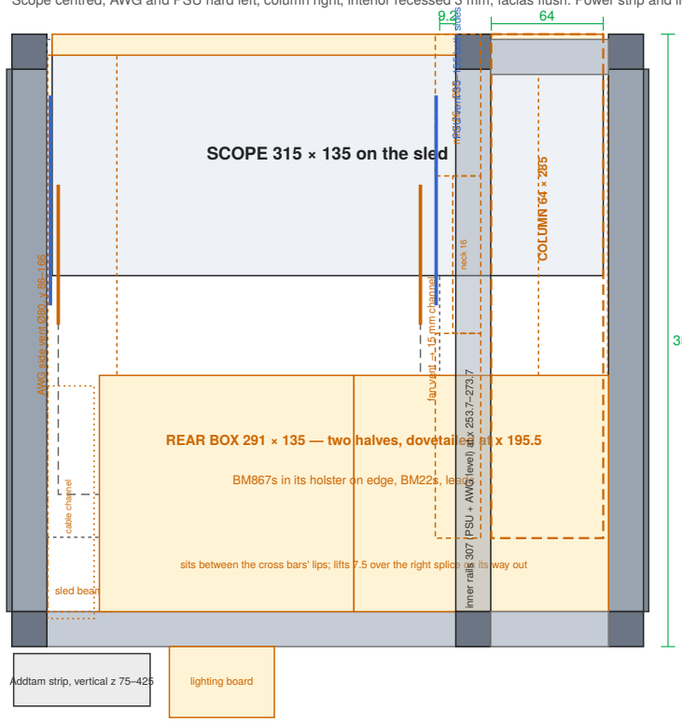
[picture p10: figure]
AWG body 207 × 260; PSU face 225 × 284.5 at x 20–244.5; SCOPE 315 × 135 on the sled; sled beams cable channel; COLUMN 64 × 285; AWG side vent Ø80, y 86–166; fan vent → 15 mm channel; PSU vent 35–155 both sides

REAR BOX 291 × 135 — two halves, dovetailed at x 195.5

BM867s in its holster on edge, BM22s, leads

sits between the cross bars' lips; lifts 7.5 over the right splice on its way out inner rails 307 ⁽PSU ⁺ AWG level) at x 253.7–273.7 mini 26 × 285 neck 16

Addtam strip, vertical z 75–425 lighting board

361 (362 by tape)

350

135

135

9.2 | 64 | 2020 EXTRUSION — AS CUT (CUT-TABLE.md)
Uprights | 4 | 510
Side rails, 5 levels | 10 310
Rear cross rails (base + top) | 2 | 321
Inner rails (PSU + AWG level; 2 used, 2 spare) | 4 | 307
Inner uprights | 2 | 179.5
Ties, inner → right rails | 3 | 70
From | 8 × 1 m + the CNCMANS 300 mm 4-pack (D1)

Joints: 40 hidden L-connectors on the inward faces + 8 cast brackets (4 under the scope rails, 1 at the front tie);
drop-in T-nuts; M5 × 8 for the brackets, M5 × 10 for the printed parts.

# LEVELS AS BUILT (z from the rail bottoms, mm)

Base rails | 0–20 | feet −6–0; bottom drawer body 3–63 on runners in the base rails' top slots
PSU rails | 68–88 | cradle cups floor at 92; PSU on its feet 92–242; sill panel 87–99 under the PSU
AWG rails | 227.5–247.5 5 mm cradle arms + 4 mm TPU pads → AWG body 251.5–333.5, face 248–336
Scope rails | 311–331 | T-feet in the inner slots; beams 337–346, front bar to 355; cups 341, chassis 355, top 507;
box 346–456
Top rails | 490–510 | top panel 510–513 over the whole frame; caps 513–519
Inner sub-frame | 68–247.5 | x 253.7–273.7 (measured), front upright flush; column 274–338, mini slot 242–268

# PRINTED PARTS AS FITTED — 76 designs, 103 pieces (HANDOVER v19 §10)

- Cradles 8: PSU left v3 ×2, right rear v4, right front v5; AWG left v2 ×2, right v2 ×2 — black ABS, seated with the jigs
- Drawers: bottom quarters Q1–Q4 + facia with the logo inlay + pull insert v2 + two 300 runners (ABS+); column drawer +
facia + insert + four guide strips; mini slot body + runner v3 + facia + insert
- Sled: two 210 T-feet, four beam halves (split, D6), front bar v3, cross bars v2, front rests v2, splices v2, cable
channel, pull liner, two TPU stop caps
- Box: two halves (dovetailed) + two corner braces. Skin: 14 side tiles (bands at the measured heights), door v3 + two hinge pairs + pins, fixed rear tile, front bracket, rear tab
- Top: four standing tiles + four caps. Trim: 4 TPU feet, 4 AWG pads, 6 slot covers, 2 strip brackets, sill panel + window +
2 blocks, board enclosure + lid

# AS BUILT — WHERE THE BENCH OVERRULED THE MODEL

- Sub-frame upright at x 253.7, flush with the front (model 251, 3 back) — only the sill panel bridges to it, so only the sill panel changed
- Rail gaps up to 6 mm off the spacers → every side tile cut to its own band per side (left 71.2 / 155 / 85.5, right 65.4 /
159.5 / 85.8)
- PSU feet 155.5 apart and 150 tall on them → right cradles v4 / v5, AWG arms 8 → 5 mm; the PSU sits very slightly skewed (accepted)
- Sled front droops past the foot → front rests on the rail tops and splice bars over the P7 joint; the box lifts 7.5 over
the right splice
- Door edge 347 → 338 (7 over the scope rail); no drawer lids (D14) and no drawer stops (D15); strips 15 LEDs each, not 28; sled travel 92 to the TPU caps
- Not built, by choice: the probe hanger and the rear-right cable clips

bench-stack-layout v16 — AS BUILT — 2026-11-05 — from HANDOVER v19 (v15 of 2026-09-14 was the design sheet; the sled sheet is sled-mechanism-v2.pdf, superseded by parts/sled-*.png)
