GarethCooke/SiglentTower/front-options-A-vs-B.pdf

## A — CENTRED (v2 as drawn)

Racks both sides at AWG and PSU level; all leads in bottom drawer.

DRAWER 315 × 62 × 300

SPD3303X-E

SDG2082X

SDS1104X-E

361

53.5 | 53.5

## B — LEFT-SHIFTED + RIGHT COLUMN

PSU/AWG hard left (3 mm); column drawer on right; left racks gone.

DRAWER 315 × 62 × 300

SPD3303X-E

SDG2082X

SDS1104X-E

COLUMN

87 × 246 × 300

361

14 | 87

## NOTES

- A: symmetric; 53.5 mm rack gap each side of AWG, 50.5 each side of PSU; storage = 5 L drawer + rear tray.
- B: adds a 87 × 246 × 300 column (≈6.4 L) with front access at mid-height; loses all four side racks.
- B: column back must stay open at z 262–325 (AWG right-side vent).
- Both: scope, rear tray, bottom drawer, uprights and rails identical. A→B = reprint 8 cradles + print column.
