GarethCooke/SiglentTower/front-switch-options.pdf

## A — mains rocker in a fixed panel where the mini slot was (slot dropped)

## B — 16 mm ring-lit push button in the front-right upright, PSU height (slot kept)

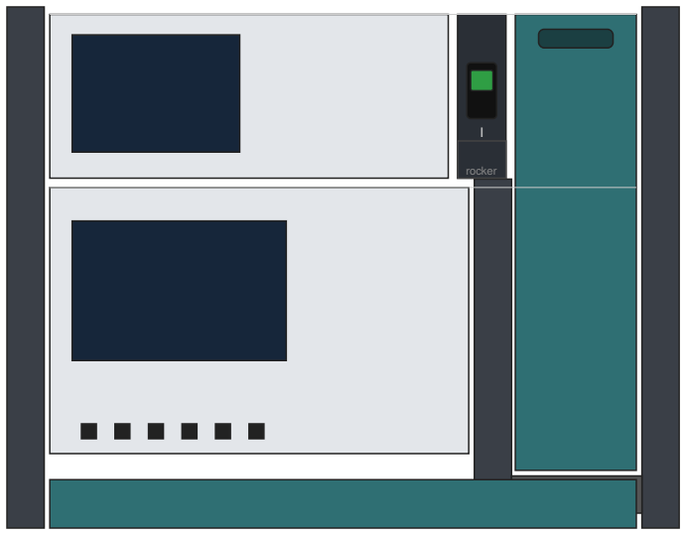
[picture p12: figure]
rocker
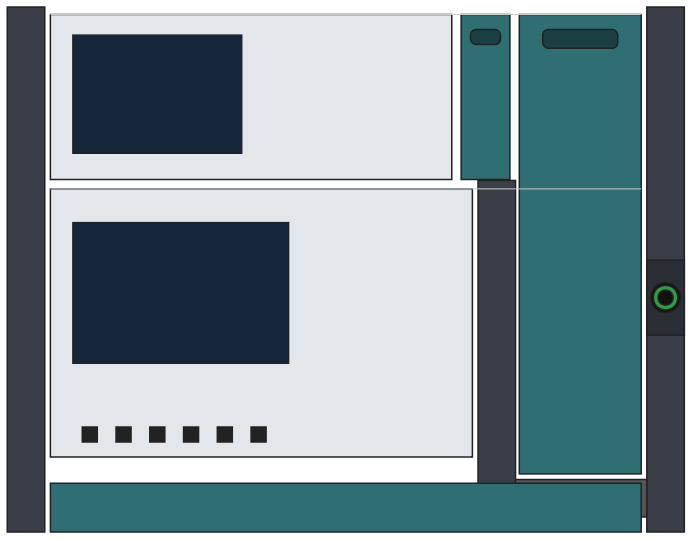
[picture p13: figure]

A: 16 A illuminated rocker (30 × 16), switches the rear strip's live via a 2-core in a printed conduit down the inside of the column housing. Real mains wiring in the stack; earth the frame.
B: 16 mm anti-vandal ring-lit push, latching or momentary. Rated 3–5 A — enough for the stack (~2.6 A at full PSU load) but marginal; better used as a LOW-VOLTAGE input to an ESP32 that drives a smart plug on the strip. No main Either way the strip stays vertical on the rear cross rails; LAN and USB-B run down the rear-right post in slot clips, mains down the rear-left, PSU fan centre kept clear.
