GarethCooke/SiglentTower/sled-mechanism-v2.pdf

## A — SECTION through the left scope rail and sled, looking from the front (×4)

scope rail 2020, z 311–331

front post (behind)

scope feet zone 341–355

scope body

AWG frame top 336 (1 mm under the beam)

foot 3.8 (channel 4)

10.6 | neck 6 (slot 6.2)
web 2.5 | beam 9

beam 40

Load path when pulled out: scope → beam → web (shear) → foot → slot lips (down at the front of the foot, up at the rear). Nothing above the rail top is inside the post's column.

## B — closed (side view, front at left)

### SDS1104X-E

pull-out stop: T-nut + TPU cap at the slot's front end | push-in stop (T-nut in side slot) foot 210, y 120–330

beam 327

C — pulled 100: foot still 20 mm inside the slot; box at y 95–230, clear of the rear 100 mm

### SDS1104X-E

pull-out stop: T-nut + TPU cap at the slot's front end | push-in stop (T-nut in side slot)
100 travel

210 engaged (20–230)

## NOTES

Foot: printed ASA, 10.6 × 3.8 section, 210 long — a drop-in T-nut stretched to a runner. Fit: light sliding; sand the flanks if tight. PTFE dry spray in the channel.
Web: 2.5 mm, in the 3 mm gap between rail and instrument frames; shear only. Beam: 40 × 9, limited by the AWG frame 1 mm below — hence 100 mm travel, not 140 (sag ≈ 1 mm at the front). Right side is the mirror image, riding the right rail's inner side slot. The two sides are joined by the front bar and the two rear cross bars into one sled.
Top slots of the scope rails stay free for the side-tile clips above.
sled mechanism v2 (v18) — 2026-09-15
