GarethCooke/SiglentTower/bench-stack-impression.png

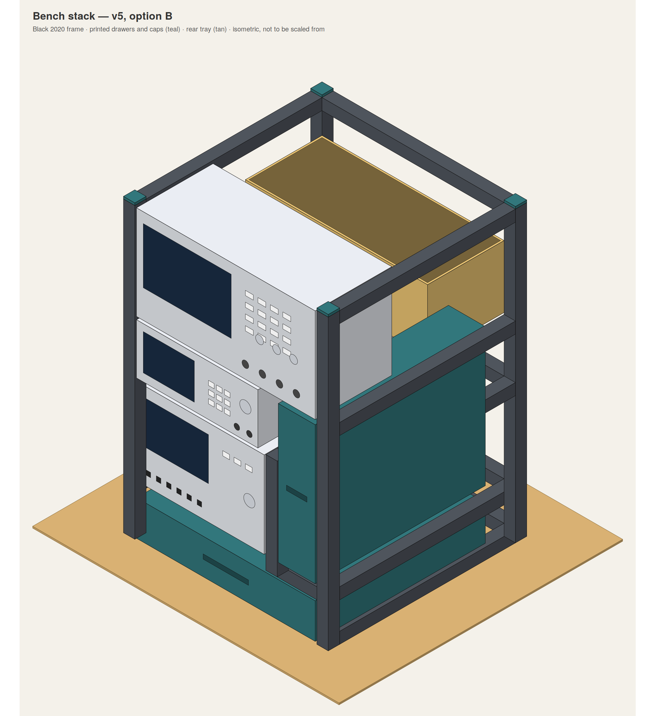
bench-stack-impression.png
