GarethCooke/SiglentTower/coupons/p1/p1-section.png

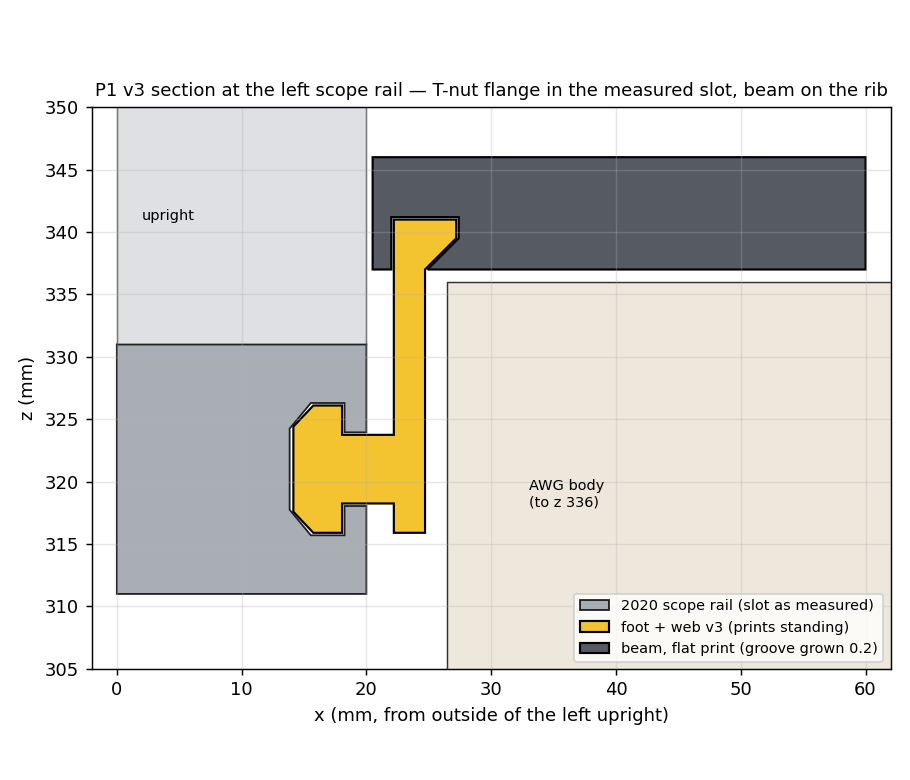
coupons/p1/p1-section.png
