GarethCooke/SiglentTower/coupons/p3/p3-section.png

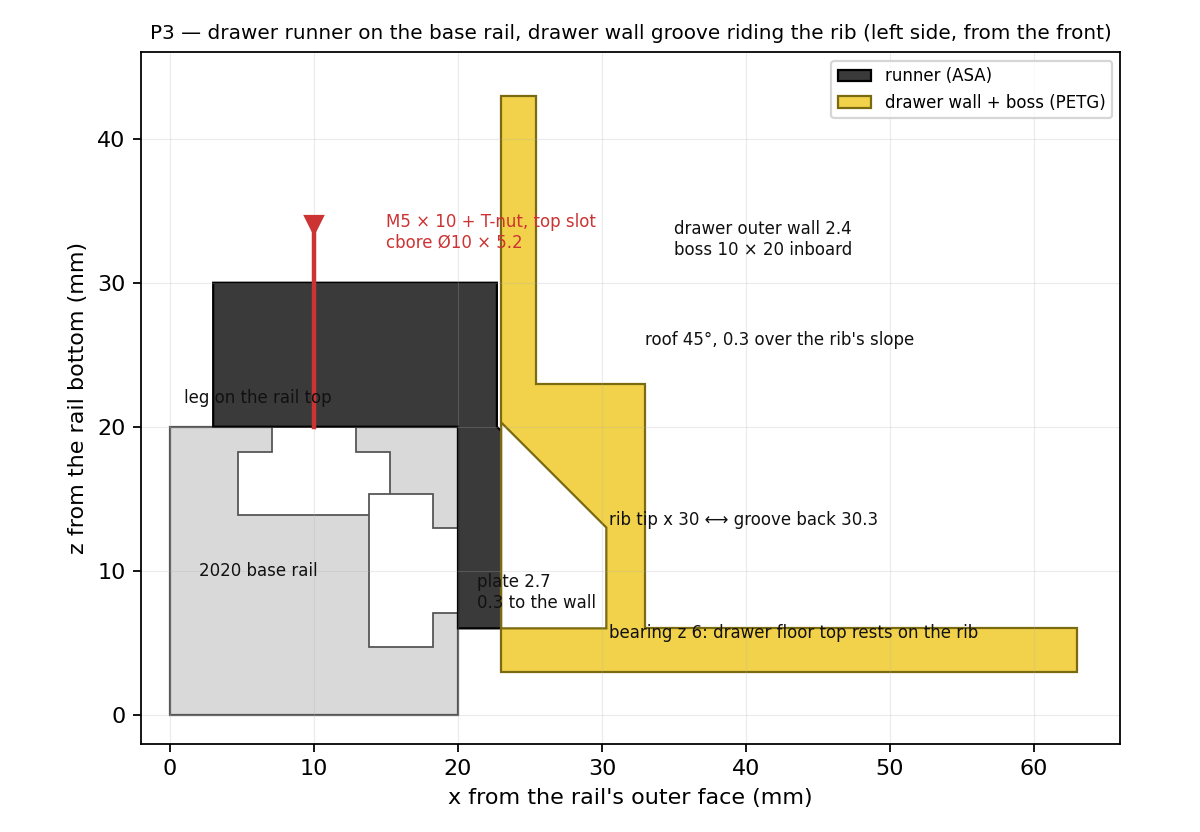
coupons/p3/p3-section.png
