GarethCooke/SiglentTower/coupons/p4/band3-right-sweep.png

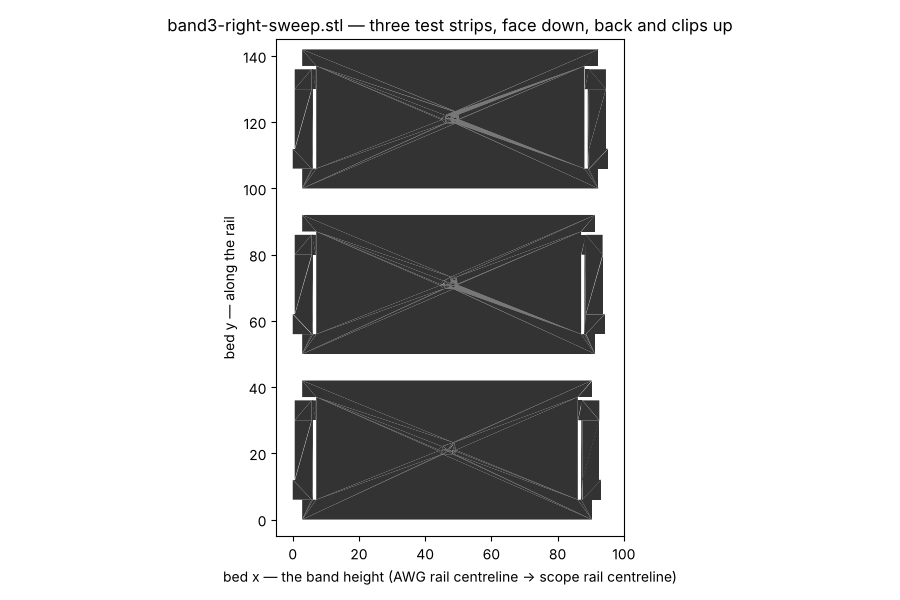
coupons/p4/band3-right-sweep.png
