GarethCooke/SiglentTower/coupons/p4/p4-sections.png

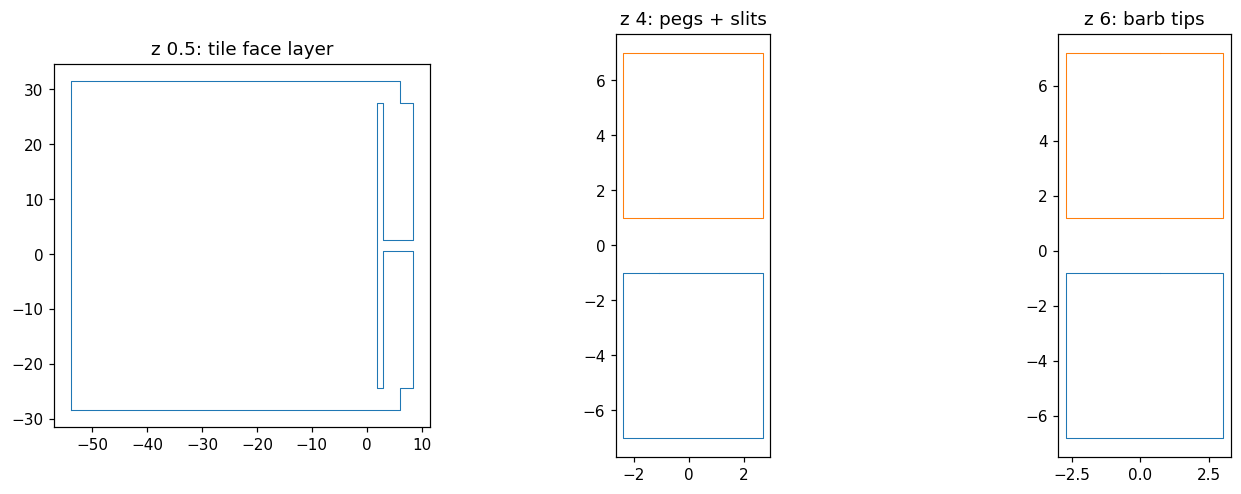
coupons/p4/p4-sections.png
