GarethCooke/SiglentTower/coupons/p5/hinge-section.png

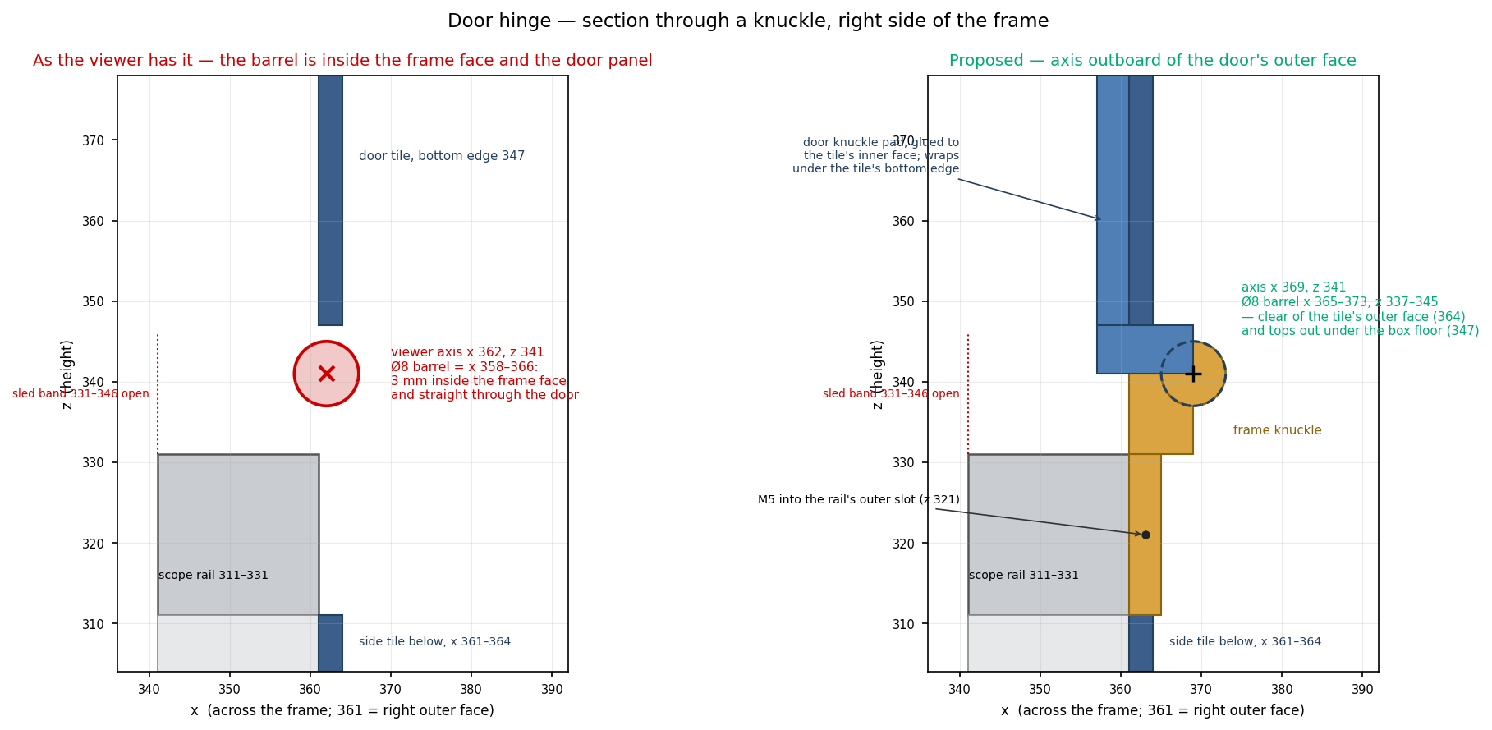
coupons/p5/hinge-section.png
