GarethCooke/SiglentTower/coupons/p5/p5-plan.png

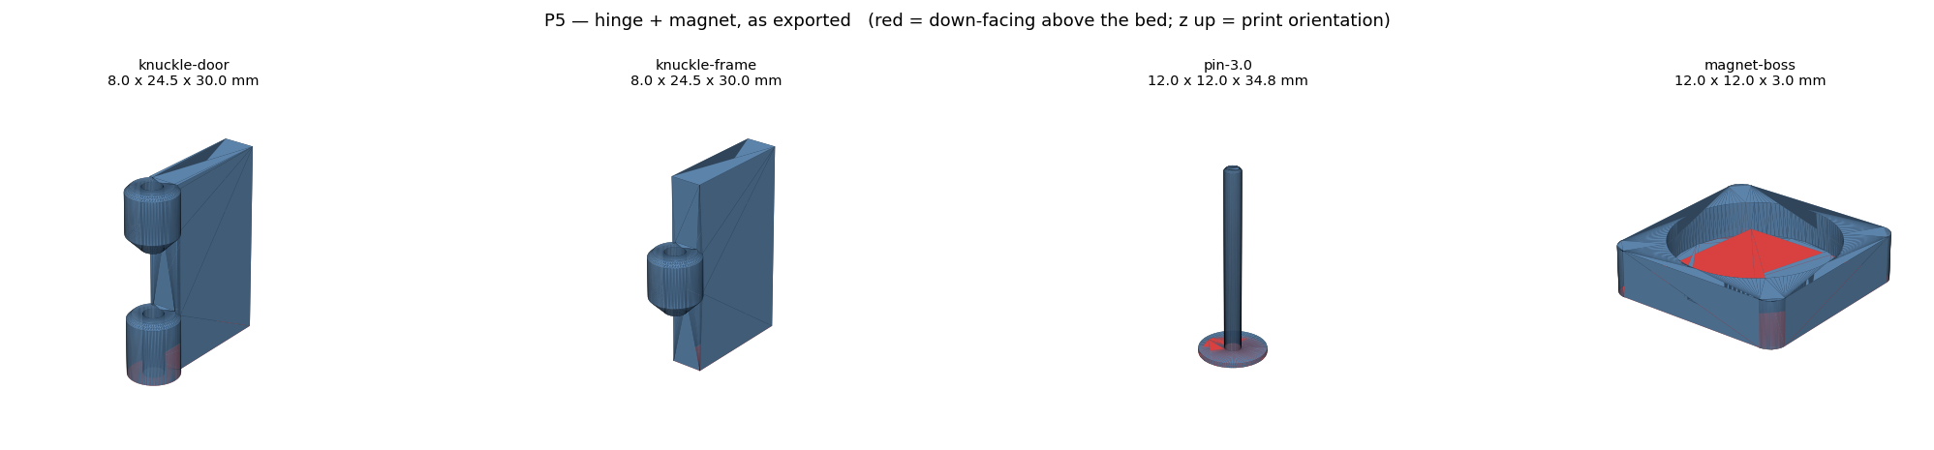
coupons/p5/p5-plan.png
