GarethCooke/SiglentTower/coupons/p5/p5-v2-plan.png

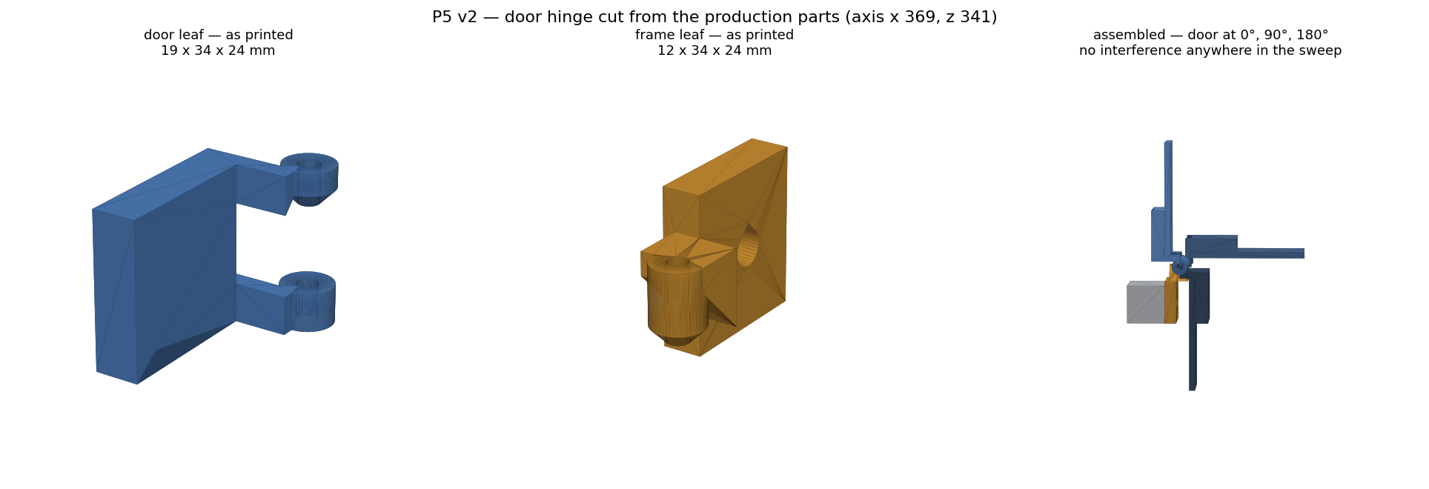
coupons/p5/p5-v2-plan.png
