GarethCooke/SiglentTower/coupons/p6/p6-section.png

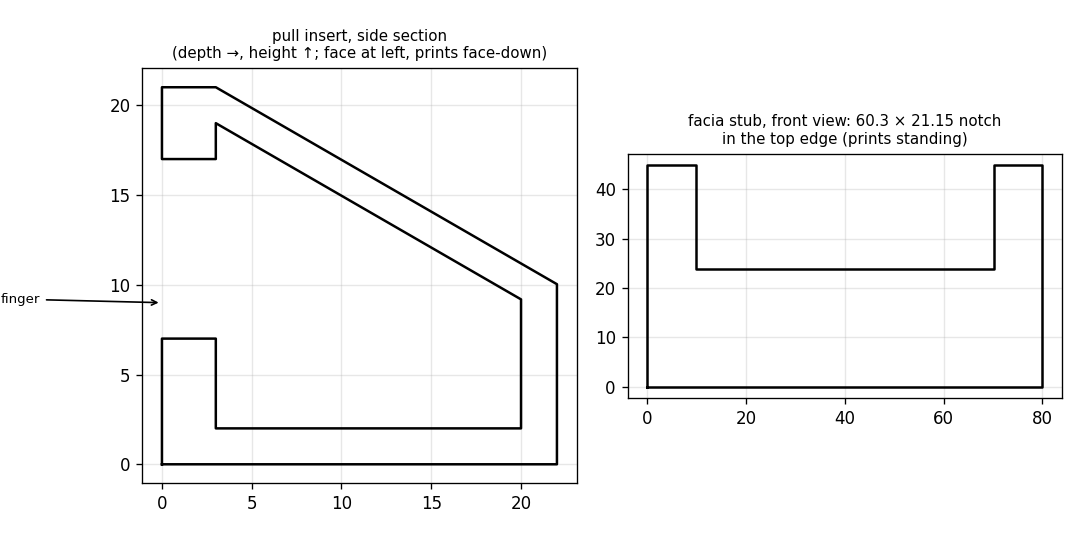
coupons/p6/p6-section.png
