GarethCooke/SiglentTower/coupons/p8/p8-plan.png

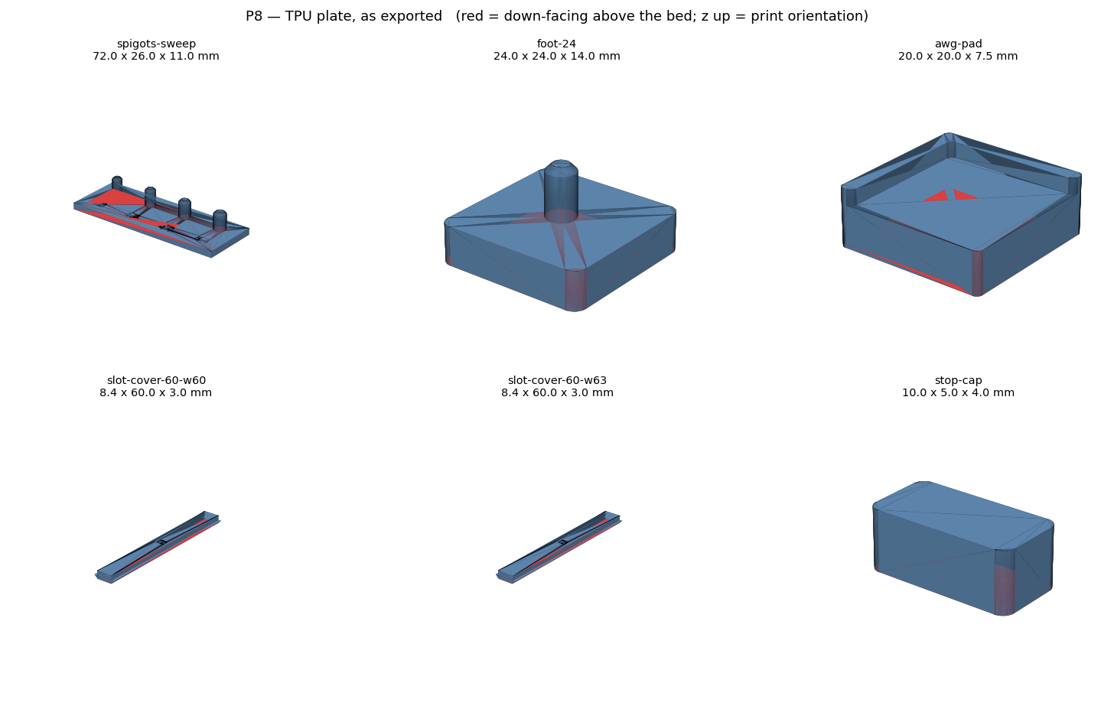
coupons/p8/p8-plan.png
