GarethCooke/SiglentTower/coupons/yellow-run/yellow-run-plan.png

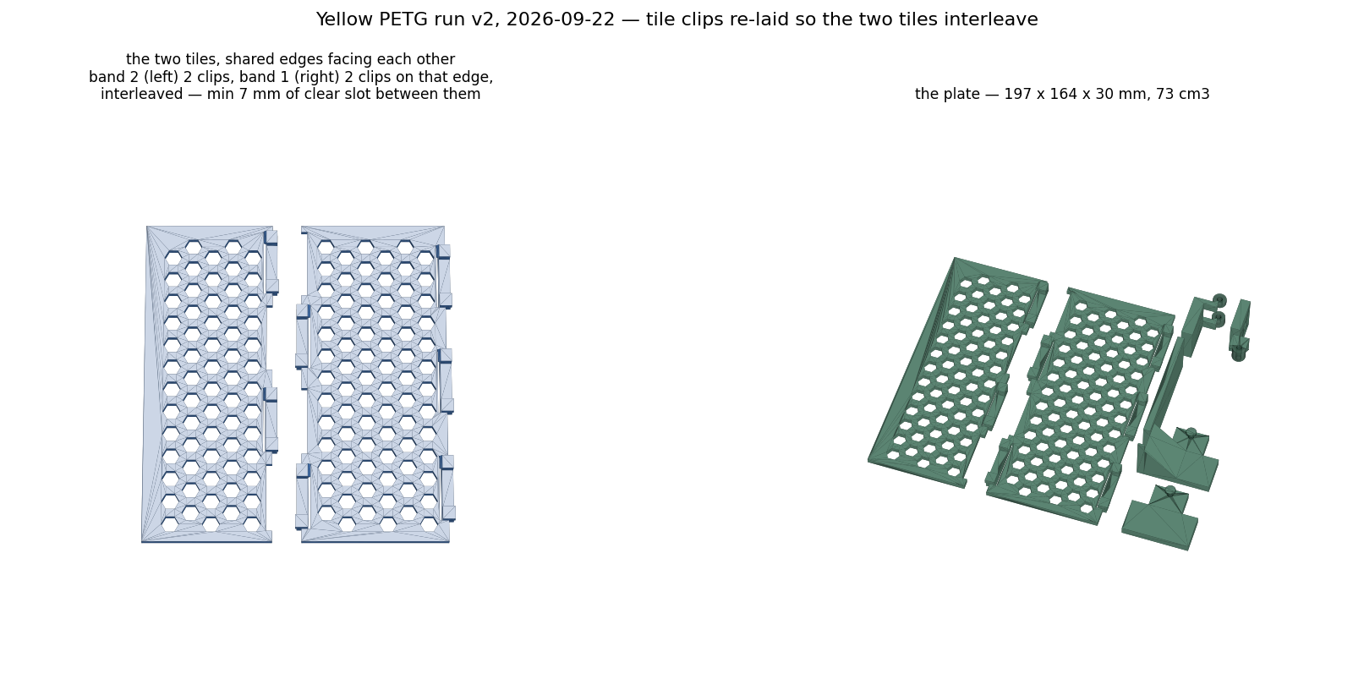
coupons/yellow-run/yellow-run-plan.png
