GarethCooke/SiglentTower/publish/makerworld/video/access-sequence-poster.jpg

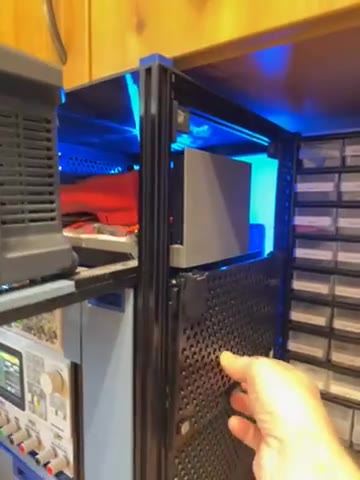
publish/makerworld/video/access-sequence-poster.jpg
