GarethCooke/SiglentTower/parts/drawer/drawer-facia-plan.png

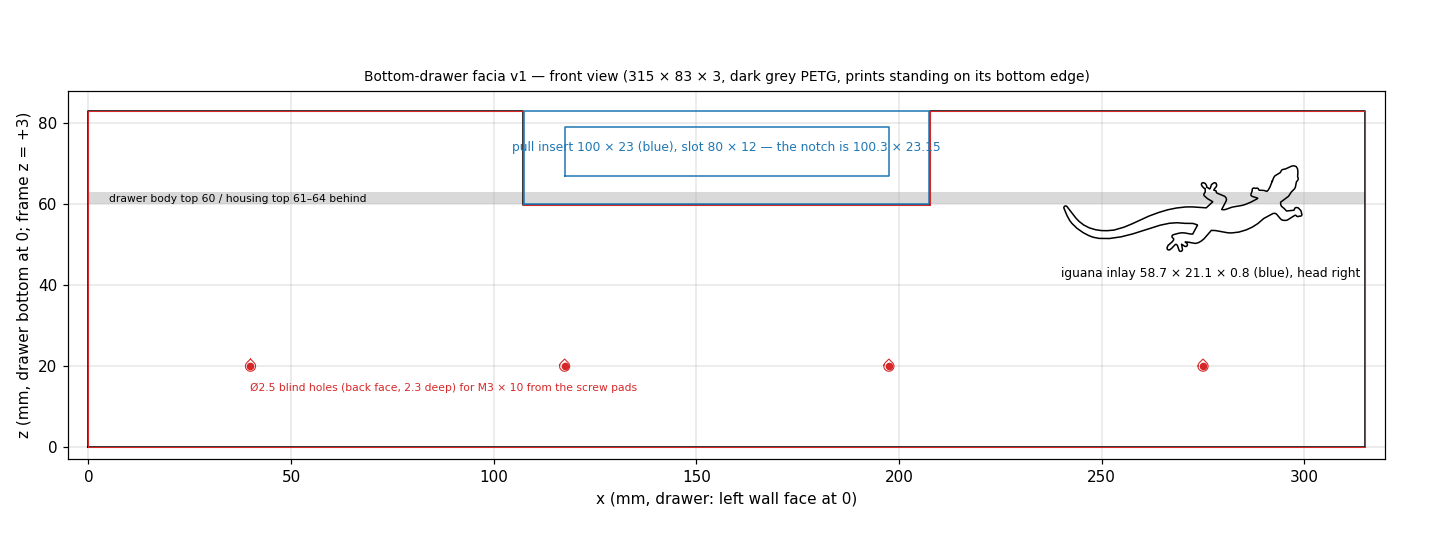
parts/drawer/drawer-facia-plan.png
