GarethCooke/SiglentTower/parts/scope-tray-plan.png

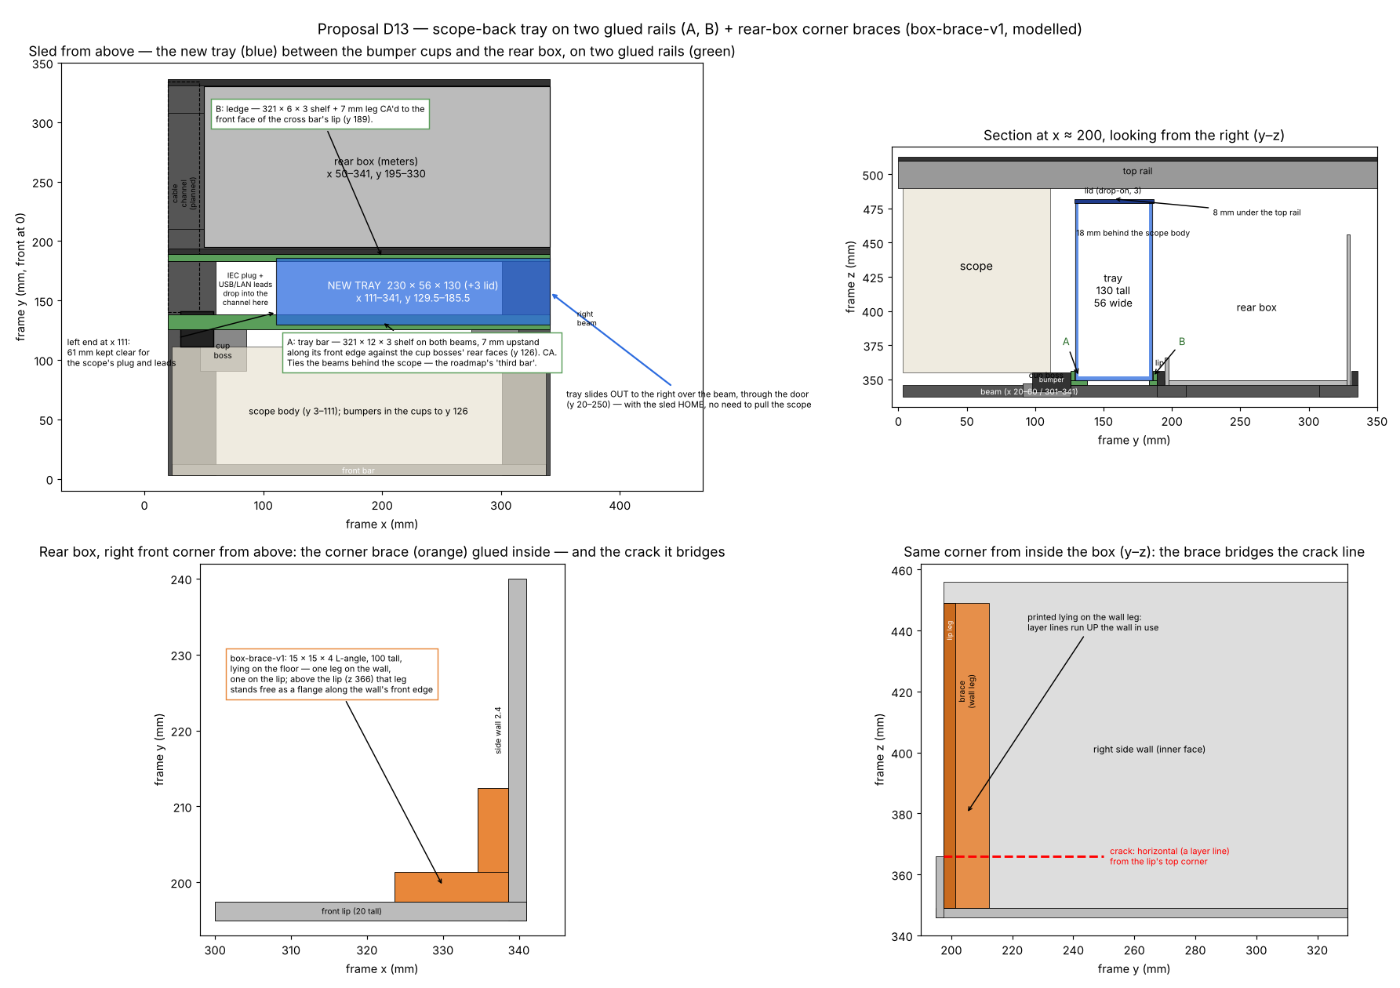
parts/scope-tray-plan.png
