GarethCooke/SiglentTower/parts/sled-absplus-plate.png

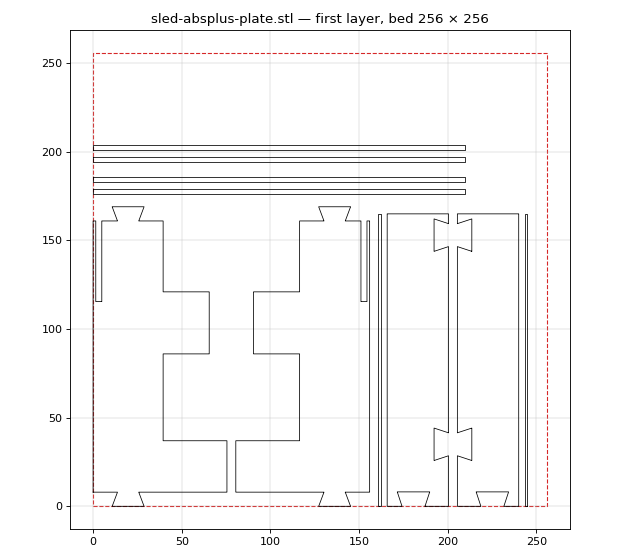
parts/sled-absplus-plate.png
