GarethCooke/SiglentTower/parts/sled-beam-plan.png

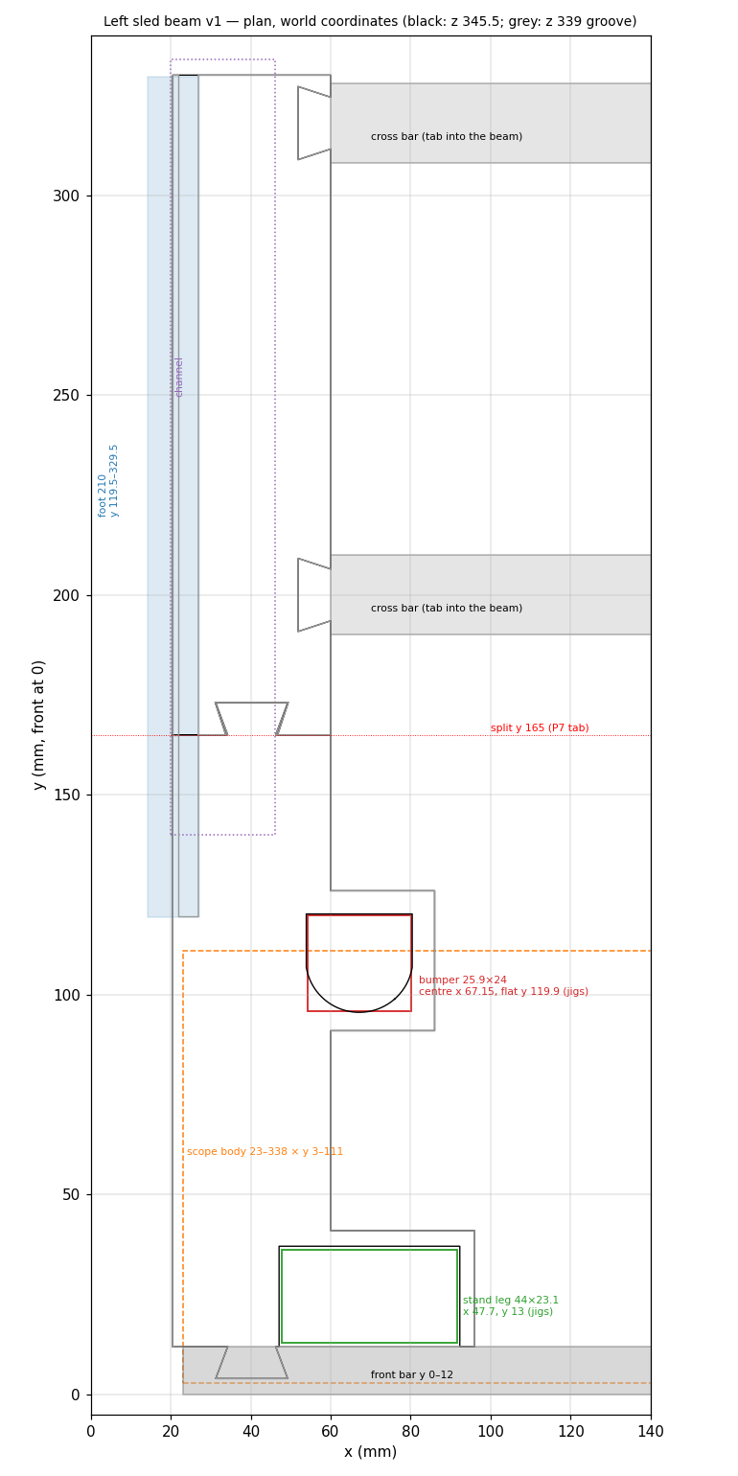
parts/sled-beam-plan.png
