GarethCooke/SiglentTower/parts/sled-crossbar-fit.png

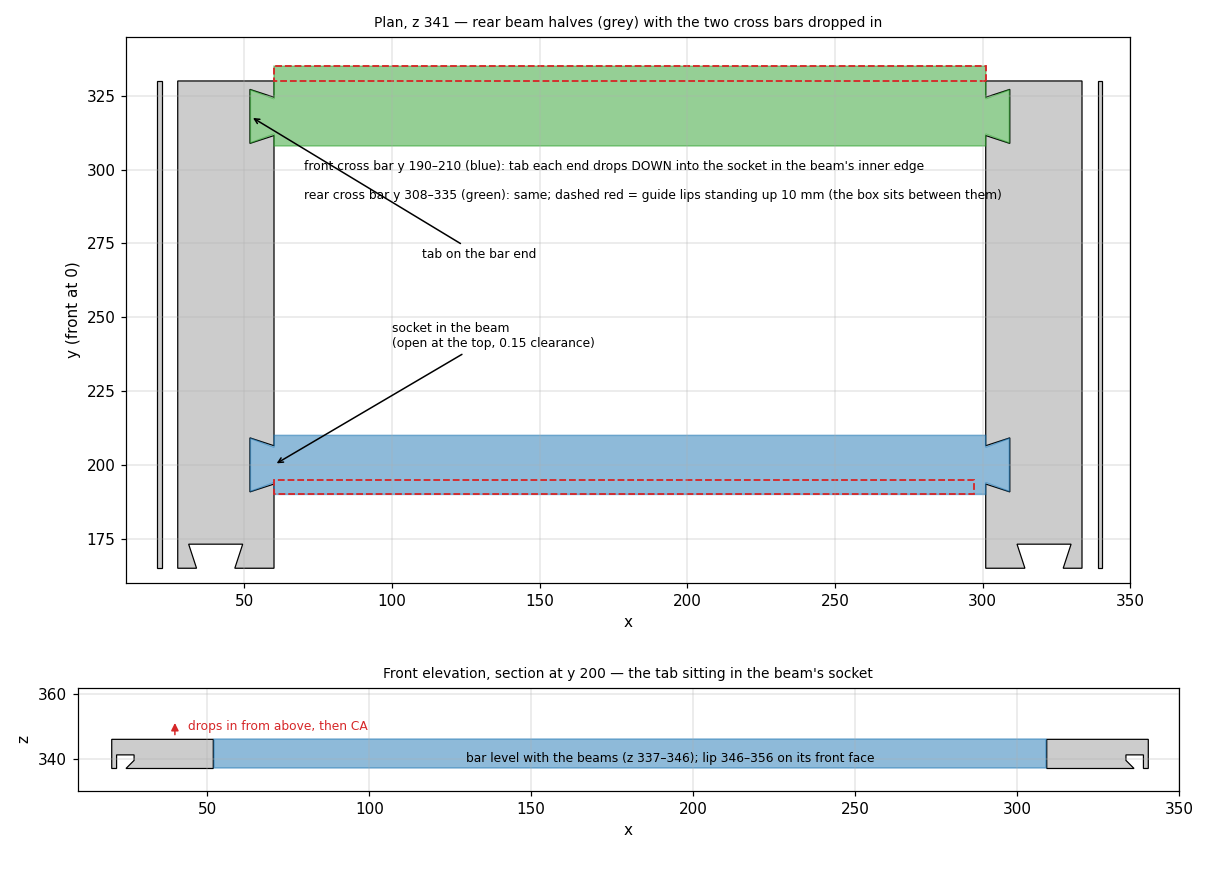
parts/sled-crossbar-fit.png
