GarethCooke/SiglentTower/parts/tpu/tpu-plate-plan.png

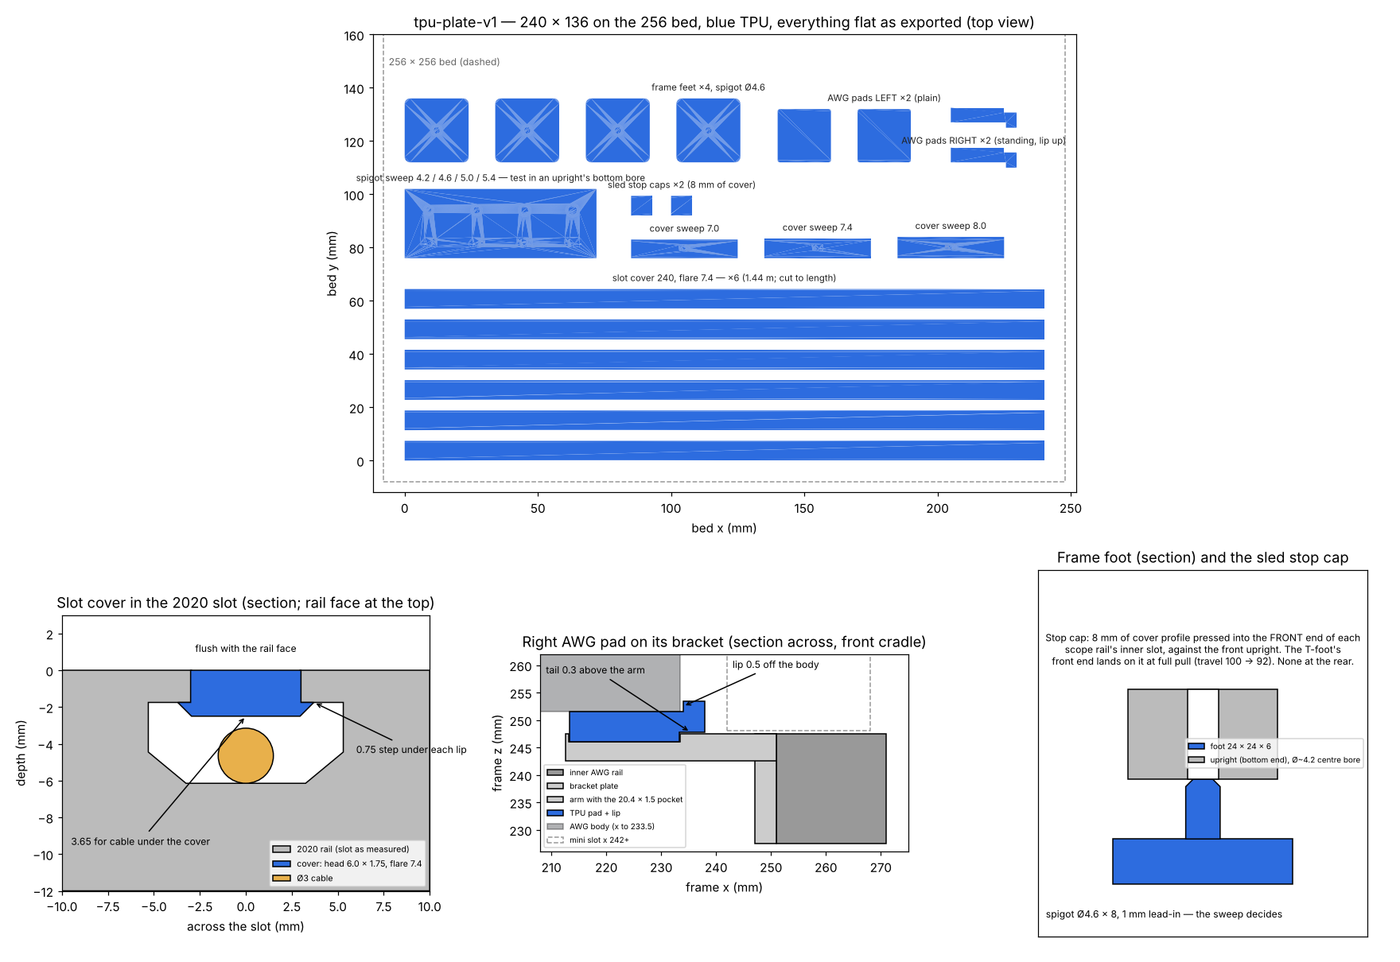
parts/tpu/tpu-plate-plan.png
