GarethCooke/SiglentTower/publish/SiglentTower-complete.3mf

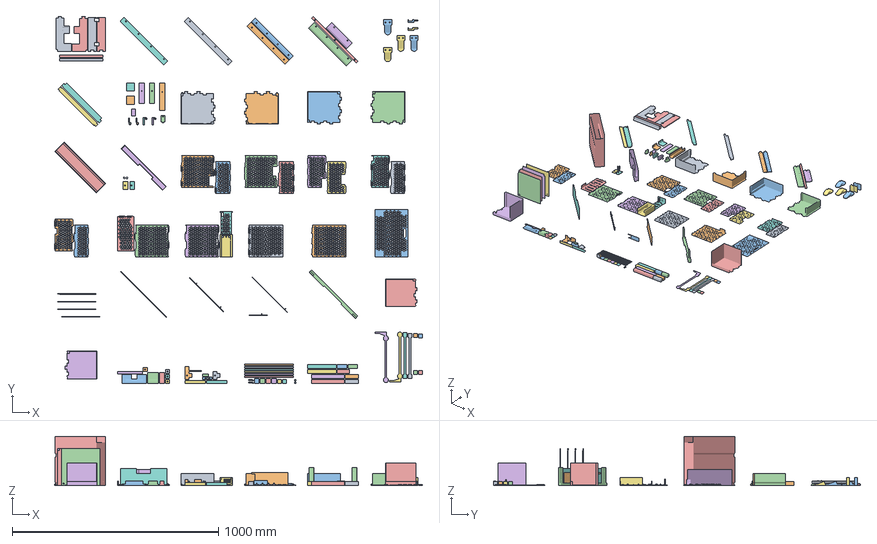
[picture p32: CAD file, 2026-11-08]
publish/SiglentTower-complete.3mf
1787.3 x 1781.5 x 240.0 mm
sled-foot-210.stl x 2
cable-channel-v1.stl
awg-cradle-left-v2.stl x 2
sled-splice-v2.stl x 2
awg-cradle-right-v2.stl x 2
sled-beam-left-front-v2.stl
psu-cradle-v3.stl x 2
magnet-bracket-front-v2.stl
sled-beam-right-front-v2.stl
hinge-door-v2.stl x 2
sled-beam-left-rear-v1.stl
hinge-frame-v2.stl x 2
psu-cradle-right-front-v5.stl
sled-beam-right-rear-v1.stl
magnet-tab-rear-v2.stl
psu-cradle-right-v4.stl
drawer-runner-300-v1.stl x 2
column-strip-upper-v1.stl x 2
column-strip-lower-v1.stl
mini-slot-runner-v3.stl
column-strip-lower-short-v1.stl
sled-cross-bar-front-v2.stl
sled-cross-bar-rear-v2.stl
drawer-Q1-v1.stl
drawer-Q2-v1.stl
drawer-Q3-v1.stl
drawer-Q4-v1.stl
column-drawer-v3.stl
mini-slot-body-v1.stl
sled-front-rest-v2-gap3.0.stl x 2
hinge-pins-v1.stl
tile-band2-LF-v2.stl
tile-band1-LF-v2.stl
tile-band2-LR-v2.stl
tile-band1-LR-v2.stl
tile-band3-LF-v2.stl
tile-band3-LR-v2.stl
tile-band3-RF-v2.stl
tile-band1-R-v2.stl x 2
tile-band3-RR-v2.stl
tile-band2-RF-v1.stl
rear-tile-v2.stl
tile-band2-RR-v1.stl
board-enclosure-v1.stl
board-lid-v1.stl
tile-band4-LF-v1.stl
tile-band4-LR-v1.stl
door-v3.stl
top-tile-FL-v1.stl
top-tile-FR-v1.stl
top-tile-RL-v1.stl
top-tile-RR-v1.stl
drawer-facia-v1 + drawer-facia-logo-v1.stl
sill-panel-v3 + sill-panel-window-v4.stl
column-facia-v1.stl
mini-slot-facia-v1.stl
sled-front-bar-v3.stl
rear-box-left-v1.stl
rear-box-right-v1.stl
upright-cap-v1.stl x 4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
