GarethCooke/SiglentTower/bambu/01-coupons/p1-plate.3mf

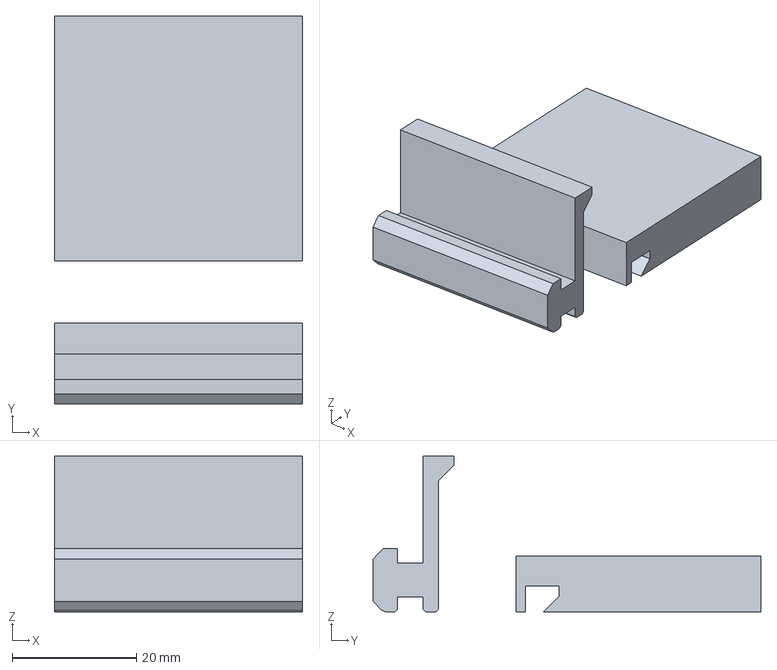
[picture p33: CAD file, 2026-09-19]
bambu/01-coupons/p1-plate.3mf
40.0 x 62.5 x 25.1 mm
