GarethCooke/SiglentTower/bambu/03-cradles/awg-cradles.3mf

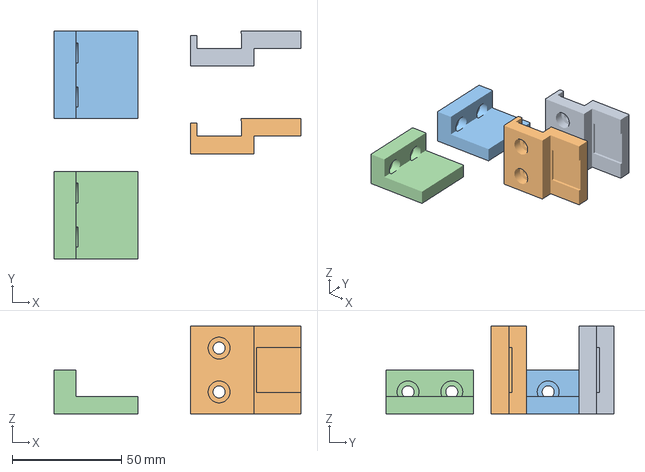
[picture p34: CAD file, 2026-09-20]
bambu/03-cradles/awg-cradles.3mf
112.8 x 104.0 x 40.0 mm
awg-cradle-left-v1.stl x 2
awg-cradle-right-v1.stl x 2
