GarethCooke/SiglentTower/bambu/parts/column/column-facia-v1.3mf

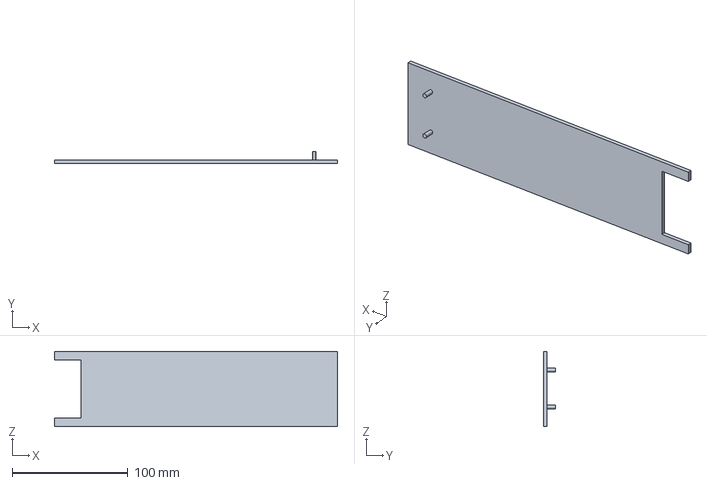
[picture p35: CAD file, 2026-10-10]
bambu/parts/column/column-facia-v1.3mf
245.0 x 10.0 x 65.0 mm
