GarethCooke/SiglentTower/bambu/parts/door/rear-tile-v2.3mf

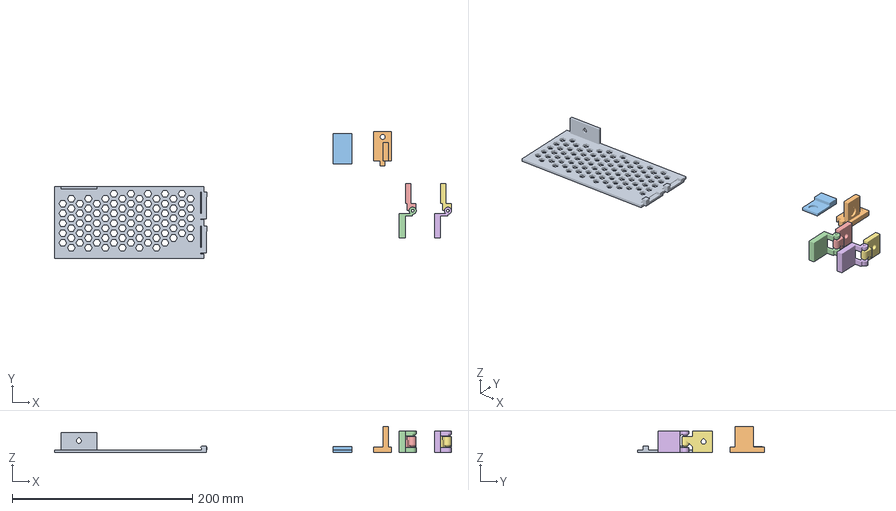
[picture p36: CAD file, 2026-10-20]
bambu/parts/door/rear-tile-v2.3mf
440.1 x 140.8 x 29.0 mm
rear-tile-v2.stl
magnet-bracket-front-v2.stl
magnet-tab-rear-v2.stl
hinge-door-v1.stl x 2
hinge-frame-v1.stl x 2
