GarethCooke/SiglentTower/bambu/parts/drawer/drawer-facia-v1.3mf

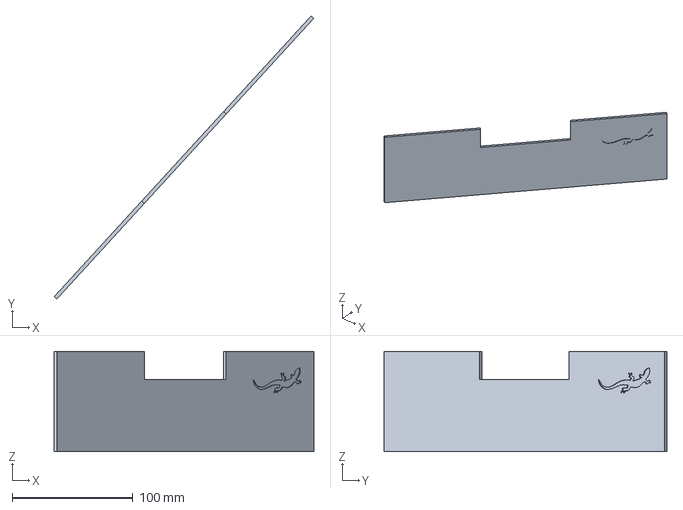
[picture p37: CAD file, 2026-10-09]
bambu/parts/drawer/drawer-facia-v1.3mf
214.9 x 234.4 x 83.0 mm
