GarethCooke/SiglentTower/bambu/parts/inserts-and-logo.3mf

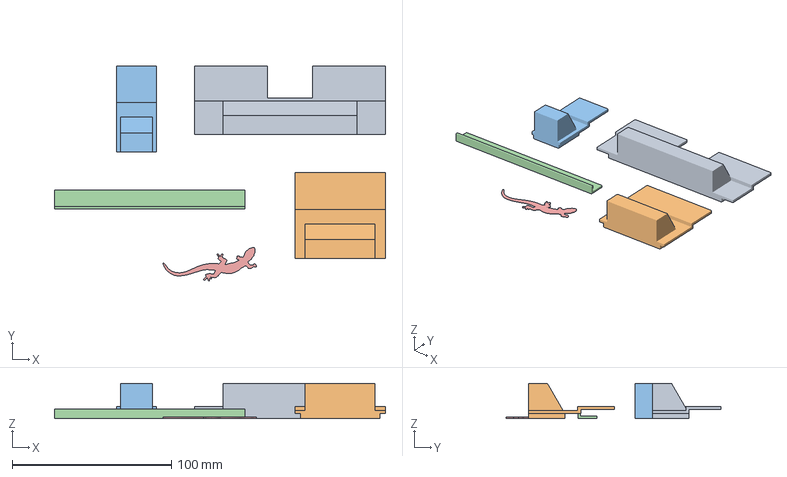
[picture p38: CAD file, 2026-10-10]
bambu/parts/inserts-and-logo.3mf
208.0 x 135.0 x 22.0 mm
pull-inserts-plate-v3.stl_1
pull-inserts-plate-v3.stl_2
pull-inserts-plate-v3.stl_3
pull-inserts-plate-v3.stl_4
drawer-facia-logo-v1.stl
