GarethCooke/SiglentTower/bambu/parts/mini/mini-slot-runner-v2.3mf

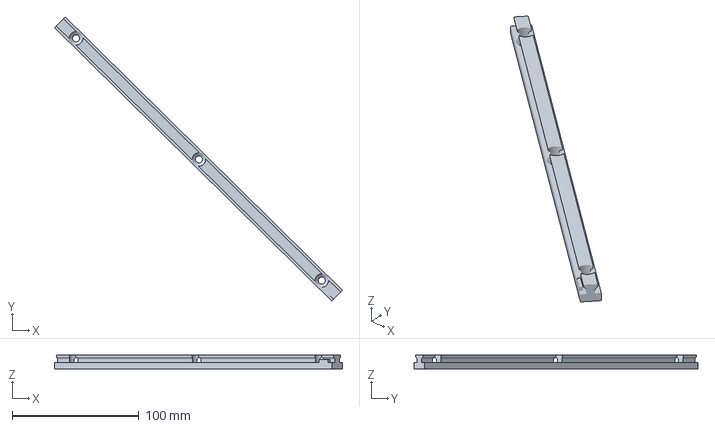
[picture p39: CAD file, 2026-10-13]
bambu/parts/mini/mini-slot-runner-v2.3mf
227.0 x 224.1 x 11.0 mm
