GarethCooke/SiglentTower/bambu/parts/tiles/tiles-plate-F.3mf

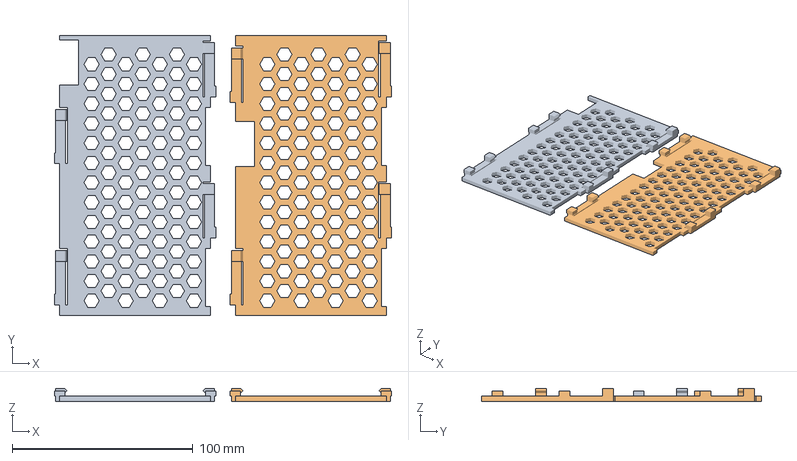
[picture p40: CAD file, 2026-09-28]
bambu/parts/tiles/tiles-plate-F.3mf
186.4 x 155.0 x 7.35 mm
tiles-plate-F.stl_1
tiles-plate-F.stl_2
