GarethCooke/SiglentTower/bambu/parts/tpu/tpu-plate-v1.3mf

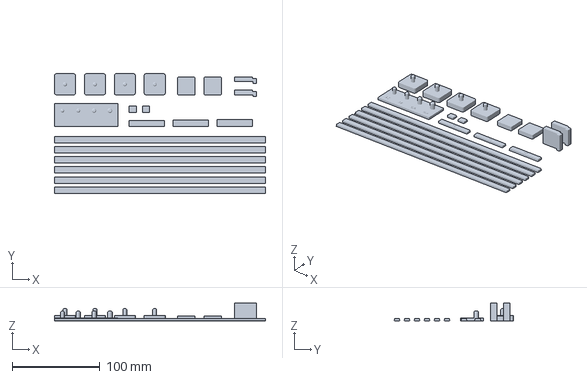
[picture p41: CAD file, 2026-10-13]
bambu/parts/tpu/tpu-plate-v1.3mf
240.0 x 136.0 x 20.0 mm
