GarethCooke/SiglentTower/coupons/mini/runner-csk-15.stl

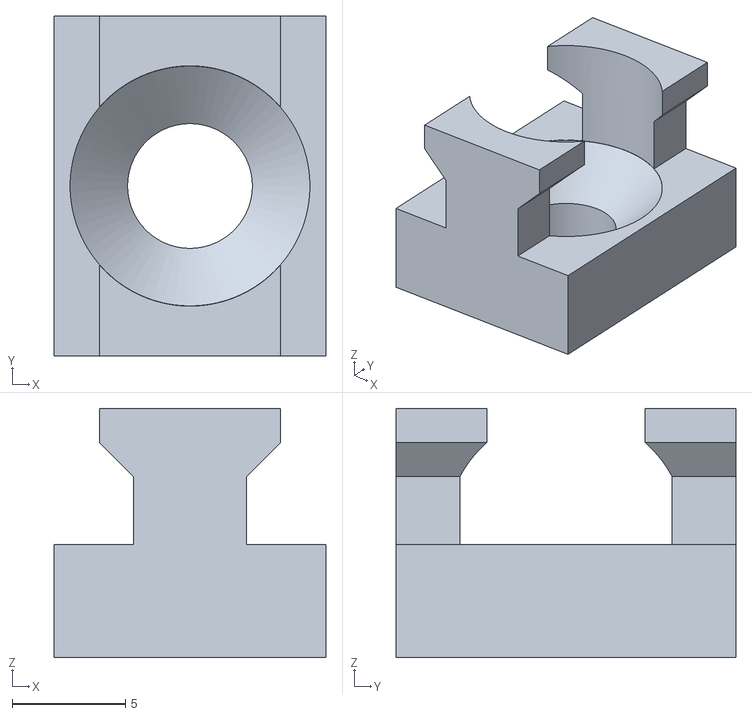
[picture p42: CAD file, 2026-10-13]
coupons/mini/runner-csk-15.stl
12.0 x 15.0 x 11.0
