GarethCooke/SiglentTower/coupons/p1/foot-40.stl

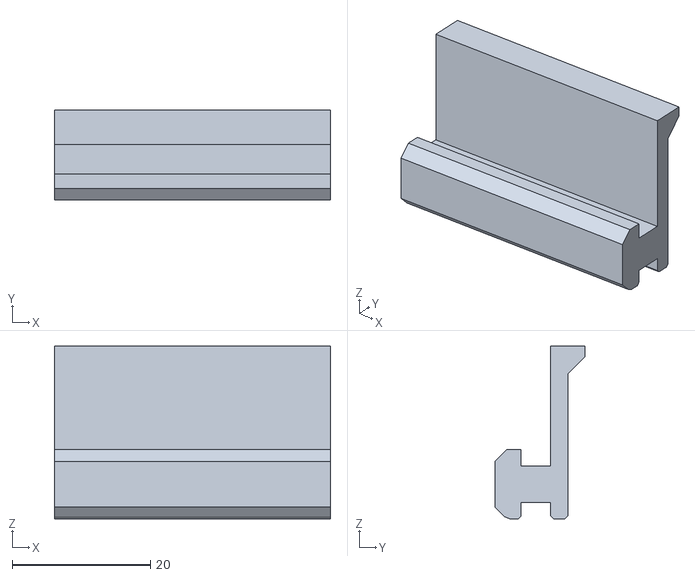
[picture p43: CAD file, 2026-09-21]
coupons/p1/foot-40.stl
40.0 x 13.1 x 25.0
