GarethCooke/SiglentTower/coupons/p2/p2-cup-coupon-b.stl

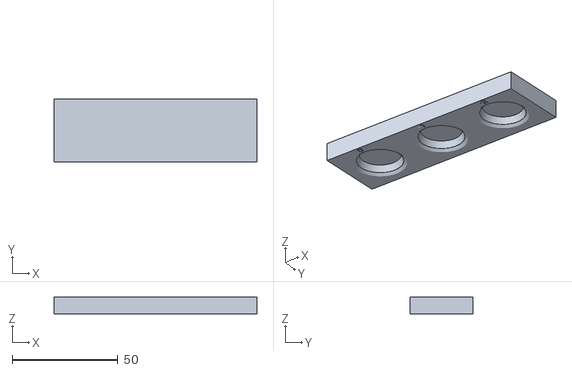
[picture p44: CAD file, 2026-09-17]
coupons/p2/p2-cup-coupon-b.stl
96.0 x 30.0 x 8.00
