GarethCooke/SiglentTower/coupons/p3/stub-100.stl

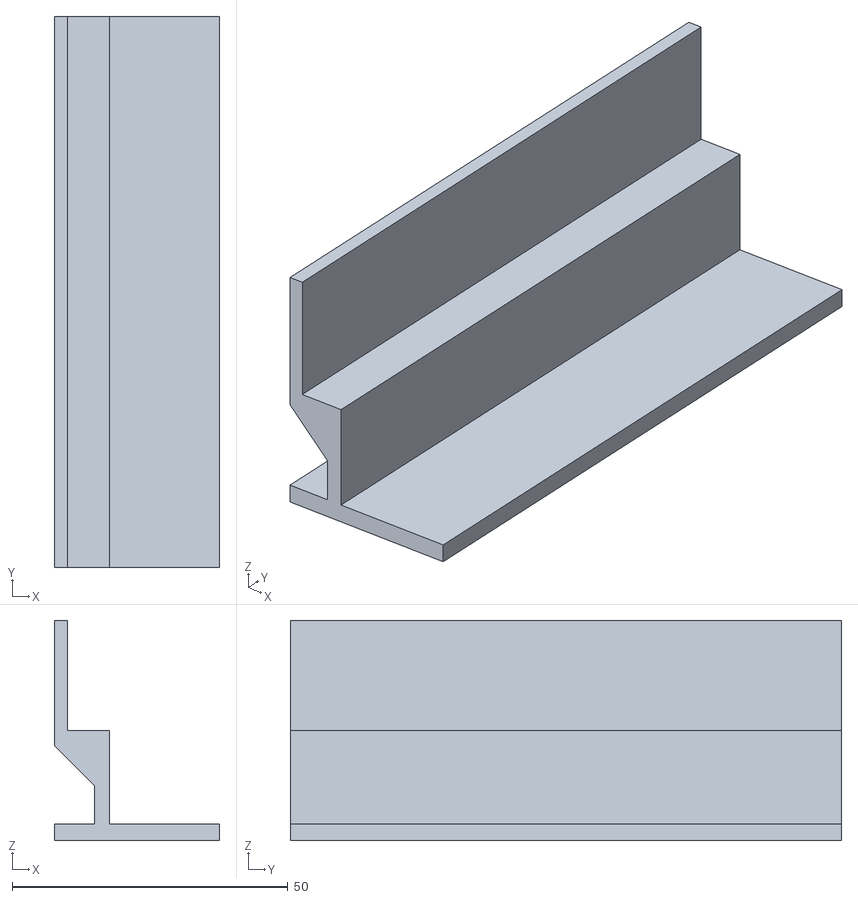
[picture p45: CAD file, 2026-09-19]
coupons/p3/stub-100.stl
30.0 x 100.0 x 40.0
