GarethCooke/SiglentTower/coupons/p4/strip-band3-plus4.stl

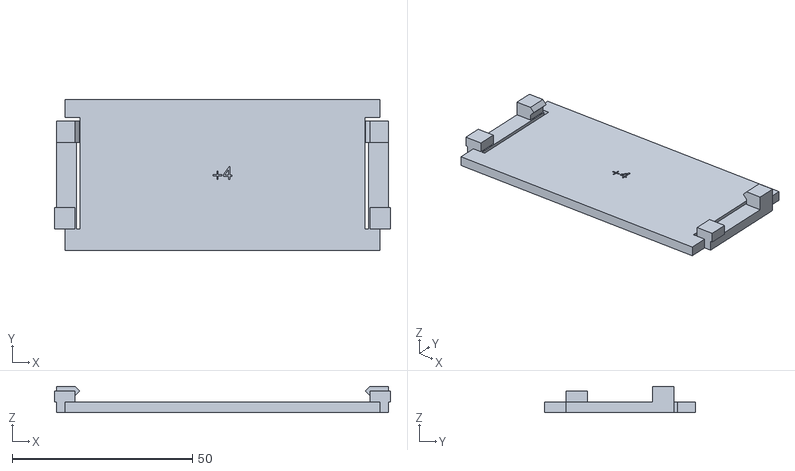
[picture p46: CAD file, 2026-10-12]
coupons/p4/strip-band3-plus4.stl
93.2 x 42.0 x 7.35
