GarethCooke/SiglentTower/coupons/p5/knuckle-door-v2.stl

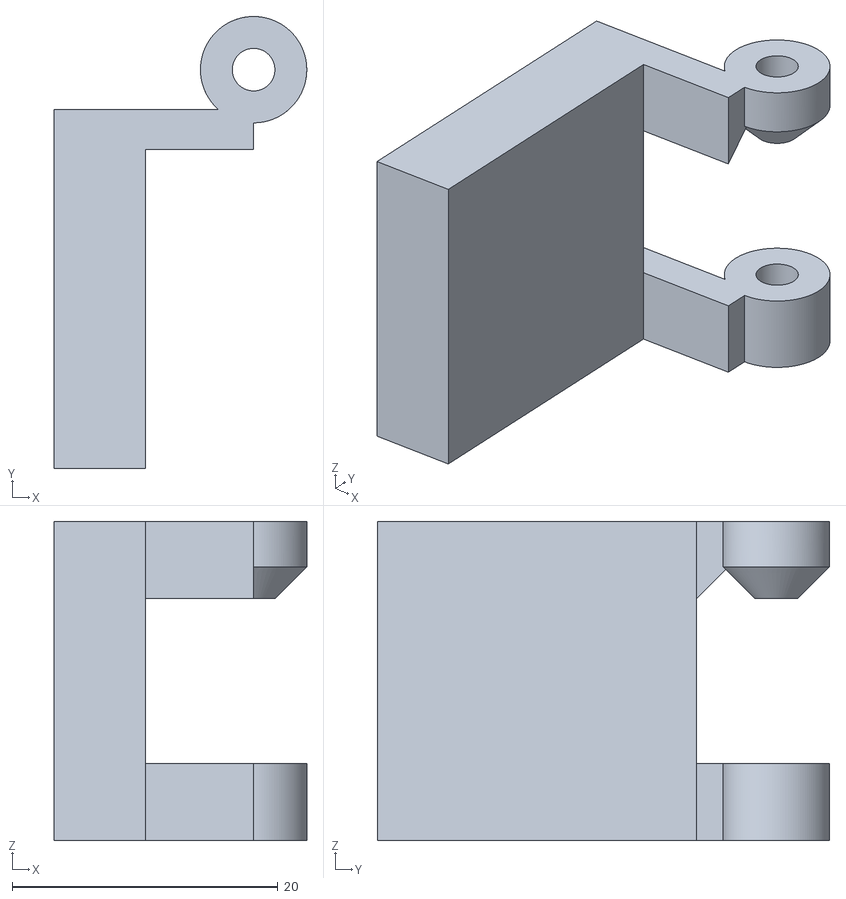
[picture p47: CAD file, 2026-09-22]
coupons/p5/knuckle-door-v2.stl
19.0 x 34.0 x 24.0
