GarethCooke/SiglentTower/coupons/p6/p6-v2-plate.stl

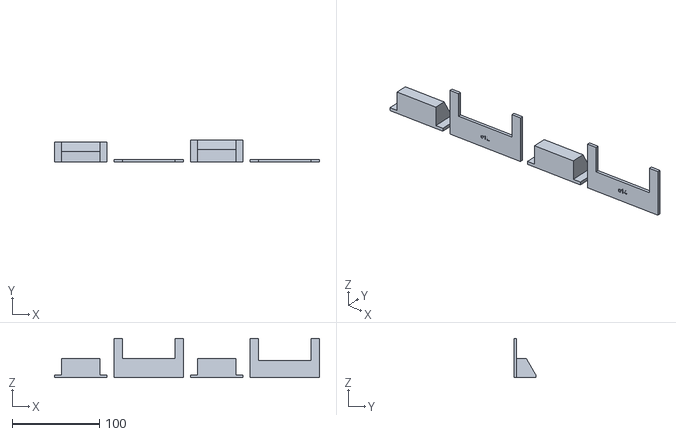
[picture p48: CAD file, 2026-09-19]
coupons/p6/p6-v2-plate.stl
304.0 x 25.0 x 45.0
