GarethCooke/SiglentTower/coupons/p7/beam-rear.stl

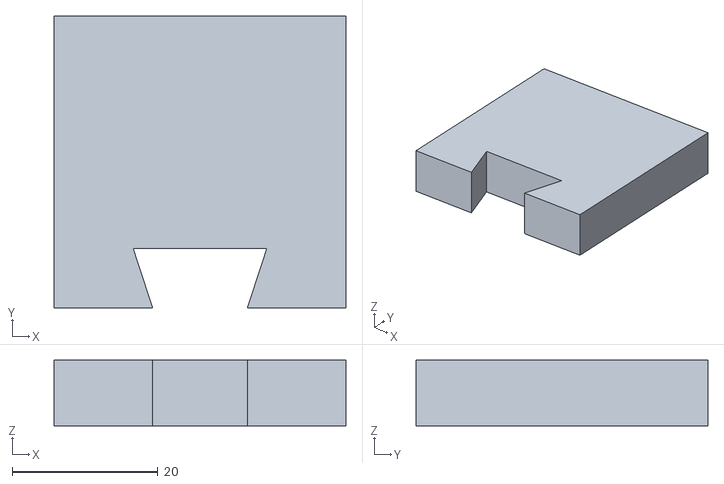
[picture p49: CAD file, 2026-09-15]
coupons/p7/beam-rear.stl
40.0 x 40.0 x 9.00
