GarethCooke/SiglentTower/coupons/p8/stop-cap.stl

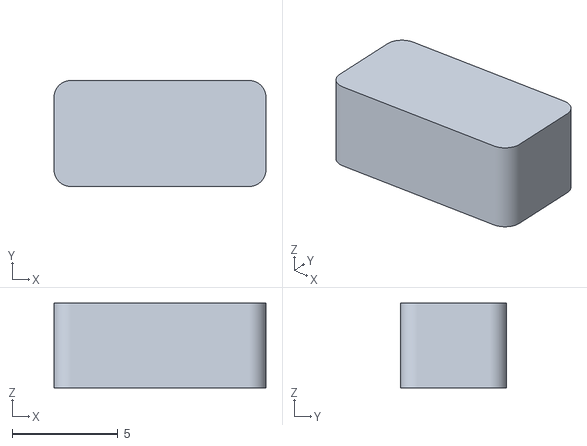
[picture p50: CAD file, 2026-09-22]
coupons/p8/stop-cap.stl
10.0 x 5.00 x 4.00
