GarethCooke/SiglentTower/coupons/p9/p9-jigs-plate.stl

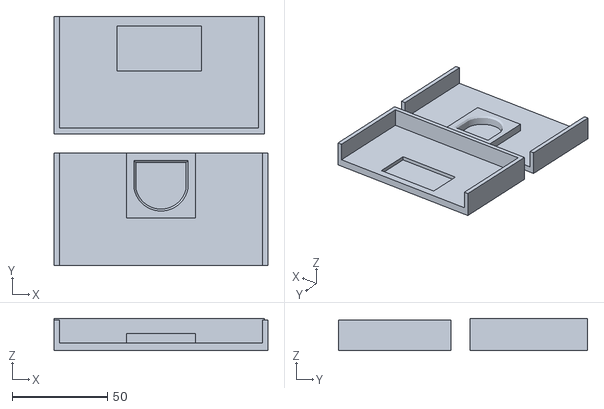
[picture p51: CAD file, 2026-09-24]
coupons/p9/p9-jigs-plate.stl
112.5 x 131.0 x 17.0
