GarethCooke/SiglentTower/coupons/spacers/spacer-48.stl

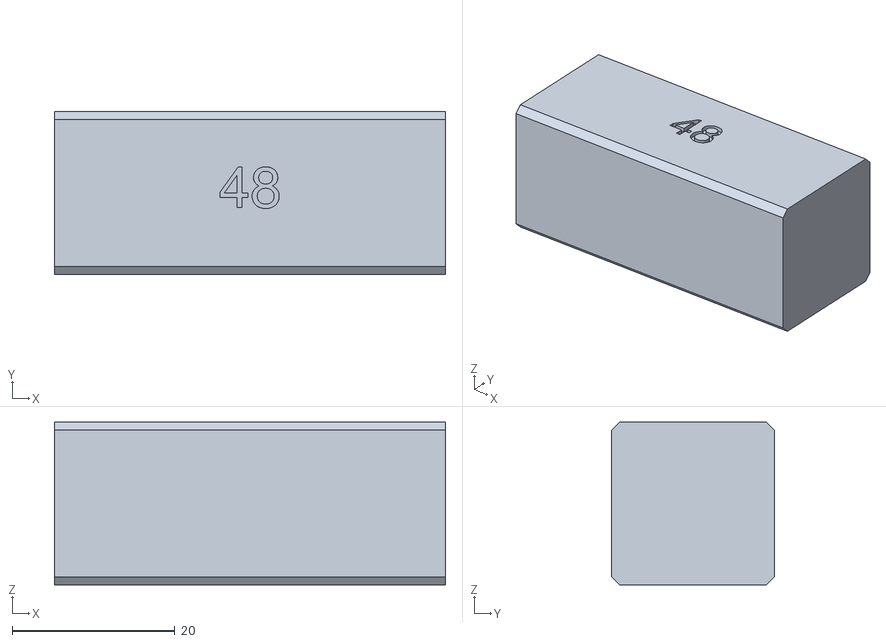
[picture p52: CAD file, 2026-09-16]
coupons/spacers/spacer-48.stl
48.0 x 20.0 x 20.0
