GarethCooke/SiglentTower/coupons/yellow-run/yellow-run-2026-09-25.stl

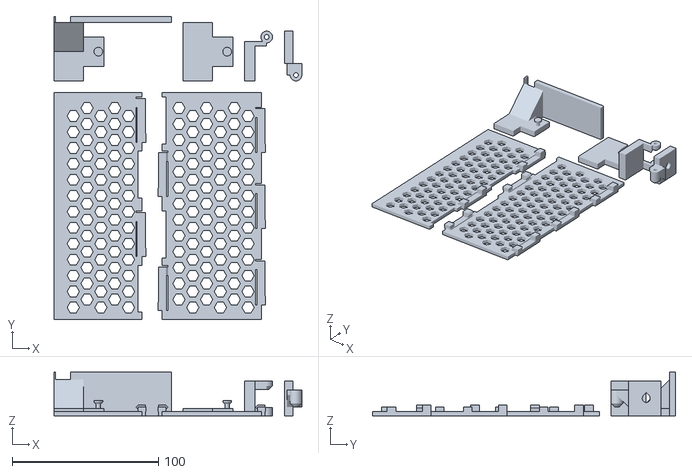
[picture p53: CAD file, 2026-09-26]
coupons/yellow-run/yellow-run-2026-09-25.stl
169.2 x 207.0 x 30.0
