GarethCooke/SiglentTower/jigs/awg-pad-standin.stl

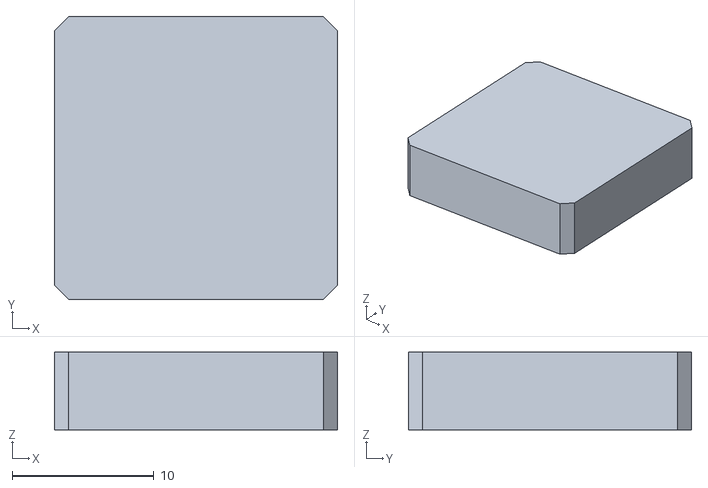
[picture p54: CAD file, 2026-09-28]
jigs/awg-pad-standin.stl
20.0 x 20.0 x 5.50
