GarethCooke/SiglentTower/parts/column/column-drawer-v3.stl

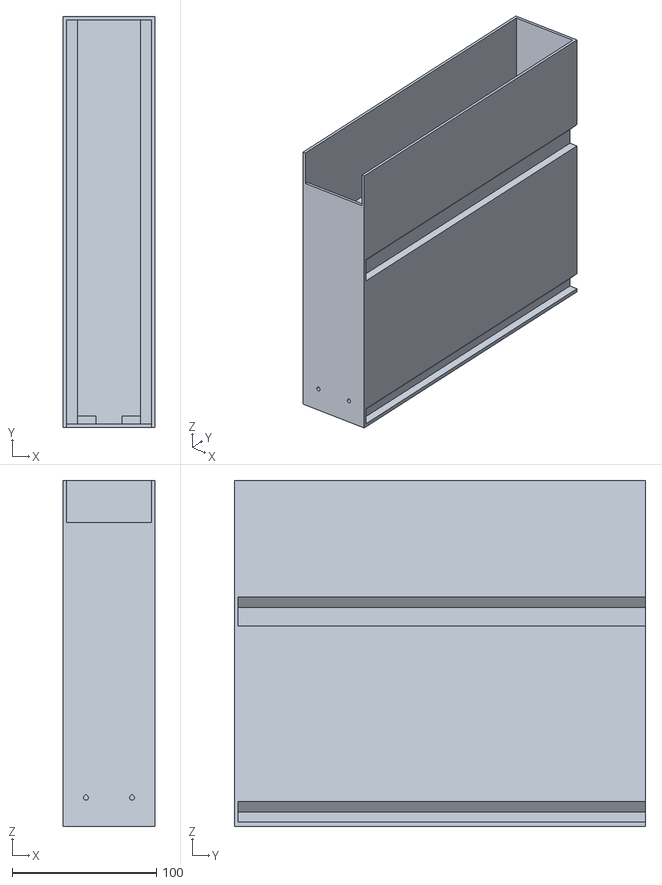
[picture p55: CAD file, 2026-10-09]
parts/column/column-drawer-v3.stl
64.0 x 285.0 x 240.0
