GarethCooke/SiglentTower/parts/door/door-v3.stl

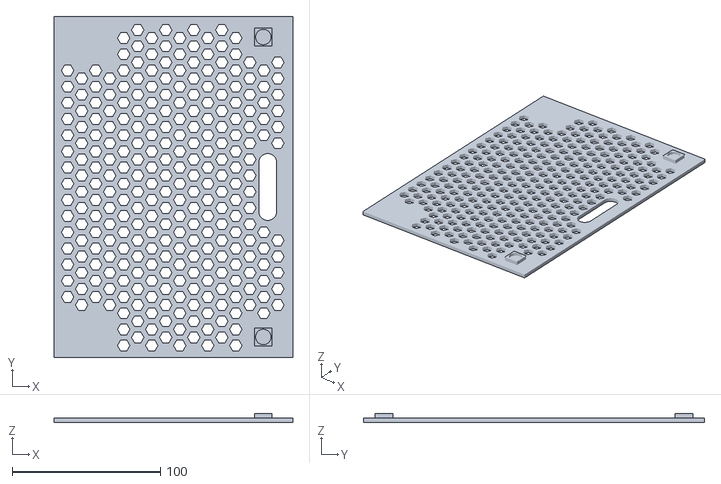
[picture p56: CAD file, 2026-10-20]
parts/door/door-v3.stl
161.0 x 230.0 x 6.00
