GarethCooke/SiglentTower/parts/drawer/drawer-facia-logo-v1.stl

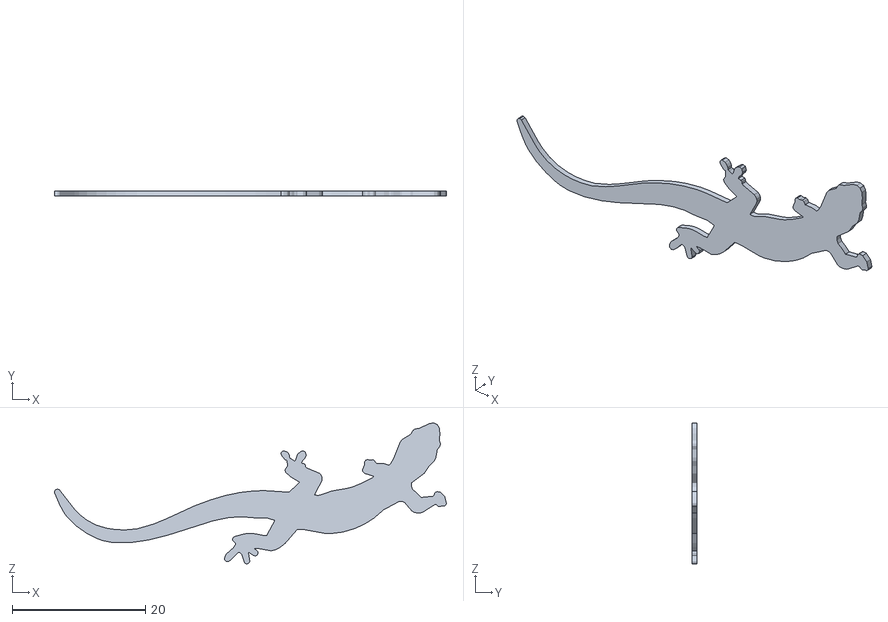
[picture p57: CAD file, 2026-10-02]
parts/drawer/drawer-facia-logo-v1.stl
58.7 x 0.8 x 21.1
