GarethCooke/SiglentTower/parts/inserts/pull-insert-column-v2.stl

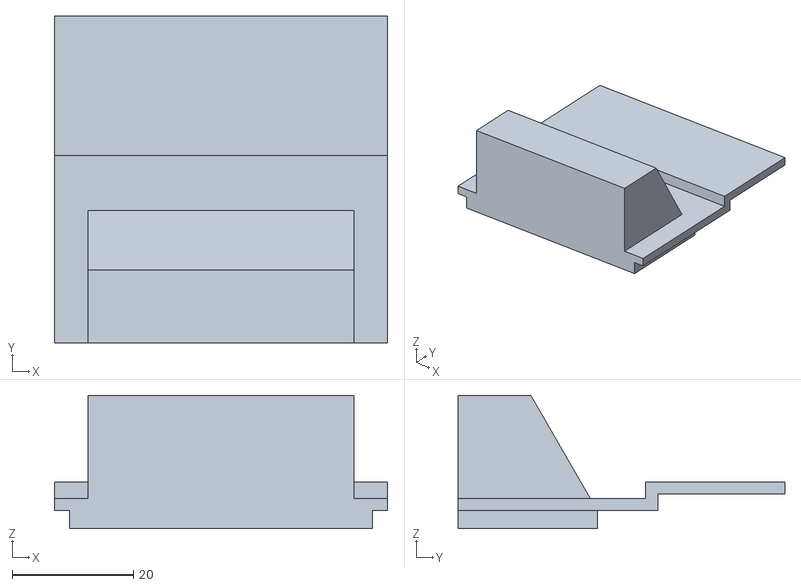
[picture p58: CAD file, 2026-10-09]
parts/inserts/pull-insert-column-v2.stl
55.0 x 54.0 x 22.0
