GarethCooke/SiglentTower/parts/mini/mini-slot-runner-v3.stl

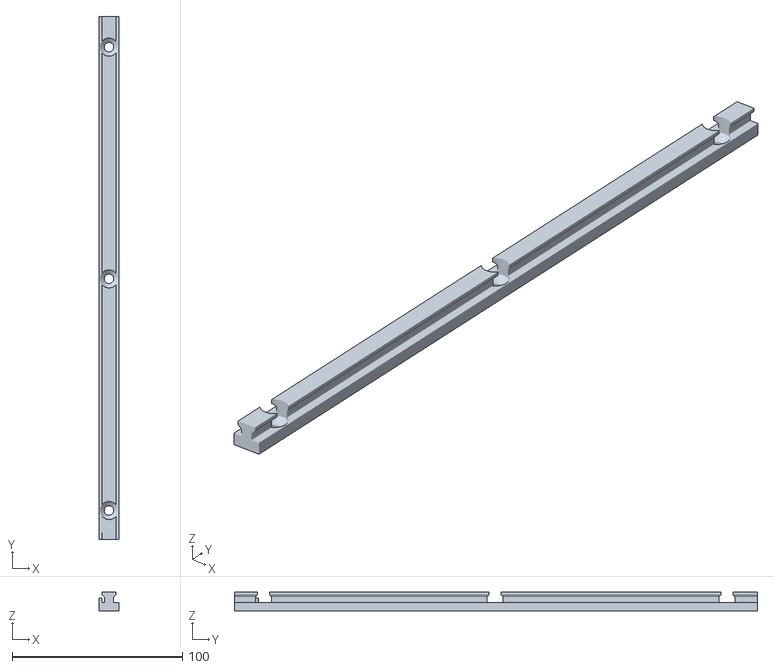
[picture p59: CAD file, 2026-10-13]
parts/mini/mini-slot-runner-v3.stl
12.0 x 307.0 x 11.0
