GarethCooke/SiglentTower/parts/sill/sill-panel-window-v4.stl

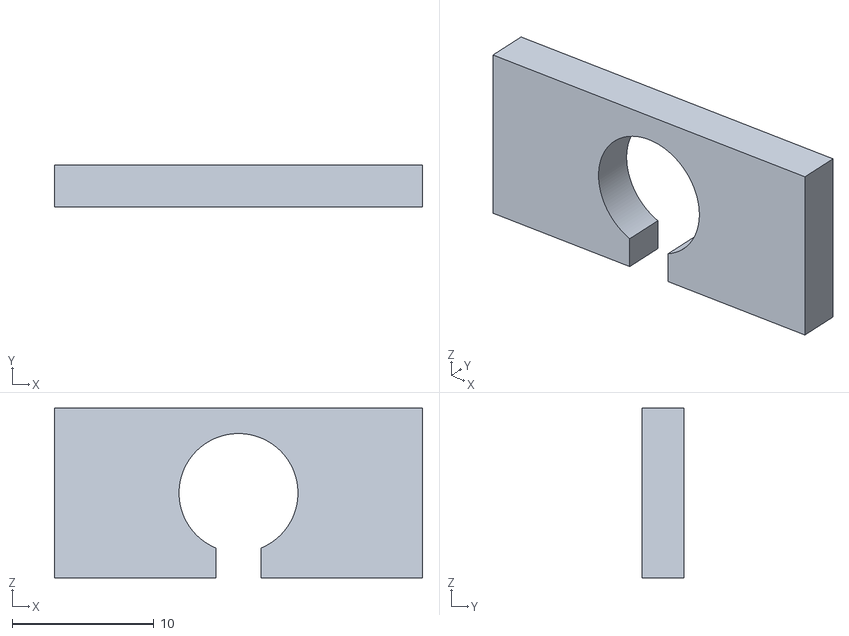
[picture p60: CAD file, 2026-10-27]
parts/sill/sill-panel-window-v4.stl
26.0 x 3.00 x 12.0
