GarethCooke/SiglentTower/parts/strip-bracket-lower-v5.stl

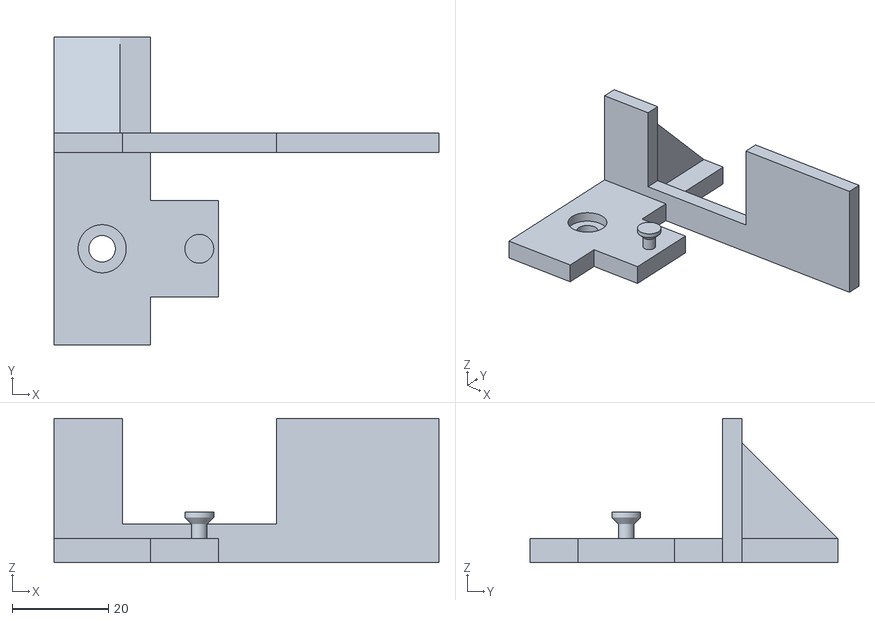
[picture p61: CAD file, 2026-10-23]
parts/strip-bracket-lower-v5.stl
80.0 x 64.0 x 30.0
