GarethCooke/SiglentTower/parts/tiles/tile-band4-LR-v1.stl

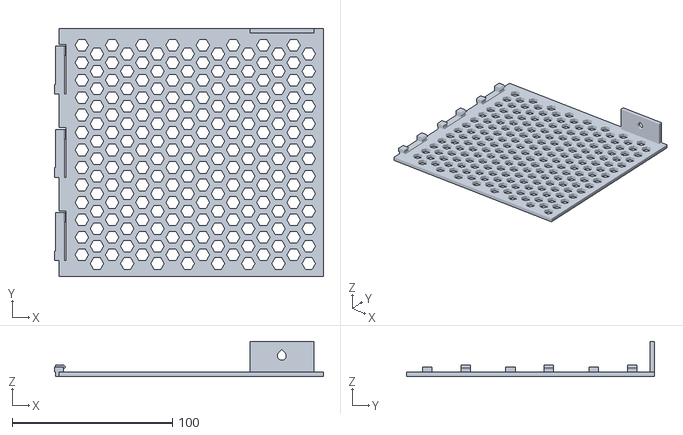
[picture p62: CAD file, 2026-10-18]
parts/tiles/tile-band4-LR-v1.stl
167.9 x 155.0 x 22.0
