GarethCooke/SiglentTower/parts/top/top-tile-RR-v1.stl

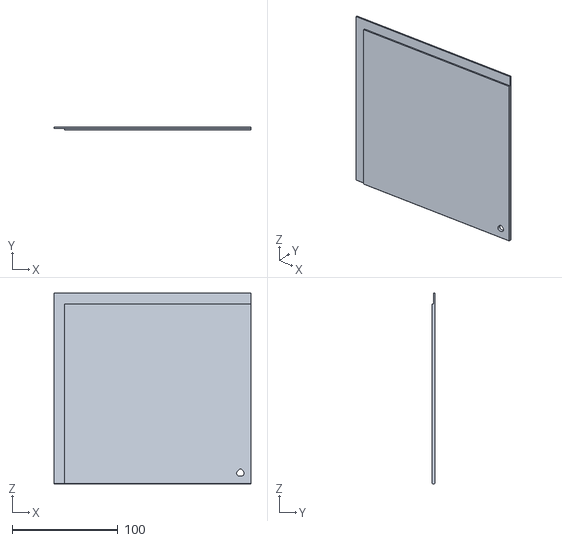
[picture p63: CAD file, 2026-10-14]
parts/top/top-tile-RR-v1.stl
185.9 x 3.00 x 179.9
