GarethCooke/SiglentTower/parts/wiring/board-lid-v1.stl

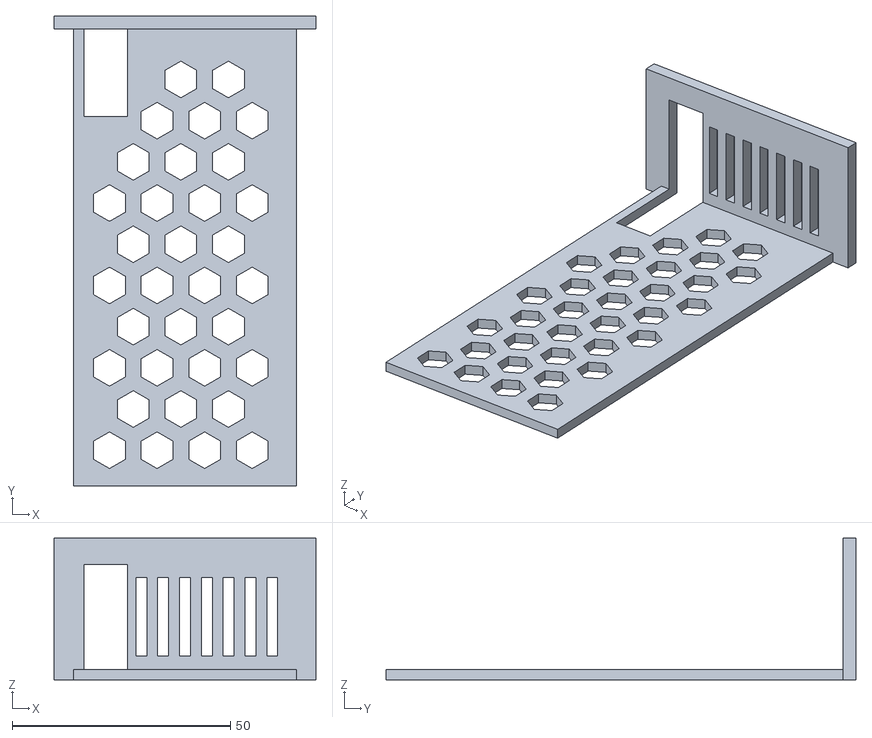
[picture p64: CAD file, 2026-10-26]
parts/wiring/board-lid-v1.stl
60.0 x 107.7 x 32.5
