GarethCooke/SiglentTower/bambu/01-coupons/facia-80.3mf

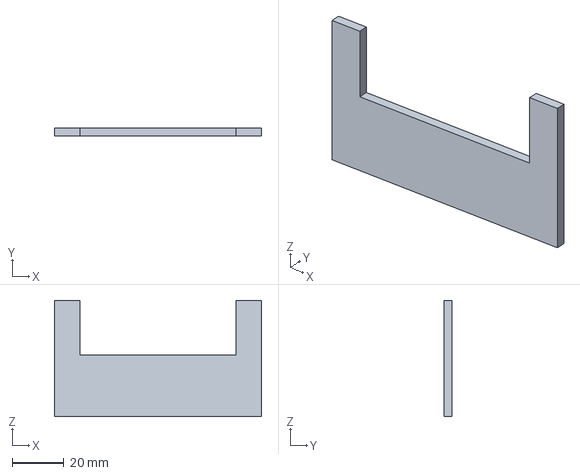
[picture p65: CAD file, 2026-09-19]
bambu/01-coupons/facia-80.3mf
80.0 x 3.00 x 45.0 mm
