GarethCooke/SiglentTower/bambu/03-cradles/psu-cradle.3mf

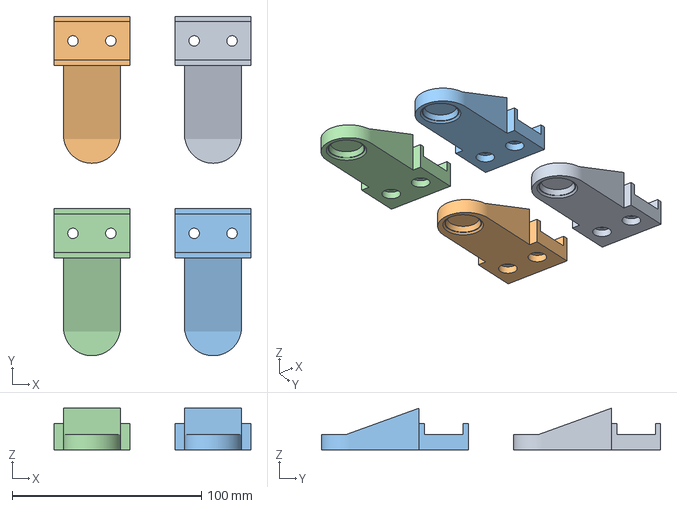
[picture p66: CAD file, 2026-09-17]
bambu/03-cradles/psu-cradle.3mf
104.0 x 179.2 x 22.0 mm
psu-cradle-v3.stl x 4
