GarethCooke/SiglentTower/bambu/parts/column/column-strip-lower-short-v1.3mf

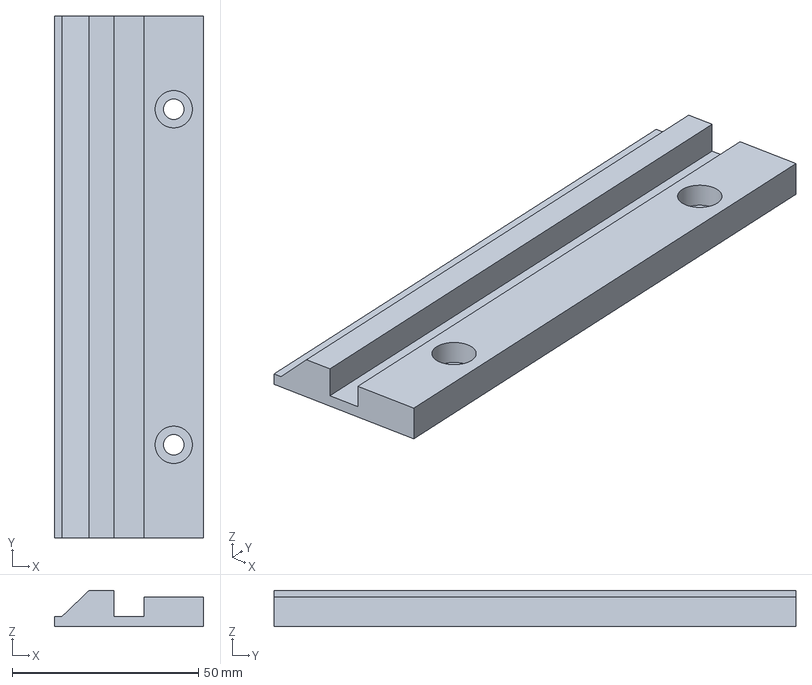
[picture p67: CAD file, 2026-10-09]
bambu/parts/column/column-strip-lower-short-v1.3mf
40.0 x 140.0 x 9.70 mm
