GarethCooke/SiglentTower/bambu/parts/drawer/drawer-facia-logo-v1.3mf

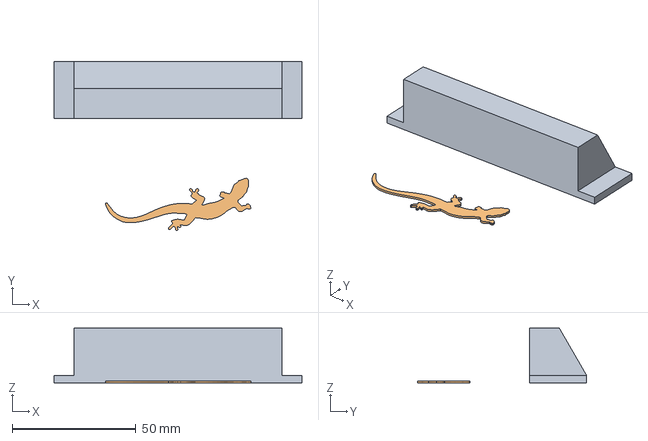
[picture p68: CAD file, 2026-10-03]
bambu/parts/drawer/drawer-facia-logo-v1.3mf
100.0 x 68.2 x 22.0 mm
drawer-pull-insert-v1.stl
drawer-facia-logo-v1.stl
