GarethCooke/SiglentTower/bambu/parts/mini/mini-slot-body-v1.3mf

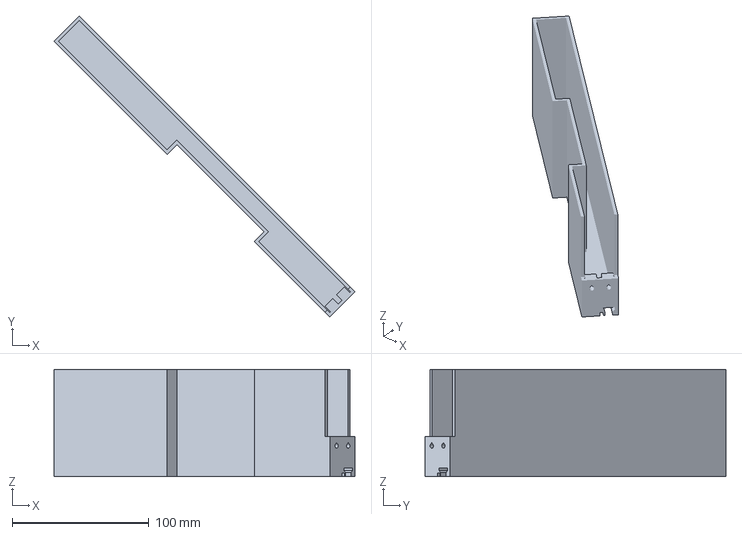
[picture p69: CAD file, 2026-10-11]
bambu/parts/mini/mini-slot-body-v1.3mf
219.9 x 219.9 x 78.5 mm
