GarethCooke/SiglentTower/bambu/parts/sill/sill-block-left-and-right-v3.3mf

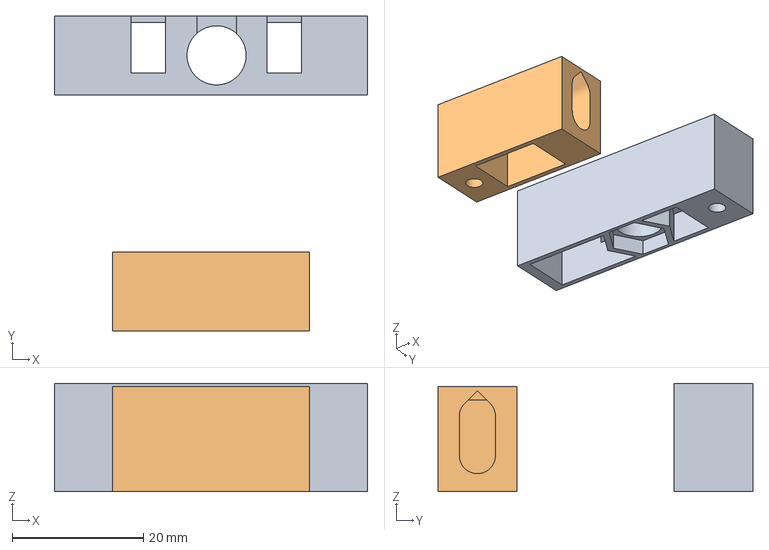
[picture p70: CAD file, 2026-10-13]
bambu/parts/sill/sill-block-left-and-right-v3.3mf
47.7 x 48.0 x 16.5 mm
sill-block-left-v3.stl
sill-block-right-v3.stl
