GarethCooke/SiglentTower/bambu/parts/sled-front-bar-v3.3mf

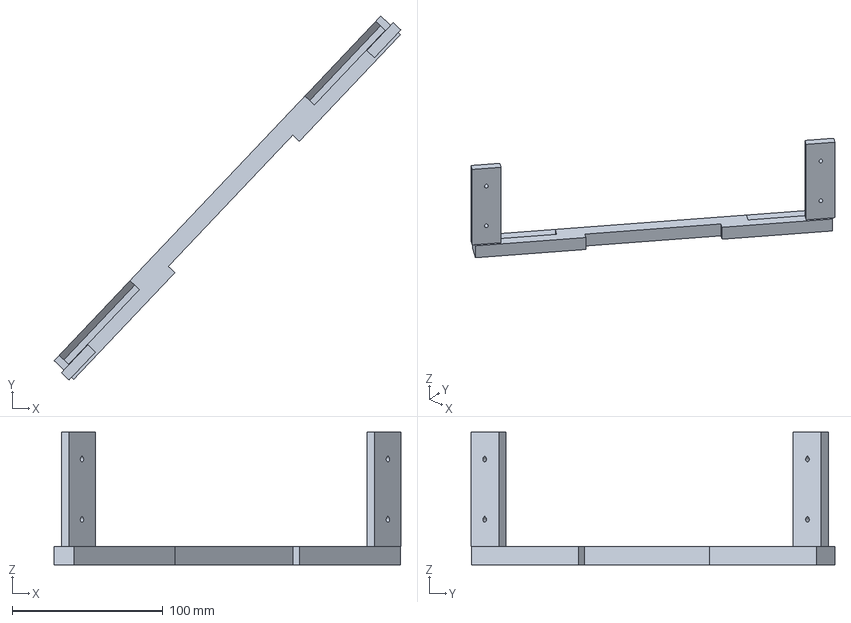
[picture p71: CAD file, 2026-10-09]
bambu/parts/sled-front-bar-v3.3mf
230.0 x 241.5 x 88.0 mm
