GarethCooke/SiglentTower/bambu/parts/tiles/tiles-plate-E.3mf

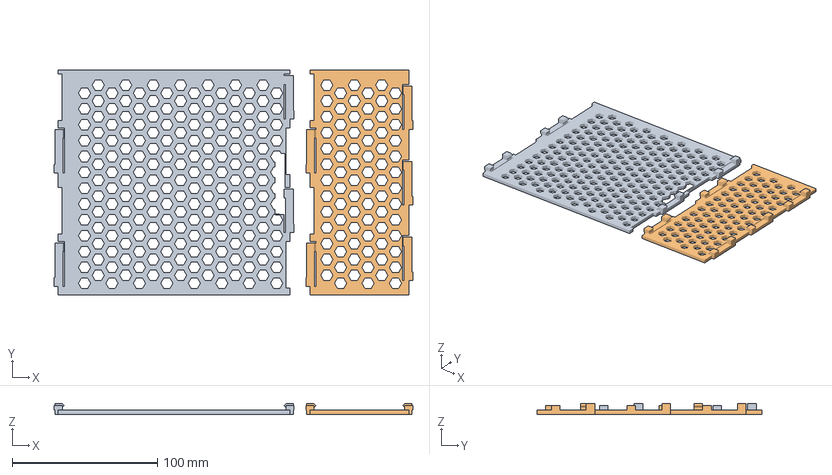
[picture p72: CAD file, 2026-09-27]
bambu/parts/tiles/tiles-plate-E.3mf
246.9 x 155.0 x 7.35 mm
tiles-plate-E.stl_1
tiles-plate-E.stl_2
