GarethCooke/SiglentTower/coupons/mini/runner-csk-15-v3.stl

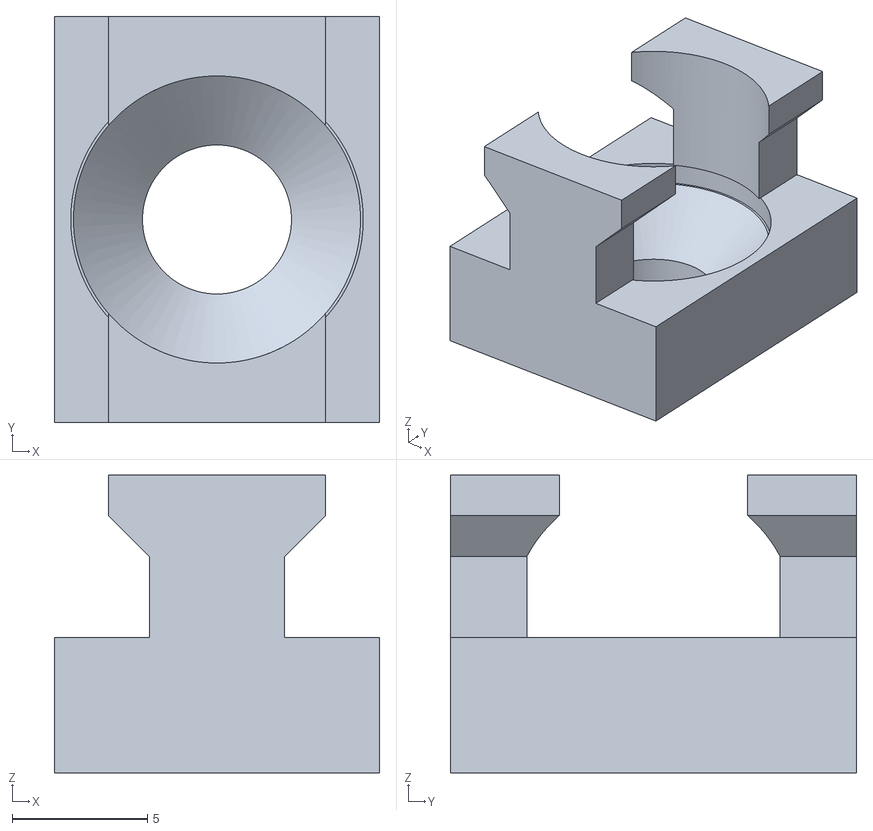
[picture p73: CAD file, 2026-10-13]
coupons/mini/runner-csk-15-v3.stl
12.0 x 15.0 x 11.0
