GarethCooke/SiglentTower/coupons/p3/runner-80.stl

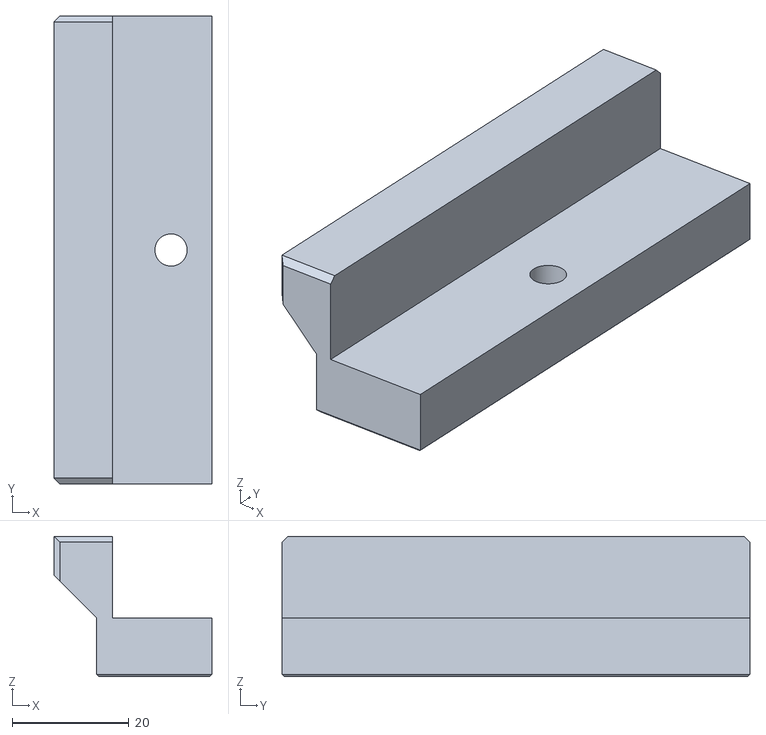
[picture p74: CAD file, 2026-09-19]
coupons/p3/runner-80.stl
27.0 x 80.0 x 24.0
