GarethCooke/SiglentTower/coupons/p4/strip-band3-plus6.stl

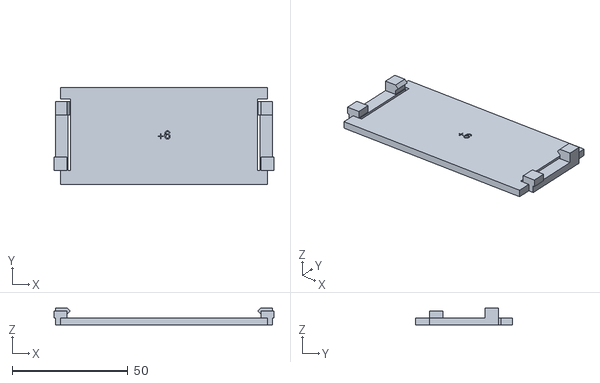
[picture p75: CAD file, 2026-10-12]
coupons/p4/strip-band3-plus6.stl
95.2 x 42.0 x 7.35
