GarethCooke/SiglentTower/coupons/p5/knuckle-frame-v2.stl

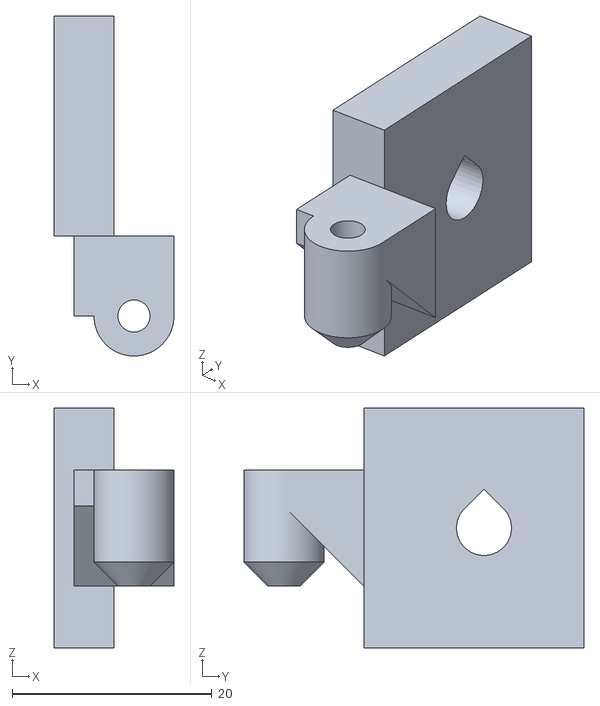
[picture p76: CAD file, 2026-09-22]
coupons/p5/knuckle-frame-v2.stl
12.0 x 34.0 x 24.0
