GarethCooke/SiglentTower/coupons/p6/pull-60-o14.stl

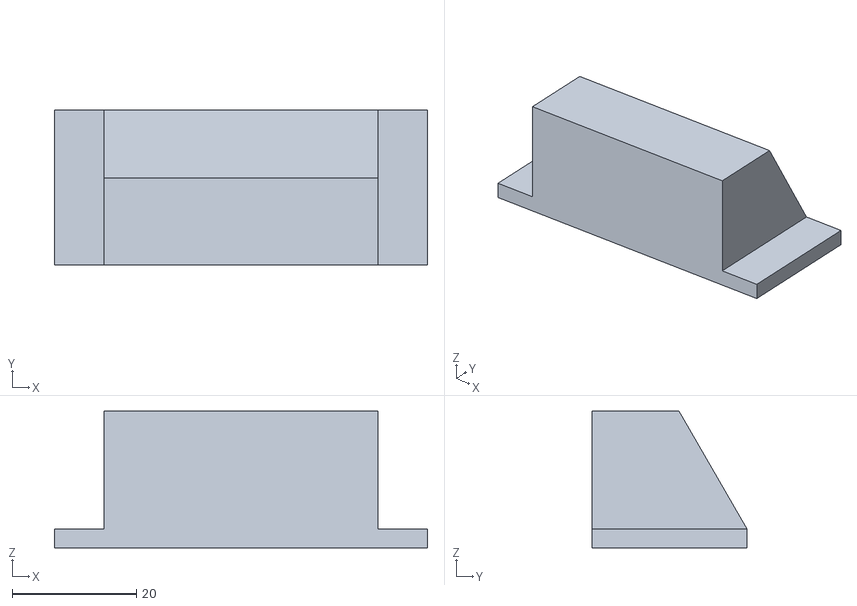
[picture p77: CAD file, 2026-09-19]
coupons/p6/pull-60-o14.stl
60.0 x 25.0 x 22.0
