GarethCooke/SiglentTower/coupons/p7/beam-front.stl

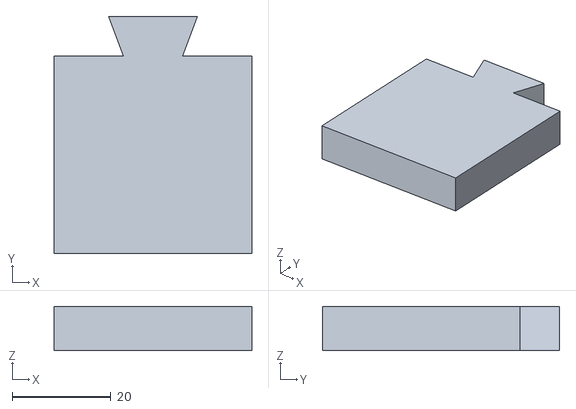
[picture p78: CAD file, 2026-09-15]
coupons/p7/beam-front.stl
40.0 x 48.0 x 9.00
