GarethCooke/SiglentTower/coupons/p8/awg-pad.stl

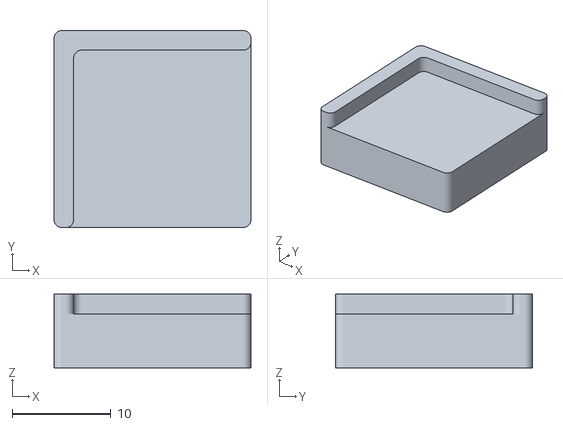
[picture p79: CAD file, 2026-09-22]
coupons/p8/awg-pad.stl
20.0 x 20.0 x 7.50
