GarethCooke/SiglentTower/coupons/p9/stand-jig.stl

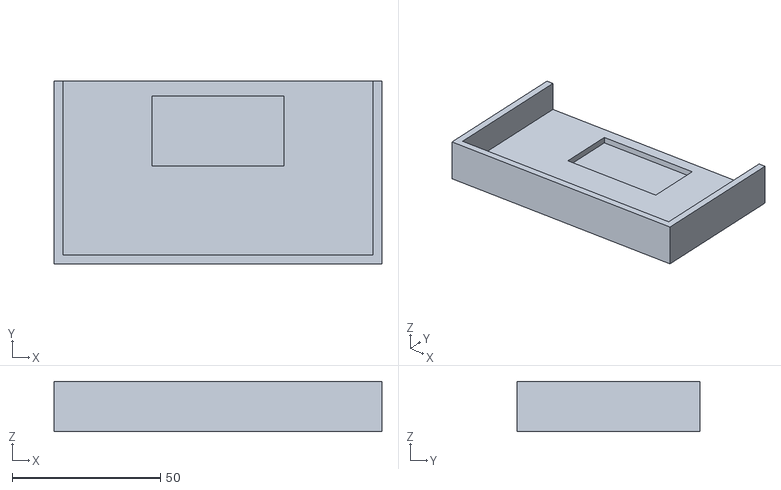
[picture p80: CAD file, 2026-09-24]
coupons/p9/stand-jig.stl
110.6 x 61.7 x 17.0
