GarethCooke/SiglentTower/coupons/spacers/spacer-63.5.stl

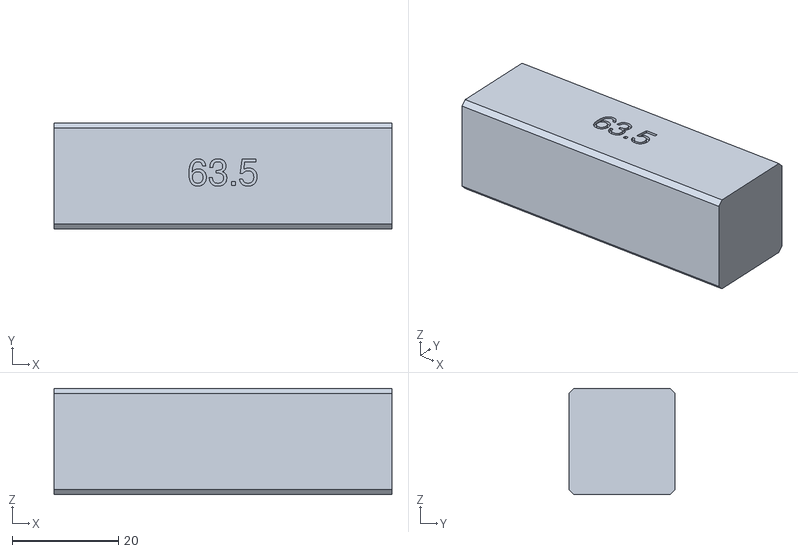
[picture p81: CAD file, 2026-09-16]
coupons/spacers/spacer-63.5.stl
63.5 x 20.0 x 20.0
