GarethCooke/SiglentTower/jigs/seat-jig-psu-L.stl

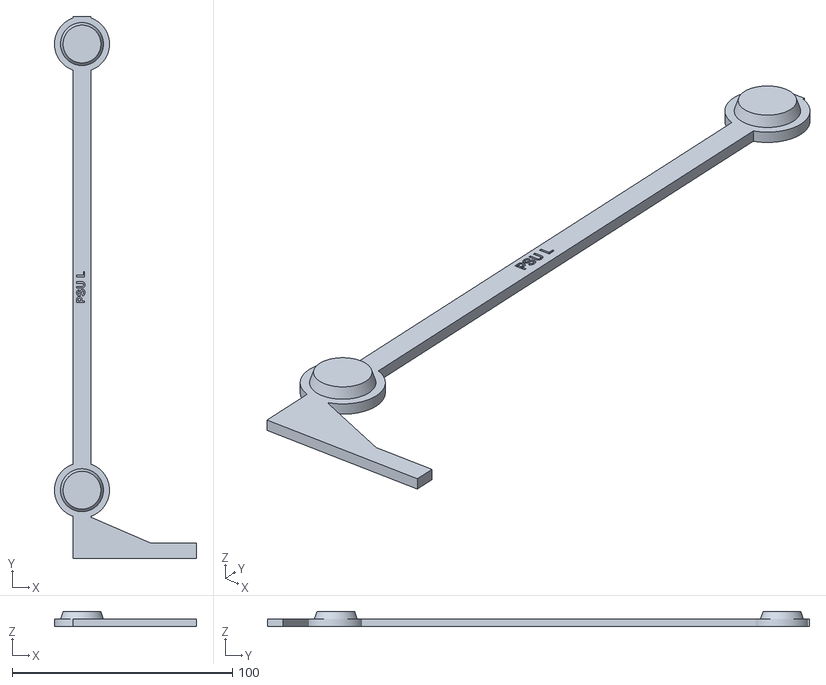
[picture p82: CAD file, 2026-09-28]
jigs/seat-jig-psu-L.stl
64.5 x 246.0 x 7.00
