GarethCooke/SiglentTower/parts/door/hinge-pins-v1.stl

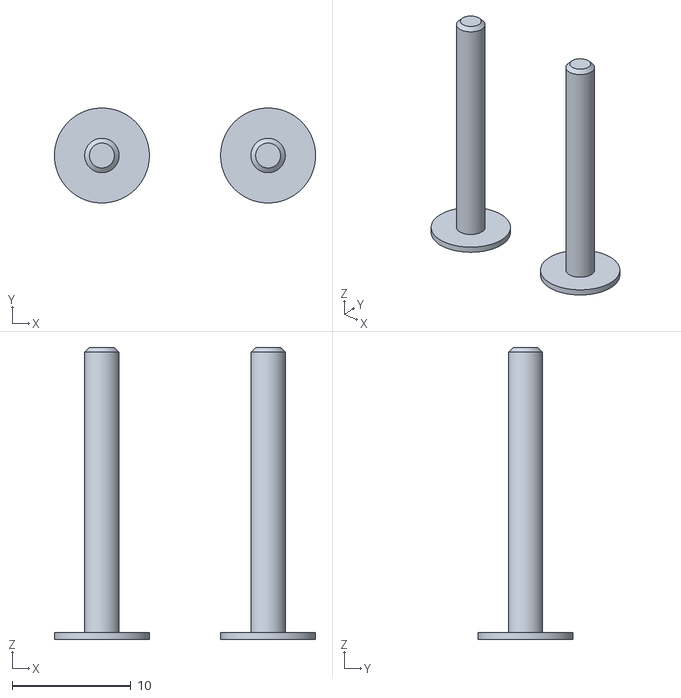
[picture p83: CAD file, 2026-10-20]
parts/door/hinge-pins-v1.stl
22.0 x 8.00 x 24.6
