GarethCooke/SiglentTower/parts/drawer/drawer-facia-v1.stl

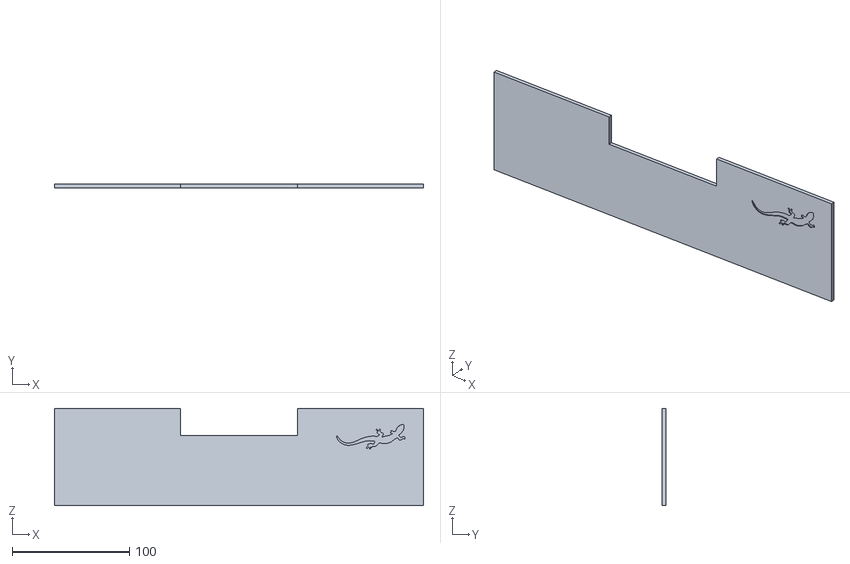
[picture p84: CAD file, 2026-10-02]
parts/drawer/drawer-facia-v1.stl
315.0 x 3.00 x 83.0
