GarethCooke/SiglentTower/parts/inserts/pull-inserts-plate-v3.stl

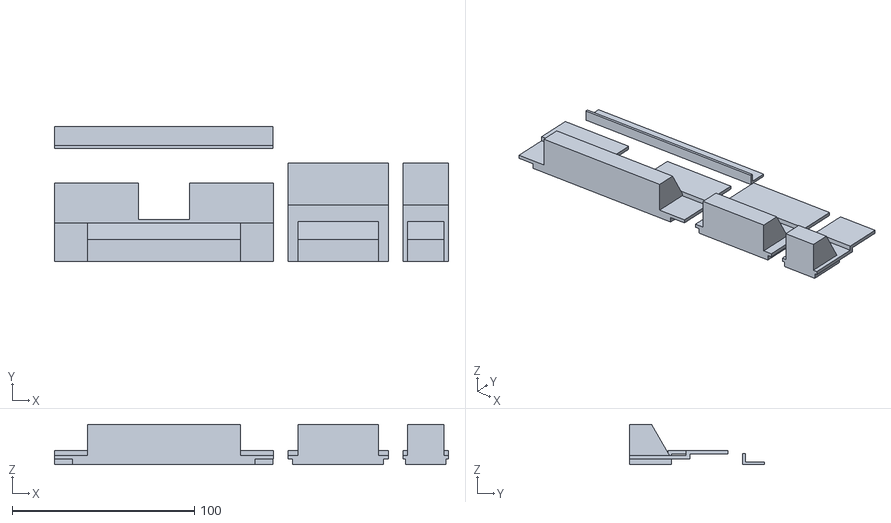
[picture p85: CAD file, 2026-10-09]
parts/inserts/pull-inserts-plate-v3.stl
216.0 x 73.8 x 22.0
