GarethCooke/SiglentTower/parts/mini/mini-slot-facia-v1.stl

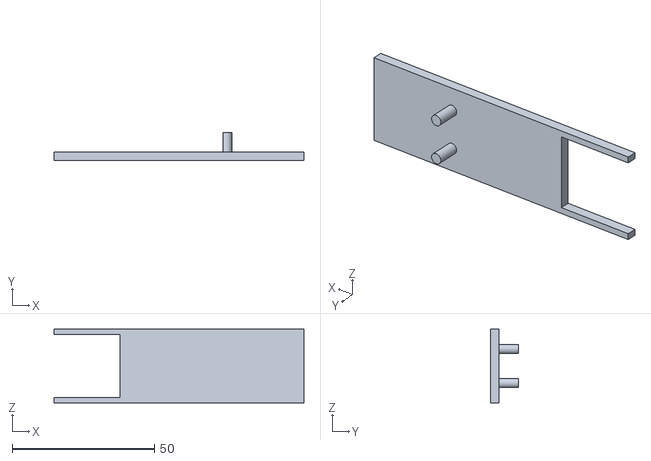
[picture p86: CAD file, 2026-10-11]
parts/mini/mini-slot-facia-v1.stl
88.0 x 10.0 x 26.0
