GarethCooke/SiglentTower/parts/sill/sill-block-left-v10.stl

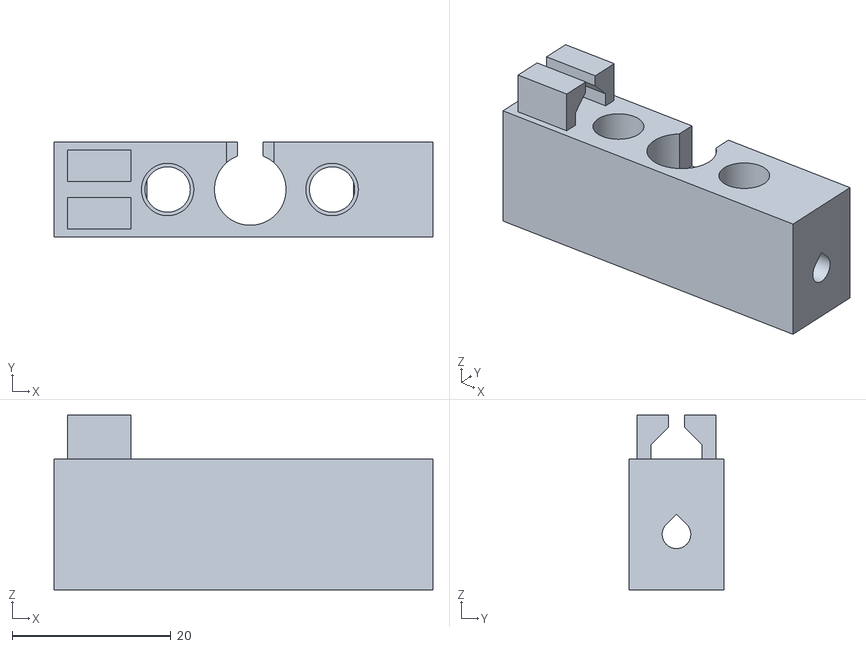
[picture p87: CAD file, 2026-10-27]
parts/sill/sill-block-left-v10.stl
47.7 x 12.0 x 22.0
