GarethCooke/SiglentTower/parts/strip-bracket-upper-v2.stl

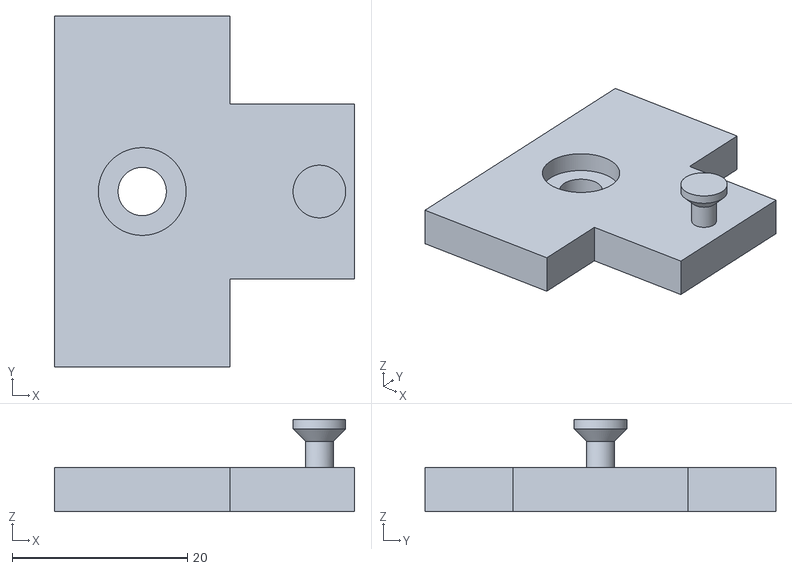
[picture p88: CAD file, 2026-10-23]
parts/strip-bracket-upper-v2.stl
34.2 x 40.0 x 10.5
