GarethCooke/SiglentTower/parts/wiring/board-enclosure-v1.stl

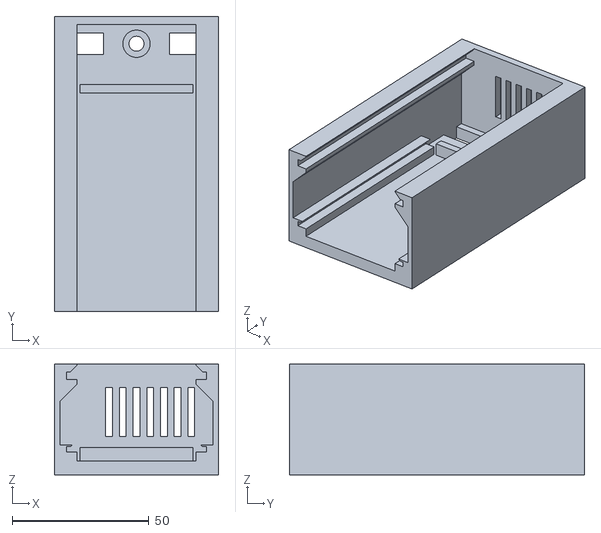
[picture p89: CAD file, 2026-10-26]
parts/wiring/board-enclosure-v1.stl
60.0 x 108.0 x 40.5
