GarethCooke/SiglentTower/bambu/01-coupons/pull-60.3mf

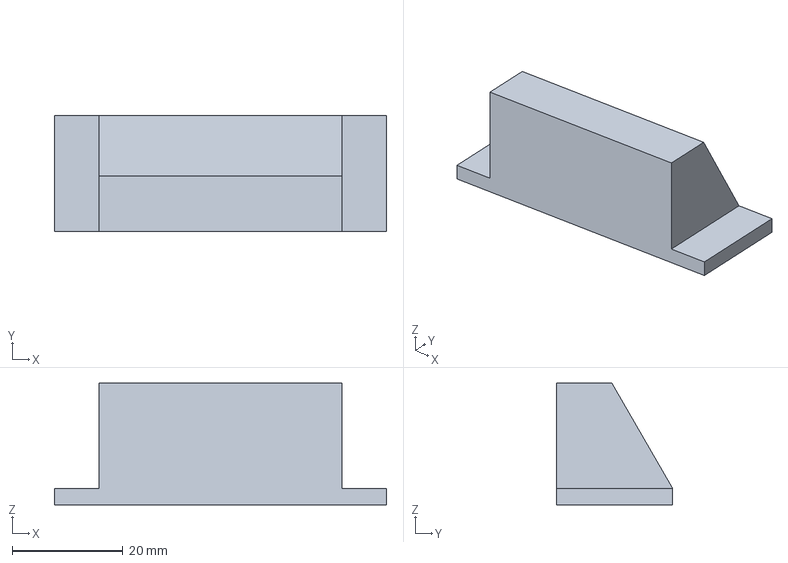
[picture p90: CAD file, 2026-09-19]
bambu/01-coupons/pull-60.3mf
60.0 x 21.0 x 22.0 mm
