GarethCooke/SiglentTower/bambu/parts/column/column-strip-upper-and-lower-v1.3mf

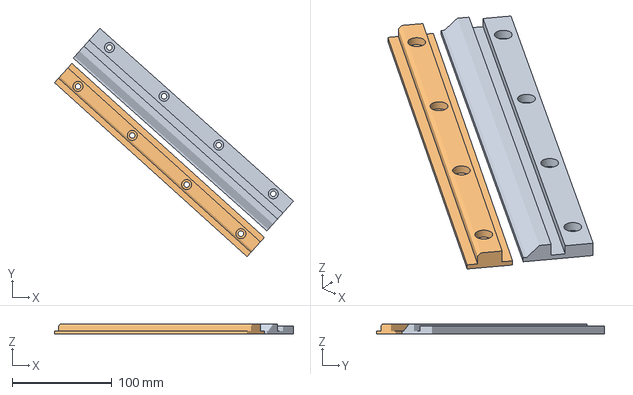
[picture p91: CAD file, 2026-10-08]
bambu/parts/column/column-strip-upper-and-lower-v1.3mf
239.4 x 228.8 x 9.70 mm
column-strip-lower-v1.stl
column-strip-upper-v1.stl
