GarethCooke/SiglentTower/bambu/parts/drawer/drawer-runner-300-v1.3mf

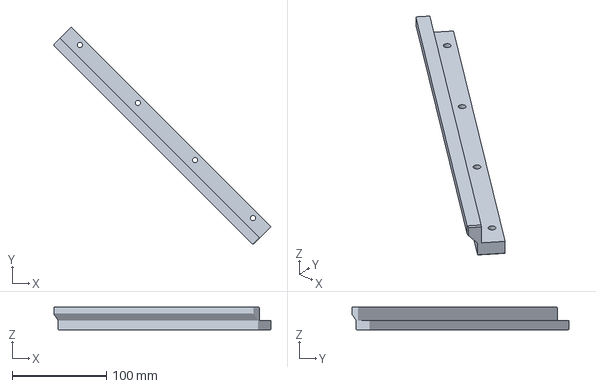
[picture p92: CAD file, 2026-10-01]
bambu/parts/drawer/drawer-runner-300-v1.3mf
230.5 x 230.5 x 24.0 mm
