GarethCooke/SiglentTower/bambu/parts/sill/sill-panel-v1.3mf

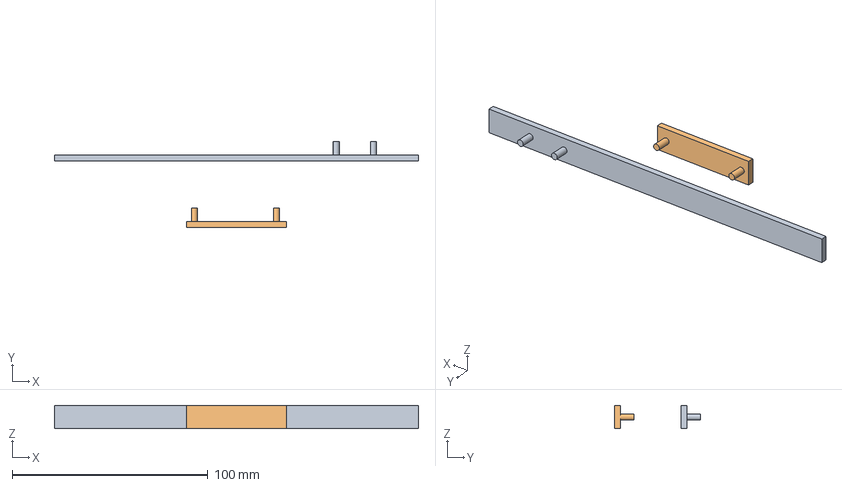
[picture p93: CAD file, 2026-10-12]
bambu/parts/sill/sill-panel-v1.3mf
186.0 x 44.0 x 12.0 mm
sill-panel-v1.stl_1
sill-panel-v1.stl_2
