GarethCooke/SiglentTower/bambu/parts/sled-cross-bar-front-and-rear-v2.3mf

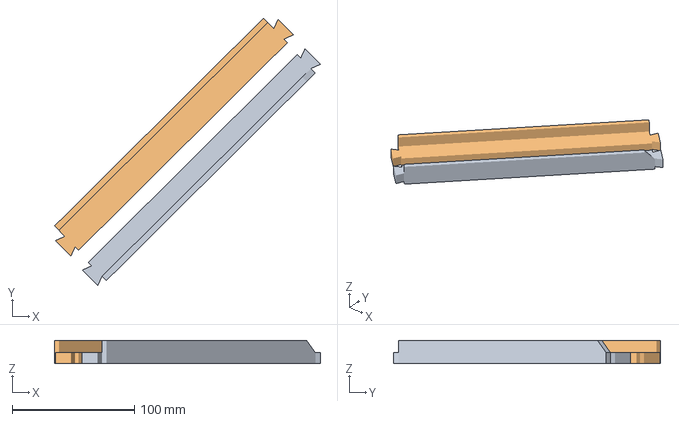
[picture p94: CAD file, 2026-10-08]
bambu/parts/sled-cross-bar-front-and-rear-v2.3mf
217.6 x 218.8 x 19.0 mm
sled-cross-bar-front-v2.stl
sled-cross-bar-rear-v2.stl
