GarethCooke/SiglentTower/bambu/parts/tiles/tiles-plate-C.3mf

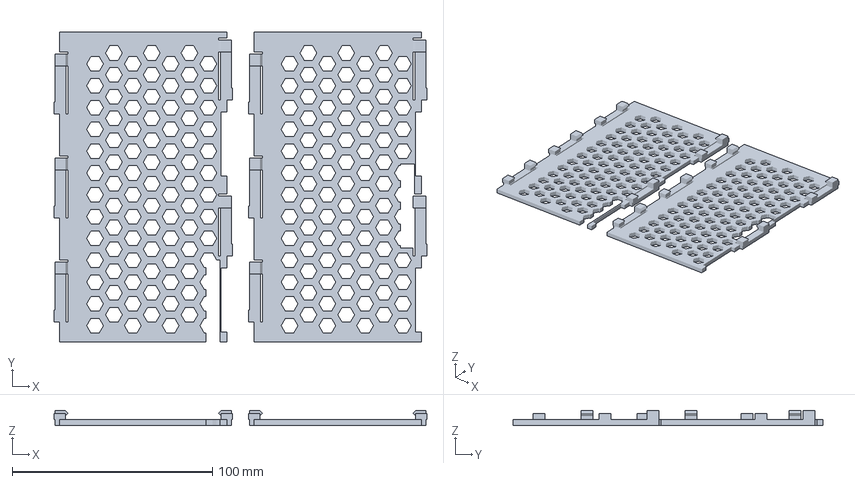
[picture p95: CAD file, 2026-09-27]
bambu/parts/tiles/tiles-plate-C.3mf
186.4 x 155.0 x 7.35 mm
