GarethCooke/SiglentTower/coupons/p1/p1-feet-v4.stl

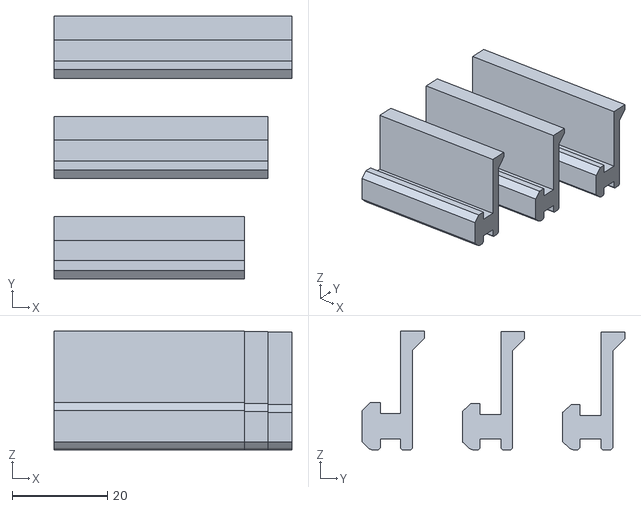
[picture p96: CAD file, 2026-09-19]
coupons/p1/p1-feet-v4.stl
50.0 x 55.2 x 25.0
