GarethCooke/SiglentTower/coupons/p4/strip-band3-plus5.stl

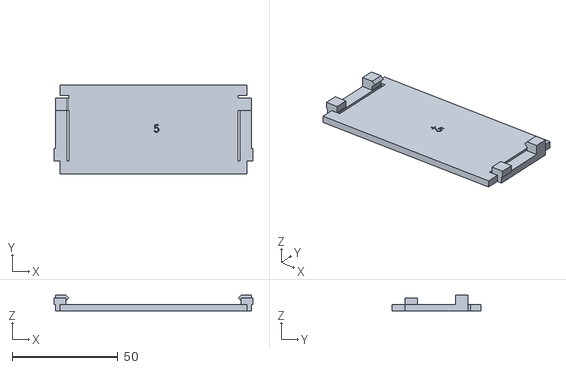
[picture p97: CAD file, 2026-10-12]
coupons/p4/strip-band3-plus5.stl
94.2 x 42.0 x 7.35
