GarethCooke/SiglentTower/coupons/p5/p5-v2-plate.stl

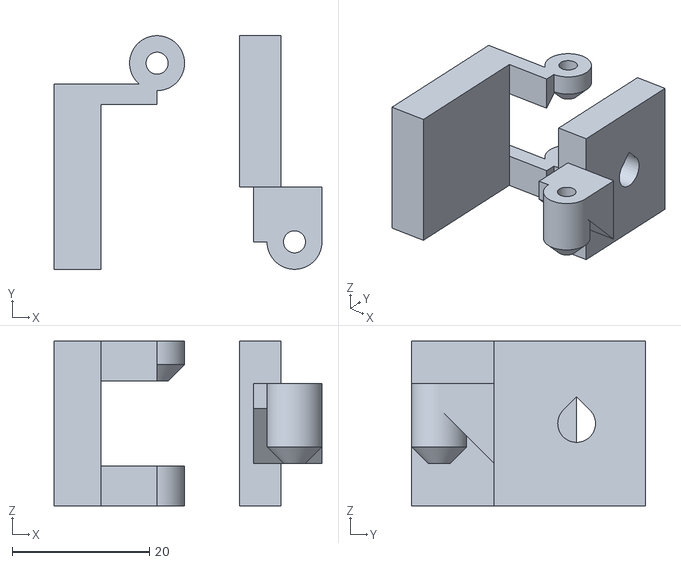
[picture p98: CAD file, 2026-09-22]
coupons/p5/p5-v2-plate.stl
39.0 x 34.0 x 24.0
