GarethCooke/SiglentTower/coupons/p6/facia-80-o14.stl

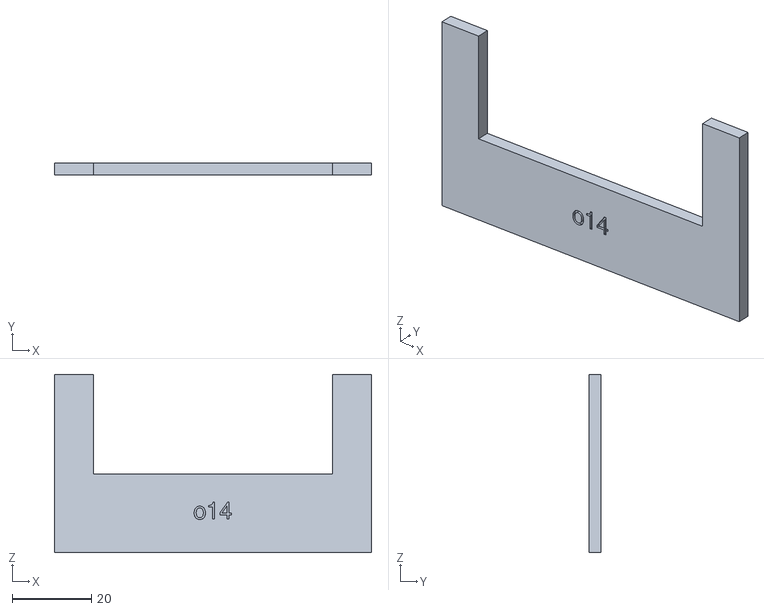
[picture p99: CAD file, 2026-09-19]
coupons/p6/facia-80-o14.stl
80.0 x 3.00 x 45.0
