GarethCooke/SiglentTower/coupons/p7/cross-Q3.stl

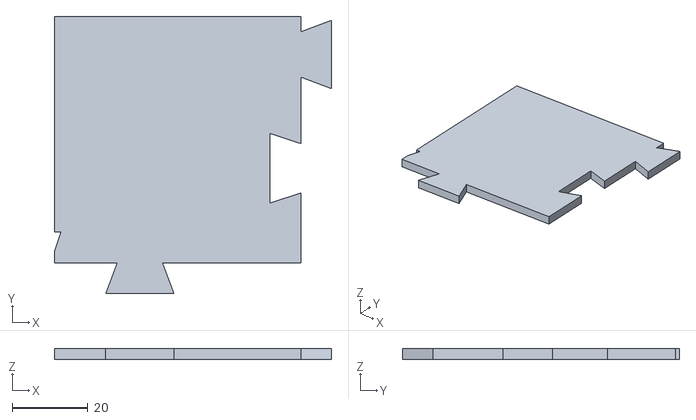
[picture p100: CAD file, 2026-09-15]
coupons/p7/cross-Q3.stl
73.0 x 73.0 x 3.00
