GarethCooke/SiglentTower/coupons/p8/p8-plate.stl

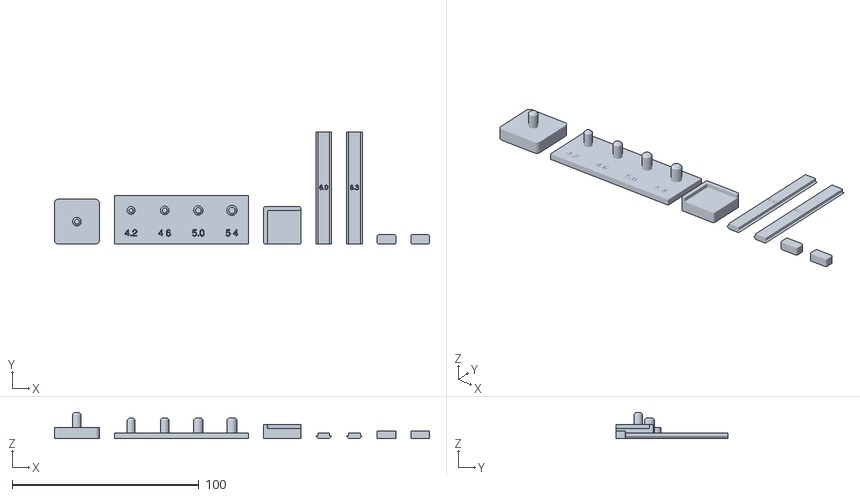
[picture p101: CAD file, 2026-09-22]
coupons/p8/p8-plate.stl
200.8 x 60.0 x 14.0
