GarethCooke/SiglentTower/coupons/p9/bumper-jig.stl

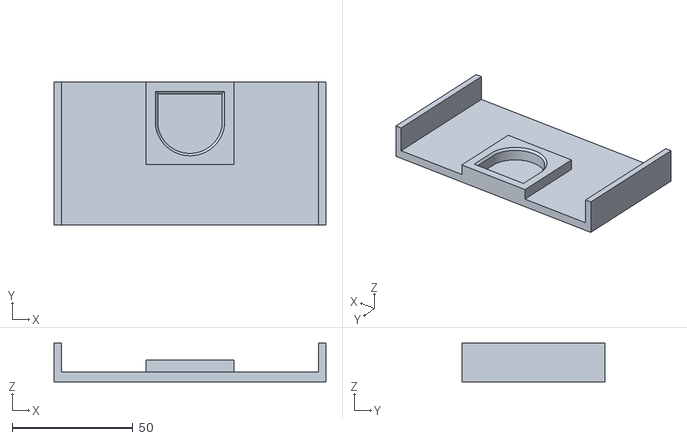
[picture p102: CAD file, 2026-09-24]
coupons/p9/bumper-jig.stl
112.5 x 59.3 x 16.0
