GarethCooke/SiglentTower/coupons/spacers/gauge-3.0.stl

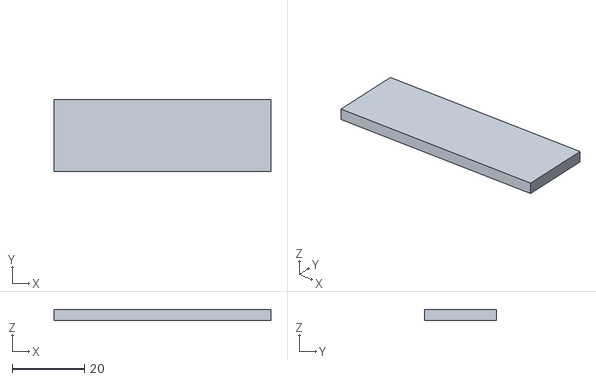
[picture p103: CAD file, 2026-09-16]
coupons/spacers/gauge-3.0.stl
60.0 x 20.0 x 3.00
