GarethCooke/SiglentTower/jigs/seating-jigs-plate.stl

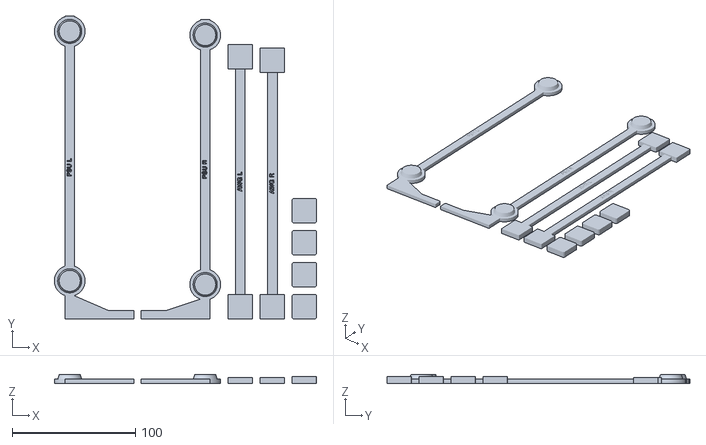
[picture p104: CAD file, 2026-09-28]
jigs/seating-jigs-plate.stl
213.0 x 246.0 x 7.00
