GarethCooke/SiglentTower/parts/door/rear-tile-v2.stl

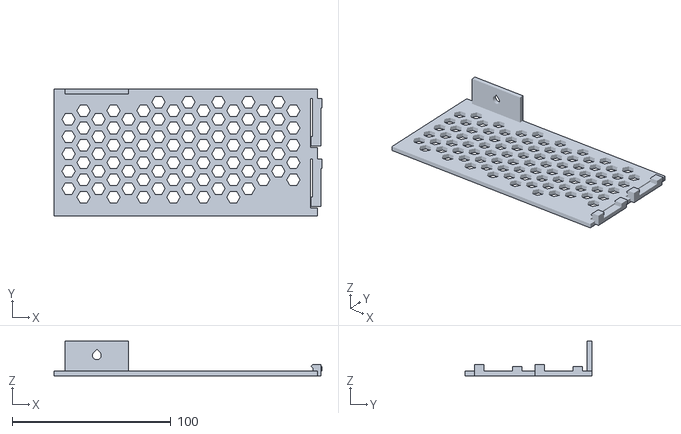
[picture p105: CAD file, 2026-10-19]
parts/door/rear-tile-v2.stl
168.9 x 80.0 x 22.0
