GarethCooke/SiglentTower/parts/inserts/pull-insert-mini-v2.stl

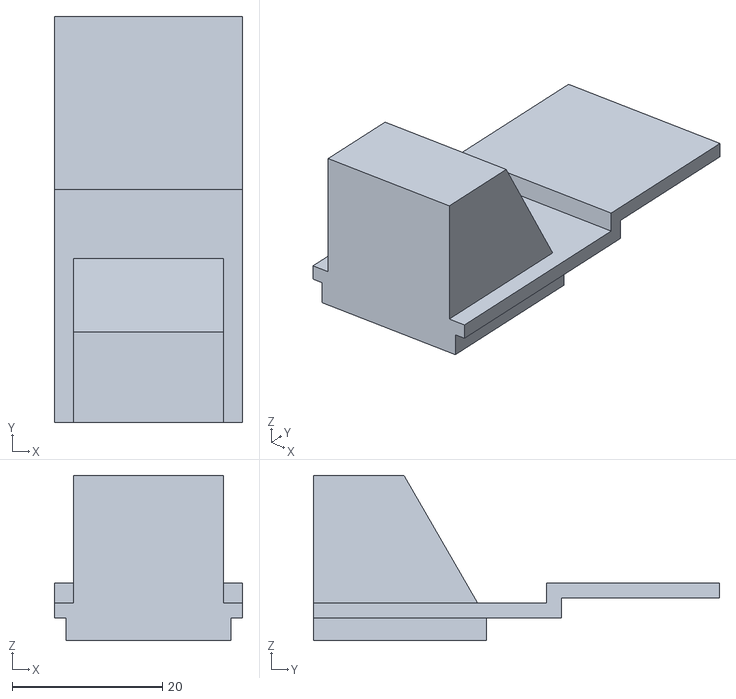
[picture p106: CAD file, 2026-10-09]
parts/inserts/pull-insert-mini-v2.stl
25.0 x 54.0 x 22.0
