GarethCooke/SiglentTower/parts/mini/mini-slot-body-v1.stl

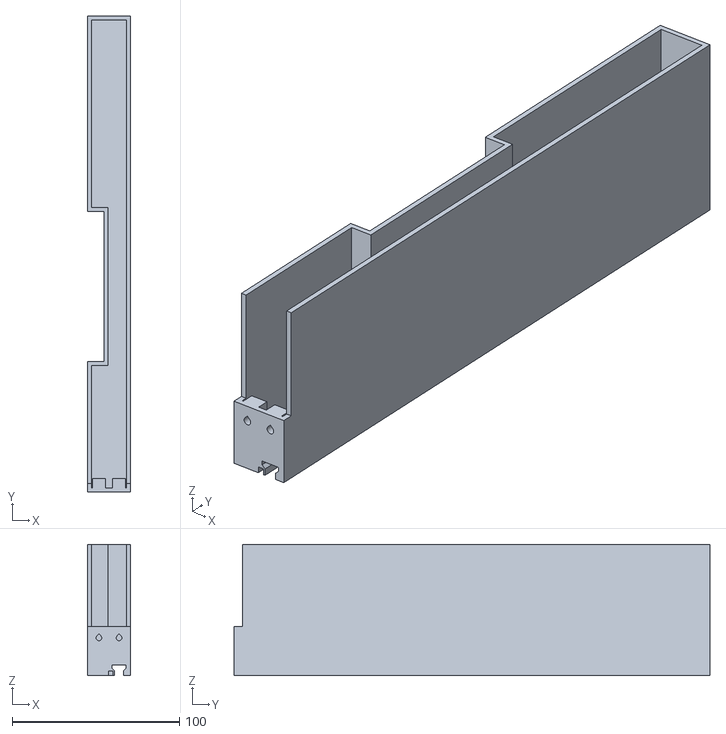
[picture p107: CAD file, 2026-10-11]
parts/mini/mini-slot-body-v1.stl
26.0 x 285.0 x 78.5
