GarethCooke/SiglentTower/parts/sill/sill-block-right-v4.stl

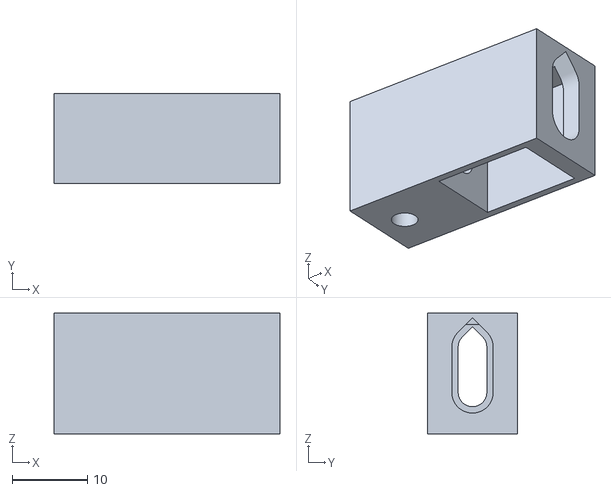
[picture p108: CAD file, 2026-10-16]
parts/sill/sill-block-right-v4.stl
30.0 x 12.0 x 16.0
