GarethCooke/SiglentTower/parts/tiles/tile-band3-LR-v2.stl

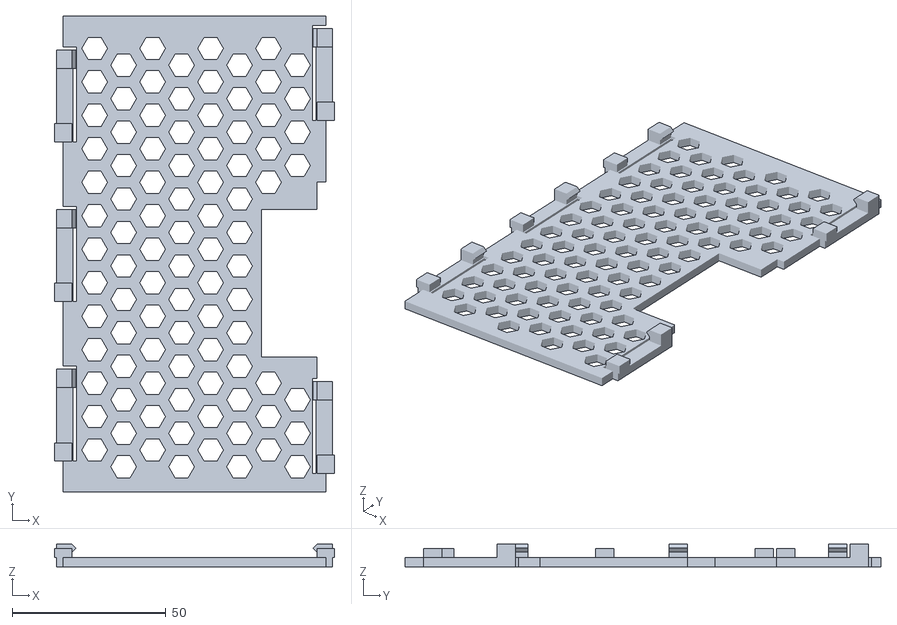
[picture p109: CAD file, 2026-10-14]
parts/tiles/tile-band3-LR-v2.stl
91.2 x 155.0 x 7.35
