GarethCooke/SiglentTower/parts/tpu/sled-stop-cap-v1.stl

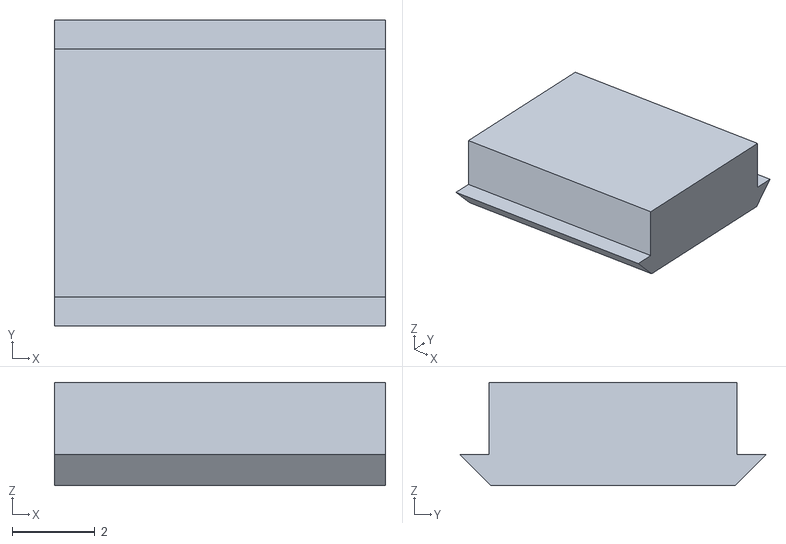
[picture p110: CAD file, 2026-10-12]
parts/tpu/sled-stop-cap-v1.stl
8.00 x 7.40 x 2.50
