GarethCooke/SiglentTower/bambu/01-coupons/p9-plate.3mf

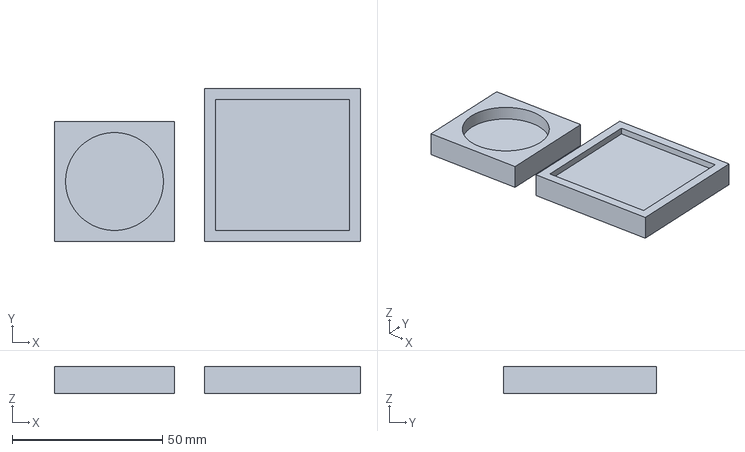
[picture p111: CAD file, 2026-09-19]
bambu/01-coupons/p9-plate.3mf
102.0 x 51.0 x 9.00 mm
