GarethCooke/SiglentTower/bambu/parts/column/column-drawer-v1.3mf

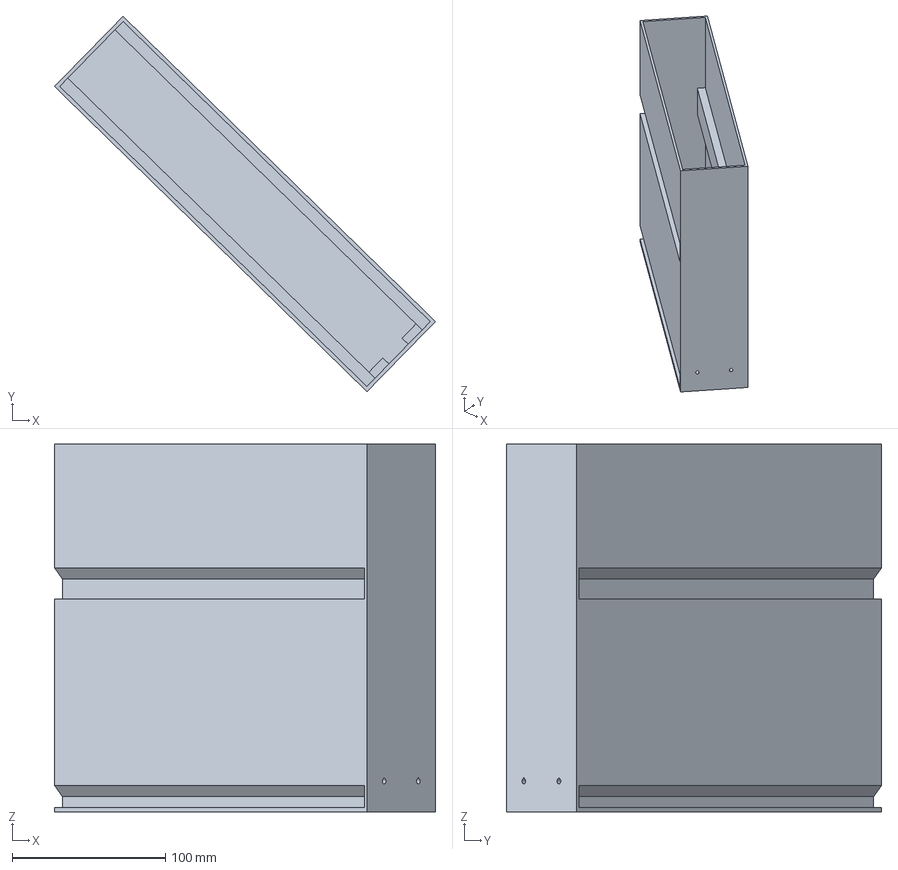
[picture p112: CAD file, 2026-10-08]
bambu/parts/column/column-drawer-v1.3mf
248.6 x 244.9 x 240.0 mm
