GarethCooke/SiglentTower/bambu/parts/rear-box-right-v1.3mf

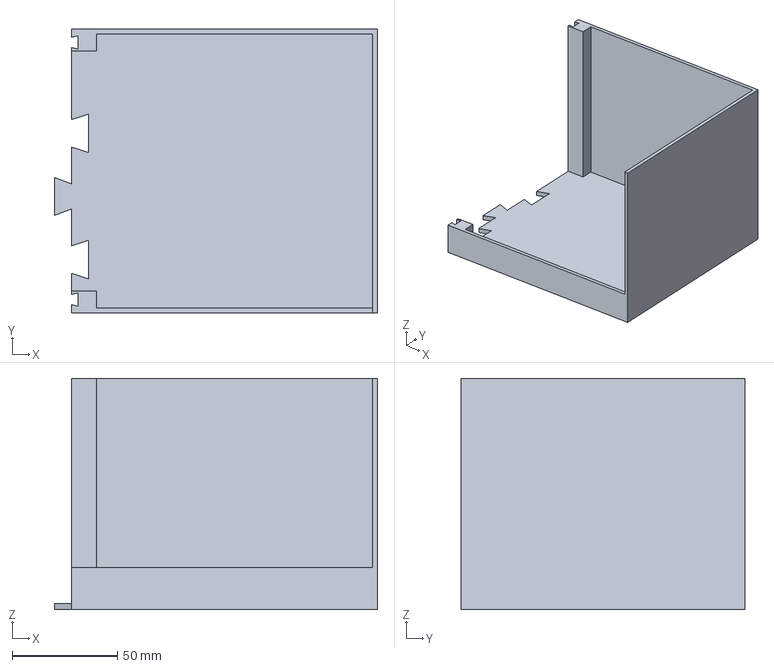
[picture p114: CAD file, 2026-10-04]
bambu/parts/rear-box-right-v1.3mf
153.5 x 135.0 x 110.0 mm
