GarethCooke/SiglentTower/bambu/parts/sill/sill-panel-window-v1.3mf

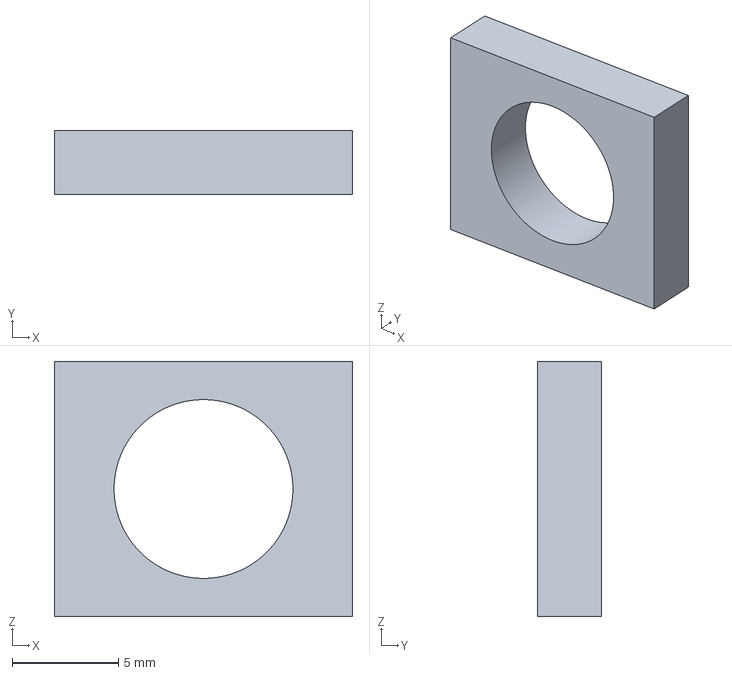
[picture p115: CAD file, 2026-10-12]
bambu/parts/sill/sill-panel-window-v1.3mf
14.0 x 3.00 x 12.0 mm
