GarethCooke/SiglentTower/coupons/p1/beam-40.stl

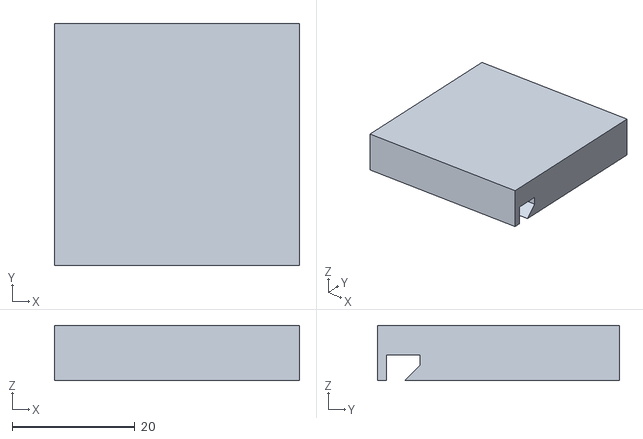
[picture p116: CAD file, 2026-09-19]
coupons/p1/beam-40.stl
40.0 x 39.5 x 9.00
