GarethCooke/SiglentTower/coupons/p4/band3-right-sweep.stl

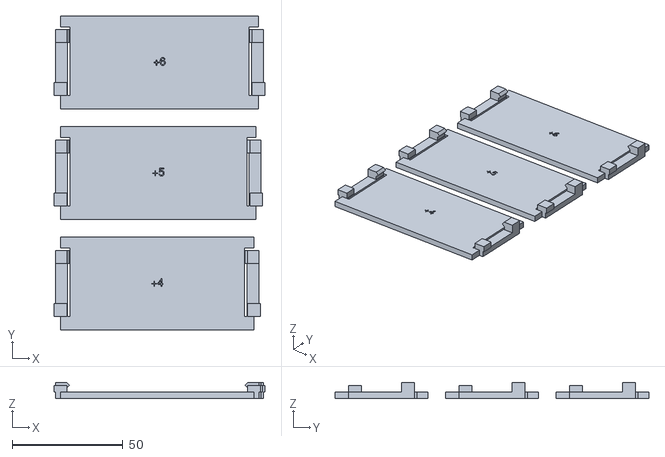
[picture p117: CAD file, 2026-10-12]
coupons/p4/band3-right-sweep.stl
95.2 x 142.0 x 7.35
