GarethCooke/SiglentTower/coupons/p5/pin-3.0.stl

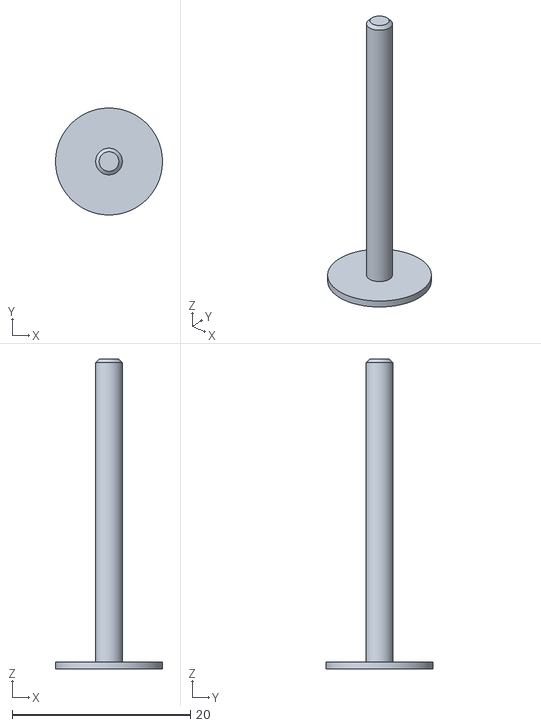
[picture p118: CAD file, 2026-09-22]
coupons/p5/pin-3.0.stl
12.0 x 12.0 x 34.8
