GarethCooke/SiglentTower/coupons/p6/pull-60-o12.stl

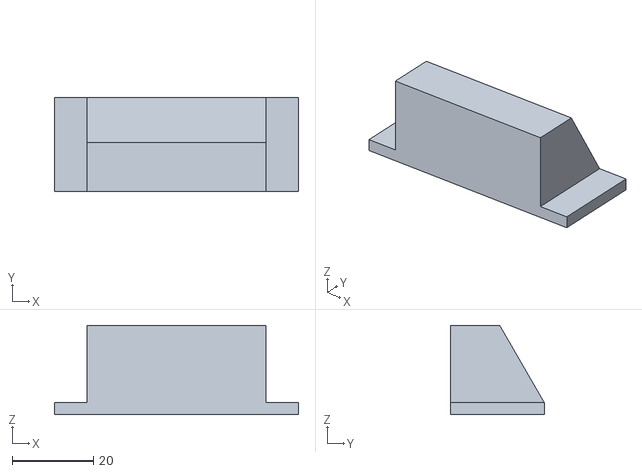
[picture p119: CAD file, 2026-09-19]
coupons/p6/pull-60-o12.stl
60.0 x 23.0 x 22.0
