GarethCooke/SiglentTower/coupons/p7/p7-plate.stl

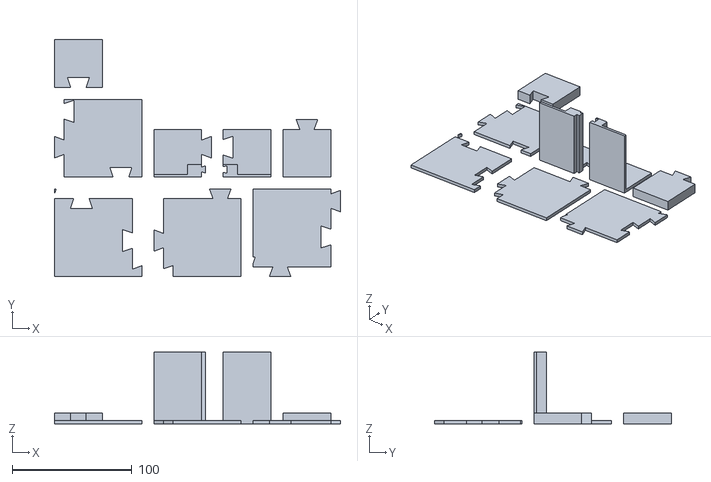
[picture p120: CAD file, 2026-09-15]
coupons/p7/p7-plate.stl
239.0 x 198.0 x 60.0
