GarethCooke/SiglentTower/coupons/p8/slot-cover-60-w60.stl

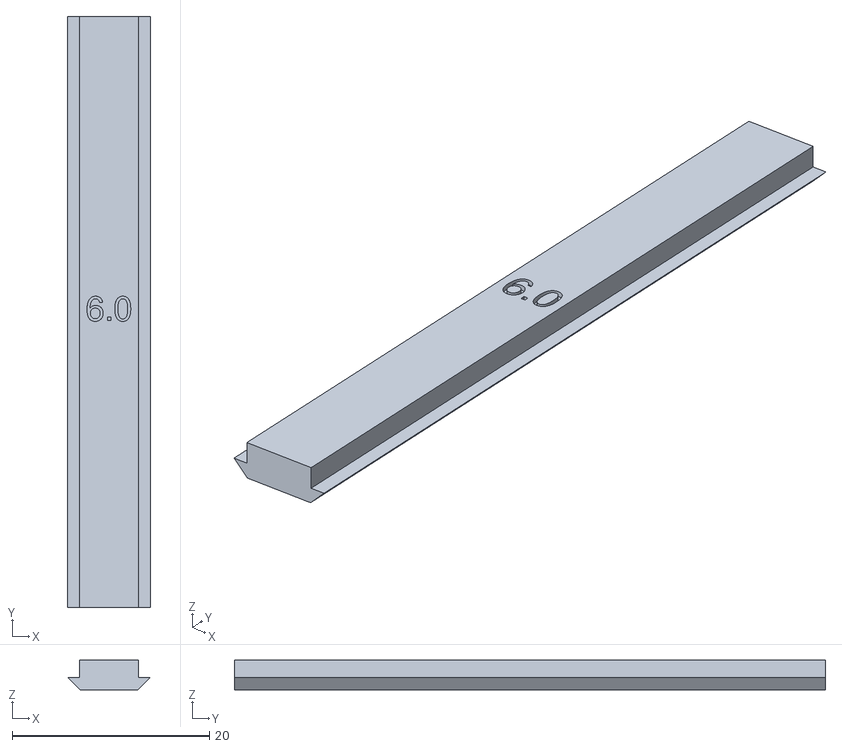
[picture p121: CAD file, 2026-09-22]
coupons/p8/slot-cover-60-w60.stl
8.40 x 60.0 x 3.00
