GarethCooke/SiglentTower/coupons/p9/p9-cups-v3.stl

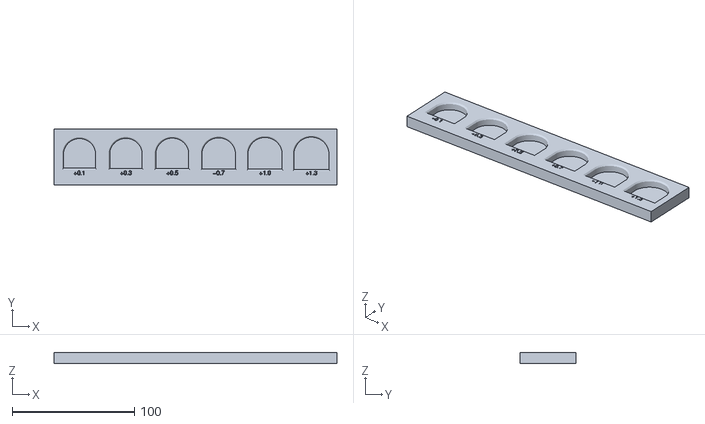
[picture p122: CAD file, 2026-09-19]
coupons/p9/p9-cups-v3.stl
231.9 x 46.0 x 9.00
