GarethCooke/SiglentTower/coupons/spacers/spacers-plate.stl

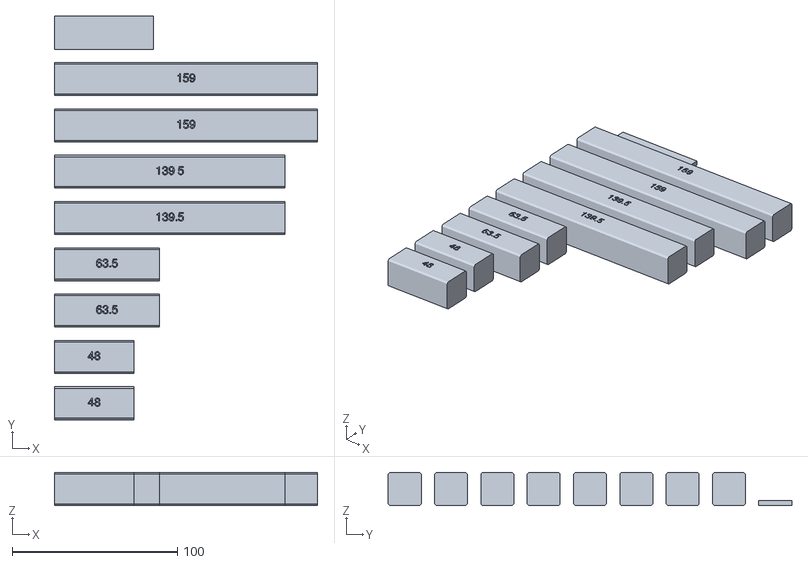
[picture p123: CAD file, 2026-09-16]
coupons/spacers/spacers-plate.stl
159.0 x 244.0 x 20.0
