GarethCooke/SiglentTower/jigs/seat-jig-awg-L.stl

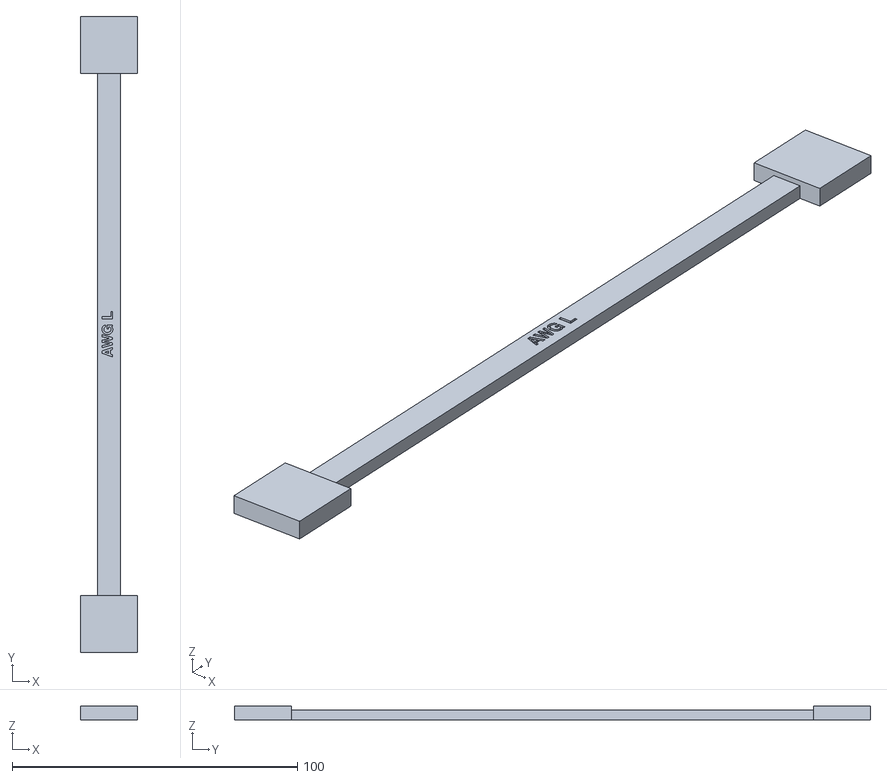
[picture p124: CAD file, 2026-09-28]
jigs/seat-jig-awg-L.stl
20.0 x 223.0 x 4.90
