GarethCooke/SiglentTower/parts/column/column-strip-lower-v1.stl

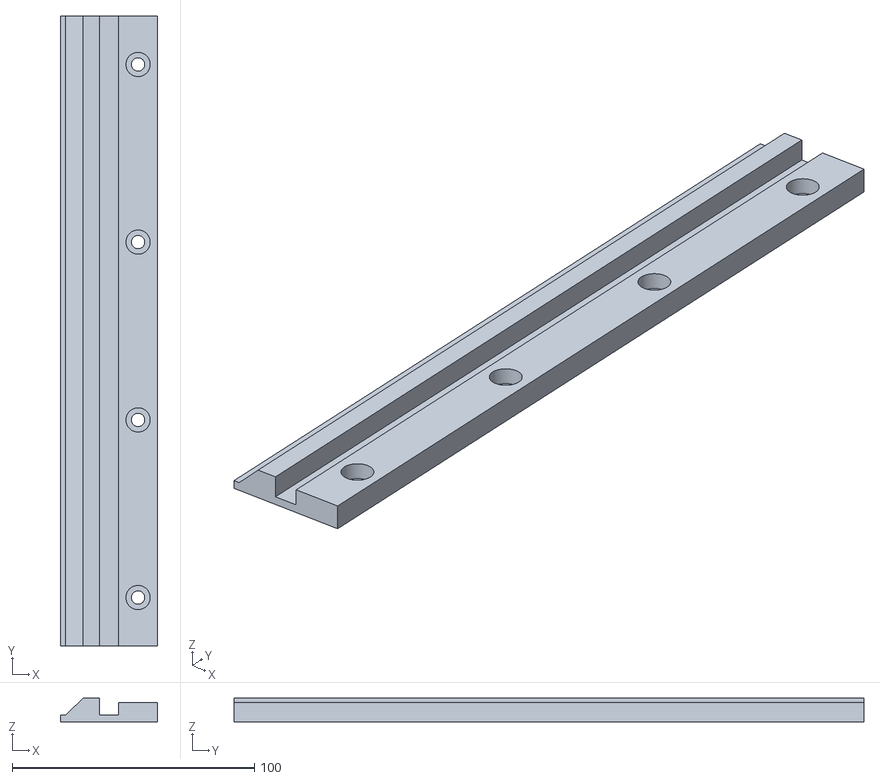
[picture p125: CAD file, 2026-10-04]
parts/column/column-strip-lower-v1.stl
40.0 x 260.0 x 9.70
