GarethCooke/SiglentTower/parts/door/magnet-bracket-front-v2.stl

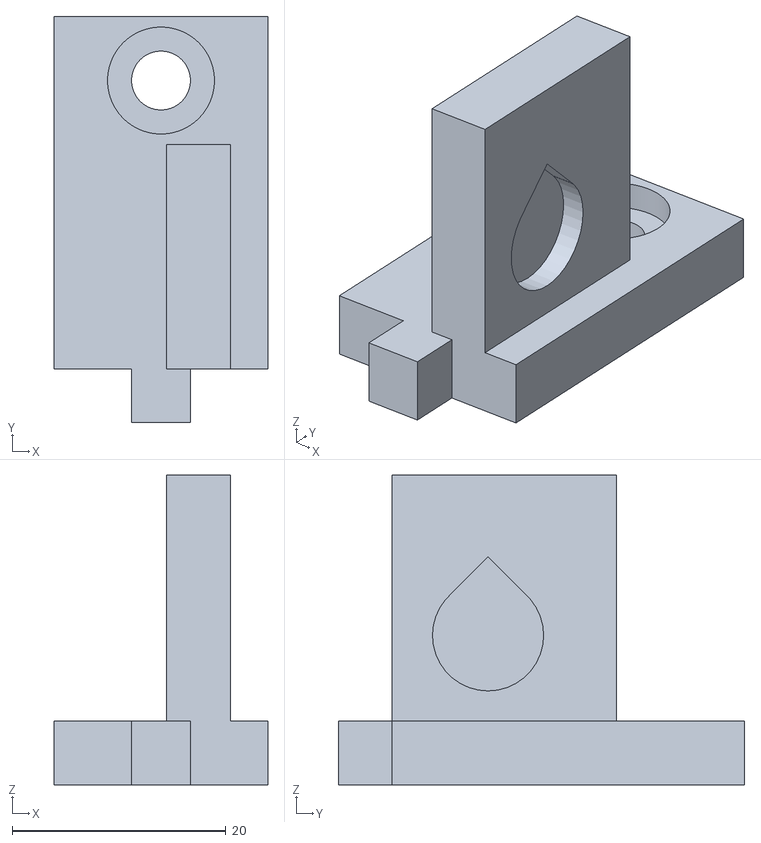
[picture p126: CAD file, 2026-10-19]
parts/door/magnet-bracket-front-v2.stl
20.0 x 38.0 x 29.0
