GarethCooke/SiglentTower/parts/hinge-door-v2.stl

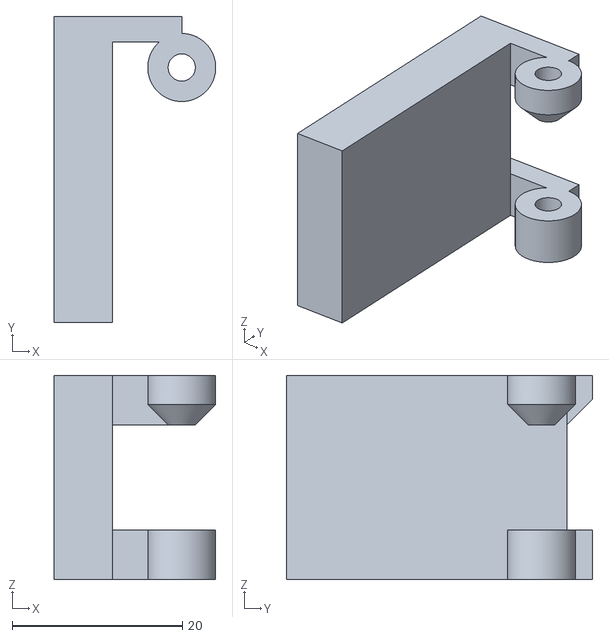
[picture p127: CAD file, 2026-10-20]
parts/hinge-door-v2.stl
19.0 x 36.0 x 24.0
