GarethCooke/SiglentTower/parts/inserts/pull-insert-bottom-v2.stl

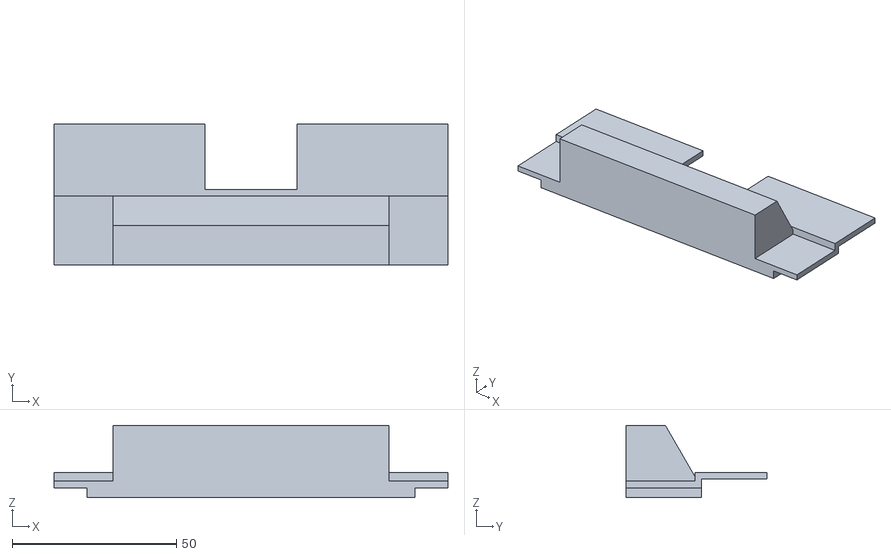
[picture p128: CAD file, 2026-10-09]
parts/inserts/pull-insert-bottom-v2.stl
120.0 x 43.0 x 22.0
