GarethCooke/SiglentTower/parts/sill/sill-panel-v3.stl

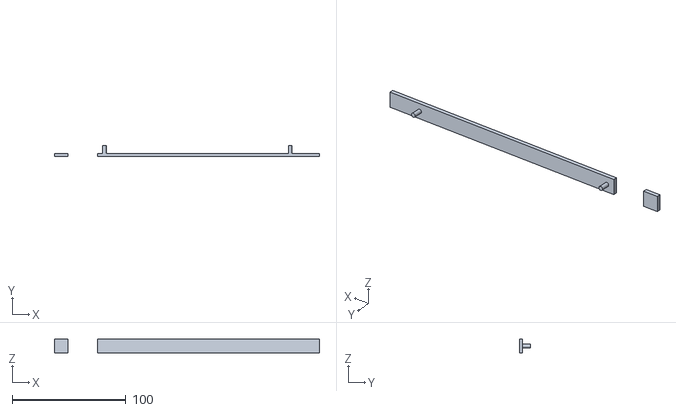
[picture p129: CAD file, 2026-10-13]
parts/sill/sill-panel-v3.stl
233.4 x 10.0 x 12.0
