GarethCooke/SiglentTower/parts/tiles/tiles-plate-B2.stl

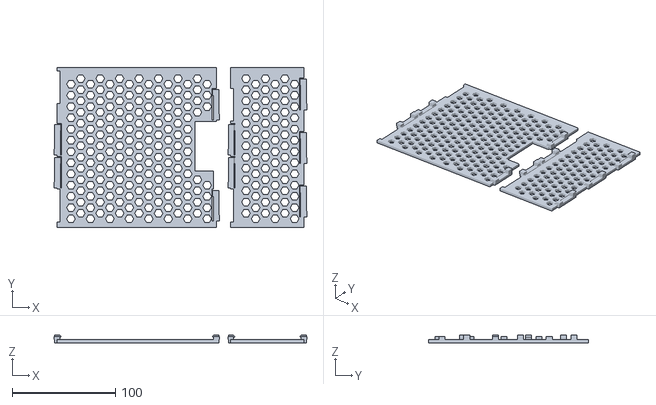
[picture p130: CAD file, 2026-10-14]
parts/tiles/tiles-plate-B2.stl
245.6 x 155.0 x 7.35
