GarethCooke/SiglentTower/parts/tpu/awg-pad-right-v1.stl

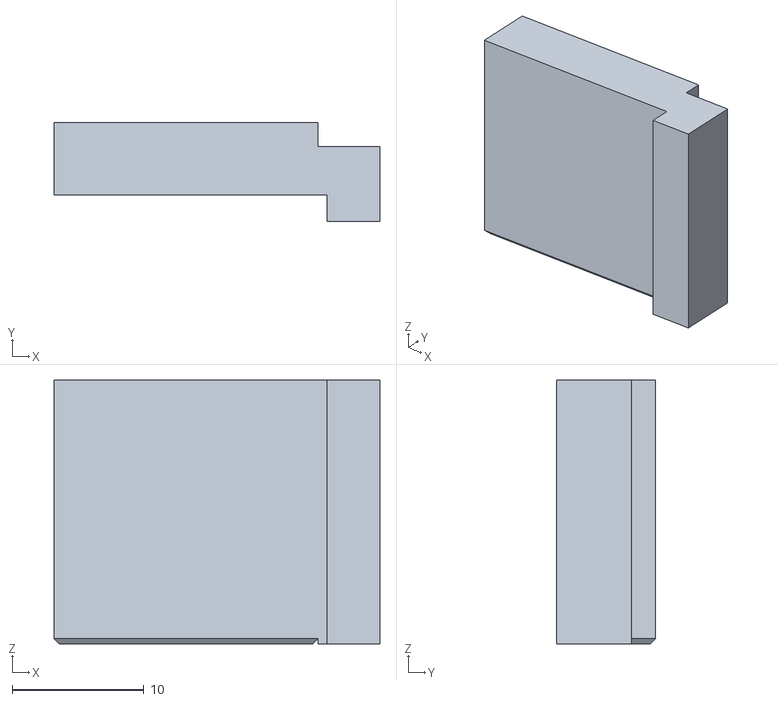
[picture p131: CAD file, 2026-10-12]
parts/tpu/awg-pad-right-v1.stl
24.7 x 7.50 x 20.0
