GarethCooke/SiglentTower/bambu/parts/column/column-strip-upper-v1.3mf

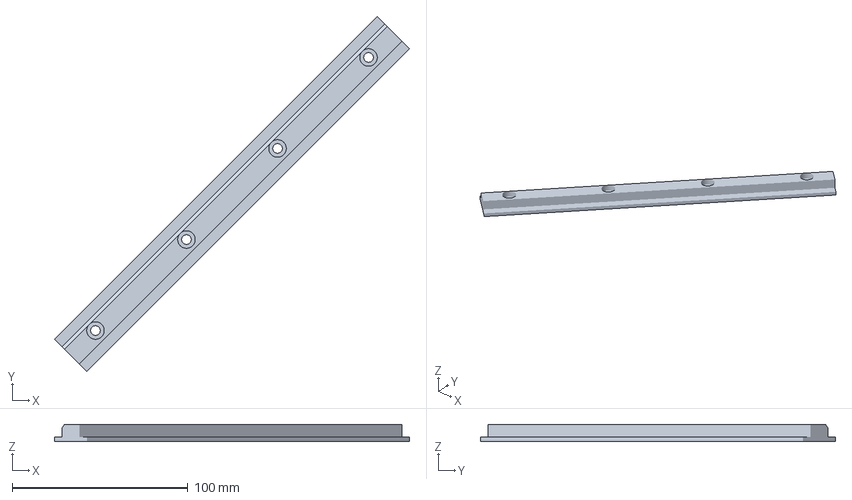
[picture p132: CAD file, 2026-10-04]
bambu/parts/column/column-strip-upper-v1.3mf
202.2 x 202.2 x 9.70 mm
