GarethCooke/SiglentTower/bambu/parts/drawer/drawer-Q1-v1.3mf

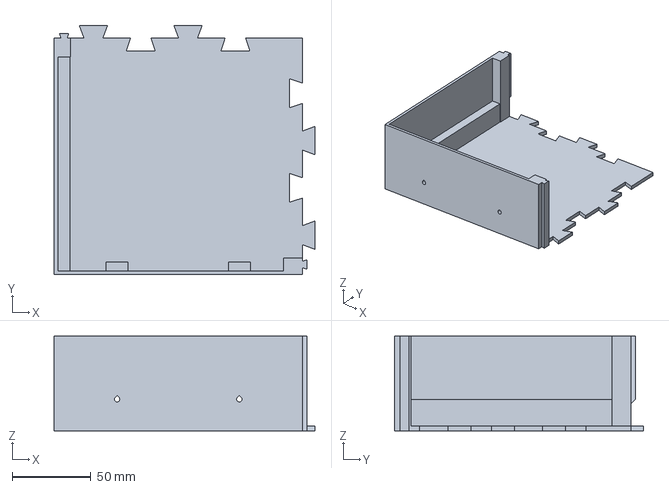
[picture p133: CAD file, 2026-09-30]
bambu/parts/drawer/drawer-Q1-v1.3mf
165.5 x 158.0 x 60.0 mm
