GarethCooke/SiglentTower/bambu/parts/psu-cradle-right-front-v5.3mf

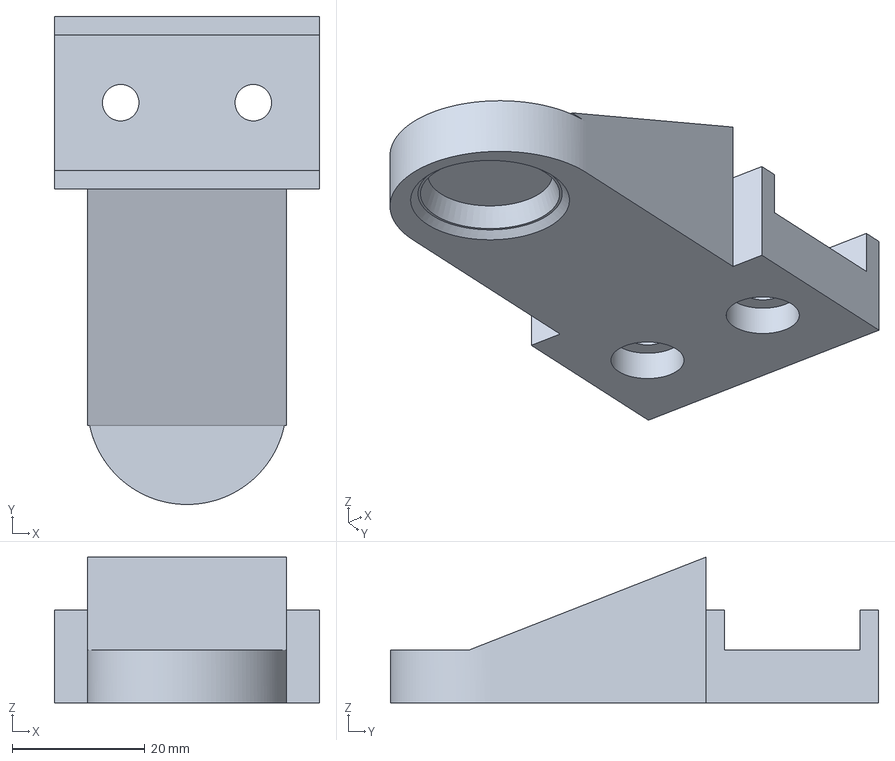
[picture p134: CAD file, 2026-10-04]
bambu/parts/psu-cradle-right-front-v5.3mf
40.0 x 73.6 x 22.0 mm
