GarethCooke/SiglentTower/coupons/p4/tile-band2-crop.stl

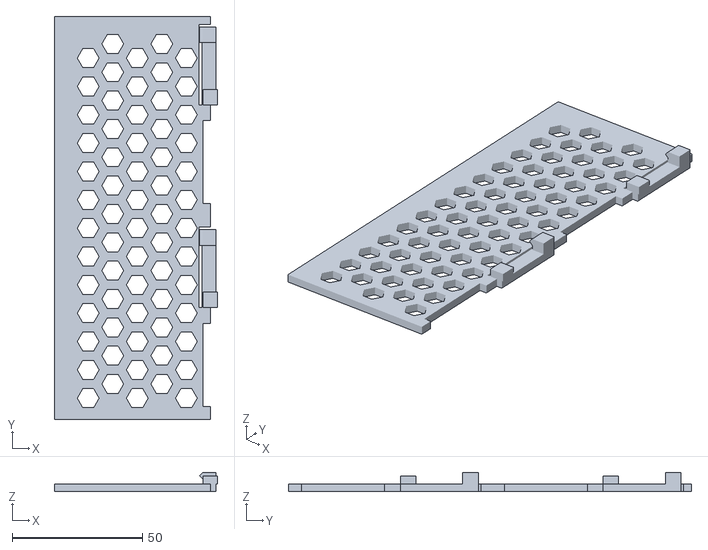
[picture p135: CAD file, 2026-09-22]
coupons/p4/tile-band2-crop.stl
62.8 x 155.0 x 7.35
