GarethCooke/SiglentTower/coupons/p6/facia-80-o12.stl

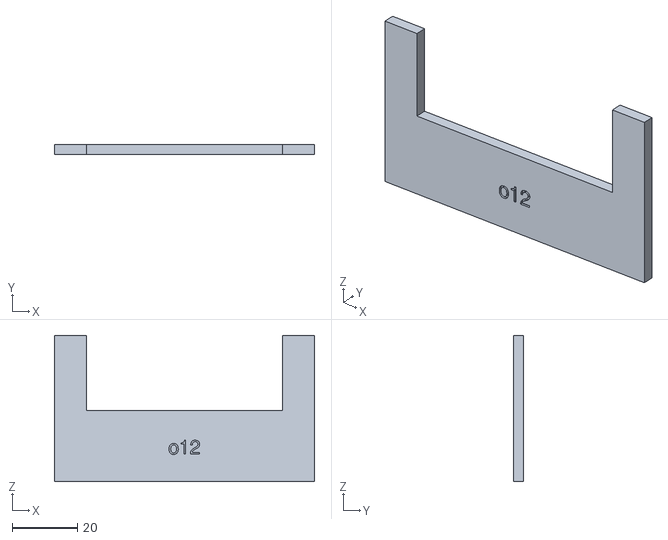
[picture p136: CAD file, 2026-09-19]
coupons/p6/facia-80-o12.stl
80.0 x 3.00 x 45.0
