GarethCooke/SiglentTower/coupons/p7/wall-Q1.stl

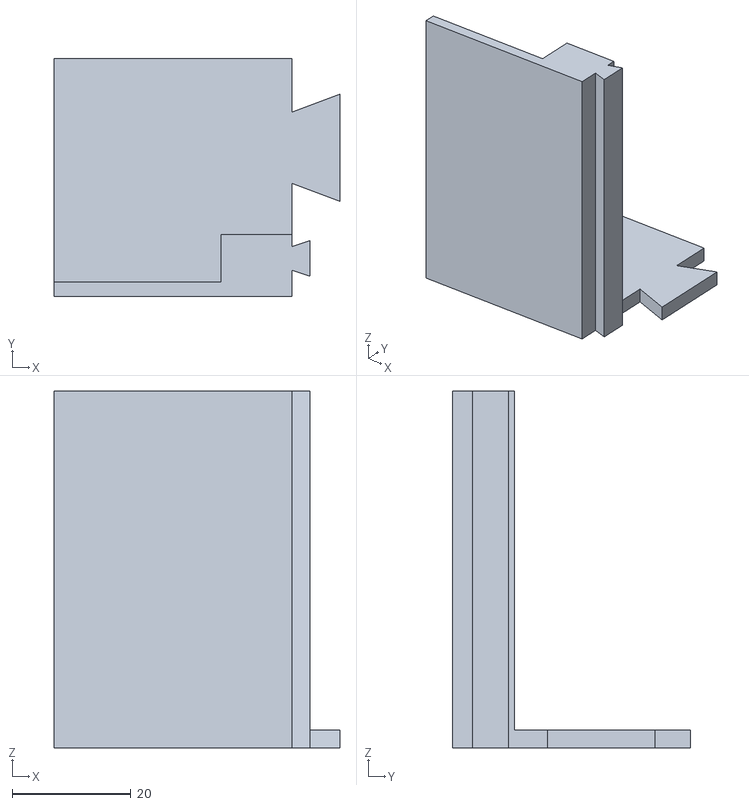
[picture p137: CAD file, 2026-09-15]
coupons/p7/wall-Q1.stl
48.0 x 40.0 x 60.0
