GarethCooke/SiglentTower/coupons/p9/p9-v3-plate.stl

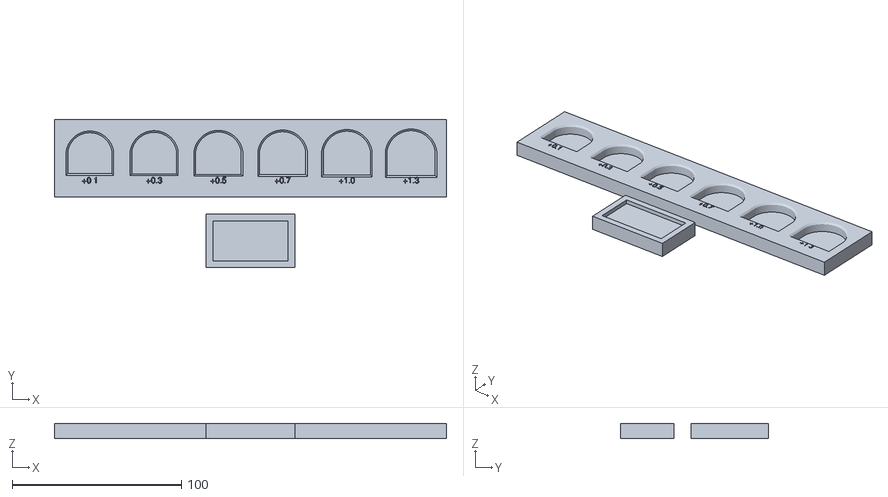
[picture p138: CAD file, 2026-09-19]
coupons/p9/p9-v3-plate.stl
231.9 x 87.7 x 9.00
