GarethCooke/SiglentTower/coupons/spacers/spacer-139.5.stl

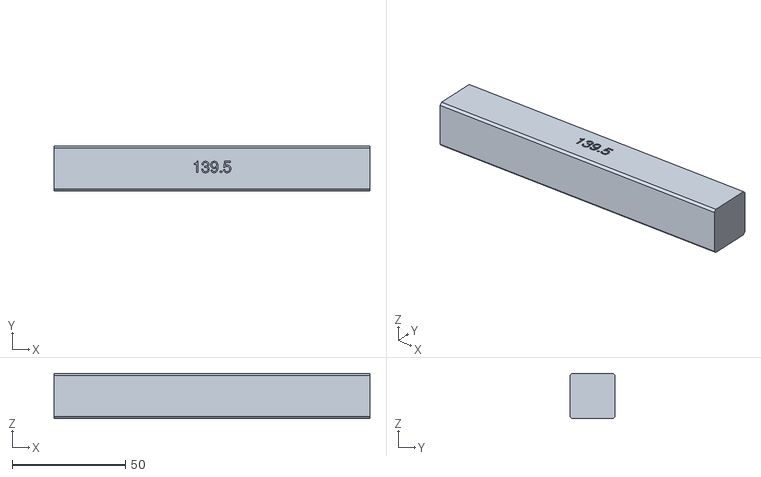
[picture p139: CAD file, 2026-09-16]
coupons/spacers/spacer-139.5.stl
139.5 x 20.0 x 20.0
