GarethCooke/SiglentTower/jigs/seat-jig-awg-R.stl

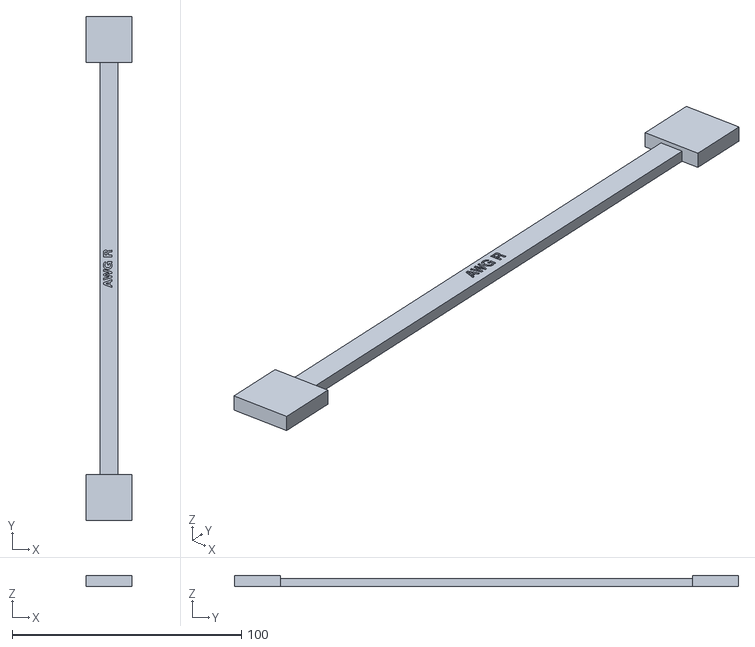
[picture p140: CAD file, 2026-09-28]
jigs/seat-jig-awg-R.stl
20.0 x 220.0 x 4.90
