GarethCooke/SiglentTower/parts/cable-channel-v1.stl

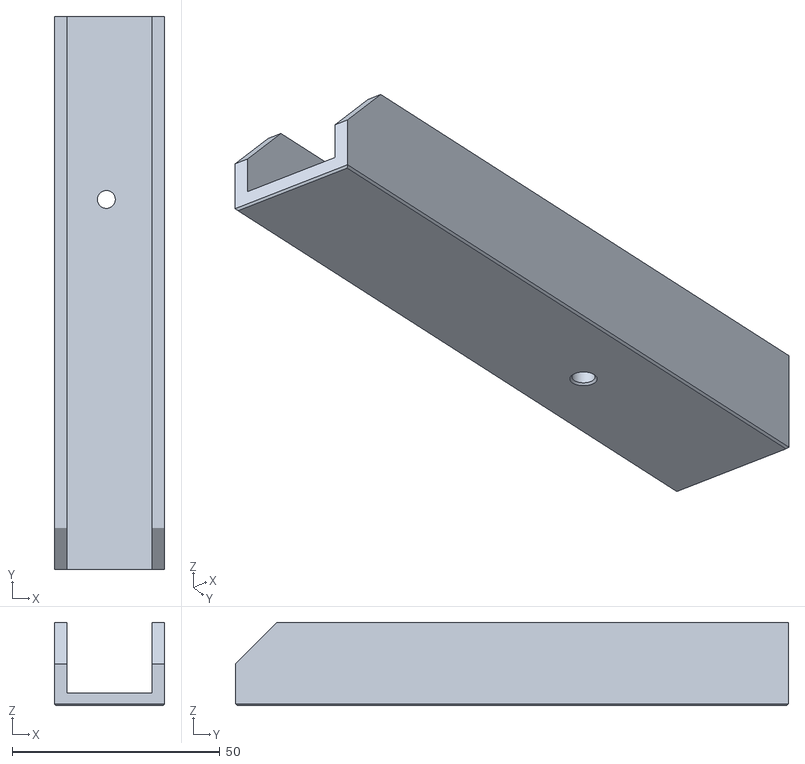
[picture p141: CAD file, 2026-10-19]
parts/cable-channel-v1.stl
26.5 x 133.0 x 20.0
