GarethCooke/SiglentTower/parts/column/column-strip-upper-v1.stl

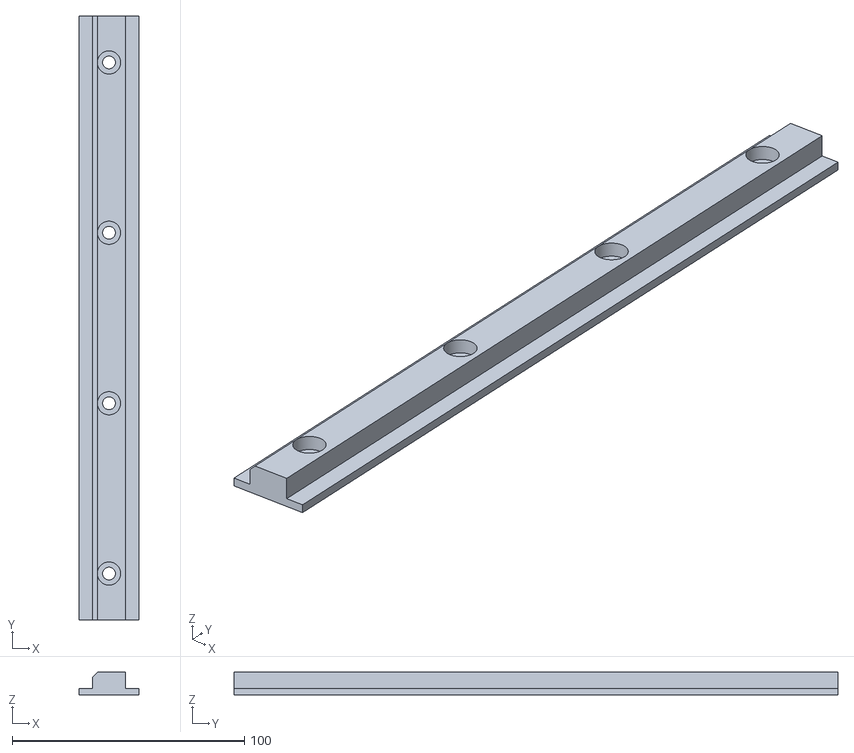
[picture p142: CAD file, 2026-10-04]
parts/column/column-strip-upper-v1.stl
26.0 x 260.0 x 9.70
