GarethCooke/SiglentTower/parts/door/magnet-tab-rear-v2.stl

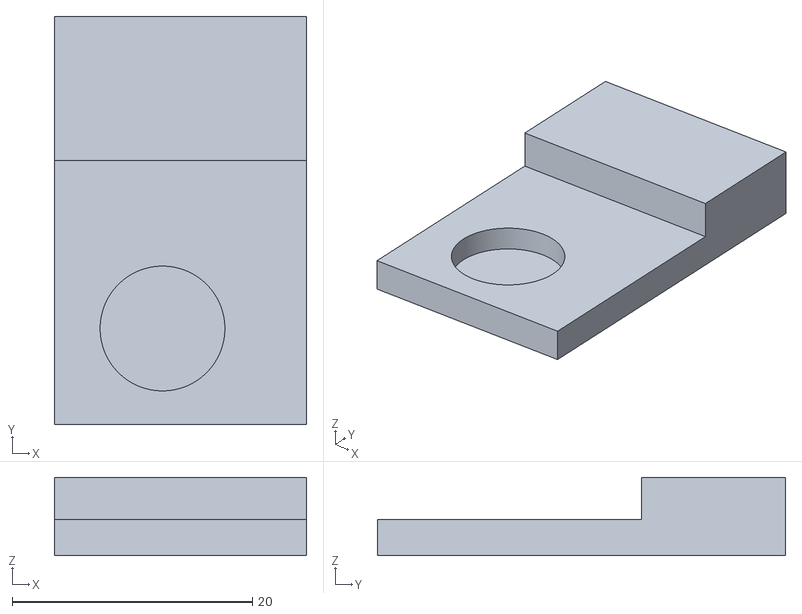
[picture p143: CAD file, 2026-10-19]
parts/door/magnet-tab-rear-v2.stl
21.0 x 34.0 x 6.50
