GarethCooke/SiglentTower/parts/inserts/sled-bar-pull-liner-v1.stl

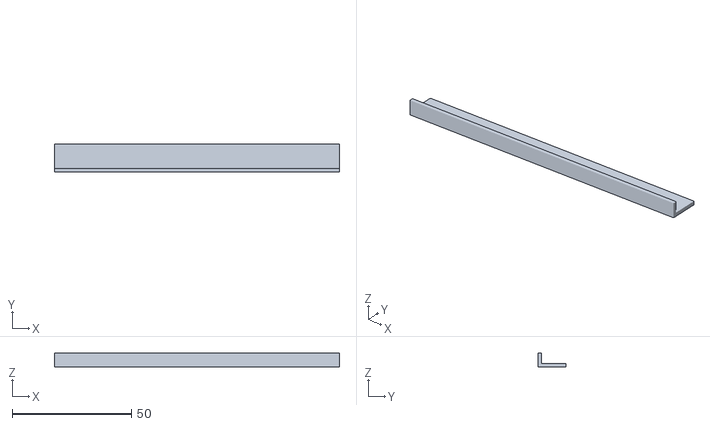
[picture p144: CAD file, 2026-10-09]
parts/inserts/sled-bar-pull-liner-v1.stl
119.7 x 11.9 x 6.00
