GarethCooke/SiglentTower/parts/tiles/tile-band1-LR-v2.stl

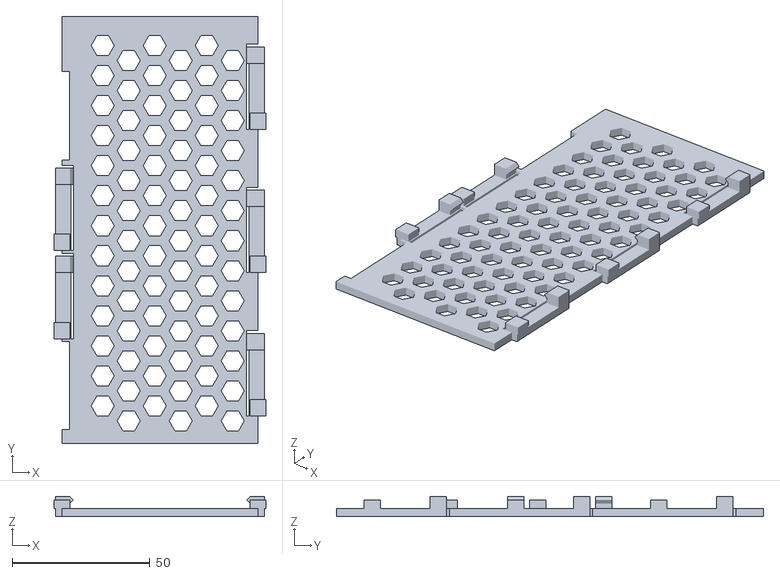
[picture p145: CAD file, 2026-10-14]
parts/tiles/tile-band1-LR-v2.stl
76.9 x 155.0 x 7.35
