GarethCooke/SiglentTower/parts/top/top-plate-v1.stl

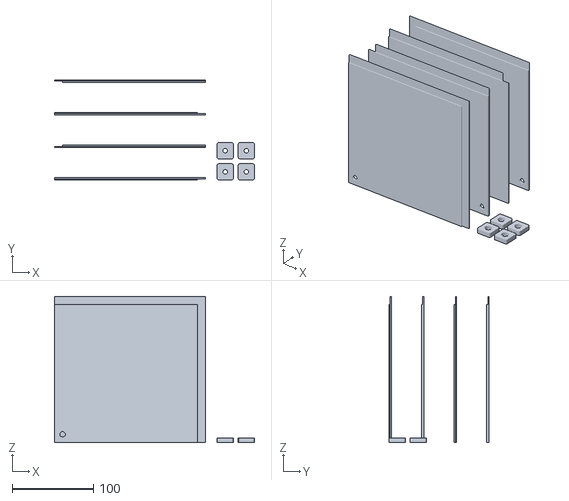
[picture p146: CAD file, 2026-10-14]
parts/top/top-plate-v1.stl
246.0 x 123.0 x 179.9
