GarethCooke/SiglentTower/parts/tpu/slot-cover-240-v1.stl

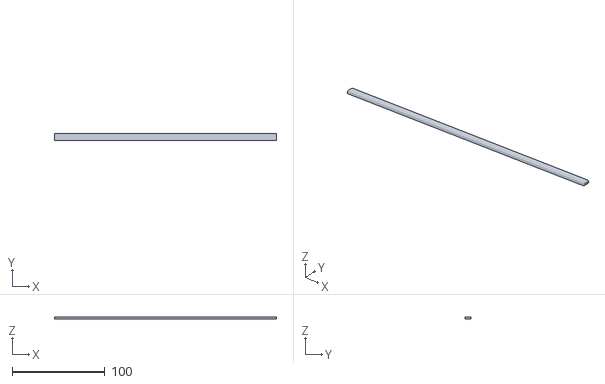
[picture p147: CAD file, 2026-10-12]
parts/tpu/slot-cover-240-v1.stl
240.0 x 7.40 x 2.50
