GarethCooke/SiglentTower/bambu/parts/column/column-strip-lower-v1.3mf

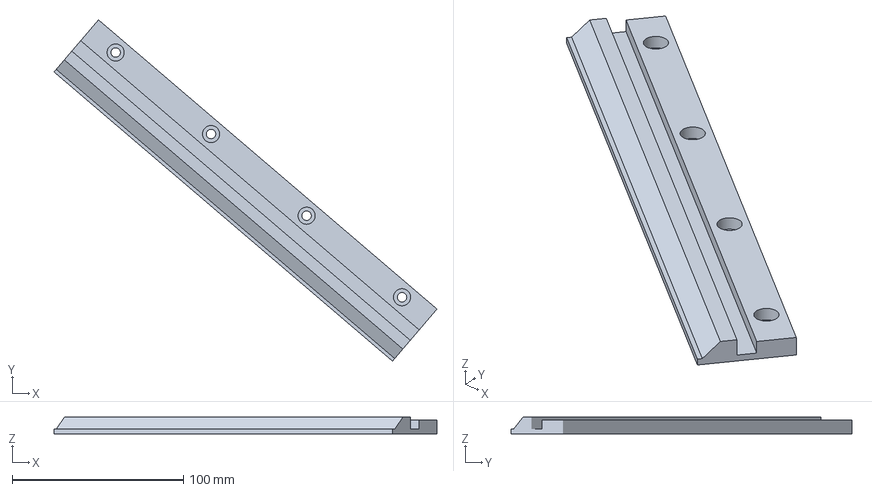
[picture p148: CAD file, 2026-10-04]
bambu/parts/column/column-strip-lower-v1.3mf
223.7 x 199.3 x 9.70 mm
