GarethCooke/SiglentTower/coupons/p4/p4-tiles-plate.stl

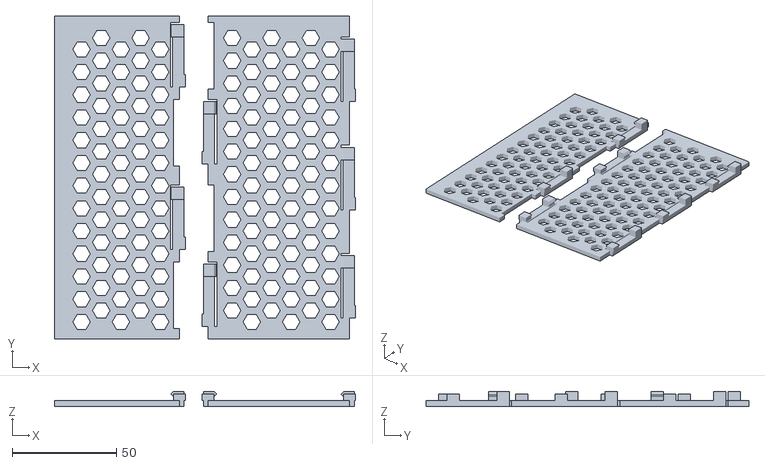
[picture p149: CAD file, 2026-09-22]
coupons/p4/p4-tiles-plate.stl
144.6 x 155.0 x 7.35
