GarethCooke/SiglentTower/coupons/p5/pin-2.9.stl

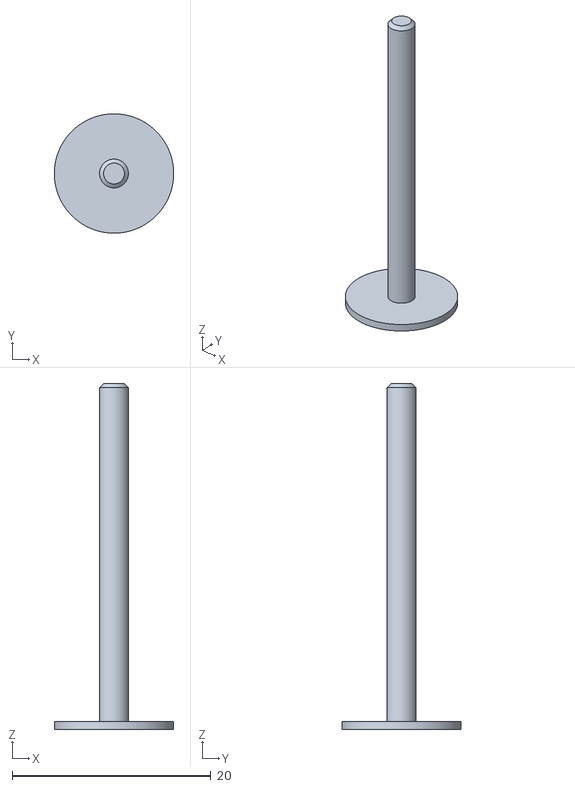
[picture p150: CAD file, 2026-09-22]
coupons/p5/pin-2.9.stl
12.0 x 12.0 x 34.8
