GarethCooke/SiglentTower/coupons/p7/wall-Q2.stl

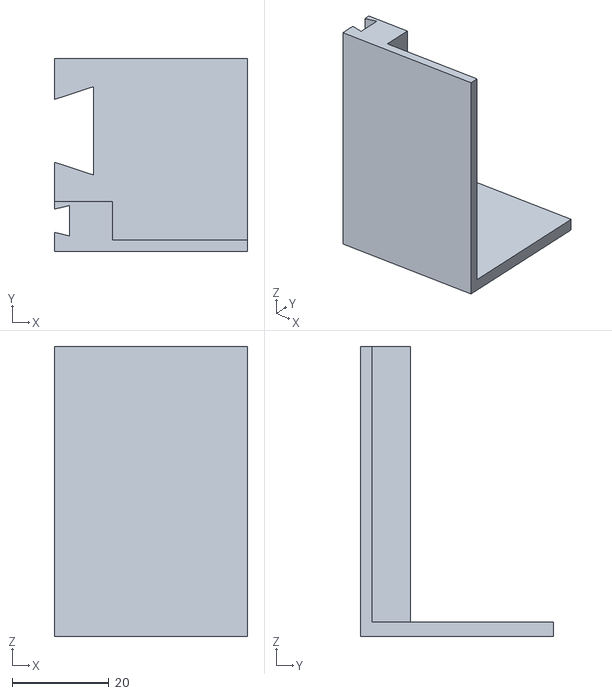
[picture p151: CAD file, 2026-09-15]
coupons/p7/wall-Q2.stl
40.0 x 40.0 x 60.0
