GarethCooke/SiglentTower/coupons/spacers/spacer-159.stl

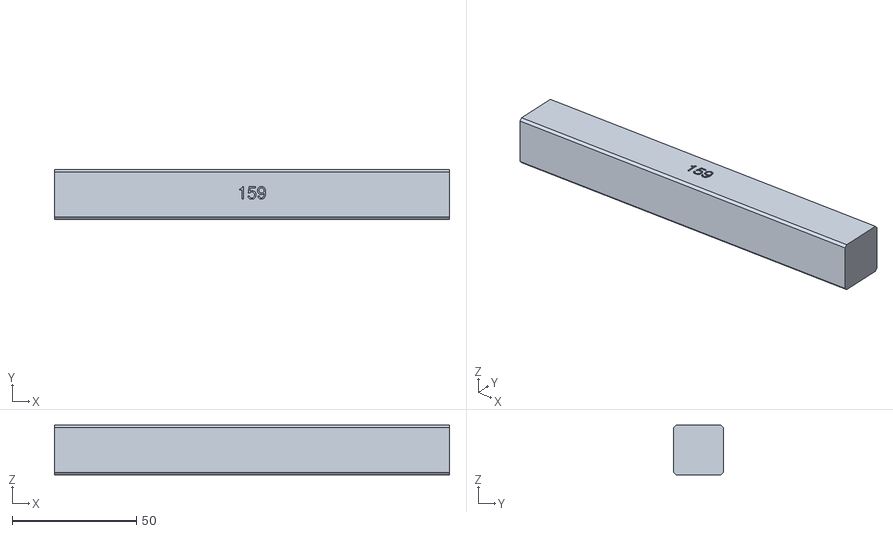
[picture p152: CAD file, 2026-09-16]
coupons/spacers/spacer-159.stl
159.0 x 20.0 x 20.0
