GarethCooke/SiglentTower/jigs/seat-jig-psu-R.stl

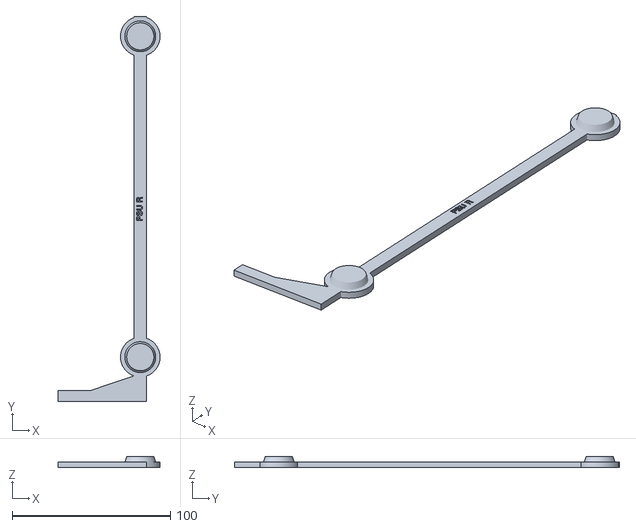
[picture p153: CAD file, 2026-09-28]
jigs/seat-jig-psu-R.stl
64.5 x 243.0 x 7.00
