GarethCooke/SiglentTower/parts/sled-splice-v2.stl

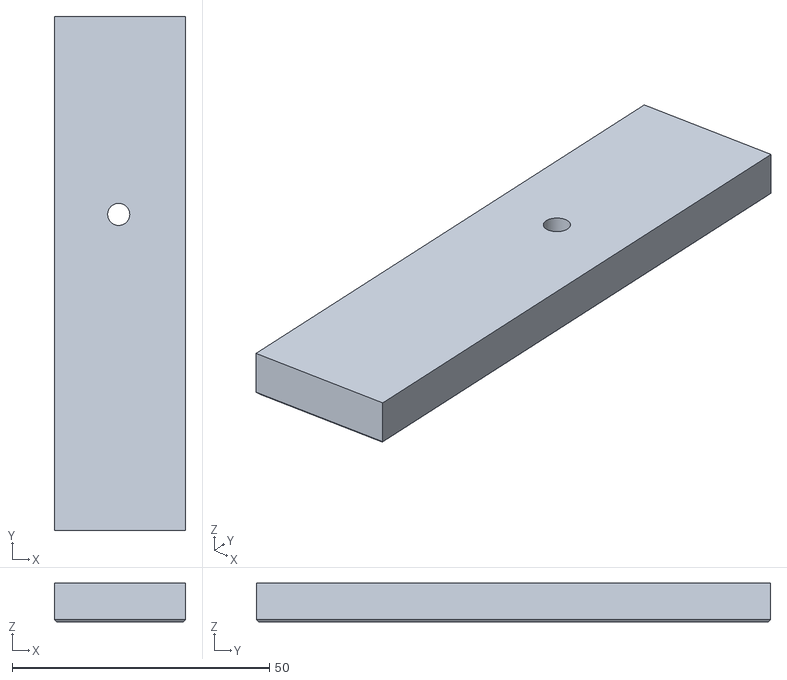
[picture p154: CAD file, 2026-10-16]
parts/sled-splice-v2.stl
25.5 x 100.0 x 7.50
