GarethCooke/SiglentTower/parts/top/upright-cap-v1.stl

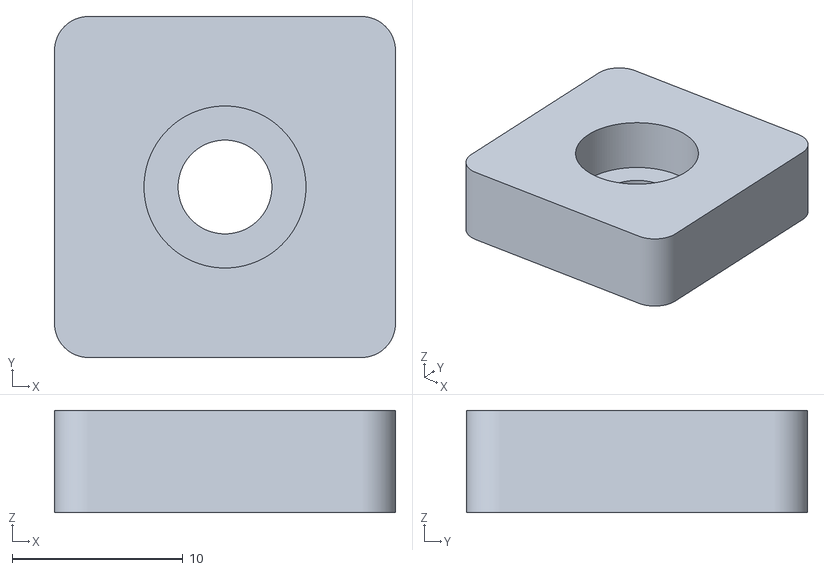
[picture p155: CAD file, 2026-10-14]
parts/top/upright-cap-v1.stl
20.0 x 20.0 x 6.00
