GarethCooke/SiglentTower/parts/tpu/frame-foot-v1.stl

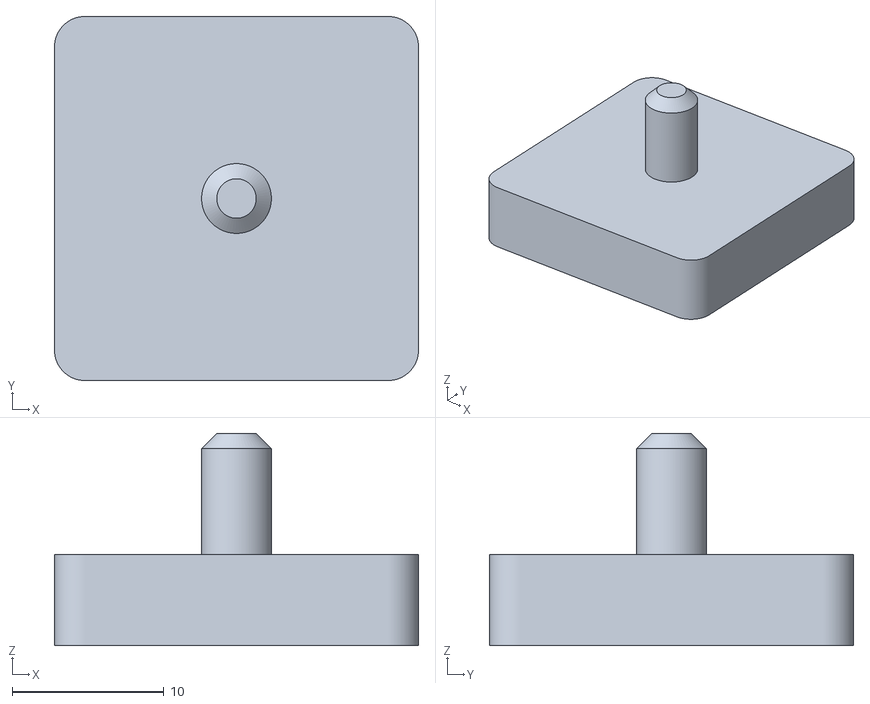
[picture p156: CAD file, 2026-09-22]
parts/tpu/frame-foot-v1.stl
24.0 x 24.0 x 14.0
