GarethCooke/SiglentTower/bambu/parts/cradles-v2-plate.3mf

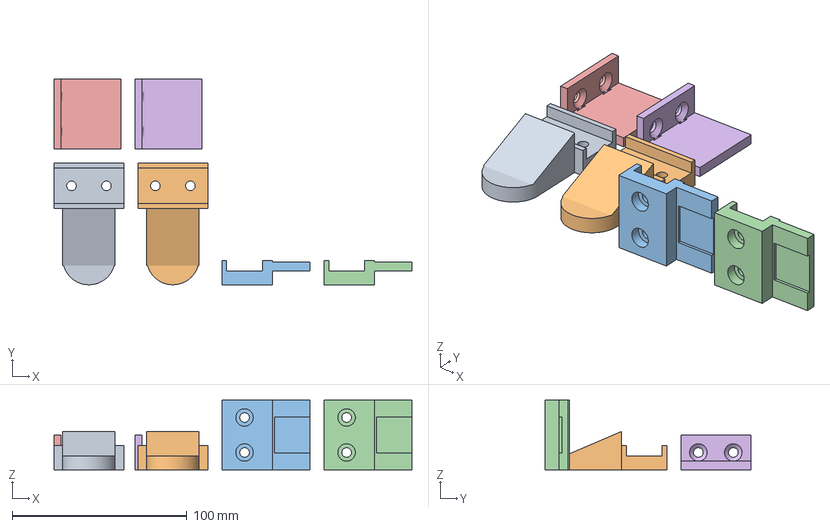
[picture p157: CAD file, 2026-10-03]
bambu/parts/cradles-v2-plate.3mf
204.8 x 117.6 x 40.0 mm
cradles-v2-plate.stl_1
cradles-v2-plate.stl_2
cradles-v2-plate.stl_3
cradles-v2-plate.stl_4
cradles-v2-plate.stl_5
cradles-v2-plate.stl_6
