GarethCooke/SiglentTower/(list of files, cad)

Other CAD files:
parts/tpu/awg-pad-left-v1.stl
coupons/p1/p1-plate.stl
coupons/p2/p2-cup-coupon-a.stl
parts/column/column-facia-v1.stl
parts/tiles/tile-band4-LF-v1.stl
parts/top/top-tile-RL-v1.stl
parts/tpu/tpu-plate-v1.stl
bambu/parts/mini/mini-slot-facia-v1.3mf
parts/column/column-strip-lower-short-v1.stl
parts/drawer/drawer-runner-300-v1.stl
parts/hinge-frame-v2.stl
parts/top/top-tile-FR-v1.stl
bambu/parts/tiles/tiles-plate-D.3mf
parts/drawer/drawer-Q4-v1.stl
parts/top/top-tile-FL-v1.stl
bambu/parts/tiles/tiles-plate-B.3mf
coupons/p8/slot-cover-60-w63.stl
parts/drawer/drawer-Q3-v1.stl
bambu/parts/drawer/drawer-Q2-v1.3mf
bambu/parts/rear-box-left-v1.3mf
bambu/parts/tiles/tiles-plate-A.3mf
coupons/p6/pull-60.stl
parts/drawer/drawer-Q2-v1.stl
parts/tiles/tiles-plate-A2.stl
bambu/parts/drawer/drawer-Q3-v1.3mf
bambu/parts/sill/sill-block-left-and-right-v2.3mf
bambu/parts/sled-absplus-plate.3mf
bambu/parts/sled-beams-front-v2.3mf
bambu/parts/sled-front-bar-v1.3mf
coupons/p4/p4-plate.stl
coupons/p4/p4-v2-plate.stl
coupons/p4/tile-b06.stl
coupons/p4/tile-b09.stl
coupons/p4/tile-v2-A.stl
coupons/p4/tile-v2-B.stl
coupons/p4/tile-v2-C.stl
coupons/p4/tile-v2-D.stl
coupons/p5/magnet-boss.stl
coupons/p5/p5-plate.stl
coupons/p6/facia-80.stl
coupons/p7/cross-Q1.stl
coupons/p7/cross-Q2.stl
coupons/p7/cross-Q4.stl
coupons/p9/cup-pad.stl
coupons/p9/p9-cups-v2.stl
coupons/p9/p9-plate.stl
coupons/p9/p9-v2-plate.stl
coupons/p9/stand-pad-v2.stl
coupons/p9/stand-pad.stl
parts/awg-cradle-left-v2.stl
parts/awg-cradle-right-v2.stl
parts/box-brace-v1.stl
parts/cradles-v2-plate.stl
parts/drawer/drawer-Q1-v1.stl
parts/psu-cradle-right-front-v5.stl
parts/psu-cradle-right-v4.stl
parts/psu-cradle-v3.stl
parts/rear-box-left-v1.stl
parts/rear-box-right-v1.stl
parts/sled-absplus-plate.stl
parts/sled-beam-left-front-v2.stl
parts/sled-beam-left-rear-v1.stl
parts/sled-beam-right-front-v2.stl
parts/sled-beam-right-rear-v1.stl
parts/sled-cross-bar-front-v2.stl
parts/sled-cross-bar-rear-v2.stl
parts/sled-foot-210.stl
parts/sled-front-bar-v3.stl
parts/sled-front-rest-v2-gap3.0.stl
parts/tiles/tile-band1-LF-v2.stl
parts/tiles/tile-band1-R-v2.stl
parts/tiles/tile-band2-LF-v2.stl
parts/tiles/tile-band2-LR-v2.stl
parts/tiles/tile-band2-RF-v1.stl
parts/tiles/tile-band2-RR-v1.stl
parts/tiles/tile-band3-LF-v2.stl
parts/tiles/tile-band3-RF-v2.stl
parts/tiles/tile-band3-RR-v2.stl
parts/tiles/tiles-plate-C2.stl
parts/tiles/tiles-plate-D.stl
parts/tiles/tiles-plate-D2.stl
parts/tiles/tiles-plate-E.stl
parts/tiles/tiles-plate-E2.stl
