GarethCooke/SiglentTower/PRINT-RULES.md

# Print rules and design-for-print review (v1.5, 2026-10-19)

House rules for every printed part in this project, then a review of every production part designed so far against them. The same rules are saved as a Claude skill (`print-oriented-design`) so they apply to every project, not just this one. Coupons (P1–P9, spacers) are exempt from the review; they follow the rules by construction.

## 1. Rules

1. **Every part has a designated bed face before it is modelled**, not after. The bed face is the largest flat face, and it must be at least 30 % of the footprint. The STL is exported in that orientation with z = 0 on the bed. `src/printcheck.py` verifies this on every export and lists every downward face above the bed.
2. **Precision surfaces are vertical walls.** Anything that slides, locates or mates — dovetail flanks, runner grooves, T-foot flanks, bores, clip barbs, cup walls — is printed as a vertical wall so its dimension comes from XY (±0.05 on the X1C), never as a top surface (layer-quantised) or a ceiling (sags). Layer lines run along the sliding direction. One allowance (P3, 2026-09-19): a horizontal *bearing* face whose height only sets play — the runner rib's bottom, the drawer's groove flank — may be a top surface (flat, smooth, ±0.1), never a ceiling; the locating faces beside it (rib tip, groove back) stay vertical walls.
3. **One part, one direction of features.** A part may have features rising from its bed face, never features hanging below it. If a design needs both (a web under a beam, a peg under a bracket), the interface is a joint and the part splits there.
4. **Overhangs are designed out, not supported.** Slots and grooves in vertical walls get 45° roofs. Horizontal round holes are teardrops. Mushroom heads and lips have a 45° underside. Bridges are kept under 12 mm. Counterbores that must face the bed use the slicer's sacrificial layer (Bambu: Quality → Bridge counterbore holes → Sacrificial layer), not support.
5. **Supports are a house rule, not a design tool.** They stay enabled with "On build plate only" so they can never grow inside a part. If the slicer preview shows support on any fit surface, the part is wrong.
6. **Clearances live in one place** (`src/fit.py`), set by coupons, read by every part script. No X-Y compensation in the slicer. Sliding pairs and long thin bars print from one reserved black ABS+ spool (ROADMAP §2 lists them); every other black part is plain ABS. A sliding-pair `fit.py` value set on a PETG coupon is re-checked with a short ABS+ coupon before the full-length part.
7. **Bed-edge features get a 0.4 mm chamfer** on their bottom edge so elephant foot cannot close a clearance on the first layer.
8. **Split rather than tilt** when a part exceeds the bed. A diagonal placement is fine for a bar; a fit part with sliding surfaces is split with a joint that itself obeys rules 2–4.
9. **A coupon is the joint and nothing else.** Enough body to hold and orient it, no more: a 66 × 14 strip tests a tile clip as well as a 60 × 60 tile does at a third of the plastic and time. Variants go on one plate, stamped.
10. **One of each variant, never two of the same** (rule from 2026-09-22). If two pieces on a coupon plate are geometrically identical, the second is waste: test the single piece against the frame, an offcut, a loose magnet — whatever the real mating part is — not against a copy of itself. Several pieces are right whenever they DIFFER (P4's four clip strips, P9's six cups, P8's four spigots); two of one thing never is.
11. **Every variant carries its value on it** (rule from 2026-09-22). A sweep is stamped, debossed 0.4–0.6 into a face that stays visible after the piece leaves the plate. P5 v1's two pins were 3.0 and 2.9 with nothing to tell them apart — that is a failed coupon even if the part is fine. If a value is too small to stamp, the variants go in one part in a fixed order and the order is written down.
12. **TPU prints once, last.** Every blue TPU part in the build — P8 sweep, feet, AWG pads, stop caps, slot covers — goes on as few plates as possible in one session at Stage 8, after everything else, because the TPU changeover and the filament drying cost more than the parts. A TPU coupon never prints on its own; a design that needs a TPU part to test is tested with a PETG stand-in or waits. (Gareth, 2026-09-22; restated 2026-09-24.)

13. **A chiral part is exported from the REAL frame, never from a mirrored check frame.** `skin_check.py`'s right-side rail frame is a mirror image of the frame (x = 361 − x); the side tiles survive it because they are placed by rotation, but the door set's rear tile and magnet bracket were exported from it and printed as the wrong hand (2026-10-19). Any script that models in a mirrored frame converts back (`door_set.to_frame`) before `printable()`, and prints a hand check — the position of an asymmetric feature in real-frame coordinates — next to the export.

## 2. Review of production parts

| Part | Bed face | Precision surfaces | Finding | Ruling |
|---|---|---|---|---|
| Bottom drawer quarters ×4 (D2) | floor, walls up | floor tabs (in-plane), wall dovetail rib/slot (vertical), groove back (vertical) | conforms. **Runner groove** (modelled 2026-09-19, `drawer_runner.groove_cut()`): a house-shaped side pocket in a 10 × 20 boss along each outer wall — flank at the floor top (z 3, bearing), back at 7.3, 45° roof up to the wall face at 17.3. It crosses the left/right wall dovetails (x 3.4–9.4), so those move up to z 20–60 — **v1 2026-09-28:** the raised rib stands off the boss face across the seam, so its underside is a 45° ramp (z 17 at the face → 20 at the tip); the slot stays open to the floor so the rib enters from below on the vertical drop. Facia screw pads rise from the floor (no overhang), M3 holes are teardrops with the axis along y. `printcheck.py`: 90 % resting face, no down-facing area | groove in the drawer, rib on the runner (the 3 mm gap decided it — see the runner row) |
| Column drawer (D5) and mini slot (D7) | floor, walls up, diagonal on the bed | wall faces, neck step | conforms | same runner rule as above |
| Three fronts + sled bar (D3) | **bottom long edge**, standing, diagonal | none on the front itself | a pull slot cut into a standing front leaves its top edge as a 100–120 mm bridge; a 30° pocket floor is a 30° overhang | **D9**: the front carries a notch in its top edge (no bridge); the pull is a separate insert printed face-down (slot, hook strip, pocket with a leaning floor and a 7 mm bridged back wall) and glued in, accent colour. Brim allowed on fronts (no fit flanks). Logo inlay is a vertical-wall feature — fine with AMS |
| Drawer runners ×2 (`src/parts/drawer_runner.py`) | **leg-top down** (an L: leg over the base rail's top face bolted into the top slot, 2.7 plate down the inner face, 7 mm rib z 6–20 whose top slopes 45° back to the plate) | rib tip (locates sideways — vertical wall), rib bottom (bearing — top surface, rule 2 allowance) | the drawer wall is 3 mm off the rail face, so nothing bolted through that gap can hide an M5 head without breaking into the bearing face; the fixing moved to the rail top. Counterbores open onto the bed → sacrificial layer, as the cradles | conforms; P3 coupon is 80 mm of it. Column guide strips ×4 and the mini-slot runner get their own sections (2 mm gap on the inner sub-frame side) once P3 sets `RUNNER_CLR` |
| Housing-top tiles ×6 | flat | none | conforms | — |
| Top panel ×4 tiles (D12, `src/parts/top_panel.py` v1 2026-10-14) | **standing on the front / rear edge** (D3, as the facias) | lap tongues, corner hole | the four tiles meet on 10 mm half-laps; printed flat face-down one tongue of every lap is an 8 mm ceiling, so the tiles stand — each tongue is then a 1.5 / 1.4 mm fin at the top of the print or a vertical end, the corner M5 hole is a teardrop (horizontal axis), and the only bed face is the 3 mm edge (chamfered 0.4). No H-spline: 3 mm to the scope under the seams | conforms; all four on one plate |
| Side tiles (16), door, fixed rear tile (D4) | tile face down (textured outside) | slot clips on the inside face | clips rise from the tile — conforms; **clip barbs** are undercuts | barb underside at 45°; the P4 coupon carries that geometry |
| Door hinge knuckles ×2 + frame knuckles ×2 — `src/parts/door_hinge.py` v1 2026-09-22 (D11) | **standing on the y = 0 end**, bore vertical | bore Ø3.2, barrel Ø8, the frame plate's seating face, the door shelf's panel slot | a round barrel on a face-down tile has its underside as an overhang. Standing, print-down is −y, so any barrel segment that does not start at y = 0 has a floating end: those are **coned 45° right in to the bore** (zero flat area — the tip is a ring of zero width, so the slicer just starts it on the next layer), and the frame's riser and the door's shelf are ramped 45° off full-length material for the same reason. The M5 hole's axis is horizontal in the print, so it is a **teardrop**, peak toward +y | knuckles are **separate parts printed standing**; door tile stays flat. The 2-pin socket is dropped — a 3 mm hex tile is a poor host for blind pin holes and horizontal pins would overhang; the door leaf's **shelf catches the panel's bottom edge** instead, which locates it in z, and it is glued. Frame leaf: 6 mm plate, one M5×12 into the scope rail's outer slot. Resting face 39 % (door) and 32 % (frame) of footprint |
| Door set v1 (`src/parts/door_set.py`, 2026-10-18): door, fixed rear tile, front magnet bracket, rear magnet tab | door and fixed tile FACE DOWN; bracket on its plate face; tab on its back | magnet pockets Ø10.4 × 2.2; the leg's M5 hole; the bracket's tongue | the magnet BOSSES are grown on the door's back (rise from the face-down tile, pockets open up — no separate bosses to glue); the fixed tile's LEG is a 19 mm wall rising from its back with a horizontal M5 hole → teardrop; HANDOVER's rear tab "grown from the fixed tile" would be a 22 mm plate floating 3.5 above a face-down tile, so it is a separate part on its back with the pocket up; the bracket's pocket is sideways in its print → teardrop, apex up; its tongue lies flat on the bed | conforms; door 64 % resting face, tile 68 %, bracket 87 %, tab 100 % |
| PSU cradle ×4, AWG cradle ×4 | **saddle/arm top face down** (re-exported 2026-09-17) | foot cup, saddle channel | cup-up rested on the gusset tip — could not print; top-down leaves the cup and two counterbores as 4 mm ceilings over the plate | Bambu "Bridge counterbore holes: Sacrificial layer" — no support at all; punch out the discs. AWG cradles inherit the orientation |
| Sled T-feet ×2 + web | **standing** on the flange and web bottom edges, layers along the slide | neck flanks (5.8 in the 6.2 mouth), flange faces, web thickness, rib flank | HANDOVER has the web "down from the beam", which would hang a feature below a flat beam — violates rule 3. With the web on the foot, the neck/flange grow toward −x and the rib toward +x, so neither web face can be the bed either | **the web belongs to the foot** (`src/parts/sled_foot.py`): one inverted-T part, 210 long, printed standing — flange and web are vertical walls, the rib flank is 45°, the only downward face is the neck's 4.2 mm bridge between flange and web. Web at x 22.2–24.7 (2.2 off the rail face) so the beam keeps a 1.5 mm wall outside it. Rib on the web's top edge (z 337–341) widens 2.5 → 5.0 inboard at 45°; the beam threads onto it from the front. P1 v2 coupon carries this exact section |
| Sled beams ×2 (split, D6) — `src/parts/sled_beam.py` v1 2026-09-21 | **flat, top face up** — cups and stand pockets open upward | closed dovetail groove in the underside (1.5 outer wall, 45° inboard flank, 5.4 mm bridged ceiling), cup walls, pocket walls, puzzle-tab flanks (vertical) | v1 had the groove open at the beam's outer face, which left a one-sided 5 mm ceiling; moving the web inboard 1.7 closes it. The cup's 6 (5 straight + 1 lead-in) with its floor at 341 needs 10 mm, so the cup sits in a 10 mm boss on the 9 mm beam (top step, prints fine). The groove is closed at y 119.5 (a vertical end wall) so the foot has a positive stop; open at the rear. | conforms: every pocket opens up, the groove ceiling is a bridge under 12; split joint at y 165 per P7; tabs to the front bar and cross bars are the same P7 trapezoid, all vertical assembly. Front stands sit in 2.5 mm pockets (14 − 11.5), not on lipped pads; the pocket is open at the front face (the stand's leg is 1 mm behind the front bar) |
| Front bar, rear cross bars with guide lips | flat (bar on edge, diagonal) | guide lips, J-pull opening | lips rise from the bar — conforms | — |
| Rear box halves | floor down, open side up | dovetails (vertical), guide-lip engagement | conforms | — |
| Cable channel (separate, D6) | floor down | wedge tabs "45° solid support" | designed to the rule already | — |
| TPU feet, AWG pads, stop caps | flat, spigot up | spigot | conforms | TPU profile at P8 |
| Blue caps (`top_panel.py cap()` v1 2026-10-14) | closed face down | counterbore (open up) | the spigot is gone: the cap screws through the top panel's corner into the upright's bore (M5 × 10, Ø9.5 × 4 counterbore), so it prints closed face down with the counterbore and hole open upward | conforms |
| Probe hanger | flat | keyholes | through-holes — conforms | — |
| Strip brackets (keyhole pegs) | bracket face down | peg heads (mushroom) | a mushroom head is a 100 % overhang | peg = post + 45° cone under the head (self-supporting), or head printed as a separate disc on an M3 |
| Rear-right cable clips | flat | — | not yet designed | design to rule 4 |

## 3. Changes this review makes to HANDOVER

- §4: the 2.5 web is part of the T-foot, not the beam; beam-to-foot joint is a sliding dovetail along y on the beam underside.
- §5: hinge knuckles are separate standing parts; clip barbs 45°.
- §6: drawer runner is an L bolted into the base rail's top slot with a 7 mm rib; the drawer's outer walls carry a house-shaped groove in a 10 × 20 boss (P3); side-wall dovetails z 20–60.
- §8 print notes: cradles print top face down with a sacrificial layer over the cup; fronts stand on their bottom edge; "no supports" now means "none inside a part".
- §7: strip-bracket pegs get a 45° cone under the head.

These land in HANDOVER v19 at close-out; until then this file is the reference.
