GarethCooke/SiglentTower/frame-assembly-3d.html

# Frame assembly — Stage 2 (ROADMAP 2.1–2.5)

◀ back next ▶ show finished frame

T-nuts are the drop-in type: drop each one in as its part is fitted (the counts are a tally per slot). Cast brackets M5×8; printed parts later M5×10.

added this step already fitted printed spacer (remove after) metal L corner bracket sled foot (in the scope rail's slot)
Hidden L-connectors go on the faces that look INTO the frame (side rails ↔ uprights: inner faces; rear cross rails and rear ties: front faces; inner rails ↔ inner uprights: right faces; front tie ↔ its inner upright: rear faces). One per joint. x from the outside of the left upright, y from the front face, z from the bench (mm). Front is the open side.

drag: orbit · right-drag / shift-drag: pan · wheel / pinch: zoom
