GarethCooke/SiglentTower/coupons/p1/p1-howto.png

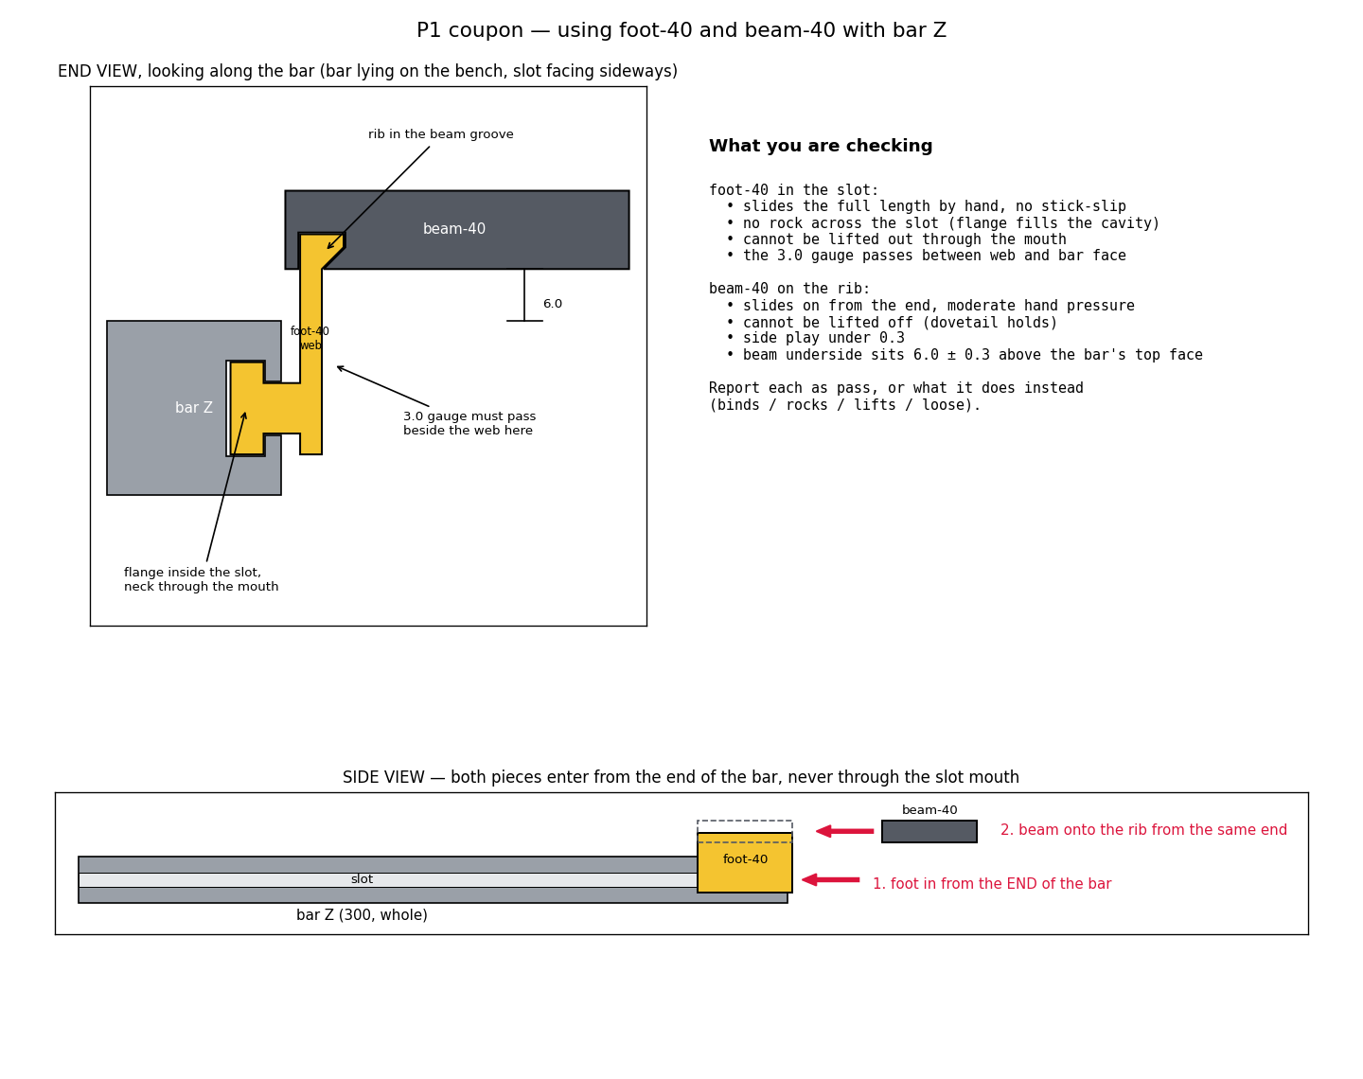
coupons/p1/p1-howto.png
