GarethCooke/SiglentTower/parts/wiring/board-enclosure-sketch.png

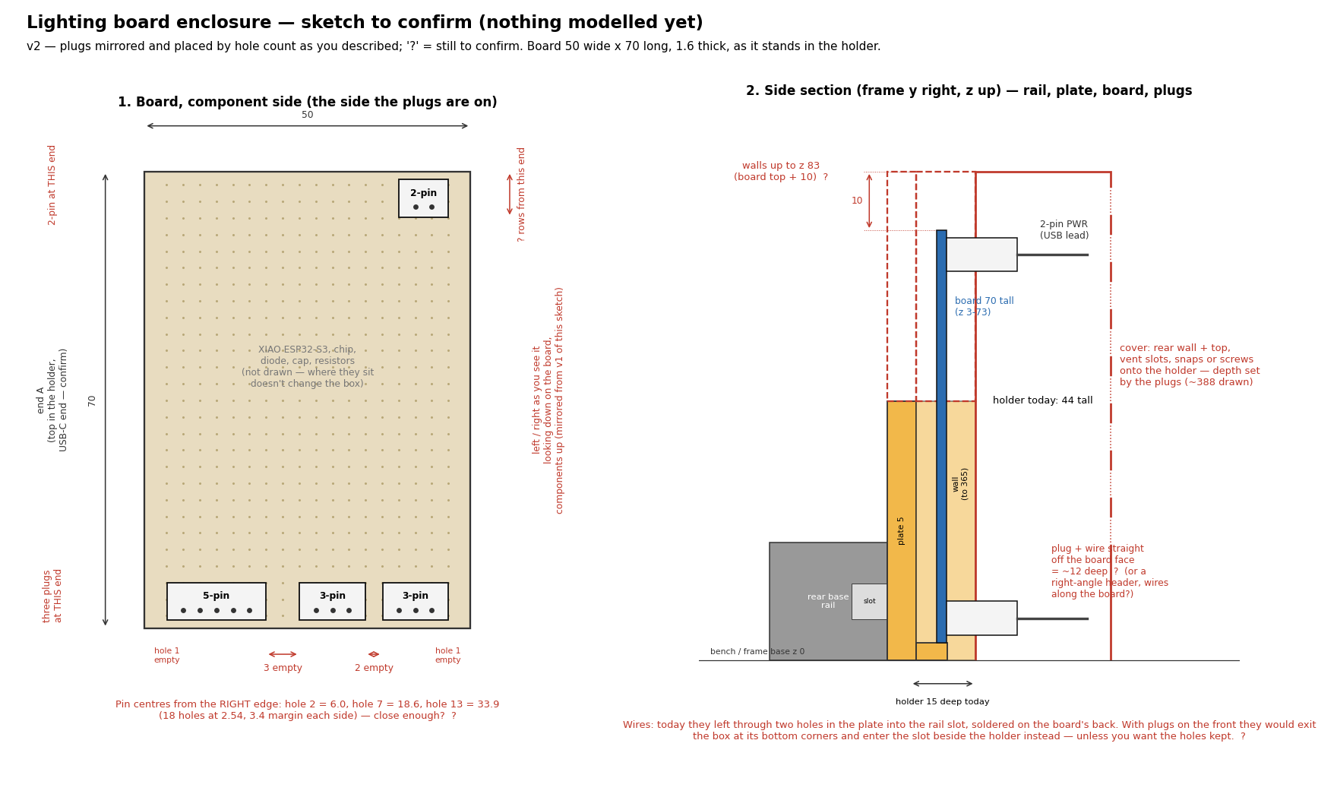
parts/wiring/board-enclosure-sketch.png
