GarethCooke/SiglentTower/publish/makerworld/diagrams/layout-as-built.png

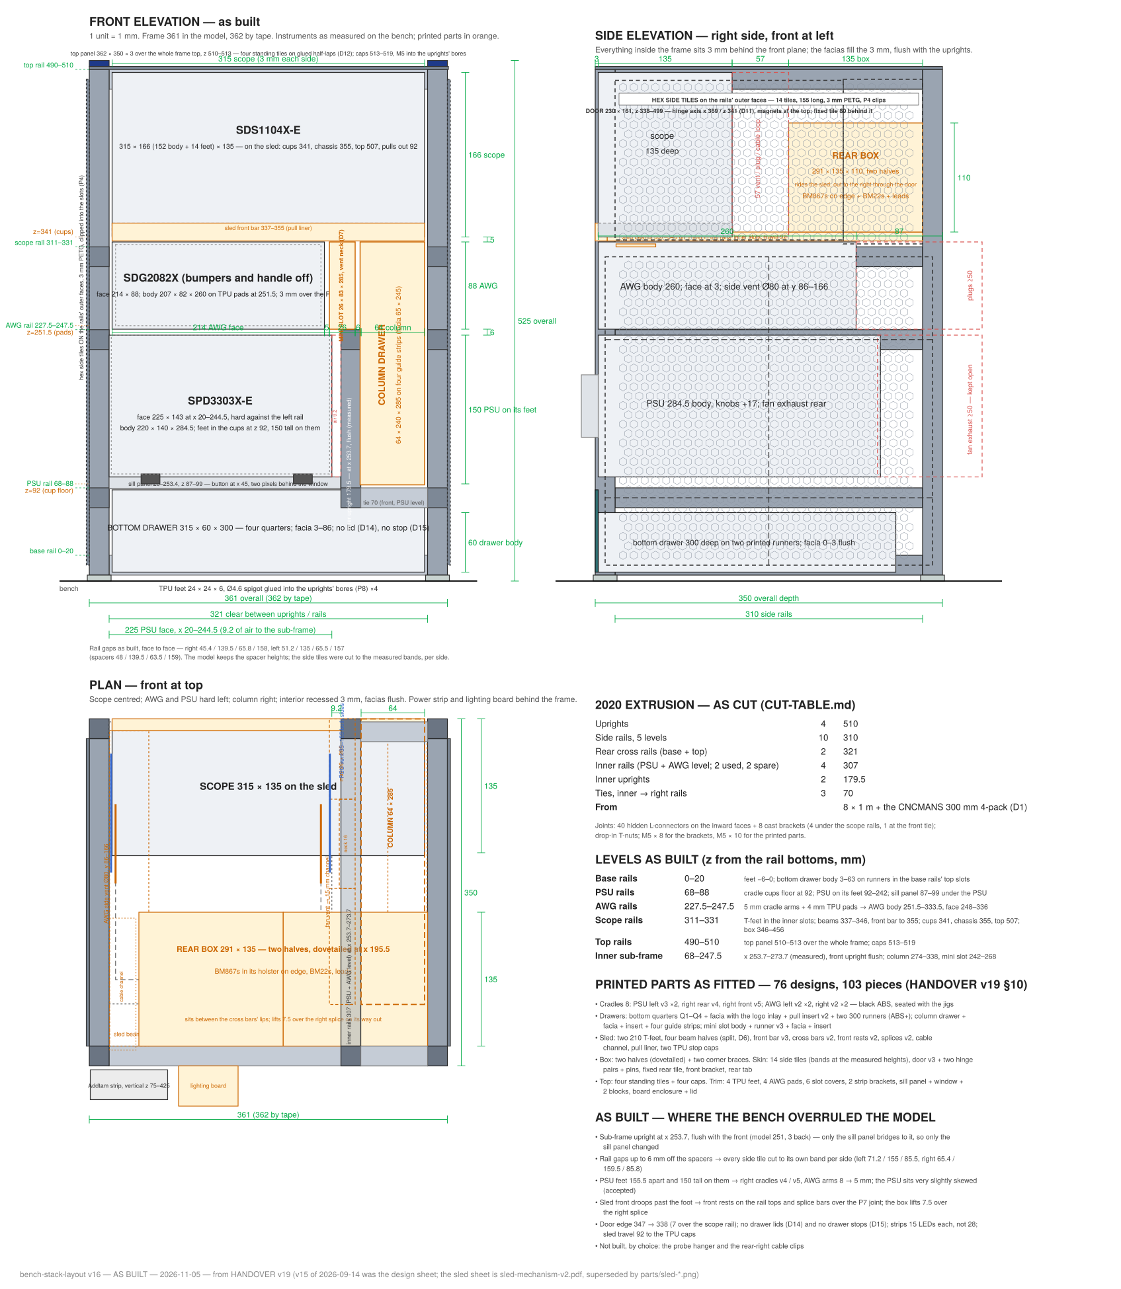
publish/makerworld/diagrams/layout-as-built.png
