GarethCooke/SiglentTower/publish/makerworld/photos/box-out.jpg

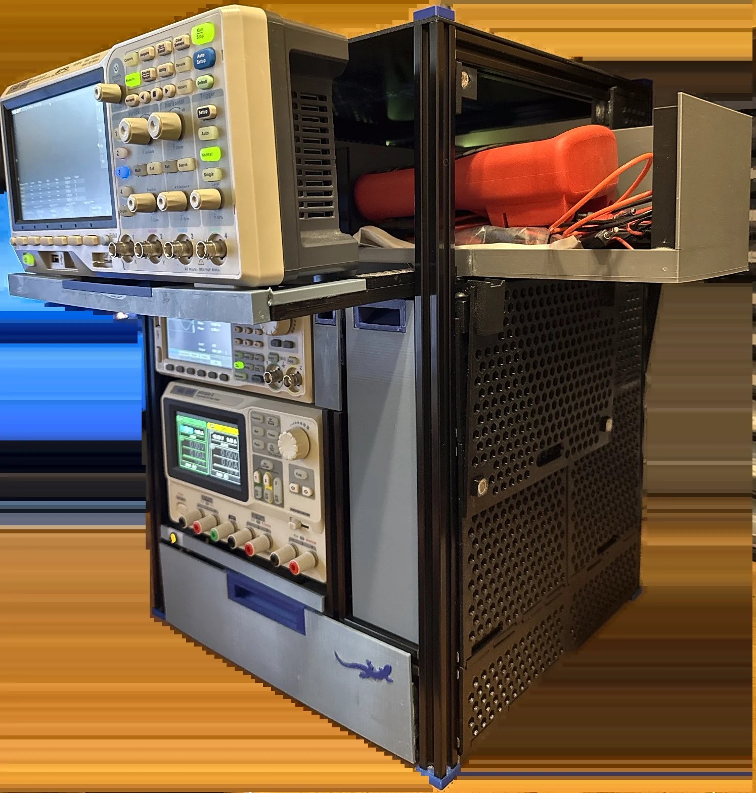
publish/makerworld/photos/box-out.jpg
