GarethCooke/SiglentTower/publish/makerworld/photos/sled-out.jpg

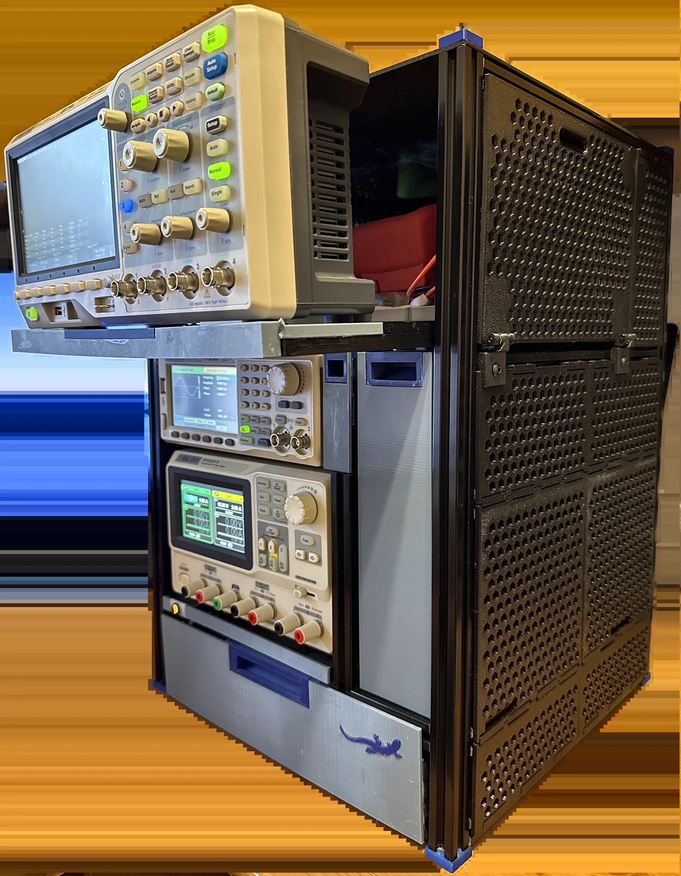
publish/makerworld/photos/sled-out.jpg
