GarethCooke/SiglentTower/parts/tpu/tpu-where-4-test-pieces.png

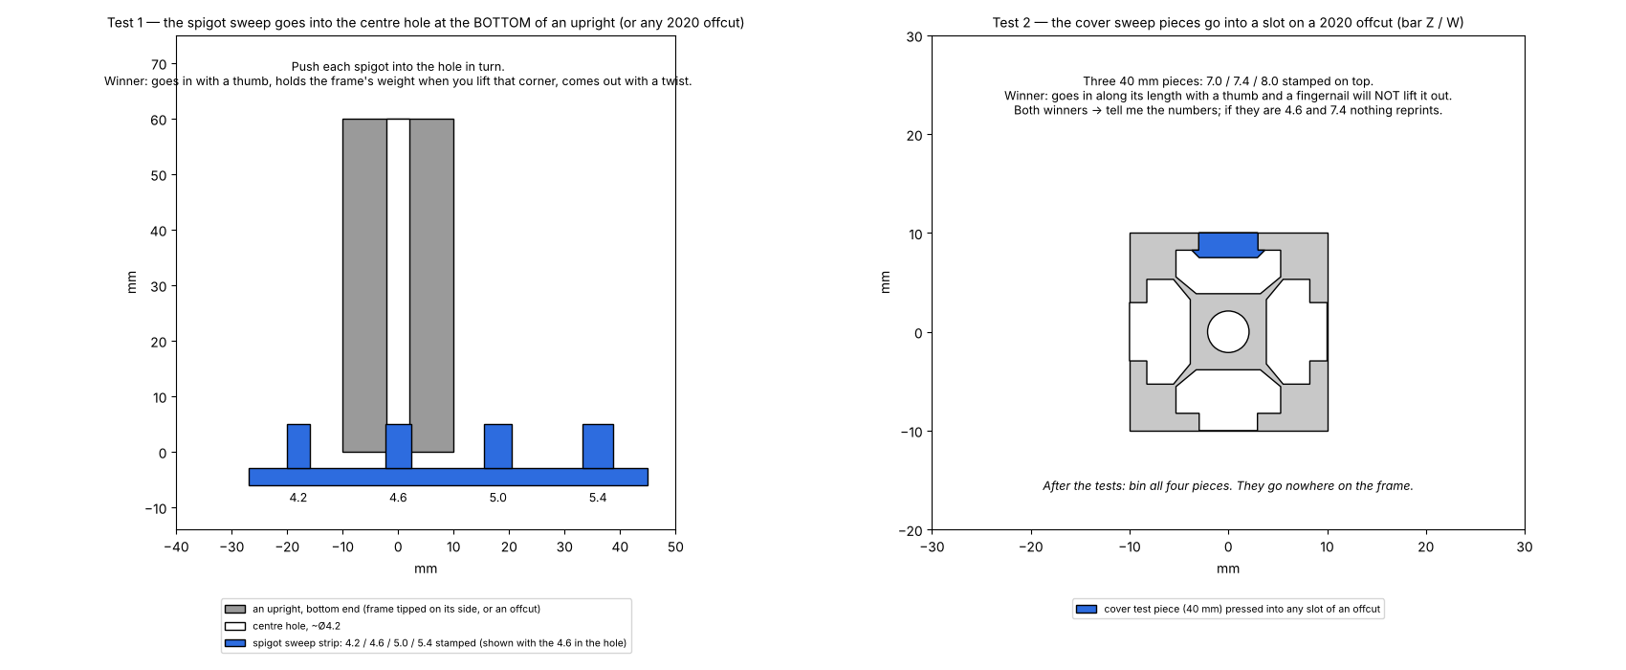
parts/tpu/tpu-where-4-test-pieces.png
