GarethCooke/SiglentTower/(commit log)

2026-09-15 Roadmap v2.1: D1–D7 decided, viewer v19/v20, drawer-quarters sheet
    - ROADMAP.md: decisions D1–D7 recorded; cut plan for 8 x 1000 + 4 x 300;
    P7 redefined as the four-quarter drawer joint; D7 thermal check added
    to the Stage 4 pass condition with the 85-deep slot as fallback
    - bench-stack-3d-v19.html: D2 quarters, D4 split tiles + H-spline top,
    D5 column 285, D6 split beams (src/viewer_v19_patch.py from v18)
    - bench-stack-3d-v20.html: D7 slot 285 with 15 mm vent channel, AWG
    vent drawn (src/viewer_v20_patch.py from v19)
    - drawer-quarters-v1.pdf/.svg: D2 joint sheet (src/drawer_quarters_gen.py)
    - remove "Claude outputs/" duplicate of v20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
2026-09-15 Roadmap v2.2: Done columns and progress checklist; single viewer file
    - ROADMAP.md: ☐/☑ Done column on every table, stage-level Progress
    checklist, Stage 2 and close-out as task lists
    - bench-stack-3d.html replaces bench-stack-3d-v18/v19/v20.html (v20
    content, version label dropped); the viewer is now edited in place
    and git carries the history
    - src/viewer_v19_patch.py and viewer_v20_patch.py removed from the tree
    (they mapped v18 → v19 → v20; still in history)
    Claude-Session: https://claude.ai/code/session_01VQAymzj3iaQ4w2Fyn1UmZY
2026-09-15 Stage 0: fit.py, drawer-quarters generator and P7 coupon; roadmap v2.3
    - src/fit.py: every tuned clearance in one module with its owning coupon
    - src/parts/drawer_quarters.py: CadQuery generator for the four drawer
    quarters (floor puzzle-dovetail tabs, wall-crossing sliding dovetails,
    outer walls); crop() yields coupon pieces from the real part
    - src/coupons/p7_quarter_joint.py -> coupons/p7/*.stl: centre cross (4),
    wall crossing (2), beam section (2) and p7-plate.stl laid out flat
    - drawer-quarters sheet v1.1: tabs start 25 from the wall (15 fouled the
    wall-crossing boss); PDF regenerate pending (file was open)
    - ROADMAP v2.3: D5 confirmed, 300 mm pack ordered, fit.py done, P7 done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
    [beam-front.stl, beam-rear.stl, cross-Q1.stl, cross-Q2.stl, cross-Q3.stl, cross-Q4.stl, p7-plate.stl, wall-Q1.stl]
2026-09-15 Stage 0: fit.py, drawer-quarters generator and P7 coupon; roadmap v2.3
    wall-crossing boss)
    - ROADMAP v2.3: D5 confirmed, 300 mm pack ordered, fit.py done, P7 done
    - .gitignore for __pycache__
    Co-Authore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
2026-09-16 Spacer set + web gauge STLs; roadmap 0.4 points at them
    - src/coupons/spacers.py -> coupons/spacers/: 48, 63.5, 139.5, 159 rail
    spacers (print flat, length in XY, engraved) and the 3.0 mm web gauge,
    plus spacers-plate.stl with two of each
    - ROADMAP.md: 0.4 references the plate and print settings
    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
    [gauge-3.0.stl, spacer-139.5.stl, spacer-159.stl, spacer-48.stl, spacer-63.5.stl, spacers-plate.stl]
2026-09-17 Print rules, design-for-print review, printcheck; cradle re-oriented
    - PRINT-RULES.md: house rules for orientation, precision surfaces,
    overhangs and supports, plus a part-by-part review of every production
    part with rulings (T-foot carries the web; knuckles separate; runner
    rib-on-drawer; fronts stand on the bottom edge; cradle top-face-down
    with sacrificial-layer counterbores; strip pegs with 45° cone)
    - src/printcheck.py: resting-face / down-facing check run by every export
    - psu-cradle-v2.stl re-exported top-face-down (same geometry);
    src/psu_cradle.py, spacers.py, p7_quarter_joint.py call printcheck
    - ROADMAP.md: print-settings table; link to PRINT-RULES.md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
    [psu-cradle-v2.stl]
2026-09-17 Move the PSU cradle into parts/ (STL) and src/parts/ (script)
    - parts/psu-cradle-v2.stl replaces the root copy; src/parts/psu_cradle.py
    replaces src/psu_cradle.py and exports there. Convention from now on:
    production STLs in parts/, their scripts in src/parts/, coupons in
    coupons/ with scripts in src/coupons/, Bambu projects in bambu/.
    - psu-cradle-v2.py in the root is the handover's copy of the old script;
    removed as superseded
    - ROADMAP.md: close-out archive line and Bambu/MakerWorld conventions
    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
    [psu-cradle-v2.stl]
2026-09-17 PSU cradle v3: cup sized from the measured foot; P2 saddle/bolts passed
    - fit.py: RAIL_CLR 0.4 passed; PSU_FOOT_D 21.5 (measured: 21.5 at the pad,
    19.5 at 4 mm up); CUP_CLR 0.3; HOLE_SHRINK 0.3 radial (Ø22.2 printed
    Ø21.6 in black ASA)
    - parts/psu-cradle-v3.stl (v2 removed): cup Ø22.7 modelled -> ~22.1
    printed, 1 mm 45° lead-in at the rim; otherwise identical, exported
    top-face-down; src/parts/psu_cradle.py reads fit.py
    - parts/, src/parts/, coupons/, bambu/ folder convention; root copies of
    the cradle STL and script removed
    - ROADMAP.md: P2 row records the v2 result; Bambu/MakerWorld conventions
    Claude-Session: https://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
    [psu-cradle-v2.stl, psu-cradle-v3.stl, psu-cradle.3mf]
2026-09-17 PSU cradle v3: conical cup matching the measured foot taper
    - foot measured 16.8 at the pad, 19.5 at 4 mm up, 21.5 at the flange;
    v3 cup is a cone, floor Ø18.0 -> rim Ø20.7 modelled (~17.4 -> ~20.1
    printed, 0.3 radial on the foot), 1 mm 45° lead-in — self-centres
    - fit.py: PSU_FOOT_PAD_D, PSU_FOOT_D4 replace PSU_FOOT_D
    - ROADMAP.md: P2 row updated
    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
    [psu-cradle-v3.stl]
2026-09-17 P2 cup coupon: three conical cups at 0.2 / 0.3 / 0.4 radial
    - coupons/p2/p2-cup-coupon.stl (src/coupons/p2_cup.py): 96 x 30 x 8 bar,
    cups from fit.py foot dimensions + HOLE_SHRINK, printed in the cradle
    orientation; the winning cup sets CUP_CLR before the cradle prints
    - ROADMAP.md: P2 row points at it
    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
    [p2-cup-coupon.stl]
2026-09-17 P2 cup coupon round B: -0.2 / -0.4 / -0.6 radial
    - round A (0.2/0.3/0.4) had play in all three, 0.2 best: the conical cup
    floor does not shrink like a straight bore. Round B cancels HOLE_SHRINK
    and goes up to 0.3 radial interference on the rubber.
    - src/coupons/p2_cup.py takes a round argument; coupons/p2/ holds a and b
    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
    [p2-cup-coupon-a.stl, p2-cup-coupon-b.stl]
2026-09-17 CUP_CLR set from the P2 coupons; cradle v3 regenerated
    - fit.py: CUP_CLR 0.1 radial on the foot nominal, no shrink allowance for
    conical cups (round A 0.5/0.6/0.7 net all loose; round B 0.1 best)
    - parts/psu-cradle-v3.stl: cup floor Ø17.0, rim Ø19.7, lead-in unchanged
    - ROADMAP.md: P2 row — cup coupon closed, cradle v3 is the remaining test
    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
    [psu-cradle-v3.stl]
2026-09-17 P2 passed: PSU cradle v3 fits the foot and the rail
    - ROADMAP.md: P2 ticked, Stage 3 open — three more PSU cradles print
    from parts/psu-cradle-v3.stl; AWG cradles next
    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
    [psu-cradle.3mf]
2026-09-17 P2 and P7 passed; roadmap ticks
    - P2: PSU cradle v3 fits the foot and the rail — Stage 3 open, three more
    PSU cradles print from parts/psu-cradle-v3.stl
    - P7: quarter joint good at DOVETAIL_CLR 0.15 — fit.py marked passed;
    drawer quarters, split beams and box halves released
    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
2026-09-17 Strip measured (open item 1 closed); yellow-PETG coupon rule; P2/P7 passed
    - fit.py: Addtam strip dimensions (keyholes 249.5 c-c, Ø6.5/3.5, 20 from
    the cable end, 6.5 deep, 29.2 off one edge of 78.1)
    - ROADMAP.md: Stage 8 bracket note, plate table (yellow PETG for coupons),
    P2 and P7 ticked
    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
2026-09-17 D8 revised: strip vertical on the rear-left upright, shelf takes the weight
    Horizontal on the base rail needs ~380 mm (350 body + cable exit) and the rear has nothing to spare either
    side, so the strip goes back to HANDOVER's vertical rear-left position: two L-brackets in the left upright's
    rear slot, pegs at z 45 / 294.5, x 30.2, body x 1-79, z 25-375, cable end down. The keyhole slots are
    horizontal in that orientation and cannot carry it, so the lower bracket gets a shelf under the strip end;
    the pegs only hold it to the frame. Diagonal considered and rejected: at 45 deg the body crosses the PSU fan
    zone and neither keyhole lands on a rail or upright. ROADMAP D8 row + Stage 8 bracket geom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
2026-09-17 P1 sled-foot coupon issued; spacers printed; beams print top face down
    src/parts/sled_foot.py: T-foot + web + rib as one 210 mm part (flange 10.6 x 3.8, neck 5.8 x 2.5, web 2.5,
    rib 2.5 -> 5.0 at 45 deg inside the beam) and beam_rebate() for the beam's outer bottom edge. Prints standing:
    the neck/flange grow toward -x and the rib toward +x, so neither web face can be the bed; standing, every fit
    face is a vertical wall or 45 deg and the only downward face is the neck's 2.5 mm bridge.
    src/coupons/p1_sled_foot.py -> coupons/p1/ (foot-40, beam-40, p1-plate, p1-section.png). Black ASA.
    fit.py: SLOT_LIP_T, FOOT_STANDOFF, FLANGE_GAP, FOOT_FLANGE_W, RIB_H, RIB_W, WEB_RIB_CLR (P1 owns them).
    PRINT-R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
    [beam-40.stl, foot-40.stl, p1-plate.stl]
2026-09-19 Cut sheet by jig setting; P1 v2 (closed beam groove, beams flat); P6 pull insert (D9); P9 cup + stand pocket
    - CUT-TABLE.md + ROADMAP §2: cuts ordered by jig setting (200, 179.5, 70, 510, 321, 310, 307), bars labelled A-H /
    W-Z, labelled end never to the stop, stop-side piece is always the finished one.
    - P1 v2: web moved to x 22.2 (FOOT_STANDOFF 2.2, neck 4.2) so the beam keeps a 1.5 wall outside it and its dovetail
    groove is closed on both sides -> beams print flat again (cups and pockets open upward). beam_rebate -> beam_groove.
    The printed v1 foot still tests the slot fit; reprint p1-plate for the rib/groove pair.
    - D9: pulls are separate face-down inserts in a top-edge notch (a s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
    [beam-40.stl, cup-pad.stl, facia-80.stl, foot-40.stl, p1-plate.3mf, p1-plate.stl, p9-plate.stl, pull-60.stl]
2026-09-19 D10: 12 V RGB 5050 task light bar under the top panel's front edge
    Printed pelmet 361 x 12 x 12 (two halves on a P7 puzzle tab, end clips into the front uprights' front slots),
    10.4 channel for the 10 mm tape, diffuser lip tilted ~30 deg to the bench; 12 V 1 A adaptor + RGB controller on
    the Addtam, 4-wire cable down the front-left upright's inner slot. Stage 8 trim; frame and cut sheet unchanged.
    Drawn in bench-stack-3d.html with its own checkbox.
    Accuracy note on both cut sheets: +-0.5 fine, sets must match, ends square, err short.
    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
2026-09-19 Extrusion cut (Stage 1 cut sheet ticked); P9 plate printed; coupon 3mf files
    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
    [p9-plate.3mf, pull-60.3mf]
2026-09-19 P1 v3: T-nut flange from the measured slot (mouth 5.9, cavity 10.6, throat 4.45, bottom 6.5 at 6.15)
    The CNCMANS 2020 slot is a standard T-slot with a ~45 deg throat, not a square cavity: fit.py now carries the
    measured SLOT_* numbers and derives the neck (5.5) and flange (10.2, chamfered to 6.8 at the bottom) from them
    with SLOT_CLR 0.2 per side. src/parts/sled_foot.py rebuilt on those; coupons/p1 regenerated (foot-40 v3,
    beam-40 unchanged from v2, p1-plate, section drawing with the real slot profile). Foot may print in yellow PETG
    for the fit test. Cut sheet ticked; P9 and P6 printed.
    Claude-Session: https://claude.ai/code/session_0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
    [facia-80.3mf, foot-40.stl, p1-plate.stl]
2026-09-19 P3 runner coupon: L-runner into the base rail's top slot, house groove in the drawer wall boss
    src/parts/drawer_runner.py (runner + groove_cut + wall_stub), src/coupons/p3_runner.py -> coupons/p3/runner-80.stl (ASA),
    stub-100.stl (PETG), p3-section.png. fit.py P3 note; ROADMAP 0.3/plates/P3 row/2.1 T-nut order; PRINT-RULES rule 2
    allowance and runner/quarter rows.
    Claude-Session: https://claude.ai/code/session_01XhJ93Ki5HYGuJfRqyMVkZS
    [runner-80.stl, stub-100.stl]
2026-09-19 P9 v2: six straight D cups on the measured bumper (25.9 x 24 at 5 mm up) — v1 Ø32.6 was never a bumper dimension
    Calipers: pad patch 20 x 9.5, 25.9 x 24.0 at 5 up, 25.9 x 26.4 at the chassis, ~14 tall, bullnosed bottom. fit.py
    BUMPER_W/D5/D_BASE/PAD/H/CUP_D + CUP_V2 (-0.1..+1.0); src/coupons/p9_cups_v2.py -> coupons/p9/p9-cups-v2.stl, 5 straight
    + 1 lead-in, value stamped by each. ROADMAP P9 row + status.
    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
    [p9-cups-v2.stl]
2026-09-19 P9 v2: six straight D cups on the measured bumper (25.9 x 24 at 5 mm up) + stand pad v2 (44 x 23.1 main leg)
    Bumper calipers: pad patch 20 x 9.5, 25.9 x 24.0 at 5 up, 25.9 x 26.4 at the chassis, ~14 tall, bullnosed bottom;
    v1 Ø32.6 was never a bumper dimension. Stand pocket v1: width 44.6 passed, length failed — the 43 overall includes the
    folded flap under the main leg (23.1). fit.py BUMPER_W/D5/D_BASE/PAD/H/CUP_D + CUP_V2 (-0.1..+1.0), STAND_W/STAND_L;
    src/coupons/p9_cups_v2.py -> coupons/p9/p9-cups-v2.stl, stand-pad-v2.stl, p9-v2-plate.stl. ROADMAP P9 row + status.
    Claude-Session: https://claude.ai/code/session_01XhJ93Ki5HYGuJfR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
    [p9-v2-plate.stl, stand-pad-v2.stl]
2026-09-19 P1 v4 slot-clearance round (0.3/0.4/0.5) and P6 v2 slot-height round (12/14)
    P1: v3 enters bar Z's slot but is tight; rib/beam pair passed. src/coupons/p1_foot_v4.py -> coupons/p1/p1-feet-v4.stl,
    three feet length-coded 40/45/50 mm = SLOT_CLR = FLANGE_GAP 0.3/0.4/0.5.
    P6: v1 fit passed, slot 10 too small for a thick finger. p6_pull.py parameterised on the slot height; coupons/p6/
    pull-60-o12/o14 + facia-80-o12/o14 + p6-v2-plate.stl. 14 is the cap: the pocket back wall bridges 11.2 at 14, 13.2 at 16
    (rule 4: 12). Inserts to print in the logo blue (HANDOVER §8). ROADMAP P1/P6 rows + status.
    Claude-Session: https://claude.ai/code/sessio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
    [facia-80-o12.stl, facia-80-o14.stl, p1-feet-v4.stl, p6-v2-plate.stl, pull-60-o12.stl, pull-60-o14.stl]
2026-09-19 P9 v3: fuller-shouldered D cups (sides 13, flatter end arc), one row 0.1..1.3 — v2 only fitted at +1.0; flat faces rear
    fit.py BUMPER_FLAT rear, BUMPER_SIDE_L 13, BUMPER_CUP_V3; src/coupons/p9_cups_v3.py -> coupons/p9/p9-cups-v3.stl (232 x 46),
    p9-v3-plate.stl (with stand pad v2). ROADMAP P9 row + status.
    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
    [p9-cups-v3.stl, p9-v3-plate.stl]
2026-09-19 PSU cradles: all four printed (v3, black ABS); P9 cup passed at v3 +0.3
    ROADMAP Stage 3 row + status; fit.py BUMPER_CUP_CLR marked passed.
    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
2026-09-20 P6 and P9 passed: pull slot 12, stand pocket 44.6 x 23.7 (cup +0.3 earlier)
    fit.py JPULL_OPEN_H 12, STAND_L/STAND_CLR marked passed. ROADMAP P6/P9 rows ticked, status.
    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
2026-09-20 P3 coupon: geometry passed, friction verdict deferred to the 300 ABS runners on the frame (four bolts, ironing)
    fit.py RUNNER_CLR note; ROADMAP P3 row, Stage 4 runners, status.
    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
2026-09-20 Materials rule: one black ABS+ spool for sliding pairs and long bars, plain ABS for the rest
    ROADMAP §2 spool table + Stage 4/5 part tags; PRINT-RULES rule 6.
    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
2026-09-20 P1 v4: 0.3 slot clearance wins (40 mm foot); SLOT_CLR/FLANGE_GAP 0.3 pending the ABS+ confirm
    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
    [fit.py]
2026-09-20 D10 rev 2: WS2812B strips on the rear uprights (inside, out of view), sill panel under the PSU with the lit switch, XIAO + WLED, USB from the Addtam
    Viewer: pelmet removed, sill panel + end blocks + button, strips on the rear uprights. ROADMAP D10 row, Stage 8 list, status. .gitignore: Claude outputs/.
    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
2026-09-20 D10 rev 2 + cable plan: strips on the rear uprights, sill panel with 8 mm button + lit halo, every wire in a slot or printed channel
    Viewer: pelmet removed, sill panel + end blocks + button, strips on the rear uprights. ROADMAP: D10 row (parts, wiring, buy list),
    cable plan table in §0 (routes, printed provisions, paths kept clear), P8 gains a TPU slot-cover coupon, Stage 8 list, status. .gitignore: Claude outputs/.
    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
2026-09-20 P4 clip-tile coupon: spring-finger clip (25 x 5.5 finger, 5.1 x 6 peg, 60° barb 0.6 / 0.9)
    src/parts/slot_clip.py (add_finger, peg profile with slot-geometry asserts), src/coupons/p4_clip_tile.py -> coupons/p4/tile-b06.stl,
    tile-b09.stl, p4-plate.stl, p4-sections.png. fit.py P4 note; ROADMAP 0.3, plate B, P4 row, status.
    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
    [p4-plate.stl, tile-b06.stl, tile-b09.stl]
2026-09-20 P4 v2: four small clip strips A-D (root stubs for lateral location, hook on the lip, barb 0.9/1.2) — v1 loose
    src/parts/slot_clip.py: STUB_L/STUB_CLR root stub, HOOK_GAP 0, hook angle + finger width per call; src/coupons/p4_clip_tile.py
    -> coupons/p4/tile-v2-A..D.stl, p4-v2-plate.stl (66 x 14 strips). ROADMAP P4 row + status; PRINT-RULES rule 9: a coupon is the joint only.
    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
    [p4-v2-plate.stl, tile-v2-A.stl, tile-v2-B.stl, tile-v2-C.stl, tile-v2-D.stl]
2026-09-20 AWG cradles v1: left saddle (prints on end) + right side-face bracket (the mini slot owns the inner rail's top)
    src/parts/awg_cradle.py -> parts/awg-cradle-left-v1.stl, awg-cradle-right-v1.stl. Arms flush with the rail top, 20.4 x 1.5 pad
    pockets; corner lips move to the TPU pads (P8). ROADMAP Stage 3, P8 rows, status.
    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
    [awg-cradle-left-v1.stl, awg-cradle-right-v1.stl]
2026-09-20 P4 passed: variant C (barb 1.2, 45° hook, root stub 5.7) — CLIP_BARB 1.2, CLIP_HOOK_DEG 45, CLIP_STUB_CLR 0.1
    fit.py new clip values; slot_clip.py reads them; ROADMAP P4 row ticked, progress line, status.
    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
    [awg-cradles.3mf]
2026-09-21 AWG cradles printed; P1 ABS+ confirm coupon (foot-40 at 0.3) and the 210 sled foot exported
    - ROADMAP v2.5: AWG cradles ×4 printed 2026-09-21 (v1, black ABS); status line rewritten — P1 ABS+ confirm is the
    open print, sled beams blocked on the stand main-leg position
    - coupons/p1/foot-40.stl + p1-plate.stl re-exported from fit.py at SLOT_CLR 0.3 (neck 5.3, flange 10.0) for the ABS+
    confirm; beam-40 unchanged
    - parts/sled-foot-210.stl: production T-foot at 0.3, modelled only — prints after P1 ticks
    - printcheck thresholds on the foot raised to the v4 figures (neck bridge is 166 % of the two bed edges at 0.3)
    - fit.py comments: neck 5.3 / flange 10.0 (were the v3 0.2 figures)
    Co-Auth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
    [foot-40.stl, p1-plate.stl, sled-foot-210.stl]
2026-09-22 P5 coupon modelled; P8 modelled and deferred to a single TPU session
    P5 (coupons/p5/p5-plate.stl, src/coupons/p5_hinge_magnet.py) - yellow PETG,
    standing so every bore is vertical (PRINT-RULES rule 2), 104 x 25 x 35,
    7.5 cm3. Three-segment butt hinge, barrel dia 8 on a 5 x 18 pad, bore 3.2,
    0.4 axial clearance, axis on the pads' mating plane so the pair opens flat to
    180. A segment that starts above the bed is coned 45 deg right in to the bore,
    so there is no floating annulus and nothing needs support. Two printed pins at
    3.0 and 2.9 on snap-off disc feet, two 12 x 12 x 3 magnet bosses so the
    pull-apart can be felt across the 0.5 gap. Prints now.
    P8 (coupons/p8/p8-plate.stl, src/coupons/p8_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
    [awg-pad.stl, foot-24.stl, knuckle-door.stl, knuckle-frame.stl, magnet-boss.stl, p5-plate.stl, p8-plate.stl, pin-2.9.stl]
2026-09-22 Door hinge re-designed; first side tiles and strip brackets; one yellow run
    P5 v1 FAILED. The two knuckles' bore sat on the pads' mid-thickness, so the
    leaves could not fold: bring the pads together and the bores are one pad
    thickness apart, and the pin will not pass. A butt hinge's axis lies outside
    both leaves. Root cause is a process one - the coupon was a generic block, not
    a section of a production part, which ROADMAP 0.3 forbids precisely so this
    has something to fail against. There was no production part, so nothing
    checked it.
    D11 (new): hinge axis x 362 -> 369, z 341 unchanged. HANDOVER 5 and the viewer
    put it at 362, but the viewer draws the side tiles on the rail centreline
    (x 35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
    [hinge-door-v1.stl, hinge-frame-v1.stl, knuckle-door-v2.stl, knuckle-door.stl, knuckle-frame-v2.stl, knuckle-frame.stl, p4-tiles-plate.stl, p5-v2-plate.stl]
2026-09-24 Scope feet positioned by the P9 jigs; beams v1 re-exported and released; P1 passed in ABS+
    - src/coupons/p9_position_jig.py + coupons/p9/{bumper-jig,stand-jig,p9-jigs-plate}.stl: cup / pocket in a plate with
    skirts, so each foot's position is a caliper gap. Results 2026-09-24 (fit.py): bumper centre 44.15 from the bezel
    side, flat 116 from the front face (HANDOVER 39 / 135 were 5 and 19 out); stand edge 24.7 from the bezel side, leg
    front 10 from the face; body inset 4.7 per side behind the bezel
    - fit.py: P1 PASSED (ABS+ 40 mm foot at 0.3); STAND_H, STAND_X_FROM_SIDE, STAND_FRONT_FROM_FACE, BUMPER_X_FROM_SIDE,
    BUMPER_REAR_FROM_FACE, scope placement
    - src/parts/sled_beam.py: left bea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
    [bumper-jig.stl, p9-jigs-plate.stl, sled-absplus-plate.stl, sled-beam-left-front-v1.stl, sled-beam-right-front-v1.stl, stand-jig.stl]
2026-09-25 Sled beams v1 placed from the P9 jig readings; overnight ABS+ plate; P1 passed in ABS+
    - fit.py: P1 PASSED (ABS+ 40 mm foot at 0.3, minor rock accepted). Scope feet from the
    2026-09-24 jig readings: bumper centre 44.15 from the bezel side, flat 116.9 from the
    front face (apex 92.9 by the jig chain; HANDOVER's 39 / 135 were 5 and 18 out); stand
    edge 24.7 from the bezel side, leg front 10 from the face; body inset 4.7 per side.
    STAND_POCKET_CLR_X 0.6 / _REAR 1.0: in the beam the cups locate, the pocket levels
    - src/parts/sled_beam.py: left beam in world coordinates, right = mirror; groove closed
    at y 119.5 (foot threads in from the rear, then bonded), P7 puzzle tab at the y 165
    spl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
    [sled-absplus-plate.stl, sled-beam-left-front-v1.stl, sled-beam-right-front-v1.stl]
2026-09-26 Yellow run re-issued as the 2026-09-25 plate after a geometry review; 09-22 plate removed
    - Review (this session, in CadQuery, from the repo's own scripts): the band-1 / band-2 tile pair
    seated on a rail with edges on the slot centreline — zero intersection between them, every
    peg and stub inside the measured 2020 slot profile, barbs hook the lip (0.5 pull-off collides),
    root stubs locate (0.3 slide collides); Ø3 pin passes both hinge leaves, leaves clear closed
    and through a 30–180° swing against the frame leaf, scope rail and tile below; strip-bracket
    pegs 3.2 / Ø6.0 / 5.5 deep against the 3.5 slot, Ø6.5 hole, 6.5 pocket. No geometry changed.
    - coupons/yellow-run/yellow-r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
    [yellow-run-2026-09-22.stl, yellow-run-2026-09-25.stl]
2026-09-26 Strip bracket lower v2: brace moved under the shelf — v1's gusset sat inside the strip's footprint
    - Found on the yellow run: the lower bracket's 45° gusset stood on the shelf in front of the plate, in the
    corner where the strip's bottom end has to sit (3.9 cm3 of overlap by boolean check). Upper bracket fitted.
    - src/parts/strip_bracket.py: gusset now under the shelf, plate extended down to z 1 to carry it; overlap with
    the strip body is now the peg in its keyhole pocket only; clears the base cross rail. Rule noted in the
    header: a print-only brace goes where nothing else lives — check it against the working envelope.
    - parts/strip-bracket-lower-v2.stl replaces -v1 (removed)
    Co-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
    [strip-bracket-lower-v1.stl, strip-bracket-lower-v2.stl]
2026-09-26 ROADMAP v2.8: sled slides proven in ABS+, tiles and hinge pin passed on the yellow run, strip bracket lower v2, frame build next
2026-09-26 bambu print file
    [sled-absplus-plate.3mf]
2026-09-26 Side tiles: production set of 12 with windows for the cradle lips and hinge plates; six black PETG plates
    - Assembled the whole side skin in CadQuery (12 tiles on 8 rails with the measured slot profile) and found two
    things sitting in the tile plane that nothing had checked against: the PSU and left-AWG cradle saddles' outer
    lips (3 x 6 on the rails' outer faces) and the door hinge's frame plates (right scope rail). Bands 2 and 3 now
    carry through-windows for them, so they are distinct left/right, front/rear tiles; band 1 is one tile x4.
    Whole skin intersects nowhere; every tile is one solid. Right tiles are the left ones turned 180 about z.
    - src/parts/side_tile.py: tile(cutouts=...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
    [tile-band1-v1.stl, tile-band2-LF-v1.stl, tile-band2-LR-v1.stl, tile-band2-RF-v1.stl, tile-band2-RR-v1.stl, tile-band3-LF-v1.stl, tile-band3-LR-v1.stl, tile-band3-RF-v1.stl]
2026-09-26 Strip brackets: peg line 30.2 -> 38.2 (keyhole seat, not its start); lower v3, upper v2
    - On the yellow run the peg lined up with the START of the strip's keyhole, not the point where the shaft seats:
    the 29.2 measured on 2026-09-17 was to the keyhole's near edge. STRIP_KEYHOLE_OFF 29.2 -> 37.2 (+8, Gareth).
    - src/parts/strip_bracket.py: PEG_X derived from it (38.2); arm to 42.2. Both brackets re-exported: lower v3
    (brace under the shelf, from v2) and upper v2. Overlap with the strip body is the peg in its pocket only.
    - v1 upper, v2 lower and the old plate removed.
    Claude-Session: https://claude.ai/code/session_018PmxMd1vEZr7qQW3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
    [strip-bracket-lower-v2.stl, strip-bracket-lower-v3.stl, strip-bracket-upper-v1.stl, strip-bracket-upper-v2.stl, strip-brackets-plate.stl]
2026-09-27 Strip brackets: lower v4 clears the mains cable; upper back to v1
    The v2/v3 lower bracket's shelf sat under the strip's mains cable. The
    cable leaves the strip's bottom end on the keyhole line, is 15 mm thick
    and rigid for 25 mm, so nothing can sit under it there.
    - lower v4: shelf is a U round the cable (gap x 14.2-46.2, 8 mm bridge
    against the plate), brace under the shelf stops short of the gap;
    strip raised to z 75-425 so the cable can bend before the bench
    - pegs now at z 95 and 344.5; fit.py STRIP_KEYHOLE_OFF back to 29.2
    (the +8 tried in v3 was not the problem)
    - upper bracket: v2/v3 removed - the part is built around its peg, so it
    is identical to the printed v1; only its bo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
    [strip-bracket-lower-v3.stl, strip-bracket-lower-v4.stl, strip-bracket-upper-v1.stl, strip-bracket-upper-v2.stl]
2026-09-27 bambu print files
    [tiles-plate-B.3mf, tiles-plate-C.3mf]
2026-09-27 ROADMAP: strip mounted on the rear-left upright, hangs solidly
    Claude-Session: https://claude.ai/code/session_018PmxMd1vEZr7qQW3YDwb81
2026-09-27 ROADMAP: P5 passed (2.9 pin, free swing past 180); 0.3 and 0.6 ticked
    - P5: hinge pair swings without binding on the 2.9 pin; PIN_D 2.9 stands.
    Tested pair is a build; second pair prints with the door tile
    - 0.3 was complete (all eight coupon scripts) but never ticked; 0.6 done
    in practice, TPU plate D folded into the Stage 8 session by rule
    - Progress: Stage 1 gates now P1 P2 P4 P5 P6 P7 P9; P3 and P8 open
    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
2026-09-27 ROADMAP: 0.5 already done in layout v15 - Stage 0 complete
    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
2026-09-27 Stage 2: frame assembly viewer and the T-nut / cast-bracket plan
    - frame-assembly-3d.html (src/frame_assembly_viewer.py): step-by-step 3D
    of the frame going together, layout-sheet part names, spacers shown
    where they are used, scope rails ghosted (they wait for 2.6)
    - ROADMAP 2.1-2.6: assembly sequence (sides flat on the bench, join at
    the rear, PSU rails, inner sub-frame as a ladder from the front, AWG
    rails); T-nut tally per rail slot (drop-in nuts, so no pre-loading);
    hidden L-connectors on the faces that look into the frame; cast
    brackets only where a hidden L cannot go - under the scope rails
    (feet own the inner slot) and the front tie's outer end (3 mm offset
    from the u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
2026-09-27 ROADMAP v2.10: session handover, frame assembly in progress
    - HANDOVER paragraph at the top of Progress for the next session: state
    of every gate, frame assembly under way from frame-assembly-3d.html,
    print queue (tile plate C tonight, D-F after), the ask for a bigger
    overnight job (drawer quarters or the ABS+ bar plate), the modelling
    queue in order, and how Gareth wants files, commits and instructions
    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
2026-09-27 ROADMAP v2.10: session handover, frame assembly in progress
    - viewer: ghosted scope rails only on the last step; connector faces
    corrected (inner rails on the right faces); end-entry connectors
    pre-loaded into the uprights; each side built flat with all four of
    its rails at once (a rail cannot be added between fixed uprights),
    scope ra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
    [frame_assembly_viewer.py]
2026-09-28 Bottom-drawer quarters v1: production pass released (ROADMAP v2.11)
    - src/parts/drawer_quarters.py: quarter(i, production=True) adds the
    runner groove (P3 geometry, drawer_runner.groove_cut, RUNNER_CLR 0.3)
    in a 10 x 20 boss along each outer side wall, closed at the front wall
    and open at the rear; left/right wall dovetails raised to z 20-60 with
    a 45 deg underside; four M3 facia screw pads inside the front wall
    (Q1/Q2, x 40/117.5/197.5/275, z 20, teardrop holes). Coupon geometry
    (quarter(i) default) unchanged - P7 STLs re-export byte-identical
    - parts/drawer/drawer-Q1..Q4-v1.stl: floor down, 165.5 x 158 x 60,
    127-135 cm3 each, printcheck 90 % resting face, no down-facing area;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
    [drawer-Q1-v1.stl, drawer-Q2-v1.stl, drawer-Q3-v1.stl, drawer-Q4-v1.stl]
2026-09-28 Sled front bar + cross bars v1: the ladder that stops the beams leaning
    - Finding 2026-09-28: the scope on the bare beams rolls them inwards
    (3-4 mm at the stands - slot play 0.3, unglued rib 0.2, 2.5 web);
    the designed ladder is the fix, so the bars come forward in the queue
    - src/parts/sled_bars.py: front bar 315 x 12 x 18 (z 337-355) with P7
    sockets in its rear-bottom edge at x 40.25 / 320.75 and a 120 x 6 pull
    notch in the top edge; cross bars between the beams (x 60-301) at
    y 190-210 and 308-335, tabs into the beams' existing sockets, 5 x 10
    guide lips (front lip chamfered at the exit end, rear lip at y 330-335)
    - parts/sled-front-bar-v1.stl (grey PETG, standing on the diago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
    [sled-cross-bar-front-v1.stl, sled-cross-bar-rear-v1.stl, sled-front-bar-v1.stl]
2026-09-28 Seating jigs for the PSU and AWG cradles (yellow PETG, one plate)
    src/jigs/seating_jigs.py -> jigs/seating-jigs-plate.stl (+ the single parts):
    PSU L / PSU R bars with two replica PSU feet (y 51 / 253.5) and a nose arm
    that stops on the front-left upright (y 20) / front inner upright (y 23);
    AWG L / AWG R bars with two bosses into the pad pockets (203 / 200 apart);
    four PETG stand-in AWG pads so the AWG can sit before the TPU session.
    Proven against the cradle models: 0 intersection in place, 0.5 forward
    collides. ROADMAP: status line, and three clashes found in the model
    (PSU cup spacing, AWG arms over the PSU top, right AWG brackets beside
    the PSU) awaiting measurements before any reprint.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
    [awg-pad-standin.stl, seat-jig-awg-L.stl, seat-jig-awg-R.stl, seat-jig-psu-L.stl, seat-jig-psu-R.stl, seating-jigs-plate.stl]
2026-09-28 ROADMAP: Stage 9 gains the complete Bambu project and the build guide
    - One multi-plate Bambu Studio project for the whole build
    (publish/SiglentTower-complete.3mf), plates named by material and
    colour, jigs included on plates marked "any colour, any PETG/PLA",
    coupons left out
    - A full build guide: shopping list, tools, cut sheet, what to print,
    then every build step with its diagram, jig and check
    Claude-Session: https://claude.ai/code/session_014F2FiCBtz7CY6yjVLNPDob
2026-09-30 Bottom-drawer runners v1: production pass released (ROADMAP v2.12)
    - src/parts/drawer_runner.py: production() - the P3 section, 300 long,
    four M5 x 10 counterbored at y 20 / 107 / 193 / 280. Symmetric, so the
    left and right runners are the same part; `--export` writes
    parts/drawer/drawer-runner-300-v1.stl leg-top down on the bed diagonal
    and runs printcheck on it (66 % resting face, only the counterbore
    ceilings face down - sacrificial layer).
    - src/drawer_check.py uses the production runners: 0.000 cm3 in place,
    drawer up 0.2 / sideways 0.5 collides, sideways 0.2 / down 0.5 free.
    - ROADMAP v2.12: print jobs for the two nights (black ABS+, one runner a
    plate - two with the 5 mm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
    [drawer-runner-300-v1.stl]
2026-10-01 Sled front bar v2: saddles on the beams so the stand arms cannot drop
    - Gareth, 2026-09-28: the stand arm's inboard edge drops under the scope
    and he wants it supported by design. Nothing can go under the arm
    (AWG 1 mm below), so the support stops the beam rolling about its foot:
    a 9 mm tab in a socket is a hinge in roll, glued or not
    - src/parts/sled_bars.py: saddles on the bar's rear face, x 20.5-46 /
    315-340.5, y 12-88, z 346-353, lying on each beam body - a 25.5 x 76
    lap, CA'd and screwed (two M3 x 14 self-tappers a side through 3.4
    teardrop holes at x 33/328, y 30/70, 2.5 pilots in the beam). Bar now
    prints front face down (sockets open to the top, saddles rising, 86 %
    r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
    [drawer-runner-300-v1.3mf, sled-front-bar-v1.stl, sled-front-bar-v2.stl]
2026-10-01 Sled front bar v3 + beam front halves v2: the stand pad is held by the bar
    - Gareth, 2026-10-01: the pad should insert into the bar, not be glued
    to it. Each front half's front edge now carries two plain tongues
    (14 x 8 x 4, z 341.5-345.5, 45 deg wedge under the root): body at
    x 40.25 and stand pad at x 78. The bar has four closed pockets
    (0.15 clr, 4.35 floor, 9.35 above) and slides on from the front, so
    every tongue is captured above and below - the pad cannot drop. The
    v1 dovetail tab (open-bottom socket = hinge in roll) is gone; saddles
    and M3 screws stay and lock the bar on
    - src/parts/sled_beam.py: TONGUE_* constants, tongue_wedge(); VERSION map
    -> sled-beam-{left,right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
    [sled-beam-left-front-v2.stl, sled-beam-right-front-v2.stl, sled-front-bar-v3.stl]
2026-10-01 Sled front tongue: one 68 mm tongue out to the stand pad's inboard edge
    - Gareth, 2026-10-01: the hold-down belongs right at the pad's edge. The
    two 14 mm tongues (body x 40.25, pad x 78) become ONE tongue x 28-96,
    beam body through to the pad's inboard edge, 68 x 8 x 4, same height
    and 45 deg root wedge; the bar's pocket is one 68.3 x 4.3 closed
    pocket per beam, 4.85 of wall outside it
    - src/parts/sled_beam.py: TONGUE_X0/X1 replace TONGUE_X/TONGUE_W;
    tongue_wedge(x0, x1, grow)
    - src/parts/sled_bars.py: one pocket + wedge cutter per beam
    - parts/sled-beam-{left,right}-front-v2.stl and sled-front-bar-v3.stl
    re-exported (70 / 80 cm3); sled_check all 0 cm3, bar lifted/lowered 1
    co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
    [sled-beam-left-front-v2.stl, sled-beam-right-front-v2.stl, sled-front-bar-v3.stl]
2026-10-01 P3 passed: drawer fits and slides well; frame checks 2.1–2.6 ticked (ROADMAP v2.14)
    Gareth, 2026-10-01: the frame checks out (diagonals, 321 at the front,
    510 overall, no wobble) — Stage 2 steps 2.1–2.6 ticked, 2.7 stays open
    behind the PSU/AWG seating measurements. Both 300 ABS+ runners bolted
    into the base rails; the dry-fitted drawer fits and slides well, so P3
    is ☑ and RUNNER_CLR 0.3 is final in fit.py. Only P8 (the Stage 8 TPU
    session) is still open. Column guide strips and the mini-slot runner are
    released for modelling. Next on the drawer: glue the wall dovetails,
    then the home stop.
    Claude-Session: https://claude.ai/co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
    [fit.py]
2026-10-02 ROADMAP: front bar saddles glued only, M3 count back to 4
    [sled-cross-bar-front-and-rear-v1.3mf, sled-front-bar-v3.3mf]
2026-10-02 Bottom-drawer facia v1 + pull insert v1 with the iguana inlay
    - src/parts/drawer_facia.py: facia 315 x 3 x 83 (frame z 3-86, y 0-3),
    top-edge notch 100.3 x 23.15 for the P6 insert at 100 wide (slot 80 x
    12, hook 5, pocket 17, floor 30 deg), four 2.5 x 2.3 blind holes in the
    back face at the body's screw pads (x 40/117.5/197.5/275, z 20) for
    M3 x 10 (14 was wrong for a 3 mm facia), iguana inlaid 0.8 top-right
    - src/logo.py: Iguana.svg (potrace, one compound path) -> even-odd
    polygon -> CadQuery solid, scaled to 60 x 30, rotated head-right,
    features under 0.9 mm dropped
    - parts/drawer/drawer-facia-v1.stl + drawer-facia-logo-v1.stl (load as
    one multi-part object, logo in blue), dr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
    [drawer-facia-logo-v1.stl, drawer-facia-v1.stl, drawer-pull-insert-v1.stl]
2026-10-02 Cradle reprint: PSU right v4 + AWG v2 (ROADMAP v2.15, Stage 2 done)
    - Stage 2.7 done 2026-10-02: PSU and AWG seated with the jigs, no rock,
    fronts in line -> Stage 2 ticked. P3 pass and the 2.1-2.6 ticks from
    the 2026-10-01 session (v2.14) restored - they had been overwritten by
    later roadmap writes from an older copy
    - all three predicted clashes real. Measured: PSU feet 155.5 apart, PSU
    150 tall on its feet, face 0 / 6.5 off the left rail / inner rail; left
    feet sit in their cups, right pair on the rims; PSU top touches the AWG
    arms; right AWG plate touches the PSU side
    - src/parts/psu_cradle.py: cradle(reach); REACH_V3 38.75 (left pair, as
    printed, STL byte-identical) and RE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
    [awg-cradle-left-v2.stl, awg-cradle-right-v2.stl, cradles-v2-plate.stl, drawer-facia-logo-v1.3mf, drawer-facia-v1.3mf, psu-cradle-right-v4.stl]
2026-10-03 Rear box v1: two dovetailed halves for the sled (Stage 6)
    - src/parts/rear_box.py: 291 x 135 x 110 (x 50-341, y 195-330, z 346-456),
    floor 3, walls 2.4, full rear and side walls, 20 mm front lip; split at
    x 195.5 and joined like the drawer quarters - three floor puzzle tabs on
    the seam (y 220/250/280) and vertical sliding dovetails at the rear-wall
    and front-lip crossings (left half male; right half drops on, CA the seam)
    - parts/rear-box-{left,right}-v1.stl: floor down, 153.5 x 135 x 110,
    150 / 145 cm3, printcheck 95 % / 94 % resting face, nothing to support
    - src/box_check.py: halves 0 cm3 assembled, joints engaged (pull-apart
    held by the tab flanks), right half lifts clear; bo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
    [cradles-v2-plate.3mf, drawer-facia-logo-v1.3mf, rear-box-left-v1.stl, rear-box-right-v1.stl]
2026-10-03 PSU right FRONT cradle v5: cup midway between v4 and v3
    - bench 2026-10-03: with the v4 pair fitted the right rear foot sits in
    its cup, the right front wants the cup a few mm further from the inner
    rail - the PSU sits very slightly skewed. One part replaces the front:
    REACH_V5RF 34.75 -> cup 37.75 from the inner rail's face (v4 33.75,
    v3 41.75). Left v3 pair and right rear v4 stay
    - parts/psu-cradle-right-front-v5.stl (print once); the plate file keeps
    the v4 pair as printed
    - src/fit.py, src/cradle_check.py (cup centres 61.75 / 217.25 / 213.25),
    ROADMAP correction
    Claude-Session: https://claude.ai/code/session_01NfymEEsb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
    [psu-cradle-right-front-v5.stl, rear-box-left-v1.3mf, rear-box-right-v1.3mf]
2026-10-04 Column drawer v1 + four guide strips (Stage 4, D5, P3 geometry)
    - src/parts/column_drawer.py: body 64 x 285 x 240 at x 274-338 (3 mm
    gaps both sides so one strip STL serves left and right), y 3-288,
    z 91-331, walls 2.4, floor 3, two M3 facia pads; P3 grooves in 10 x 20
    bosses at the floor, guide grooves in chamfered bosses at AWG level
    - lower strips: P3 rib with its bottom at z 94 (= drawer floor top, the
    drawer hangs on the slopes as the bottom drawer does), 8 mm bolt bar at
    z 70-86 under the drawer floor with four counterbored M5 into the
    PSU-level side slots, 2.7 plate; upper strips: 14 x 7 guide rib, M5
    counterbored through its tip into the AWG-level side slots, 0.5 slack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
    [column-drawer-v1.stl, column-strip-lower-v1.stl, column-strip-upper-v1.stl, psu-cradle-right-front-v5.3mf, rear-box-right-v1.3mf]
2026-10-04 Cross bars v2: guide lips 1 mm further apart each (box would not drop in)
    - the v1 lips sat exactly 135 apart = the box length (zero clearance by
    design). v2: front lip y 189-194, rear lip y 331-336 -> 2 mm of play;
    tabs and sockets unchanged
    - src/parts/sled_bars.py: FRONT_CROSS (189, 210), REAR_CROSS (308, 336),
    VERSION map -> cross bars v2; v1 STLs removed
    - src/box_check.py: box 0.5 fore/aft free, 1.5 collides; ladder checks
    unchanged; plan sheet regenerated
    - also: src/skin_sheet.py -> parts/tiles/skin-sheet.png (where every side
    tile and clip finger lands, both sides)
    - ROADMAP correction
    Claude-Session: https://claude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
    [sled-cross-bar-front-v1.stl, sled-cross-bar-front-v2.stl, sled-cross-bar-rear-v1.stl, sled-cross-bar-rear-v2.stl]
2026-10-08 Column: short left lower strip between the PSU cradles
    - the right PSU cradles' saddle lips hang 6 mm down the inner rail's
    right face (y 23-63 and 223-263, z 82-88), where the 260 strip's bolt
    bar goes; the frame check had no cradles in it. Gareth: 144 clear
    - parts/column/column-strip-lower-short-v1.stl: 140 long, two M5, same
    section; the 260 lower strip is now the right side only
    - src/parts/column_drawer.py: lower_strip(length, bolt_ys), SHORT_*;
    src/column_check.py: cradle lips in the frame model (0 cm3), travel
    215 (left) / 243 (right) before the grooves leave the ribs
    - ROADMAP correction; M5 x 10 / T-nuts 14
    Claude-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
    [column-drawer-v1.3mf, column-strip-lower-short-v1.stl, column-strip-upper-and-lower-v1.3mf, drawer-facia-v1.3mf, sled-cross-bar-front-and-rear-v1.3mf, sled-cross-bar-front-and-rear-v2.3mf, sled-front-bar-v3.3mf]
2026-10-09 Column facia v1 + pull insert v1, located by pegs (no screws)
    - src/parts/column_facia.py: 65 x 245 x 3 at frame x 273-338, z 91-336;
    notch 50.3 x 23.15 in the top edge for a 50-wide P6 insert (slot
    40 x 12); two 3.2 x 7 pegs on the back at the drawer body's front-wall
    holes (x 16/48, z 20) locate it - press on and CA, nothing through the
    front
    - parts/column/column-facia-v1.stl (on its long edge, 44 cm3, thin-part
    print settings), column-pull-insert-v1.stl (face down, 7 cm3)
    - proofs in the script: insert in notch 0 cm3, held, flush; facia on the
    body 0 cm3 with pegs home, 0.5 shift collides; clear of uprights/rails
    - ROADMAP: print job, status, printed list (column drawer, stri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
    [column-facia-v1.stl, column-pull-insert-v1.stl, column-strip-lower-short-v1.3mf, drawer-facia-v1.3mf, sled-front-bar-v3.3mf]
2026-10-09 Pull inserts: column + mini-slot inserts on one blue plate (D9)
    src/parts/pull_inserts.py builds every P6-style pull insert from one
    function: width and slot width per front. Column (50 / 40, identical
    to column-pull-insert-v1) and mini slot (22 / 16, for the 26-wide
    mini-slot facia; its notch 22.3 x 23.15 goes in mini_slot.py when
    that facia is modelled). Both exported face down and laid on
    parts/inserts/pull-inserts-plate-v1.stl, printcheck'd, notch fit
    proven (0 overlap seated, 0.5 mm shift collides).
    The sled front bar's 120 x 6 top-edge notch stays a plain finger
    notch: a 12 mm bar cannot hold the 17 mm deep P6 pocket.
    Claude-Se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
    [inserts-and-logo.3mf, pull-insert-column-v1.stl, pull-insert-mini-v1.stl, pull-inserts-plate-v1.stl]
2026-10-09 Pull inserts: column + mini-slot inserts and sled-bar liner on one blue plate (D9)
    parts/inserts/pull-inserts-plate-v2.stl, printcheck'd, notch fit
    The sled front bar's 120 x 6 top-edge notch cannot hold the 17 mm
    deep P6 pocket, so it gets a trial blue liner instead: an L of floor
    + front wall, 1.5 thick, 119.7 wide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
    [inserts-and-logo.3mf, pull-inserts-plate-v2.stl, sled-bar-pull-liner-v1.stl]
2026-10-09 Pull inserts v2: flanged, hooked over the drawer body; one blue plate (D9)
    v1 inserts held in the notch sideways and downward only; a forward
    pull went through glue in shear on three 3 mm edges. v2 adds a 2 mm
    flange behind the face that steps out past the notch (ears, and a lip
    where the body allows), sits flat on the facia's back, then hooks over
    the drawer body's front wall with a bridge and a 20 mm leg down the
    wall's inside - glued to the facia and the body face to face, forward
    pull taken in bearing by the facia.
    src/parts/pull_inserts.py builds all three (bottom 100/80, column
    50/40, mini 22/16) from one function and the sled-bar liner (the bar's
    120 x 6 notch cannot hold the 17-deep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
    [column-drawer-v2.stl, column-drawer-v3.stl, inserts-and-logo.3mf, pull-insert-bottom-v2.stl, pull-insert-column-v1.stl, pull-insert-column-v2.stl, pull-insert-mini-v1.stl, pull-insert-mini-v2.stl]
2026-10-11 Mini-slot drawer v1: body, dovetail runner, facia (D7)
    src/parts/mini_slot.py models the 26-wide slot beside the AWG riding
    on the inner AWG-level rail. The P3 side-boss pair does not fit in
    26 mm, so the runner is one 12-wide ABS+ bar on the rail top (three
    M5 button heads, counterbored) with a dovetail rib: neck 5 x 3, 45
    degree flares to an 8 head, 6 tall. The body's 8.5 bottom block
    carries the matching groove (rib + RUNNER_CLR 0.3 on every face,
    open both ends); its flat bottom rides on the plate top and the
    flares hold it down when cantilevered. A bump on the plate riding in
    a channel in the body's bottom stops the travel at 250; removal is by
    undoing the runner with the drawer out. D7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
    [mini-slot-body-v1.stl, mini-slot-facia-v1.stl, mini-slot-runner-v1.stl]
2026-10-11 Sill panel v1: D10's button strip, window halo, two end blocks
    src/parts/sill_panel.py models the grey strip that fills the reveal
    between the bottom facia (z 86) and the PSU (z 100): 251 x 3 x 12 at
    x 20-271, a 14 x 12 natural-PETG window round the 8 mm button at
    x 78 (separate STL, loaded as one multi-part object), four pegs on
    the back. Two end blocks behind it, each bolted sideways (M5 x 10 into
    the adjacent upright's slot, head in a pocket open to the front); the
    left block carries the button bore, a light cavity behind the window
    and a bore for the 5 mm pixel.
    Departures from D10, forced by the column facia, the PSU cradle reach
    and the 12 mm band: panel ends at x 271, the halo is a w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
    [mini-slot-body-v1.3mf, mini-slot-facia-v1.3mf, mini-slot-runner-v1.3mf, sill-block-left-v1.stl, sill-block-right-v1.stl, sill-panel-v1.stl, sill-panel-window-v1.stl]
2026-10-12 TPU plate v1: every blue TPU part on one plate, with the P8 sweeps
    src/parts/tpu_parts.py models all the TPU in the build and lays it out
    on one 240 x 136 plate (parts/tpu/tpu-plate-v1.stl, 55 cm3): frame
    feet x4 (spigot 4.6), AWG pads left x2 (plain) and right x2 (tail +
    lip beside the body, printed standing), slot covers x6 (240 long,
    1.44 m), sled stop caps x2, plus the spigot sweep 4.2/4.6/5.0/5.4 and
    a cover-flare sweep 7.0/7.4/8.0 so P8 is decided on the same spool.
    Changes from the P8 coupon, found by modelling the pads against the
    printed cradles: the cradle pockets put the whole pad under the AWG
    body, so the coupon's lipped pad would have lifted it - left pads are
    plain (the cradl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
    [awg-pad-left-v1.stl, awg-pad-right-v1.stl, cover-sweep-7.0-v1.stl, cover-sweep-7.4-v1.stl, cover-sweep-8.0-v1.stl, frame-foot-v1.stl, sill-block-left-and-right-v1.3mf, sill-panel-v1.3mf]
2026-10-12 Sill panel v2: shorter, press-fit pegs, captive nut, button at the left end
    From the v1 print: the sub-frame's front upright is flush with the
    front plane, so the panel now ends at x 250.7 (230.7 long) and the
    right block's M5 hole is slotted (y 8.5-14.5). Panel and window share
    one export origin so the window loads into its cut-out. Pegs are a
    press fit (no glue). The button's 6 mm thread takes its 10 AF nut in a
    captive hex pocket on the window's back; a 9 mm body bore runs to the
    block's back face (16.5 mm behind the panel - the PSU cradle arm is
    at y 20). Button at x 43, window 26 wide with a pixel bore each side.
    The left block locates with a tongue in the upright's slot mouth
    instead o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
    [sill-block-left-v1.stl, sill-block-left-v2.stl, sill-block-right-v1.stl, sill-block-right-v2.stl, sill-panel-v1.stl, sill-panel-v2.stl, sill-panel-window-v1.stl, sill-panel-window-v2.stl]
2026-10-12 Sled skids v1: the beam front rides the scope rail's top face
    The sled's rear lies on its 210 foot and never bends; the front
    120 mm hangs past the foot's front end and sags under the scope, and
    the foot cannot be longer without losing the 100 travel. The rails
    had been lowered to live with that, which is why the right band-3
    tiles no longer reach the scope rail's slot.
    src/parts/sled_skid.py: a block CA'd to each beam's outer face and the
    front bar saddle above it, reaching out over the scope rail to ride on
    its top face at y 22-62 under the front stand - the front gets the
    bearing the rear has. 5.6 under the beam line, PTFE tape and shims to
    the real 6.0 gap; 45-degree ramps on both ends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
    [band3-right-sweep.stl, sled-skid-v1.stl, strip-band3-plus4.stl, strip-band3-plus5.stl, strip-band3-plus6.stl]
2026-10-12 runner changed tp avoid nut
    [mini-slot-runner-v1.stl, mini-slot-runner-v2.stl]
2026-10-13 Sled front rests v2: bolted to the scope rails' top slots, lip under the beam
    108 mm hangs past the foot's front end and sags under the scope,
    and the rails had been lowered to live with that - which is why the
    right band-3 tiles no longer reach the scope rail's slot.
    src/parts/sled_front_rest.py: a 3 mm plate on each scope rail's top
    face at the front (y 21-61), one countersunk M5 into a drop-in T-nut
    in the rail's top slot, with a lip standing up beside the
    rail's inner edge to the beam's underside (lip sized to the measured
    rail-to-beam gap: six STLs, gap 0.5-3.0 stamped). The beam's solid outer
    wall rides on the lip through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
    [sled-front-rest-v2-gap0.5.stl, sled-front-rest-v2-gap1.0.stl, sled-front-rest-v2-gap1.5.stl, sled-front-rest-v2-gap2.0.stl, sled-front-rest-v2-gap2.5.stl, sled-front-rest-v2-gap3.0.stl, sled-skid-v1.stl]
2026-10-13 Sill panel v3: 233.4 long, left block bolted, wires exit downward
    Bench: the sub-frame upright's left face is at x 253.7 (233.7 from the
    left upright), 2.7 right of the model - the panel grows to 233.4. v2's
    left block could slide in the upright's slot; v3 bolts it with an M5
    along x through a 2.2 wall, head in a pocket open to the front left of
    the button (ball-end key). Button at x 45. The pixel bores no longer
    exit the back face into the PSU cradle: pixels drop into slots open
    to the block's bottom, the button's wires leave through a channel
    under its bore, all dropping to the PSU rail's inner slot.
    parts/sill/*-v3.stl replace v2; sheet updated.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
    [mini-slot-runner-v1.3mf, mini-slot-runner-v2.3mf, mini-slot-runner-v2.stl, mini-slot-runner-v3.stl, runner-csk-15-v3.stl, runner-csk-15.stl, sill-block-left-and-right-v1.3mf, sill-block-left-and-right-v2.3mf]
2026-10-14 Top panel v1: four standing tiles + caps on one plate (D12)
    The panel is 361 x 350 x 3 over the whole frame top (z 510-513), on the
    uprights' tops and the three top rails - HANDOVER's 321 x 310 "between
    the caps" rested on nothing. Split at x 180.5 / y 175 into four
    185.5 x 180 tiles meeting on 10 mm half-laps (left/front tongue under,
    right/rear over, 0.1 glue line), CA'd on the frame into one sheet. D4's
    H-spline is dropped: the scope top is 3 mm under the panel. The caps
    now sit ON the panel's corners and screw into the uprights' centre
    bores with M5 x 10 (Ø5.5 teardrop hole in the panel, Ø9.5 x 4
    counterbore in the cap) - four screws hold the panel down.
    Printed standing on the front/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
    [top-plate-v1.stl, top-tile-FL-v1.stl, top-tile-FR-v1.stl, top-tile-RL-v1.stl, top-tile-RR-v1.stl, upright-cap-v1.stl]
2026-10-14 Side tiles v2: measured band heights, notches for the cradle saddles
    Gareth's calipers (2026-10-14): the rails are not at the spacer
    heights - left base>PSU 51.2, PSU>AWG 135, AWG>scope 65.5; right 45.4,
    139.5, 65.8 (model 48 / 139.5 / 63.5). A tile must match its band to
    ~0.2, so side_tile.GAPS now gives every band a height per side and the
    left tiles are front/rear parts. The cradle saddles are U-channels
    with 3 mm walls standing 8 above the rail top; v1's windows cleared
    only the 6 mm lips, so v2 cuts notches open to the bottom edge up to
    11 above the rail top (PSU y 31-71 / 233.5-273.5, AWG left 20-60 /
    223-263, 4 mm air each end), keeps a 1.5 hex web round them, and
    re-schedules the lef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
    [tile-band1-LF-v2.stl, tile-band1-LR-v2.stl, tile-band1-R-v2.stl, tile-band1-v1.stl, tile-band2-LF-v1.stl, tile-band2-LF-v2.stl, tile-band2-LR-v1.stl, tile-band2-LR-v2.stl]
2026-10-14 Sill left block v4: round head seat, key hole out of the right end
    From the v3 print: the head pocket was a box with the bolt line off
    its centre, so the M5 head could not sit flat and the bolt angled.
    v4 seats the head in a Ø10 counterbore on the bolt axis (open to the
    front so the bolt drops in) and adds a Ø3.6 key hole along the axis
    through the block and out of its right end - the key goes in from
    the right, under the PSU, before the button and panel go on. Both
    teardrops, apex print-up. Proven: head seated 0 mm3 and located, key
    through to the head 0, clear of the frame. v3 left block removed;
    panel, window and right block unchanged.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
    [sill-block-left-v4.stl]
2026-10-14 Rear-box corner braces v1; proposal sheet for a scope-back tray (D13)
    The printed rear box's right wall cracked on a layer line where the
    side wall meets the 20 mm front lip. box-brace-v1: an equal-leg
    15 x 15 x 4 L-angle, 100 tall, CA'd into each front corner - one leg
    on the wall, one on the lip and standing free above it as a flange
    along the wall's front edge. Printed lying on the wall leg so the
    layers run up the wall in use. Proven 0 cm3 in the corner, flat on
    wall, lip and floor. Print two.
    scope-tray-plan.png: proposed tray 230 x 56 x 130 (+ lid) behind the
    scope on two glued rails (tray bar against the cup bosses, ledge on
    the cross bar's lip), exiting right through the door with t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
    [box-brace-v1.stl]
2026-10-14 Sled splice bars v1: bridge the P7 joint along each beam's outer strip
    Front rests fitted, the scope's front still sags with the sled out:
    the joint (y 165) sits just behind the rest's lip at full travel and a
    tab joint is a hinge in bending. sled-splice-v1: a 111.5 x 25.5 x 7.5
    bar CA'd on the beam top, x 20.5-46 (mirror right), y 88.5-200 - from
    the front-bar saddle over the joint and the span ahead of the foot;
    7.5 tall under the scope body at 355. Left channel peg (33, 150)
    through a Ø4.3 hole; one part both sides. ~5x the bare beam's
    stiffness over its length. Proven clear of beams, front bar, cross bar
    and scope; flat on the beam, butts the saddle. Costs: the rear box is
    lifted 7.5 mm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
    [sled-splice-v1.stl]
2026-10-16 Sled splice bars v2 (100 long): bridge the P7 joint along each beam
    tab joint is a hinge in bending. sled-splice-v2: a 100 x 25.5 x 7.5
    bar CA'd on the beam top, x 20.5-46 (mirror right), y 88.5-188.5 - from
    lifted 7.5 mm as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
    [sill-block-right-v3.stl, sill-block-right-v4.stl, sled-splice-v1.stl, sled-splice-v2.stl]
2026-10-16 Sill right block v4: 2.5 wall, key slot from the left end, peg hole 3.4
    From the v3 print: no way to get a key to the bolt, and the 7.7 wall
    left an M5 x 10 only 2.3 mm into its T-nut. v4 thins the wall to 2.5
    (7.5 mm of thread), keeps the box pocket open to the front (clears a
    Ø7.5 head at either slot position), adds a Ø3.8 key slot along the
    bolt axis from the block's left end into the pocket, and opens the
    peg hole to 3.4. Proven: head seated at y 10 and 13, key through to
    the head, clear of the frame. v3 right block removed.
    Claude-Session: https://claude.ai/code/session_01Q35NQnAcUitKf1ez5tTq51
2026-10-16 ROADMAP v2.19: Progress block rewritten as the to-do list; P8 passed, Stage 1 and Stage 3 ticked
    Bench round-up 2026-10-16:
    - P8 PASSED: the TPU plate printed; the feet at 4.6 hold in the uprights (glued in),
    the 7.4 covers stay in the slots. fit.py SPIGOT_D 5.0 -> 4.6. Coupon plate D and
    the §3 P8 row ticked -> Stage 1 ticked (P1–P9 all in fit.py).
    - Stage 3 confirmed done (PSU v3/v4/v5 + AWG v2 fitted, level, no rock).
    - Stage 5: sag confirmed gone with the splices cut to 100.
    - Stage 4: column facia printed, bottom-drawer dovetails CA'd, every drawer comes
    out cleanly. "Lift-to-remove" retired from the Stage 4 done-when: it was
    HANDOVER's lift-off runners; P3's rib-in-groove pa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
    [fit.py]
2026-10-16 ROADMAP v2.21: D15 — no drawer stops
    Gareth, 2026-10-16: leave the pull stops out. The bottom and column drawers come
    clean off their ribs at full travel (bottom ~300, column 215 left / 243 right) and
    that is the removal path; with the P3 ribs a drawer cannot lift clear, so a stop
    would turn removal into "undo its M5, then pull". The mini slot keeps its 250 bump.
    Stage 4's outstanding list and the §5 parts list updated; Stage 4 now has no
    unmodelled parts.
    Claude-Session: https://claude.ai/code/session_01HGhv4nQNGWCz3Z7whFNXp4
2026-10-16 Lighting wiring v1 (D10 rev 3): D1 mini on a perfboard in a holder on the rear base rail; sheets in parts/wiring/
    - src/parts/board_holder.py -> parts/wiring/board-holder-v1.stl: 60 x 44 x 15 plate on the rear base
    cross rail's rear face (x 90-150), one M5 x 10 + T-nut into the rail's rear slot, two Ø6.5 wire
    holes on the slot either side of the nut, a 50 x 40 perfboard in two 45-deg-roofed side slots on a
    3 mm ledge (slides in from the top after the bolt). Proven clear of the rail, the Addtam, its
    bracket and cable drop, and the feet; the board is held by the roofs and sits on the ledge.
    - src/wiring_sheet.py -> parts/wiring/wiring-1-schematic.png (connections + WLED settings),
    w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
    [board-holder-v1.stl]
2026-10-16 Wiring v1.1: two sill pixels (bus 1 = 30 LEDs), one 1000 uF at the USB input
    Gareth, 2026-10-16: both pixel slots in the sill block get a pixel (chained, LEDs 0-1)
    so both halves of the window light past the button's nut; left strip is LEDs 2-29,
    right 30-57, WLED segments shifted to match. One 1000 uF across 5 V / GND at the
    board's USB-in pads replaces the two — both strip feeds leave the same bus on the
    board, so a second cap there adds nothing. Sheets 1 and 3 and the ROADMAP status
    line re-issued.
    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
    [wiring_sheet.py]
2026-10-18 Door set v1 (Stage 7, band 4 right): door, fixed rear tile with a bolted leg, two magnet holders
    - src/parts/door_set.py -> parts/door/door-v1.stl (230 x 152 x 3 hex tile, no clips; magnet bosses
    12 x 12 x 3 with Ø10.4 x 2.2 pockets printed on its back at (y 34, z 479) and (236, 479); solid
    glue pads for the D11 door leaves; a 45 x 12 finger slot at (135, 482)), rear-tile-v1.stl (80 x 166
    x 3, two P4 fingers up into the top rail's outer slot, a 19 x 3 x 40 leg on its back bolted to the
    rear-right upright's front face with one M5 x 10 + T-nut at z 361 — the answer to band 4's open
    bottom edge), magnet-bracket-front-v1.stl (L on the front-right upright's rear face, M5 x 10,
    tong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
    [door-v1.stl, magnet-bracket-front-v1.stl, magnet-tab-rear-v1.stl, rear-tile-v1.stl]
2026-10-18 Band 4 left v1: the last two side tiles, with bolted legs; door set, holder and hinge pair printed
    - src/parts/band4_left.py -> parts/tiles/tile-band4-LF-v1.stl, tile-band4-LR-v1.stl: 155 x 165 x 3
    hex tiles at z 335-500, three P4 fingers up into the top rail's outer slot, and the door set's leg
    (19 x 3 x 40, M5 x 10 + T-nut at z 361) on the front-left upright's rear face / the rear-left
    upright's front face. Proven 0 cm3 against the rails as measured, uprights, band-3 tiles, the left
    sled beam, the cable channel envelope, the scope-rail cast brackets, the LED strip and the box;
    fingers hold; legs flat on their faces; printcheck passes.
    - ROADMAP v2.25: door set, board holder and t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
    [tile-band4-LF-v1.stl, tile-band4-LR-v1.stl]
2026-10-19 Cable channel v1 (Stage 5/6): the last sled part; band 4 left printed
    - src/parts/cable_channel.py -> parts/cable-channel-v1.stl: U-trough on the left beam's top, x 20.5-47,
    y 201-334 (behind the splice), floor 3 on z 346, walls 3 to z 366, inside 20.5 x 17; front top
    corners chamfered 10 at 45 deg; keyed by the beam's peg at (33, 290) through a Ø4.3 floor hole and
    CA'd, as the splice. HANDOVER's wedge tabs and the inner wall's rear ramp dropped (reasons in the
    header). Proven 0 cm3 against both beam halves, the splice, the front bar, both cross bars, the box,
    the scope body, the LED strip, the rear-left upright, the band-4 LR leg and the scope rail; flat on
    the beam top; locate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
    [cable-channel-v1.stl]
2026-10-19 Door set v2: rear tile, front bracket and tab re-exported from the real frame (v1 printed as the wrong hand)
    Gareth, 2026-10-19: the printed rear tile's leg is at the wrong end. door_set.py v1 modelled the set
    in skin_check's right-side rail frame — a mirror of the real frame (x = 361 - x) — and exported from
    it, so the three chiral parts printed as mirror images: rear tile (leg at the front end), front
    bracket (leg 10.5 from the door, not 3.5), tab (pocket 3 mm low). The door's bosses, pads and finger
    slot are symmetric end to end, so door-v1 as printed works; door-v2 is the right-hand file for the
    record (only the hex grid's end margins differ). Every export now goes through to_frame()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
    [door-v2.stl, magnet-bracket-front-v1.stl, magnet-bracket-front-v2.stl, magnet-tab-rear-v1.stl, magnet-tab-rear-v2.stl, rear-tile-v1.stl, rear-tile-v2.stl]
2026-10-20 Door v3 + hinge leaves v2: the door's edge comes down from 347 to 338 (7 above the rail)
    Gareth, 2026-10-20: the 16 mm band under the door was the handover's box-floor edge and did nothing
    (the box only moves with the door open). door_hinge.py v2: TILE_Z0 347 -> 338 — door leaf shelf at
    335-338 (1 clear of the frame plate's top and of the right sled front rest's plate under the front
    hinge), frame leaf riser out to x 364.3 so the lower door clears it. door_set.py: door v3 161 tall;
    the sled rest and the T-foot envelope added to the checks; door, leaves, rest, foot, rails, uprights,
    band-3 tiles and the box all at zero, closed and through 180 degrees. Sheets door-plan.png and
    hinge-how.png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
    [door-v2.stl, door-v3.stl, hinge-door-v1.stl, hinge-door-v2.stl, hinge-frame-v1.stl, hinge-frame-v2.stl, hinge-pins-v1.stl, rear-tile-v2.3mf]
2026-10-20 Door hinge pins: parts/door/hinge-pins-v1.stl (two Ø2.9 x 24 on snap-off discs, black PETG)
    Gareth, 2026-10-20: which material for the pin. src/parts/hinge_pins.py — the P5 pin geometry
    (2.9 passes the 3.2 bores, 3.0 binds), standing on a Ø8 x 0.6 disc, 0.4 chamfer on the tip.
    Glued at both ends into the door leaf's segments with CA; the frame leaf turns on it.
    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
2026-10-23 Strip brackets: upper v2 + lower v5 with the M5 bolt hole (every earlier export had none)
    The bolt hole and counterbore in strip_bracket.py were built on an XZ
    workplane offset the wrong way (XZ's normal is -y), so they sat at
    y 6-13, outside the 5 mm plate, and cut nothing. Rebuilt along +y
    explicitly; bracket() now asserts the hole exists. Geometry otherwise
    unchanged: Ø5.5 through, Ø10 x 2.5 counterbore on the strip side, at
    the peg's height. upper-v1 and lower-v4 withdrawn.
    Claude-Session: https://claude.ai/code/session_01TuDyXwZyKLTSVDyKk418oz
    [strip-bracket-lower-v4.stl, strip-bracket-lower-v5.stl, strip-bracket-upper-v1.stl, strip-bracket-upper-v2.stl]
2026-10-23 ROADMAP v2.29: tower assembled — Stages 4-7 ticked, D12 ticked, D7 thermal check passed
    All three instruments on for over an hour in the assembled stack: the
    AWG's fan no louder than usual, the mini slot's right-hand wall slightly
    warm, not hot, so the slot stays 285 deep. Sled, box access sequence,
    door and top panel confirmed on the bench. Stage 8 left open for the
    lighting wiring, the probe hanger and the rear-right cable clips.
    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
2026-10-25 Wiring sheet 4: every lighting connection on one page (D10 rev 4)
    parts/wiring/wiring-4-connections.png (src/wiring_connections.py).
    Supersedes wiring-1-schematic where they differ: SN74AHCT125N level
    shifter between the D1 mini and both data lines, 15-LED strips (the
    strip in hand is 30/m), every plug a 2.54 mm locking pin header
    soldered on the board with a crimped housing on the cable (SN-28B):
    sill bundle on a 4-pin (red, green, blue, black) + 2-pin (yellow),
    strips on 3-pin L and R, WLED outputs 17 + 15.
    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
2026-10-25 Lighting rev 5: XIAO ESP32-S3 + SiglentGlow firmware brief; wiring sheets
    The lighting controller moves from a D1 mini running WLED to a XIAO
    ESP32-S3 running SiglentGlow, Gareth's own firmware on IguanaPlatform
    (the MorayGlow architecture).
    - SiglentGlow-BRIEF.md: the brief for Claude Code (hardware, behaviour,
    REST/WS, HA MQTT with brightness, UI, tests, acceptance)
    - parts/wiring/wiring-4-connections.png (src/wiring_connections.py):
    every connection — SN74AHCT125N on both data lines, XIAO D0 bus 1
    (2 sill + 15 left), D1 bus 2 (15 right), D4 button, 5 V into the
    XIAO through an SR3200 Schottky, 2.54 mm locking headers on the
    board with crimped housings (4-pin + 2-pin sill, 3-p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
2026-10-25 Perfboard layout: XIAO, SN74AHCT125N, SR3200, headers, wire list
    parts/wiring/perfboard-layout.png (src/perfboard_layout.py): the
    50 x 40 board as 19 x 15 holes, component side, USB-C at the top edge
    as it sits in the holder. XIAO B8-B14 / H8-H14, chip K7-K13 / N7-N13,
    SR3200 I15 (stripe) to N15, 1000 uF Q13 / Q11, R1 D5-H5, R2 L5-P5,
    locking pin headers along row 1 (4-pin S, 2-pin, 3-pin L, 3-pin R),
    pigtail pads P15 / R15; 27 back-side wires listed by hole, plus a
    meter check before the XIAO goes in. Replaces wiring-3's D1 mini board.
    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
    [perfboard_layout.py]
2026-10-26 Lighting board enclosure v1 (Stage 8): holder + hex-vented lid replace board-holder-v1
    The perfboard is 50 x 70 with four plugs standing 20 off it (D10 rev 5), and
    board-holder-v1 (44 tall) left 26 of it bare. src/parts/board_enclosure.py keeps v1's plate, M5, wall
    width, board slots and the 3.5 behind the board, grows the two wire holes to 16 x 8
    passages (a crimped housing passes, so leads are made up on the bench), and adds: walls 108 tall
    (board + 10) and 40.5 deep, a floor, a ledge at z 28 with a 25 mm wire bay under it for
    the three downward plugs, walls thinned to 2 mm behind the board for the XIAO, a second
    pair of slots for a 2.4 lid plate hex-perforated like the side tiles (its inn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
    [board-enclosure-v1.stl, board-lid-v1.stl]
2026-10-26 Wiring sheets rev 5: 5-pin sill plug, 2-pin PWR header, XIAO pins and SiglentGlow set-up
    perfboard_layout.py: the sill plug becomes one 5-pin header (5V, data, back, GND, sw)
    in B1-F1 instead of a 4-pin plus a 2-pin, the 3-pin L and R move to I1-K1 and N1-P1,
    the USB pigtail gets a crimped 2-pin PWR header at P15-Q15 instead of solder pads,
    the XIAO sits on two 7-way female headers, the Wi-Fi antenna is shown stuck at rows
    2-4 with its lead to the u.FL socket; wire list and the parts-first note updated.
    wiring_connections.py: D1 mini replaced by the XIAO ESP32-S3 (D0 / D1 / D4), 5 V into
    the XIAO through the SR3200 (stripe towards the XIAO), the WLED block replaced by the
    SiglentGlow firmwa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
    [perfboard_layout.py, wiring_connections.py]
2026-10-27 Sill left block v7: LED seat 6 deep, leg slots, dovetail wire groove along the bottom
    Gareth, 2026-10-27: push the LED further through, and clips on the left to tuck the wires under.
    Seat 6 deep -> dome 4.1 into the cavity. Per LED a 6.6-wide leg slot opens the rear of the
    counterbore to the bottom so the legs bend straight down. A wire groove along the bottom face
    (x 27-61, 4.5 x 3 inside, 2.5 mouth between 1 mm lips) takes the bundle from both LEDs and the
    button's channel to the left end, where it drops down the upright's inner slot — a groove rather
    than hooks because a hook on the bottom face is an overhang in the front-face-down print and the
    groove roof is a 2.2 mm bridge. Proven: b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
    [board-holder-v1.stl, sill-block-left-v7.stl]
2026-10-27 wiring changes
    [sill-block-left-v5.stl, sill-block-left-v6.stl, sill-block-left-v8.stl, sill-block-left-v9.stl]
2026-10-27 Sill left block v10 + window v4: wire slit so the pre-wired button goes in from the front; wiring sheets rev 5.1 as built
    Sill left block v10 (v8 plus the slit; v9 withdrawn): a 3.2 wire slit from
    the button bore down to the bottom face, running from the front face through
    to the back, and the same notch in the clear window's bottom edge under its
    hole (window v4). The button, wires already soldered on, goes in from the
    front with the wires hanging through the notch; they trail rearward along the
    open-bottom slit and drop out of the wire channel once the thread meets the
    captive nut. The nut stays captive (the slit takes 3.2 of its 10.6 floor).
    Pixels as v8: from the rear, pre-wired, clip ra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
    [sill-block-left-v10.stl, sill-block-left-v4.stl, sill-block-left-v5.stl, sill-block-left-v6.stl, sill-block-left-v7.stl, sill-block-left-v8.stl, sill-block-left-v9.stl, sill-panel-v3.3mf]
2026-10-27 Sill left block v10: wire slit so the pre-wired button goes in with the panel off; wiring sheets rev 5.1 as built
    the button bore down to the bottom face, running from the block's front face
    through to the back, open underneath all the way. The panel is not glued:
    with it off, the wires go through the window hole, the panel is drawn back
    onto the button, and the panel then goes onto the block with the wires
    dropping into the slit through its front face; they trail rearward and leave
    by the wire channel once the thread meets the captive nut. The nut stays
    captive (the slit takes 3.2 of its 10.6 floor). Panel and window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
    [sill-panel-window-v4.stl]
2026-11-03 wiring-4: separate risers for chip pins 3 and 6 (they were drawn on one line)
    Both green outputs climbed the same x on the sheet, so pins 3 and 6
    looked joined. They are not: pin 3 → R1 → sill plug data, pin 6 → R2
    → R plug data. Drawing only; the perfboard wire list was right.
    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
2026-11-03 ROADMAP v2.35: construction complete — Stage 8 ticked, lighting working
    The tower is built and everything on it works (2026-11-03). Stage 8's
    lighting entry rewritten as done for D10 rev 5 as built: SiglentGlow on
    a XIAO ESP32-S3 Plus, the 50 x 70 perfboard in the enclosure, two 15-LED
    strips, WS2812D-F5 sill pixels (legs DOUT, VDD, GND, DIN), USB pigtail
    from the Addtam. Probe hanger and rear-right cable clips not built, by
    choice. Stage 9 (close-out) is what remains.
    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
2026-11-03 Stage 9 briefs: HANDOVER v19 (and the portfolio entry, in the site repo)
    HANDOVER-v19-BRIEF.md: rewrite HANDOVER.md as the as-built record —
    sections kept, every value from ROADMAP v2.35 / fit.py, a parts index,
    coupon results, decisions D1-D15, sheet index. Also committed in this
    session: ROADMAP v2.35 (construction complete). The matching brief for
    the garethcooke.com entry lives in the portfolio repo.
    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
2026-11-03 HANDOVER v19: the as-built record; ROADMAP v2.36, Stage 9 bullet 1 ticked
    HANDOVER.md rewritten from v18 (the frozen design of 2026-09-15) to
    the tower as built on 2026-11-03: the instruments as measured, the
    frame as cut and as corrected on the bench, the final levels, the sled,
    panels and door, drawers and pulls, cables, power and the D10 rev 5
    lighting as wired, materials as used, the known compromises, a parts
    index with the withdrawn files and the jigs, coupon results P1-P9,
    decisions D1-D15 and a sheet index. Every value comes from ROADMAP
    v2.35, fit.py or a part script; where the build differs from v18 the
    v18 value is shown in brackets.
    ROADMAP v2.36: Stage 9 bullet 1 ticked, compan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
2026-11-05 README and licences: front page for the repository
    What the tower is, the headline numbers, how it was designed (coupons,
    fit.py, boolean proofs, print rules, measured corrections), the
    repository map, how to build one, how to run the scripts. Four photos
    in docs/photos (front, lit, sled out, box out). Code under src/ is MIT
    (LICENSE); the design, documents and media are CC BY 4.0
    (LICENSE-DESIGN.md).
    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
2026-11-05 Stage 9: viewer and layout regenerated as built; STL archive tidied
    bench-stack-3d.html now shows the tower as HANDOVER v19 records it:
    the sub-frame at x 253.7 and flush with the front, the sill panel
    ending at 253.4 with the button at x 45, the door v3 on the D11 axis
    (x 369 / z 341) with its edge at 338, the top panel over the whole
    frame top with the caps on it (D12), no drawer lids (D14), no probe
    hanger, the strip at z 75-425, the board enclosure on the rear base
    rail, the splices and front rests, sled travel 92, tiles on the
    rails' outer faces. src/viewer_boxes.json was stale at v18 and is now
    the same list as the HTML's BOXES line.
    bench-stack-layout-v16 (svg + pdf) is the as-built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
    [awg-cradle-left-v1.stl, awg-cradle-right-v1.stl, column-drawer-v1.stl, column-pull-insert-v1.stl, cover-sweep-7.0-v1.stl, cover-sweep-7.4-v1.stl, cover-sweep-8.0-v1.stl, door-v1.stl]
2026-11-06 Stage 9: the complete Bambu Studio project (publish/)
    src/publish_3mf.py builds publish/SiglentTower-complete.3mf from the
    fitted STLs in parts/ (and the jigs): 36 plates in filament order,
    black ABS+ sliding parts first, then ABS, black PETG, dark grey, dark
    blue, the hidden PETG odds and ends, TPU last, then two jig plates;
    each plate named "NN material colour - parts", each object named
    after its STL, the diagonal parts turned 45 degrees, per-object brims,
    ironing and supports as the print jobs had them, and the SiglentTower
    fit 0.20 profile lifted from a saved project. Every mesh is placed
    by its own transform and checked back from the file: no overlaps,
    4 mm minimum clearance, nothing o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
    [SiglentTower-complete.3mf, sill-panel-window-v4.stl]
2026-11-07 Complete .3mf: one material per plate, valid plate names, exclusion corner
    From the first open in Bambu Studio (2026-11-06): plate names no
    longer carry "/" or ":" (Studio rejects them); the packer keeps every
    part out of the X1C's 18 x 28 exclusion corner and turns the diagonal
    parts away from it; a 4 mm gap is enforced on every side.
    One material per plate, so no purge tower: the upright caps move to
    the dark blue plate, the column and mini-slot facias get their own
    dark grey plate. Only the two objects that are two-colour by design
    share a plate between filaments - the bottom facia with its logo inlay
    and the sill panel with its clear window. 37 plates.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
    [SiglentTower-complete.3mf]
2026-11-07 Complete .3mf: back to 36 plates (Bambu Studio's limit)
    Bambu Studio 2.9.1 allows at most 36 plates; the 37-plate file from
    the material split crashed it on load (bisected with the previous
    36-plate file and a one-plate file, both of which open). The mini-slot
    runner now shares the lower guide-strips plate (all ABS+, the runner
    keeps its ironing), the plates are renumbered, and publish_3mf.py
    refuses more than 36. Metadata/cut_information.xml and
    filament_sequence.json are written as Studio writes them.
    Claude-Session: https://claude.ai/code/session_01UySMRYgyCr5nTqStyu4zLu
    [SiglentTower-complete.3mf]
2026-11-08 Stage 9: MakerWorld pack; the .3mf as saved from Bambu Studio
    publish/makerworld/: MAKERWORLD.md (title, summary and description
    for the listing - it leads with "ideas, not a kit": the parts fit the
    frame as cut and assembled, so a builder should expect to re-measure
    and re-export; print notes with the thin-part warping fix, materials,
    hardware, cut list, build order, how it was designed and Claude's
    part in it, links), UPLOAD.md (which file goes in which box, the
    gallery order and captions, slice all plates first), six photos as
    JPG, six diagrams, make-stl-zip.cmd for an optional STL zip.
    publish/SiglentTower-complete.3mf is now the file saved from Bambu
    Studio 2.9.1 with Gareth's plate ar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
    [SiglentTower-complete.3mf]
2026-11-08 MakerWorld pack: the access-sequence clip
    publish/makerworld/video/access-sequence.mp4 - 16 s, silent, rotation
    baked in, web-ready - shows the button, the scope coming forward on
    its sled, the door dropping and the storage box coming out sideways;
    a poster frame beside it. docs/photos/access-sequence.gif puts the
    same sequence on the README. UPLOAD.md says where the clip goes and
    how to rebuild it from the phone's full-size original.
    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
2026-11-08 Stage 9 brief: the build guide (docs/BUILD-GUIDE.md)
    The brief for a fresh Claude Code session, as HANDOVER v19 was done:
    sources in reading order, the fourteen chapters, the rules for the
    writing (numbered one-action steps with a check each, plain words,
    every number from HANDOVER), what to update alongside it, done-when.
    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
2026-11-08 Stage 9: the build guide (docs/BUILD-GUIDE.md)
    One document from nothing to the finished tower, written against
    HANDOVER v19: before you start, shopping list, tools, cutting,
    printing (the complete .3mf and the settings it cannot carry), then
    the build in order — frame flat-side method, measuring your frame,
    cradles with the seating jigs, drawers, sled and box, skin, trim,
    lighting — every step a numbered action with its check, the done-when
    checklist and a symptom → fix table. Three new sheets under
    docs/build-guide/ (frame flat on the bench, drawer-quarter order, sled
    order) from src/build_guide_sheets.py. README map and MAKERWORLD links
    point at the guide; ROADMAP v2.38 ticks the St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
    [build_guide_sheets.py]
2026-11-08 Stage 9: MakerWorld published, write-up drafted
    MakerWorld listing live at https://makerworld.com/en/models/3573243-siglenttower
    (linked from the README, the build guide and ROADMAP; the saved .3mf is the
    one uploaded, with the slots assigned). docs/WRITE-UP.md is the long-form
    build story for garethcooke.com, draft for Gareth's edit, with a new
    three-frame access-sequence sheet (docs/access-sequence.svg from
    src/access_strip.py). README map and ROADMAP updated.
    Claude-Session: https://claude.ai/code/session_01UySMRcCck66Ck63KrmZDFH
    [SiglentTower-complete.3mf]
2026-11-09 Stage 9 complete: the write-up is live
    ROADMAP v2.39 ticks the write-up and Stage 9 — garethcooke.com/siglenttower/build
    renders docs/WRITE-UP.md; the write-up's header now says so instead of "draft".
    Nothing is left open on the roadmap.
    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
